metrox-eth/moss/README.md

# MOSS

Cleaner streets, one maker at a time.

> **MOSS kits are coming soon on [TNKR](https://tnkr.ai/).**
> Skip printing and sourcing the parts yourself. **[Join the waitlist →](https://ak4khuvxkya.typeform.com/to/qaKmXNME)** to be notified when kits are available.

**[Build guide](https://www.showrobotics.ai/moss/build/) · [Print parts](https://www.showrobotics.ai/moss/build/#print) · [Bill of materials](BOM.md) · [Download CAD, STL & 3MF](https://github.com/metrox-eth/moss/releases/download/v0.6-r92/MOSS_R92_Mechanical_20261109.zip) · [Software setup](Software.md)**

MOSS is a small litter-picking rover you print and build yourself: a tracked base, a bin on top, an arm derived from the SO-101 with a parallel gripper. It is built in public, with hardware files available for noncommercial builds and improvements.

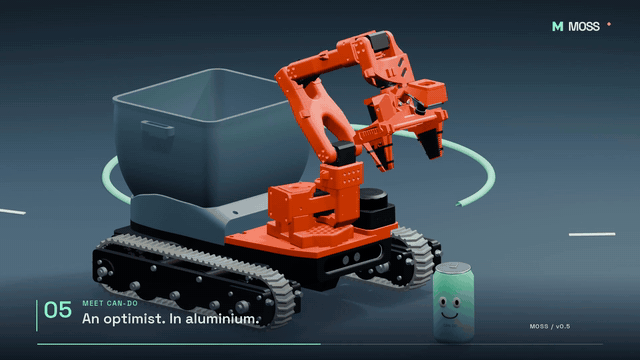
[picture p1: media/images/moss_v05_pickup.gif]
MOSS picking up a can: approach, grasp, lift, drop in the bin


**Where it stands.** The physical rover drives and demonstrates pick-and-drop motions. Autonomous litter picking and the full field test are not yet demonstrated. The V0.6 / R92 CAD, STL files, BOM and assembly guide are now available.

## Build options

**Base assembly: about $460 in parts.** Includes the chassis and tracks, arm and gripper, motors, servos, control electronics, power system, wrist camera, 2D lidar, wiring and filament. **Only the computer and navigation camera are additional.**

**Choose ONE of the three options below, depending on your budget.** They are alternative computer + navigation-camera configurations for the same rover base. You do not need to buy all three.

| Option | Computer + navigation camera | Additional cost (USD) | Estimated rover total, including the $460 base (USD) |
|---|---|---:|---:|
| **Option 1: higher budget** | Jetson Orin Nano Super + RealSense D455 | about $930 | **about $1,390** |
| **Option 2: mid-range budget** | Raspberry Pi 5 + Hailo AI HAT + Orbbec Gemini 2 | about $740 | **about $1,200** |
| **Option 3: lowest budget, experimental** | Orange Pi Zero 3W (6 GB, $60) + MightyCam ($80) | about $140 | **about $600** |

**Option 1 offers the most computing headroom for the autonomy software being developed.** It does not guarantee autonomous operation: autonomous litter collection has not yet been demonstrated on any of these configurations.

The goal is to bring as much of the stack as possible to smaller, lower-cost hardware. This work involves porting, optimizing and testing features progressively, and **it will take time**. Feature support will depend on what can be ported and validated on each hardware option.

**Option 3 is experimental for now.** Early Orange Pi + MightyCam bench tests are documented in the [experiment folder](experiments/orange-pi-mightycam/); the combination is not yet validated as a complete rover configuration. The [BOM](BOM.md) covers the established configurations.

## What it is made of

- Tracked base, two geared DC motors with encoders, printed TPU tracks, an ESP32-S3 driving the motors.
- A bin you empty by hand at the end of a run.
- An SO-101 arm (open source) with a NormaCore parallel-jaw gripper, widened to a 90 mm grip.
- Two cameras: a depth camera at the nose, a colour camera in the hand.
- A 2D lidar for navigation.
- Software: dimOS for teleop, recording, navigation and manipulation.

I pick up litter by hand on my walks. MOSS is the robot I want next to me doing the same. One less can on the ground.

## News

- 1 November 2026: **[MOSS CORE V0.7 updated](hardware/electronics/moss-core-v0.7/)** — black 82 × 79 mm board, vertical cable headers, larger underside connector labels, a 74 × 71 mm chassis mounting pattern and a new routing layout. Orange Pi assembly clearance and the matched KiCad/BOM/Gerber package are documented. The integrated power supply, current sensing and consolidated motor harness remain. First prototype, not built or tested yet.

- 30 October 2026: **[MOSS CORE V0.7 harness study](hardware/electronics/moss-core-v0.7/harness/)** — a short film, offline 3D viewer, cable routing and a hull prototype with integrated cable-tie mounts. An unbuilt packaging proposal, published for review.

- 28 October 2026: **[Build a custom 3S4P battery for MOSS](hardware/power/custom-3s4p-battery/)** — twelve EVE 21700 cells, illustrated assembly, wiring diagram and parts list. 20 Ah from the cell ratings, 910 g assembled; usable energy and collection runtime still to be measured.
- 27 October 2026: **[Orange Pi + MightyCam experiment](experiments/orange-pi-mightycam/)** — dimOS, YOLO on the NPU and a first memory/load test with simulated rover I/O. Code, cockpit image and the limits of this early bench demo.
- 27 October 2026: **[SO-101 dual-servo shoulder R2: complete upgrade guide](hardware/mechanical/dual-shoulder-r2/)** — editable CAD, two printable parts, screws, assembly, paired-servo setup and testing in one place.
- 24 October 2026: **BOM and print plates updated.** Hoco HB1 four-port hub, GameSir Nova 2 Lite controller, all 38 spacers on one plate, and one tensioner-slider reference (print four). [Updated package](https://github.com/metrox-eth/moss/releases/download/v0.6-r92/MOSS_R92_Mechanical_20261024.zip) · [Print plates](https://www.showrobotics.ai/moss/build/print-plates.html).
- 18 October 2026: **Ready-to-print plates are available.** [H2S: one-piece hull and cover](https://github.com/metrox-eth/moss/releases/download/v0.6-r92/MOSS_V06_R92_H2S_Print_Plates.3mf) or [P1 / P2: split hull and cover](https://github.com/metrox-eth/moss/releases/download/v0.6-r92/MOSS_V06_R92_256mm_Split_Print_Plates.3mf). The [updated package](https://github.com/metrox-eth/moss/releases/download/v0.6-r92/MOSS_R92_Mechanical_20261018.zip) includes both Jetson retaining tabs, grouped STLs with quantities, and both 3MF projects. [Choose your plates](https://www.showrobotics.ai/moss/build/print-plates.html).

- 16 October 2026: **V0.6 / R92 is available.** [Build guide](https://www.showrobotics.ai/moss/build/), [CAD & STL package](https://github.com/metrox-eth/moss/releases/tag/v0.6-r92) and [BOM](BOM.md). One-piece and two-piece hull/cover options, modular computer and camera carriers, and short assembly videos.

- 15 October 2026: [MOSS Core V1D routed PCB draft](hardware/electronics/moss-core-v1d/): integrated audio and switched motor/servo power, published for review. Untested and not approved for fabrication. [V1C critical erratum](hardware/electronics/moss-core-v1d/V1C_CRITICAL_ERRATA.txt): do not fabricate V1C.
- 14 October 2026: [CAD development with Codex](docs/cad-with-codex.md): more battery room, integrated audio, a slimmer hull, a P1S split-hull option and deeper track guides. Images and geometry checks; physical validation is next.
- 3 October 2026: V0.6 makes the hardware modular, Pi or Jetson, RealSense or Gemini. Waitlist open with Tnkr.
- 1 October 2026: V0.5, the release candidate for the open source CAD.
- 26 September 2026: arm and gripper mounted on the prototype.
- 22 September 2026: first drive.

## Friends

OpenAI (Codex Physical Builds), [PCBWay](https://www.pcbway.com/) (custom PCB prototyping), [Dimensional](https://x.com/dimensionalos) (dimOS), [NormaCore](https://x.com/norma_core_dev) (gripper), [Tnkr](https://x.com/tnkrdotai) (kits and guide), [Dirac Robotics](https://x.com/diracrobotics) (calibrated simulation), [microduck-lab](https://github.com/jonathanhawkins/microduck-lab) (reinforcement learning). We help each other.

## Supporters

People who put a spool of filament in the rover every month: [Richard Burton](https://github.com/ricburton). It goes into parts the same week. You can join them on [GitHub Sponsors](https://github.com/sponsors/metrox-eth).

## Simulation and autonomy, work in progress

The current **[MOSS V0.6 / R92 MuJoCo model](simulation/mujoco/)** lives in this repository, with its XML, meshes, viewer and tests. It includes the released assembly geometry, an articulated arm and coupled gripper, and an idealized base that can drive and turn. It runs locally without Jev or an API key. Start with the **[simulation guide](simulation/mujoco/README.md)** or **[model files](simulation/mujoco/model/)**.

This is a preliminary development model: traction, servo dynamics, camera geometry and sim-to-real accuracy remain uncalibrated. Dirac Robotics is helping build the calibrated simulation; Dimensional is working on a navigation arena, and microduck-lab is trying reinforcement learning. The earlier recorded Jev demonstration remains in [moss-jev](https://github.com/metrox-eth/moss-jev) as historical work.

## Come and build

Ask anything, tell us what we are doing wrong, it helps the next builder: [Discord](https://discord.com/invite/x2MeNmgveT). The build, as it happens: [@metrox_eth](https://x.com/metrox_eth). The story so far, in a few moments: [STORY.md](STORY.md). How data from many rovers gets pooled: [docs/data.md](docs/data.md).

## Safety

This is a prototype with a lithium battery and no certified protection. Put it on blocks for the first run. Build at your own risk.

## License

Code remains under Apache-2.0. From **1 November 2026**, the current distribution of MOSS-authored hardware designs is offered under **[CC BY-NC-SA 4.0](LICENSE-HARDWARE)**: attribution, noncommercial use and ShareAlike. Documentation and media remain under CC BY 4.0.

Earlier CERN-OHL-S-2.0 distributions retain the rights already granted with those copies. Third-party material keeps its own licence, including the KiCad library licence and exception. See [NOTICE](NOTICE) for scope and attribution.
