metrox-eth/moss/hardware/electronics/moss-core-v1c/README.md

# MOSS Core V1C

**DO NOT FABRICATE V1C.** U10/U11 have an incorrect SN74LVC2G08 second-gate physical-pin assignment. Earlier ERC/DRC passes did not detect it. Read the [critical erratum](../moss-core-v1d/V1C_CRITICAL_ERRATA.txt). The [V1D routed draft](../moss-core-v1d/) corrects this mapping but still requires design and hardware validation.

The files below are retained unchanged as a historical review snapshot, not an approved prototype candidate. Developed and reviewed with Codex; documentation is in English.

[Historical V1C archive — DO NOT FABRICATE](MOSS_Core_V1C_Audited_20261015.zip) · [SHA-256](MOSS_Core_V1C_Audited_20261015.zip.sha256) · [Schematic PDF](MOSS_Core_V1C_Schematic.pdf) · [Design audit](AUDIT_V1B_V1C.html)

MOSS Core V1C PCB

## One control board for MOSS

Core is designed to replace the QT Py, its BFF, the separate INA measurement board and the servo signal adapter. The ESP32-S3 module is soldered directly onto Core; no QT Py or BFF plugs into it.

The Cytron MDD10A, audio amplifier, computer power converter and high-current wiring remain external. Motor and servo power do not pass through this PCB.

Four copper layers, **60 × 65 × 1.6 mm**, four Ø2.7 mm corner holes for M2.5 screws, 52 × 57 mm mounting pitch.

## Inside the ZIP

- Editable KiCad 10.0.6 project, eight schematic sheets and routed PCB.
- Local symbol/footprint libraries and 3D models.
- Gerbers, PTH/NPTH drills, BOM and placement/assembly files.
- Connector pinout, STEP model, design audit and verification reports/scripts.
- Firmware pin contract and porting notes; these are **not executable firmware**.
- Proposed mounting interface; the included lower carrier is for bench use only.

Extract the full ZIP before opening the KiCad project. Its SHA256SUMS.txt covers the delivered files. No complete rover CAD is included.

## Verification and remaining work

Static checks: **0 ERC/DRC violations, 0 unconnected items, 0 schematic/PCB parity issues** under the recorded rules. The review compared 486 physical pin assignments and tested 16,384 stable-state logic combinations. These checks do not establish physical performance.

No board has been fabricated or tested. Manufacturer stackup/USB impedance review, firmware porting, host USB/audio integration, printed attachments and physical bring-up remain outstanding. The [historical fabrication notes](BEFORE_FABRICATION.txt) are superseded by the critical erratum; do not order this revision. Download the HTML audit to view its formatted pages.

This historical snapshot and its ZIP are unchanged and retain their original [CERN-OHL-S-2.0 hardware terms](https://github.com/metrox-eth/moss/blob/4c626e547e17265f93b0fac8ec0e2681b920758f/LICENSE-HARDWARE). The repository's later hardware licence change does not rewrite this archived delivery. Bundled KiCad library material retains its upstream license and exception, included in the ZIP. See the [historical NOTICE](https://github.com/metrox-eth/moss/blob/4c626e547e17265f93b0fac8ec0e2681b920758f/NOTICE) for code, documentation and media licensing.
