metrox-eth/moss/simulation/dual_shoulder/out/report.html

# Does the MOSS shoulder want a second servo?

MuJoCo studies on the MOSS V0.6 / R92 model for issue #2 (https://github.com/metrox-eth/moss/issues/2): holding load, the real pick-and-drop cycle, two STS3215 on one shaft, a spring instead, and tipping.

2026-10-26 · model simulation/mujoco/model/moss_robot.xml (R92, MuJoCo 3.3.7) · arm calibrated to the weighed 768 g · servo STS3215 / ST3215 12 V: stall 2.94 N·m (2.65 at the 3S pack's 10.8 V), continuous 0.98 N·m · code in simulation/dual_shoulder/

Short answer, for the litter MOSS is built for (its 20 g reference can): the shoulder is strong enough, and the cycle as written stays cool. Its one weak moment is holding the arm still at the pick, and that load is the arm's own weight, not the litter. The cheapest fix is where the arm picks. After that, a spring. A second servo helps only if the two share the load. Sent the same goal, as RoArm's firmware does it, they share if the servo holds its goal softly and fight if it holds it stiffly, and one reading on the arm tells which.

1. The litter barely counts. MOSS's own test object (scene.xml: 66 × 115 mm, 20 g) adds 0.04 N·m at the pick. Over a whole cycle the shoulder peaks at 50% of stall and averages 0.15× its continuous rating. The elbow stays under its rating the whole time.
2. The weak moment is waiting at the pick. MOSS picks every object at one pose (pick_low), where the shoulder holds 0.92 N·m, 0.89× its continuous rating, with the can or without it. Today the cycle stays above the rating there for about 3 s. A wrist-camera check before the grasp (not built yet, per docs/litter.md) or a re-grasp would add time there. Issue #2's test, a can held at full reach for a minute, is 2.1× the rating. It can pass without drift while the servo heats, so log the temperature.
3. The cheapest fix is where the arm picks. The arm sits on top of the rover behind its nose, so today's pick is a stretched reach 0.18 m past the tracks' front end. Picking 6 cm closer (x 0.29 m instead of 0.346 m) brings the shoulder from 0.89× to 0.46×. That is a change to the pick pose and MOSS_PICK_XY_M, not to the hardware. At a given point, the pose matters too: at x 0.31 m the reach table's poses run the shoulder anywhere from 0.46× to over 1.2×. Its tie-break picks the pose nearest pick_low, not the lightest.
4. Whether the same goal works depends on how stiffly the servo holds its goal. The model's servo (Menagerie's, full torque about 2 ticks off the goal) gives a poor split: behind a printed bracket the second servo takes only 14% of the load when perfectly calibrated, and at a 4-tick encoder offset the two push against each other, the hotter one at 2.9× its rating against 0.89× for one servo. The bench note in issue #2 says the real loop is much softer near its goal: under load, a goal a few ticks away does not move the arm. With a servo soft enough that one alone sags 0.5° at the pick, same goal with RoArm's zero at boot beats one servo at any offset up to ±4 ticks (hotter servo 0.74× at worst), and the softer the servo, the lower that worst case (0.53× at a 1.0° sag). One reading on today's arm decides it: one servo at pick_low, Present_Position minus the goal. About 6 ticks or more, and same goal will share; 1–2 ticks, and it fights.
5. If the loop is stiff, a follower shares evenly. Servo A holds position. Servo B runs open-loop PWM (STS mode 2) and copies A's Present_Load over the bus. That gives an even 50/50 split at any encoder offset, so at the pick each servo runs at 0.22×. B must follow slowly, with a time constant of about 0.1 s (at 50 Hz, 20–30% of the gap per update), or it rings against A's loop.
6. For a load that is all arm weight, a spring is the better fit. A gravity-balance spring of 0.66 N·m peak takes the pick pose to 0.08× (two servos sharing evenly: 0.22× each), with nothing to sync. Two servos only pull ahead with heavier litter. MOSS's detector also picks glass: with a 250 g bottle at the pick, one servo is at 2.0×, the spring 0.57×, and an even pair 0.50× each. Tipping is no risk at these weights; it takes 1.1 kg held stretched out to the side.

## 1 · Where the load is

Holding torque from the model at every pose MOSS uses: its cycle poses, its drive pose, all 645 floor picks of its reach table (gripper within 10° of vertical), and the worst stretched-out pose. Heat goes with torque squared, so heat / rating = (torque / 0.98 N·m)². Above 1, the servo heats past what it can shed and eventually trips its cut-out.

Shoulder heat at every floor pick MOSS can makeMedian over the 645 poses of MOSS's reach table, empty gripper, by distance of the pick from the arm's base. 1 = the servo's continuous rating.

One servo (today)Two servos, sharedOne servo + spring

pose | shoulder N·m | elbow N·m | max object at rating · one servo | · two shoulder servos
drive | 0.13 | 0.44 | 627 g · elbow | 627 g · elbow
travel | 0.26 | 0.58 | 215 g · elbow | 215 g · elbow
pick | 0.87 | 0.45 | 55 g · shoulder | 460 g · elbow
lift | 0.39 | 0.62 | 158 g · elbow | 158 g · elbow
clear | 0.24 | 0.24 | 443 g · wrist | 443 g · wrist
drop | 0.23 | 0.53 | 200 g · elbow | 200 g · elbow
pick_low | 0.88 | 0.39 | 48 g · shoulder | 541 g · shoulder
stretched (worst case) | 1.35 | 0.78 | 0 g · shoulder | 67 g · elbow

Read the last two columns as: the heaviest object that pose can hold forever, and the joint that limits it. With one servo the shoulder limits every floor pick. With two, the elbow takes over in 284 of the 645 floor picks, and in 40 of the 48 far ones. In the lift, travel and drop poses the elbow limits anyway.

Holding torque per servo at MOSS's pick posepick_low: the one pose MOSS picks every object at (the rover brings the object to it). Static, R92 model, arm weighed at 768 g. Stall: the 12 V figure at the 3S pack's 10.8 V.

Shoulder, one servoShoulder, two servos (each)Shoulder, one + springElbow (one servo)

At MOSS's pick pose, one shoulder servo passes its continuous rating at 50 g, two at 550 g, and one plus the spring at 370 g. The elbow passes its rating at 600 g. MOSS's can is 20 g. Picks farther out (the rest of the reach table) are where the arm would reach once it stops relying on the rover to bring the object to it.

## 2 · The cycle MOSS actually runs

The sequence from config/arm_drop_poses.json, played the way moss_dimos.arm.load_cycle plays it, under full dynamics with the servos' torque limit. The object is attached from the grip to the release. "Hover" adds 20 s at the pick with the object in hand. Mean heat is over one whole cycle (about 40 s); s over is the time above the continuous rating.

One pick-and-drop cycle as MOSS runs it: floor pick, its 20 g canMuJoCo, MOSS's own sequence and timing (quintic moves, 400 ticks/s ceiling). Torque per servo, absolute.

Shoulder, one servoShoulder, two servos (each)Elbow

pick | object | hover | servos | peak/stall | heat | s over | sag | elbow heat | elbow s over
pick_low | nothing | 0 s | one | 0.48 | 0.15 | 2.5 s | 0.1° | 0.26 | 0.0 s
pick_low | nothing | 0 s | two | 0.32 | 0.05 | 0.0 s | 0.1° | 0.26 | 0.0 s
pick_low | MOSS can 20 g | 0 s | one | 0.50 | 0.15 | 2.9 s | 0.1° | 0.27 | 0.0 s
pick_low | MOSS can 20 g | 0 s | two | 0.33 | 0.05 | 0.0 s | 0.1° | 0.27 | 0.0 s
pick_low | MOSS can 20 g | 20 s | one | 0.50 | 0.35 | 2.9 s | 0.1° | 0.25 | 0.0 s
pick_low | MOSS can 20 g | 20 s | two | 0.33 | 0.10 | 0.0 s | 0.1° | 0.25 | 0.0 s
pick_low | glass bottle 250 g | 0 s | one | 0.71 | 0.32 | 5.6 s | 0.1° | 0.53 | 9.1 s
pick_low | glass bottle 250 g | 0 s | two | 0.43 | 0.10 | 1.8 s | 0.1° | 0.53 | 9.0 s
pick_low | glass bottle 250 g | 20 s | one | 0.71 | 0.75 | 25.6 s | 0.1° | 0.50 | 9.1 s
pick_low | glass bottle 250 g | 20 s | two | 0.43 | 0.20 | 1.8 s | 0.1° | 0.50 | 9.0 s
pick_low | full can 350 g (stress) | 0 s | one | 0.80 | 0.43 | 6.0 s | 0.1° | 0.70 | 13.1 s
pick_low | full can 350 g (stress) | 0 s | two | 0.48 | 0.13 | 2.5 s | 0.1° | 0.70 | 13.1 s
pick_low | full PET 530 g (stress) | 0 s | one | 0.97 | 0.68 | 10.2 s | 0.2° | 1.09 | 16.3 s
pick_low | full PET 530 g (stress) | 0 s | two | 0.56 | 0.20 | 3.6 s | 0.1° | 1.09 | 16.3 s
pick_far | nothing | 0 s | one | 0.55 | 0.24 | 6.5 s | 0.1° | 0.28 | 0.0 s
pick_far | nothing | 0 s | two | 0.34 | 0.08 | 0.0 s | 0.1° | 0.28 | 0.0 s
pick_far | MOSS can 20 g | 0 s | one | 0.57 | 0.26 | 6.6 s | 0.1° | 0.30 | 0.0 s
pick_far | MOSS can 20 g | 0 s | two | 0.35 | 0.08 | 0.0 s | 0.1° | 0.30 | 0.0 s
pick_far | MOSS can 20 g | 20 s | one | 0.57 | 0.54 | 26.6 s | 0.1° | 0.31 | 0.0 s
pick_far | MOSS can 20 g | 20 s | two | 0.35 | 0.15 | 0.0 s | 0.1° | 0.31 | 0.0 s
pick_far | glass bottle 250 g | 0 s | one | 0.83 | 0.51 | 9.9 s | 0.1° | 0.57 | 9.6 s
pick_far | glass bottle 250 g | 0 s | two | 0.48 | 0.15 | 3.9 s | 0.1° | 0.57 | 9.6 s
pick_far | glass bottle 250 g | 20 s | one | 0.83 | 1.20 | 29.9 s | 0.1° | 0.64 | 9.6 s
pick_far | glass bottle 250 g | 20 s | two | 0.48 | 0.32 | 3.9 s | 0.1° | 0.64 | 9.6 s
pick_far | full can 350 g (stress) | 0 s | one | 0.94 | 0.68 | 10.3 s | 0.2° | 0.75 | 17.0 s
pick_far | full can 350 g (stress) | 0 s | two | 0.54 | 0.20 | 4.9 s | 0.1° | 0.75 | 17.0 s
pick_far | full PET 530 g (stress) | 0 s | one | 1.00 | 1.00 | 14.5 s | 21.6° | 1.12 | 19.5 s
pick_far | full PET 530 g (stress) | 0 s | two | 0.64 | 0.30 | 5.6 s | 0.1° | 1.17 | 19.6 s

Shoulder columns first (peak torque over stall, mean heat over the cycle, time over the rating, worst sag), then the elbow.

## 3 · The cheapest fix: where the arm picks

The mission drives the rover until the object sits at one pick point; the arm never reaches for it. That point decides how far out the arm stretches. Below: every floor pose of the reach table straight ahead, posed in the R92 model with the can.

Shoulder heat against where the arm picks, straight aheadEvery floor pose of MOSS's reach table within 5 cm of the pick line, posed in the R92 model with the 20 g can. x in the model frame: the tracks end at 0.17 m.

Shoulder, best pose at that pointShoulder, median poseElbow (best pose)

tool x, m | past the tracks, m | poses | shoulder, best pose | shoulder, median | elbow, best pose
0.23 | 0.06 | 17 | 0.23 | 0.23 | 0.02
0.29 | 0.12 | 8 | 0.46 | 0.46 | 0.12
0.31 | 0.14 | 48 | 0.46 | 1.19 | 0.12
0.33 | 0.16 | 32 | 0.62 | 0.75 | 0.11
0.35 | 0.18 | 32 | 0.89 | 0.99 | 0.16
0.39 | 0.22 | 8 | 1.28 | 1.28 | 0.32
0.41 | 0.24 | 8 | 1.38 | 1.38 | 0.33

What the model cannot say: whether the nose camera still sees the object that close, and whether the last, open-loop part of the approach lands it there. Both are checks on the robot.

## 4 · Two servos on one shaft: share or fight?

Servo B sits on the far side of the upper arm, mirrored, and reaches the joint through its horn and the printed bracket (a torsion spring, optionally with play). Each STS3215 closes its own position loop on its own output encoder. Gearbox backlash sits inside that loop and hardly matters. What matters is how far the two encoders disagree about the same shaft angle, plus the bracket's flex. Zeroing B against A at one angle (what RoArm-M2's and M3's firmware does at every boot) removes the disagreement at that angle only. How much a leftover offset matters depends on how stiffly each servo holds its goal, which the model takes from Menagerie and the last part of this section sweeps.

Two servos given the same goal: the hotter servo's heatArm at MOSS's pick pose holding its 20 g can. x = how far servo B's encoder disagrees with A's, in ticks (1 tick = 0.088°). The model's servo stiffness (998 N·m/rad, firmware P = 32).

Same goal, flexible bracket (50 N·m/rad)Same goal, printed bracket (200)Same goal, stiff, metal (1000)

strategy | offset, ticks | τ A, N·m | τ B, N·m | fight, N·m | hotter servo heat | copper loss, W
one servo (today) | | -0.92 | | | 0.89 | 3.19
same goal | -8 | 0.96 | -1.88 | 0.96 | 3.69 | 16.75
same goal | -4 | 0.08 | -1.01 | 0.08 | 1.06 | 3.83
same goal | -2 | -0.35 | -0.57 | 0.00 | 0.34 | 1.69
same goal | +0 | -0.79 | -0.13 | 0.00 | 0.65 | 2.41
same goal | +2 | -1.23 | 0.31 | 0.31 | 1.57 | 6.01
same goal | +4 | -1.67 | 0.74 | 0.74 | 2.89 | 12.48
same goal | +8 | -2.54 | 1.62 | 1.62 | 6.73 | 34.03
follower | any | -0.46 | -0.46 | 0.00 | 0.22 | 1.60

Printed bracket (200 N·m/rad), no play, the model's stiffness (P = 32), at MOSS's pick pose with its 20 g can. Negative τ holds the arm up. A fight is where the two push in opposite directions: both get hot and the arm gains nothing.

Across every same-goal variant tried at the model's stiffness (offset −8…+8 ticks, bracket 50 / 200 / 1000 N·m/rad, play 0 / 0.3°, firmware P 32 / 16):

case | one servo heat | same goal, median | same goal worse than one servo | follower, worst
pick_low + MOSS can | 0.89 | 1.04 | 47 of 84 | 0.22
far pick + glass bottle | 3.25 | 3.24 | 37 of 84 | 0.81
clear (light load) | 0.06 | 0.29 | 65 of 84 | 0.01

### How stiffly the servo holds its goal

The model's 998 N·m/rad is Menagerie's value, not a measurement. The bench note in issue #2 (under load, a goal a few ticks away does not move the arm) rules it out: at that stiffness a few ticks are worth more than the servo's full torque. So the same goal again, with servos that hold their goal less stiffly. The softer the servo, the more one alone sags under the arm, which is what makes it measurable.

Same goal again, with a softer servoPrinted bracket (200 N·m/rad), MOSS's pick pose and its 20 g can. Each line is a servo that holds its goal less stiffly than the model's 998 N·m/rad; the softer it is, the more one servo alone sags under the arm.

Kp 50 N·m/rad: one servo sags 1.05° at the pickKp 100 N·m/rad: one servo sags 0.53° at the pickKp 250 N·m/rad: one servo sags 0.21° at the pick

servo stiffness, N·m/rad | one servo sags at the pick | same goal, offset 0 | offset up to ±4 ticks | up to ±8 ticks
25 | 2.04° · 23.2 ticks | 0.30 | 0.37 | 0.45
50 | 1.05° · 11.9 ticks | 0.39 | 0.53 | 0.69
100 | 0.53° · 6.0 ticks | 0.50 | 0.74 | 1.18
250 | 0.21° · 2.4 ticks | 0.65 | 1.48 | 3.66
499 (model, P 16) | 0.11° · 1.2 ticks | 0.74 | 3.29 | 7.29
998 (model, P 32) | 0.05° · 0.6 ticks | 0.81 | 7.29 | 7.29

Heat of the hotter servo, worst over the three brackets (50 / 200 / 1000 N·m/rad), no play, MOSS's pick pose with its can. One servo: 0.89×. A soft loop forgives a stiff bracket; a stiff loop does not. The loop here is linear: a deadband or gear stiction, which the bench note may also point at, would make a small offset leave one servo idle rather than fight.

### The follower's one setting

B's PWM duty moves towards A's measured duty by a fraction α per bus update, one update late. Too eager and it rings against A's own loop:

bus rate | α | B's share | ripple, N·m
100 Hz | 0.1 | 0.50 | 0.000 | steady
100 Hz | 0.2 | 0.50 | 0.000 | steady
100 Hz | 0.3 | 0.50 | 1.805 | oscillates
100 Hz | 0.4 | 0.54 | 1.950 | oscillates
100 Hz | 0.5 | 0.59 | 2.144 | oscillates
100 Hz | 0.8 | 0.51 | 2.387 | oscillates
50 Hz | 0.1 | 0.50 | 0.000 | steady
50 Hz | 0.2 | 0.50 | 0.000 | steady
50 Hz | 0.3 | 0.50 | 0.000 | steady
50 Hz | 0.4 | 0.50 | 0.020 | steady
50 Hz | 0.5 | 0.62 | 1.942 | oscillates
50 Hz | 0.8 | 0.50 | 2.306 | oscillates
20 Hz | 0.1 | 0.50 | 0.002 | steady
20 Hz | 0.2 | 0.50 | 0.001 | steady
20 Hz | 0.3 | 0.50 | 0.001 | steady
20 Hz | 0.4 | 0.50 | 0.001 | steady
20 Hz | 0.5 | 0.50 | 0.001 | steady
20 Hz | 0.8 | 0.59 | 2.212 | oscillates

The lift itself (pick_low → lift with MOSS's can, 2.6 s):

strategy | offset | worst tracking error | end τ A | end τ B
one servo | | 0.23° | -0.44 | 0.00
same goal | 0 | 0.23° | -0.44 | 0.00
same goal | 4 | 0.25° | -0.88 | 0.44
follower | 0 | 0.20° | -0.22 | -0.22

## 5 · Weak spots

- The sync is the design. The same goal the way RoArm does it (zero at boot, P 16, mirrored goals in one packet with the same speed and acceleration, the same torque limit) shares if the loop is soft and fights if it is stiff. Before any payload test, run both servos at a rest pose with nothing in the gripper and read Present_Load on both. If the signs are opposite, they are fighting.
- Stiff loop + stiff bracket = heat. The fight grows with the stiffness of both the servo's loop and the bracket. With a stiff loop, a printed prototype that couples B rigidly will fight at some poses, and both servos' Present_Load will show it, with opposite signs.
- The elbow, with heavier litter. With MOSS's can the elbow never passes its rating. With a 250 g glass bottle it is over for 9 s of each cycle (mean 0.53×, so still sustainable). Only with full containers, which are beyond what MOSS is built to pick, does it reach 13–20 s per cycle. A stronger shoulder does nothing for it.
- The pack voltage. The servos run straight off the 3S pack: 12.6 V full, about 10.5 V under load at the end. Stall torque scales with voltage, so the 30 kg·cm figure is closer to 25 kg·cm in use and about 23 at a low pack. The continuous rating (heat) does not change.
- The follower's failure mode. In PWM mode, B keeps its last duty if the bus or the host stops. Cap B's torque limit (register 48), zero it when A's reading goes stale, and clamp it whenever A is at an end stop. Pinch force near the floor also doubles.
- Current. Two shoulder servos at stall draw about 5.4 A on top of the others: check the Bus Servo Adapter's rating and the 15 A fuse.
- Tipping is fine. On flat ground the least payload that tips the rover is 1.09 kg, held stretched out to the side (pan 80°). With a full 0.5 l bottle there, a side slope of 23° would tip it.
- A model note for the R92 sim: the shipped XML's shoulder range (±100°) stops short of MOSS's drive pose (−104.4°, ticks 860, the calibrated end stop). moss_dimos widens the ranges when it writes its own sim scene; the plain XML does not.

## 6 · What to measure on the bench

1. How stiffly one servo holds (2 min, today's arm, one servo): at pick_low, read the shoulder's Present_Position minus its goal, arriving from above as the cycle does; then step the goal by 2, 4 and 8 ticks and note when the arm moves. About 6 ticks of sag or more: same goal will share. 1–2 ticks: expect a fight, and use the follower.
2. Encoder offset across the travel (5 min, no power to the motors): couple both servos to the joint, torque off on both, swing the arm by hand end to end, and log both servos' Present_Position. Offset = A − mirror(B). With a soft loop a few ticks are harmless; with a stiff one this number decides how hard same goal fights.
3. Idle fight: torque on, the arm resting in the drive pose. Log Present_Load and Present_Current on both for 30 s.
4. Issue #2's own test with MOSS's can, held for 60 s at the pick pose (pick_low) as well as at full reach. Log Present_Temperature and load on both servos, and compare one servo, two with the same goal, two with the follower, and one with a spring. Report the temperature rise per minute, not just "it held".
5. The pick point: move MOSS_PICK_XY_M and the pick pose a few cm closer, then check that the nose camera still sees the object and the approach lands it there. Log the shoulder's Present_Load at both points.
6. Payload lift last. It only measures stall, which this arm never comes near with litter.

## Assumptions and limits

- Arm masses: MuJoCo Menagerie SO101 plus the R92 gripper, scaled to the weighed 768 g (15 g added at the hand). Rover body 4.0 kg (the model's estimate).
- Litter: MOSS's own can from scene.xml (20 g), an empty 0.33 l glass bottle (250 g, the detector's "glass" class), and full containers marked "stress", which MOSS isn't designed to pick. The object sits at the model's tcp. MOSS holds a standing can a few cm farther along the gripper. At the pick the gripper points down, so this barely moves the lever arm: for 20 g it is under 0.01 N·m at any pose.
- Servo: Feetech figures (stall 30 kg·cm, continuous 10 kg·cm, 2.7 A stall at 12 V); position stiffness 998 N·m/rad from the model (firmware P = 32), 499 for P = 16, and a sweep from 25 to 998 because the real loop is softer near its goal (issue #2). The loop is linear, with no deadband or stiction. The holding torques and heat do not depend on it; only the split between two servos does. The thermal threshold is the continuous rating, not a measured temperature curve. No thermal time constant is claimed.
- Two servos: B's path to the joint is a torsion spring of 50–1000 N·m/rad with 0–0.3° play. Real brackets need measuring. Encoder errors that vary with angle enter as the offset sweep. The follower is modelled with PWM duty proportional to torque at low speed, one bus sample of delay, and no read noise.
- Contacts are off in the dynamic studies: they measure what the servos must give, not grasp success. The base is pinned; tipping is static.
- Spring: an ideal zero-free-length balancer (torque A·sin(θ − φ)), fitted for the lowest worst-case shoulder load over MOSS's poses. A real spring and its cable or linkage would get somewhat less.
