metrox-eth/moss/hardware/electronics/moss-core-v0.7/evidence/baseline_integrated_power/README.md

# Historical integrated-power baseline

These reports describe the 31 October integrated-converter design before the 1 November outline, routing and vertical-header refresh. They preserve the earlier converter and DFM rationale; they are not the current board acceptance reports. Use the hash-bound reports one level above for the current native design.
