metrox-eth/moss/hardware/electronics/moss-core-v0.7/harness/ATTRIBUTION.md

# Attribution

From **1 November 2026**, the current distribution of MOSS-authored hardware additions, including hull and harness designs, is offered under **CC BY-NC-SA 4.0**. MOSS source code remains under Apache-2.0; documentation and project media remain under CC BY 4.0. Refer to the [Core license/provenance section](../README.md#license-and-provenance) and [hardware licence](../LICENSE-HARDWARE).

Earlier copies and releases supplied under CERN-OHL-S-2.0 retain the rights already granted with those distributions. This change is prospective. Third-party material and the notices below retain their own licences.

- KiCad-sourced models retain the [KiCad library license and exception](../KiCad_Libraries_LICENSE.md). The motor header uses the installed KiCad `JST_XH_S6B-XH-A_1x06_P2.50mm_Horizontal.step` reference.
- Three.js is MIT licensed. Its notice is included in `viewer/THREE_LICENSE.txt` and in the offline viewer ZIP.
- Space Grotesk is distributed under the SIL Open Font License. See `assets/branding/OFL.txt`.
- HOCO, JST, Molex, AMASS, PCBWay and partner marks remain the property of their owners. This is a MOSS design study, not manufacturer endorsement or manufacturer mating CAD.
- The HB1 geometry is reconstructed from public dimensions/photographs, linked in [MODEL_PROVENANCE.md](MODEL_PROVENANCE.md). The photos and gated supplier CAD files are not redistributed here.
- The film reuses the existing MOSS soundtrack. Its separate source recording is not bundled or relicensed as code.

- Micro-Fit cable housings are MOSS dimensional reconstructions based on [Molex430250000-SD](https://www.molex.com/content/dam/molex/molex-dot-com/products/automated/en-us/salesdrawingpdf/430/43025/430251600_sd.pdf). Exact manufacturer cable-housing STEP was not obtained; cavity/key/latch visuals are not certified mating CAD. Current fixed Core headers remain native KiCad models.
