metrox-eth/moss/hardware/electronics/moss-core-v0.7/review/DRILL_REPORT.txt

Drill report for MOSS_Core_V07_DRAFT.kicad_pcb
Created on 2026-10-30T18:17:41

Copper Layer Stackup:
    =============================================================
    L1 :  F.Cu                      front
    L2 :  In1.Cu                    in1
    L3 :  In2.Cu                    in2
    L4 :  B.Cu                      back

Drill file 'MOSS_Core_V07_DRAFT-PTH.drl' contains
    plated through holes:
    =============================================================
    T1  0.200mm  0.0079"  (18 holes))
    T2  0.300mm  0.0118"  (465 holes))
    T3  0.400mm  0.0157"  (32 holes))
    T4  0.450mm  0.0177"  (4 holes))
    T5  0.600mm  0.0236"  (8 holes)  (with 8 slots)
    T6  0.750mm  0.0295"  (2 holes))
    T7  0.850mm  0.0335"  (3 holes))
    T8  1.000mm  0.0394"  (6 holes))
    T9  1.300mm  0.0512"  (6 holes))
    T10  1.900mm  0.0748"  (2 holes))

    Total plated holes count 546

Drill file 'MOSS_Core_V07_DRAFT-NPTH.drl' contains
    unplated through holes:
    =============================================================
    T1  0.650mm  0.0256"  (4 holes))
    T2  2.700mm  0.1063"  (8 holes))

    Total unplated holes count 12
