metrox-eth/moss/hardware/electronics/moss-core-v0.7/evidence/silkscreen_review/FINAL_REVIEW.md

# Independent final silkscreen review

**PASS, with one explicitly documented unprinted component reference: U15.**

Frozen PCB: `4f456f0563e9dc5a3b7cbab98eaa8d9f24485d14dc79a7656af5ab04b983b6b1`.
Baseline PCB: `456219f7eb97119b7e4328ed76f150012619131788f42d3a9d21fc4e40859cdb`.

## Protected design

The canonical native comparison passes: all 230 footprint identities, references, values, component/pad/model poses, copper, vias, nets, saved zone fills and board outline are unchanged. No component was renumbered. Every pre-existing non-text graphic is unchanged. The only drawing exceptions are the eight exact new Silk segments in the four declared callouts, each matched by UUID, face, endpoints and 0.15 mm stroke.

Of 134 source/library/model and assembly files checked, 133 remain byte-identical. The only exception is the declared top-level notes change in `BOM_PCBWAY_ASSEMBLY.json`; every non-notes datum, MPN, designator group, quantity and count is exact. The supplier BOM CSV, placement CSV, schematics, circuit contract and project rules remain byte-identical.

## Ink and legibility

The native printed-reference fields all use 0.8 mm height and 0.15 mm strokes. A separate geometry check converted the actual native text strokes and mask openings to polygons, including common mask openings and non-tented vias. It checked 228 native reference fields, four adjusted captions and eight new leader segments. The minimum observed clearance was **0.154578 mm**, at R49, above PCBWay's 0.15 mm threshold even without using the reported numerical tolerance. No new violation was found.

Front and back final previews were inspected. J3/J4 are visible on the left strip, R180 is clear of the connector/shunt body, and U4/L1 are separated. The compact C45/C43/C44 row remains readable. No additional obvious obstruction or incorrect label association was found. The supplied Micro-Fit STEP reservation reports zero intersection and 0.20 mm minimum clearance for J3/J4; no new STEP solver was run in this independent review.

Coverage is **214 newly printed assembled-component references plus the existing J1 rear legend: 215 of 216 assembled parts**. The only missing printed assembled-component reference is **U15, SN74LVC1G126DCKR, the SOT-353/SC-70-5 servo RX buffer**. There was no readable exposed slot at the required size while preserving body/mask spacing. Its reference remains in the unchanged native/Fab, BOM and placement data, and `preview/U15_LOCATOR.svg` provides the assembly locator. This must not be described as 216 newly printed references.

## Evidence and limits

`SILK_ONLY_EQUIVALENCE.json` records the protected sections, exact source comparisons, permitted BOM notes and eight whitelisted new segments. `INK_OPENING_CLEARANCE.json` records the stroke/opening measurements and coverage. `FINAL_REVIEW.json` binds these files, author reports, scripts, previews and the baseline evidence hashes.

The final layout manifest also contains the subsequently added U15 locator metadata. `LEADER_MANIFEST_REBIND.json` explicitly revalidates every field consumed by the comparator—both PCB hashes and each leader's UUID/reference/face/stroke/endpoints—against the original measured native objects. The unchanged PCB and all eight leaders pass. The original comparator result is retained as `SILK_ONLY_EQUIVALENCE_ORIGINAL.json`; no full comparison, clearance calculation or simulation was repeated merely for that external metadata update. The current comparator and clearance reports both bind layout manifest `89468bce…`.

The frozen native DRC has zero errors, zero missing connections and zero schematic-parity issues. Its two warnings are the same inherited free copper tip and tiny C21 ink clip. This review did not run a router, electrical simulation, firmware build, mechanical solver, flash operation or physical-board test. Previous power/ground, logic, firmware and mechanical evidence applies through the explicitly proven unchanged protected design; its original input hashes should remain visible. Final exported-ink/CAM equivalence is a separate package check recorded in `../FABRICATION_INK_ONLY.json`.

References: [PCBWay text dimensions](https://www.pcbway.com/helpcenter/design_instruction/How_to_make_my_silkscreen_clear_and_beautiful_on_PCB__.html), [PCBWay opening clearance](https://www.pcbway.com/helpcenter/Engineering_Questions/Spacing_between_silkscreen_and_openings.html).
