metrox-eth/moss/hardware/electronics/moss-core-v0.7/harness/rfq/SOURCES.md

# Manufacturer and supplier sources

- [S1: Molex 43025-0600, six-way cable housing](https://www.molex.com/en-us/products/part-detail/430250600)
- [S2: Molex 43025-1000, ten-way cable housing](https://www.molex.com/en-us/products/part-detail/430251000)
- [S3: Molex 43030-0038, 18 AWG female contact](https://www.molex.com/en-us/products/part-detail/430300038)
- [S4: Molex 43030-0001, 20-24 AWG female contact, reel](https://www.molex.com/en-us/products/part-detail/430300001)
- [S5: Molex 43030-0007, loose-piece packaging alternative](https://www.molex.com/en-us/products/part-detail/430300007)
- [S6: Molex 63828-0200 hand-tool scope and crimp data](https://www.molex.com/content/dam/molex/molex-dot-com/products/automated/en-us/applicationtoolingspecificationpdf/638/63828/ATS-638280200-001.pdf)
- [S7: Molex 63819-0000 hand-tool scope and crimp data](https://www.molex.com/content/dam/molex/molex-dot-com/products/automated/en-us/applicationtoolingspecificationpdf/638/63819/ATS-638190000-001.pdf)
- [S8: Molex pre-crimped leads overview](https://www.molex.com/content/dam/molex/molex-dot-com/en_us/pdf/datasheets/987651-2631.pdf)
- [S9: Arduitronics RU00129 motor kit and supplied cable](https://www.arduitronics.com/product/6047/)
- [S10: Cytron MDD10A official product/manual](https://www.cytron.io/p-10amp-5v-30v-dc-motor-driver-2-channels)
- [S11: Yijia LA16 catalogue: two independent changeover contacts](https://yijiabutton.com/wp-content/uploads/2023/10/28.-YJ-LA16-Specification.pdf)
- [S12: Molex PicoBlade 51047/51021 mating drawing](https://www.molex.com/content/dam/molex/molex-dot-com/products/automated/en-us/salesdrawingpdf/510/51047/510470400_sd.pdf)
- [S13: JST SH, six-position STOP housing/contact](https://www.jst-mfg.com/product/pdf/eng/eSH.pdf)
- [S14: JST PH, speaker housing/contact](https://www.jst-mfg.com/product/pdf/eng/ePH.pdf)
- [S15: JST XH, fan housings/contacts](https://www.jst-mfg.com/product/pdf/eng/eXH.pdf)
- [S16: Molex 5264 arm housing drawing](https://www.molex.com/content/dam/molex/molex-dot-com/products/automated/en-us/salesdrawingpdf/526/5264/050375023_sd.pdf)
- [S17: Molex 5263 arm contact drawing](https://www.molex.com/content/dam/molex/molex-dot-com/products/automated/en-us/salesdrawingpdf/526/5263/008701039_sd.pdf)
- [S18: Hoco HB1: four USB-A sockets and 80 cm captive lead](https://hocotech.com/product/mobile-accessories/cables/hubs-organizers/usb-hub-hb1-four-ports-usb-2-0-charging-and-data-sync/)
- [S19: Molex Micro-Fit current derating, populated circuits](https://www.molex.com/content/dam/molex/molex-dot-com/products/automated/en-us/productspecificationpdf/430/43045/PS-43045-001.pdf)
- [S20: Phoenix 1715721 supply terminal block](https://www.phoenixcontact.com/en-pc/products/pcb-terminal-block-mkds-15-2-508-1715721)
- [S21: AMASS XT30U cable connectors](https://www.china-amass.com/biao/649.html)
