metrox-eth/moss/hardware/electronics/moss-core-v0.7/harness/source/viewer_shell.html

MOSS V0.7 · Assembly review

# MOSS / Harness study

Routing prototypeRoutes ↗

Installed assembly/Preparing model

Preparing the assemblyLoading the embedded 3D model

The 3D model could not be displayed.

Installed Harness only Open lid Top

Drag to orbit · Scroll to zoom · Right-drag to pan

WORLD FRAME mm

×

01 / INSPECT

## A clearer path through the assembly.

STOP → J8 · Battery → XT30 J10.
USB links the Orange Pi, hub and Core J1.
Core J20 supplies the Pi POWER port.

### Visible layers

DISPLAY

Sleeves Cable ties

The five tie mounts are part of the hull.

ARoute labels

### Routes

—

Select a route to trace its path.

Routes will appear with the model.

i

Lengths follow the modeled centreline.
They are not wire cut lengths.
