metrox-eth/moss/hardware/power/custom-3s4p-battery/images/02-bms-board.jpg

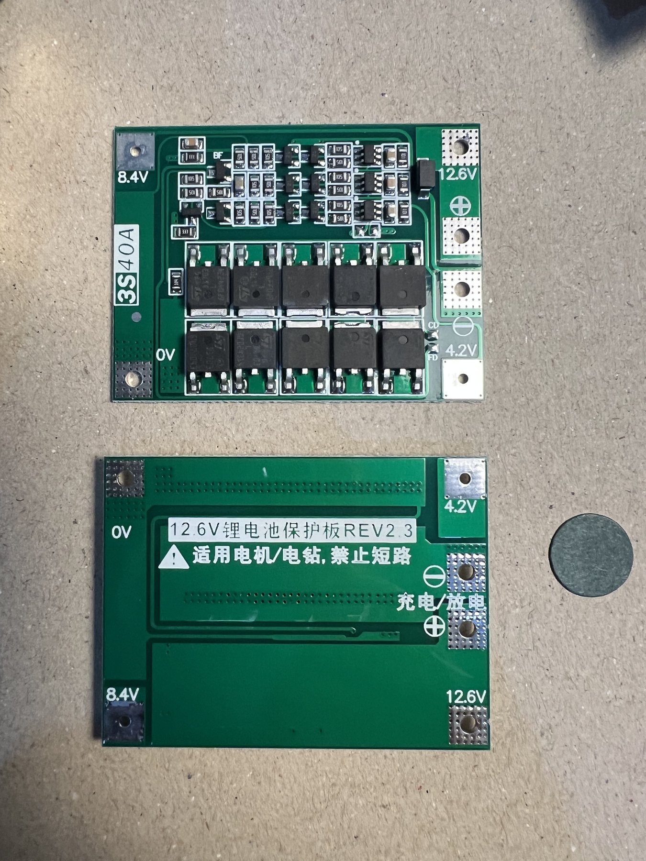
hardware/power/custom-3s4p-battery/images/02-bms-board.jpg
