metrox-eth/moss/hardware/power/custom-3s4p-battery/images/06-pack-end.jpg

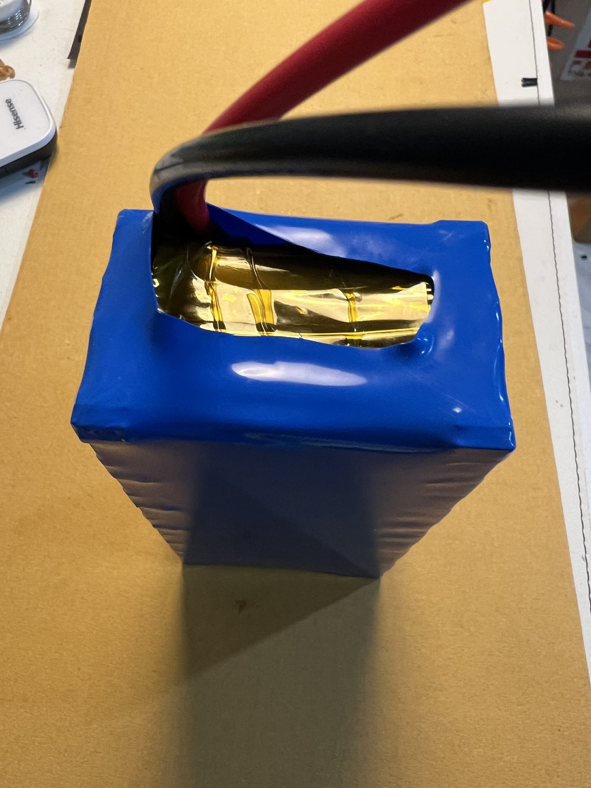
hardware/power/custom-3s4p-battery/images/06-pack-end.jpg
