metrox-eth/moss/media/images/cad_track_drivetrain_20260922.png

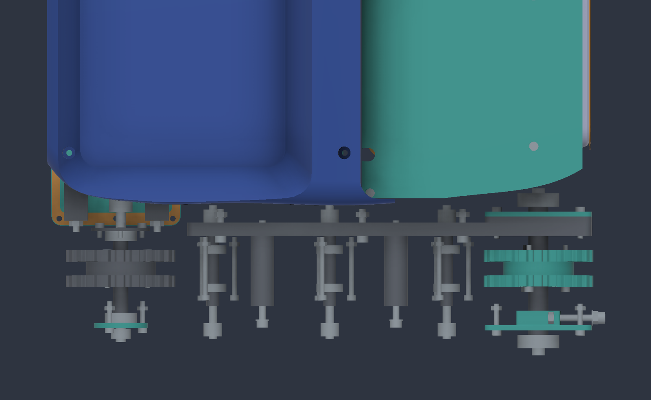
media/images/cad_track_drivetrain_20260922.png
