metrox-eth/moss/media/images/concept_01_concept_v2_3_1.jpg

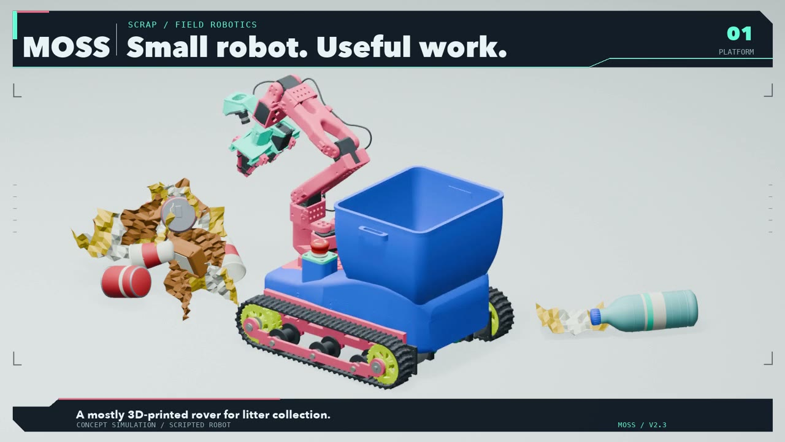
media/images/concept_01_concept_v2_3_1.jpg
