metrox-eth/moss/media/images/concept_02_pickup_v2_3_1.jpg

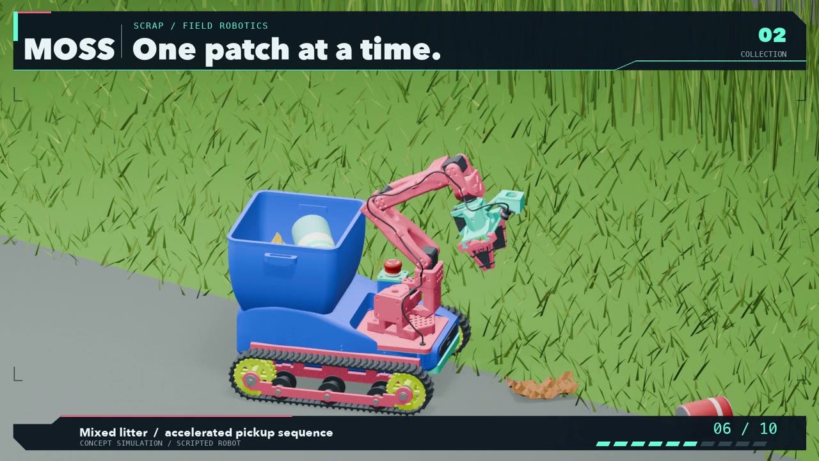
media/images/concept_02_pickup_v2_3_1.jpg
