metrox-eth/moss/media/images/concept_03_target_v2_3_1.jpg

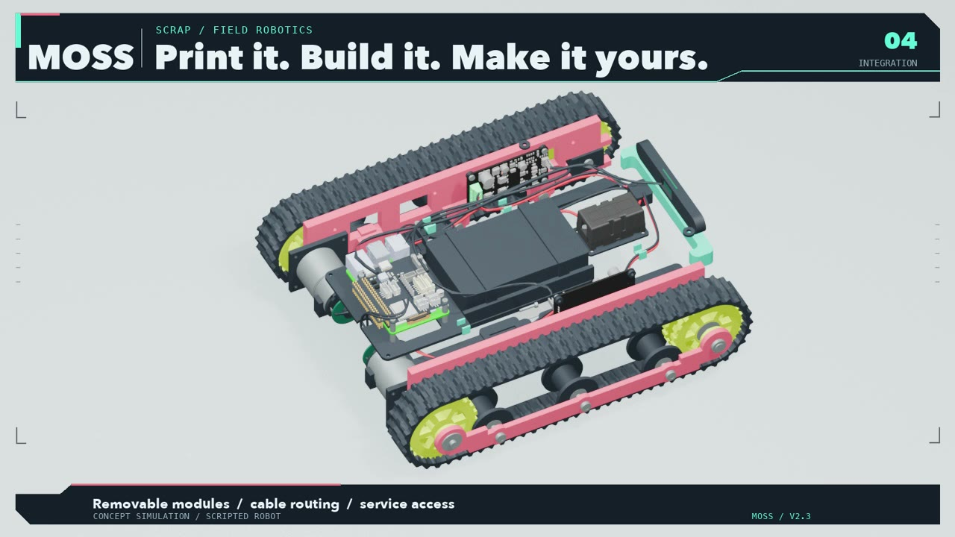
media/images/concept_03_target_v2_3_1.jpg
