metrox-eth/moss/media/images/moss_jev_demo_20260920.jpg

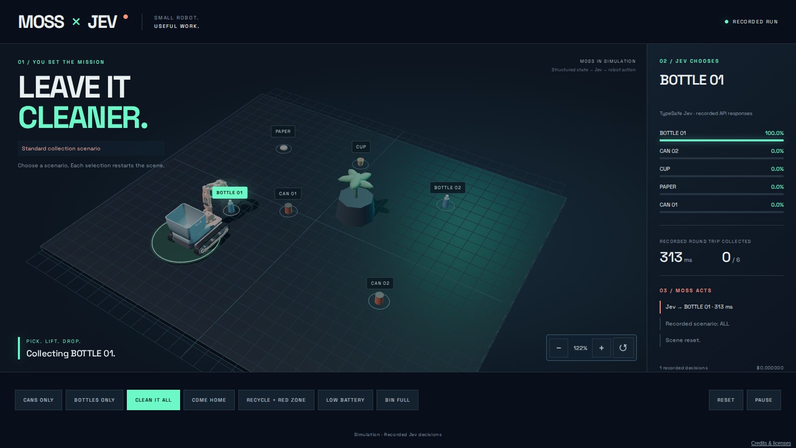
media/images/moss_jev_demo_20260920.jpg
