metrox-eth/moss/media/images/MOSS_V04_Inside_20260924.jpg

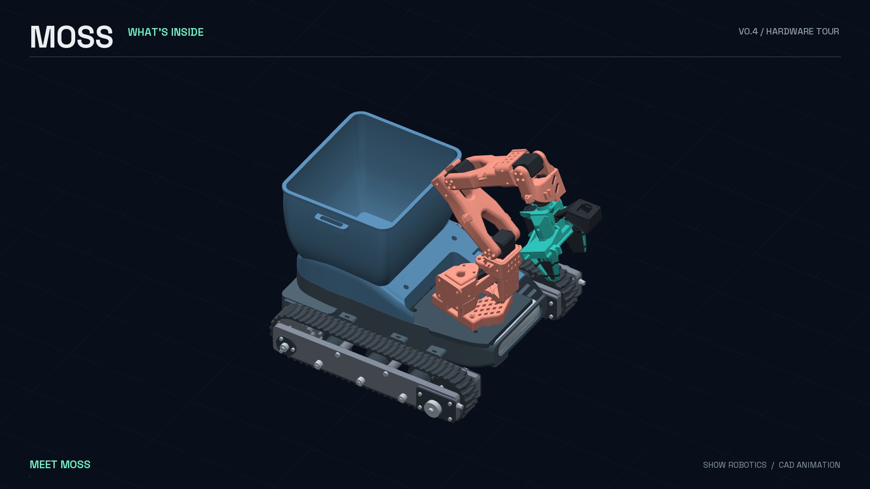
media/images/MOSS_V04_Inside_20260924.jpg
