metrox-eth/moss/media/images/moss_v05_all_the_pieces.jpg

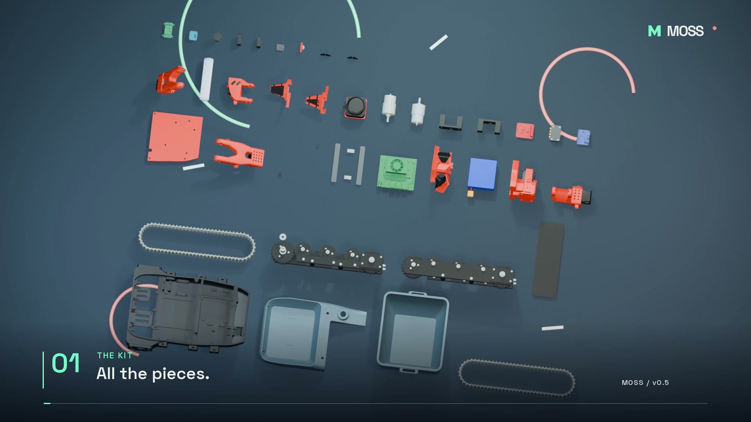
media/images/moss_v05_all_the_pieces.jpg
