metrox-eth/moss/media/images/moss_v06_modular.jpg

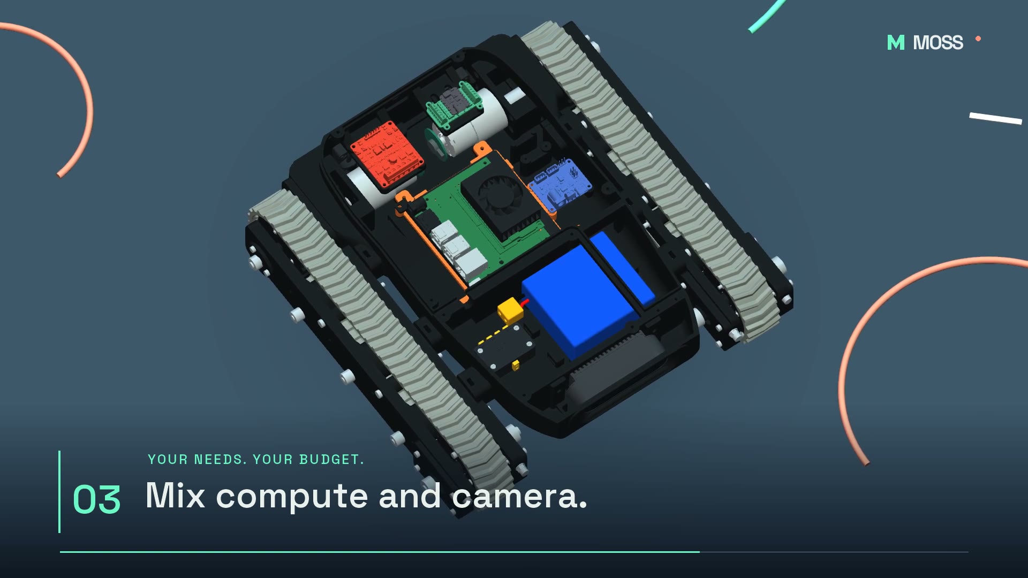
media/images/moss_v06_modular.jpg
