metrox-eth/moss/docs/build/printed_parts.csv

part_id | display_name | quantity | material | scope | file | revision | orientation | infill_percent | infill_pattern | profile | sha256 | legacy_part_ids
Hull_R92 | One-piece hull | 1 | PETG | HULL_ONE_PIECE | STL/Common/Hull_R92.stl | R92 | Flat exterior base down | 15 | gyroid | standard/default | 9b45996a2ef317cacde8c553b5b4efb98faa4f89487d55cc93c1eef5adaba554 | Hull_R92
Hull_R92_Split_Rear_Motor_Computer | Rear hull — motors and computer | 1 | PETG | HULL_SPLIT | STL/Options/Hull_R92_Split_Rear_Motor_Computer.stl | R92 split | Flat exterior base down | 15 | gyroid | standard/default | 381b85aa28536c89a068d1a93880d061eab6f2925ded41f76f850b3faaa19b3c | Hull_R92_Split_Rear_Motor_Computer
Hull_R92_Split_Front_Battery_Camera | Front hull — battery and camera | 1 | PETG | HULL_SPLIT | STL/Options/Hull_R92_Split_Front_Battery_Camera.stl | R92 split | Flat exterior base down | 15 | gyroid | standard/default | 250b07b65e5e2249517430d8257d333d09b212d25b9a6852622d6433c16a2164 | Hull_R92_Split_Front_Battery_Camera
Left_Outer_Track_Frame_R32 | Left Outer Track Frame R32 | 1 | PETG | COMMON | STL/Common/Left_Outer_Track_Frame_R32.stl | R32 | Flat, 45 degrees: front-right to rear-left diagonal; centre on the plate. Supplied STL is already rotated. Print each outer frame separately. | 15 | gyroid | standard/default | ffd50dc1ac47ea15197934334c73fbf68cbf1d92c60fd80ece3b50206c860809 | Left_Outer_Track_Frame_R32
Right_Outer_Track_Frame_R32 | Right Outer Track Frame R32 | 1 | PETG | COMMON | STL/Common/Right_Outer_Track_Frame_R32.stl | R32 | Flat, 45 degrees: front-right to rear-left diagonal; centre on the plate. Supplied STL is already rotated. Print each outer frame separately. | 15 | gyroid | standard/default | 0e6fe61167affa11301db8e77cf85b52a4668c521559f72761f5ee365adcfece | Right_Outer_Track_Frame_R32
Left_inner_tensioner_cover_R12_C2 | Left inner tensioner cover R12 C2 | 1 | PETG | COMMON | STL/Common/Left_inner_tensioner_cover_R12_C2.stl | R12-C2 | Existing print contact face retained | 15 | gyroid | standard/default | a952c3ad0663b9c3c29b5aec4b6322c34917dfa3835eb8485884bc34a7fd6769 | Left_inner_tensioner_cover_R12_C2
Right_inner_tensioner_cover_R12_C2 | Right inner tensioner cover R12 C2 | 1 | PETG | COMMON | STL/Common/Right_inner_tensioner_cover_R12_C2.stl | R12-C2 | Existing print contact face retained | 15 | gyroid | standard/default | d7413f0c1ccd1538aa9915b3fb4f87e10ba00368a04b0eb47e7779ff392595d2 | Right_inner_tensioner_cover_R12_C2
Left_inner_track_frame_R12_C2 | Left inner track frame R12 C2 | 1 | PETG | COMMON | STL/Common/Left_inner_track_frame_R12_C2.stl | R12-C2 | Existing print contact face retained | 15 | gyroid | standard/default | d78dfdd09c3dba1cb235a39028a1b3fa8a21275268d271384e5b88d341ffdeb0 | Left_inner_track_frame_R12_C2
Right_inner_track_frame_R12_C2 | Right inner track frame R12 C2 | 1 | PETG | COMMON | STL/Common/Right_inner_track_frame_R12_C2.stl | R12-C2 | Existing print contact face retained | 15 | gyroid | standard/default | 237aceddfc73351ad26fb6031196a8fa4afda64c631ae95b37c4f62336232d2c | Right_inner_track_frame_R12_C2
SP12_Frame_Cross_Member_Spacer | SP12 · Track frame cross-member spacer | 4 | PETG | COMMON | STL/Common/SP12_Frame_Cross_Member_Spacer.stl | R12 | Existing print contact face retained | 15 | gyroid | standard/default | db2a0fc7aebdfeec667c06aa9db338e11944392b0bb9312551a3d45597bb227a | Left_Spacer_cross_member_-40;Left_Spacer_cross_member_40;Right_Spacer_cross_member_-40;Right_Spacer_cross_member_40
SP01_Road_Wheel_Inner_Spacer | SP01 · Road wheel inner spacer | 6 | PETG | COMMON | STL/Common/SP01_Road_Wheel_Inner_Spacer.stl | R24 | Existing print contact face retained | 15 | gyroid | standard/default | 6524a07fd66cedb81cf84308b0f46450325c479c0272bc87a90087f9ddc2b17e | Left_Spacer_road_wheel_-70_inner_ID01_R24;Left_Spacer_road_wheel_0_inner_ID01_R24;Left_Spacer_road_wheel_70_inner_ID01_R24;Right_Spacer_road_wheel_-70_inner_ID01_R24;Right_Spacer_road_wheel_0_inner_ID01_R24;Right_Spacer_road_wheel_70_inner_ID01_R24
SP05_Idler_Inner_Spacer | SP05 · Idler inner spacer | 2 | PETG | COMMON | STL/Common/SP05_Idler_Inner_Spacer.stl | R24 | Existing print contact face retained | 15 | gyroid | standard/default | 1e966c06eb246e34d791411ec8ee111685d45df8c7c9554736f4bb0891309bd2 | Left_Spacer_tensioner_inner_ID05_R24;Right_Spacer_tensioner_inner_ID05_R24
SP03_Drive_Inner_Spacer | SP03 · Drive motor side spacer | 2 | PETG | COMMON | STL/Common/SP03_Drive_Inner_Spacer.stl | R24 | Existing print contact face retained | 15 | gyroid | standard/default | d80d8e7bd2ca3ac8e30ace2e8a3d5e320d52f6f77801e507bb830ea8da1c40d7 | Left_Spacer_drive_inner_ID03_R24;Right_Spacer_drive_inner_ID03_R24
02_Motor_access_hatch_10_screws | 02 Motor access hatch 10 screws | 1 | PETG | COMMON | STL/Common/02_Motor_access_hatch_10_screws.stl | Retained geometry | Existing print contact face retained | 15 | gyroid | standard/default | 0ff371e953ece886833933eb11cfbb20c85fa29b277a6b483e8b59f4824cdd71 | 02_Motor_access_hatch_10_screws
Motor_Mount_Left_R90 | Motor Mount Left R90 | 1 | PETG | COMMON | STL/Common/Motor_Mount_Left_R90.stl | R90 | Broad motor-facing flat face down | 15 | gyroid | standard/default | f570d1c1405bcb94ed911f226da8689d9e83fe02e97146cd5450150a0781a5f6 | Motor_Mount_Left_R90
Motor_Mount_Right_R90 | Motor Mount Right R90 | 1 | PETG | COMMON | STL/Common/Motor_Mount_Right_R90.stl | R90 | Broad motor-facing flat face down | 15 | gyroid | standard/default | 14966ecb934967dde73011f3d70092fb5f84ca31a4049be04df2a969c7704c30 | Motor_Mount_Right_R90
Motor_Bearing_Inner_Retainer | Motor bearing inner retainer | 2 | PETG | COMMON | STL/Common/Motor_Bearing_Inner_Retainer.stl | Retained geometry | Existing print contact face retained | 15 | gyroid | standard/default | 03bfdb4cbc0deb83c3a42974dd037ed9d5c79e66cb981570f51c1acb8696151f | 05_Left_bearing_retainer;06_Right_bearing_retainer
Lidar_Base_R84 | Lidar Base R84 | 1 | PETG | COMMON | STL/Common/Lidar_Base_R84.stl | R84 | Flat base down | 15 | gyroid | standard/default | cee5b2b9fda12df0160d8286a14e3c537af34daf2a312c69061bfbe1e417d89f | Lidar_Base_R84
Lidar_dovetail_carriage_R21 | Lidar dovetail carriage R21 | 1 | PETG | COMMON | STL/Common/Lidar_dovetail_carriage_R21.stl | R21 | Existing print contact face retained | 15 | gyroid | standard/default | 60c0045671823ab37e25e0e24d1d42149bb8dcefc07faf975a0ade4533dc31fb | Lidar_dovetail_carriage_R21
SP02_Road_Wheel_Outer_Spacer | SP02 · Road wheel outer spacer | 6 | PETG | COMMON | STL/Common/SP02_Road_Wheel_Outer_Spacer.stl | R24 | Existing print contact face retained | 15 | gyroid | standard/default | c5c7fcd0d8116541a818eeb6e55941981b87d2a916a44f9b976cf8330c3cf227 | Left_Spacer_road_wheel_-70_outer_ID02_R24;Left_Spacer_road_wheel_0_outer_ID02_R24;Left_Spacer_road_wheel_70_outer_ID02_R24;Right_Spacer_road_wheel_-70_outer_ID02_R24;Right_Spacer_road_wheel_0_outer_ID02_R24;Right_Spacer_road_wheel_70_outer_ID02_R24
SP06_Idler_Outer_Spacer | SP06 · Idler outer spacer | 2 | PETG | COMMON | STL/Common/SP06_Idler_Outer_Spacer.stl | R24 | Existing print contact face retained | 15 | gyroid | standard/default | c6f2a4077331e347d821f42ba7f2c5671a3a2dafe4289384dd8c79746481eab1 | Left_Spacer_tensioner_outer_ID06_R24;Right_Spacer_tensioner_outer_ID06_R24
SP04_Drive_Outer_Spacer | SP04 · Drive outer spacer | 2 | PETG | COMMON | STL/Common/SP04_Drive_Outer_Spacer.stl | R24 | Existing print contact face retained | 15 | gyroid | standard/default | 15ae1e23103e2bde4b66ffe85066e6843a4f419b9c7c72b7e0d15eee565bf21e | Left_Spacer_drive_outer_HEX12_L12.6_ID04_R24;Right_Spacer_drive_outer_HEX12_L12.6_ID04_R24
Left_Cover_tensioner_outer | Left Cover tensioner outer | 1 | PETG | COMMON | STL/Common/Left_Cover_tensioner_outer.stl | Retained geometry | Existing print contact face retained | 15 | gyroid | standard/default | d6d175df3d2e84d014bd88c859e31b46d66192fe9c9406fbaa0fce40c91cc43c | Left_Cover_tensioner_outer
Right_Cover_tensioner_outer | Right Cover tensioner outer | 1 | PETG | COMMON | STL/Common/Right_Cover_tensioner_outer.stl | Retained geometry | Existing print contact face retained | 15 | gyroid | standard/default | 5e5b1b47f668f7b8e378c3f30870bb8dedbd67da9b5d38dc929fabcc2aa3352b | Right_Cover_tensioner_outer
Left_22T_idler_wheel_inner_half_R13 | Left 22T idler wheel inner half R13 | 1 | PETG | COMMON | STL/Common/Left_22T_idler_wheel_inner_half_R13.stl | R13 | Existing print contact face retained | 15 | gyroid | standard/default | 77b2859474ff1eb24162dbe9291a52d312956f78bfe3a573cfbd1106573ea07c | Left_22T_idler_wheel_inner_half_R13
Left_22T_idler_wheel_outer_half_R13 | Left 22T idler wheel outer half R13 | 1 | PETG | COMMON | STL/Common/Left_22T_idler_wheel_outer_half_R13.stl | R13 | Existing print contact face retained | 15 | gyroid | standard/default | 48c6ae723a10b85903ec759c0ad38158bf2e82bcd3cbcaf6f9d82a8c79da4ae9 | Left_22T_idler_wheel_outer_half_R13
Right_22T_idler_wheel_inner_half_R13 | Right 22T idler wheel inner half R13 | 1 | PETG | COMMON | STL/Common/Right_22T_idler_wheel_inner_half_R13.stl | R13 | Existing print contact face retained | 15 | gyroid | standard/default | e51beb8d4e27e6137f442ba4e177e749425769155171733927698e93d0a88866 | Right_22T_idler_wheel_inner_half_R13
Right_22T_idler_wheel_outer_half_R13 | Right 22T idler wheel outer half R13 | 1 | PETG | COMMON | STL/Common/Right_22T_idler_wheel_outer_half_R13.stl | R13 | Existing print contact face retained | 15 | gyroid | standard/default | df4c4ca86480ca706b1b7ffc537102efae8bb24975c3af9fcb9249ad706befa5 | Right_22T_idler_wheel_outer_half_R13
Left_HEX12_drive_wheel_inner_half_R13 | Left HEX12 drive wheel inner half R13 | 1 | PETG | COMMON | STL/Common/Left_HEX12_drive_wheel_inner_half_R13.stl | R13 | Existing print contact face retained | 15 | gyroid | standard/default | 175fb4bb2be6d53f577b9ea9e66632386c060aa5ab73350b09abdb1e34e96aaf | Left_HEX12_drive_wheel_inner_half_R13
Left_HEX12_drive_wheel_outer_half_R13 | Left HEX12 drive wheel outer half R13 | 1 | PETG | COMMON | STL/Common/Left_HEX12_drive_wheel_outer_half_R13.stl | R13 | Existing print contact face retained | 15 | gyroid | standard/default | df54e36a434622e619b4a387bd571cca4d4e17812ecb3cace085e111443ee7b0 | Left_HEX12_drive_wheel_outer_half_R13
Right_HEX12_drive_wheel_inner_half_R13 | Right HEX12 drive wheel inner half R13 | 1 | PETG | COMMON | STL/Common/Right_HEX12_drive_wheel_inner_half_R13.stl | R13 | Existing print contact face retained | 15 | gyroid | standard/default | 9f1f62430da95d606acaabb43d780efebe6c83d32e0e0fcaa393666af18a766b | Right_HEX12_drive_wheel_inner_half_R13
Right_HEX12_drive_wheel_outer_half_R13 | Right HEX12 drive wheel outer half R13 | 1 | PETG | COMMON | STL/Common/Right_HEX12_drive_wheel_outer_half_R13.stl | R13 | Existing print contact face retained | 15 | gyroid | standard/default | e31109e78f8e906836b356bfc43dc7cc667bc2282af2c3c6d79dcbfc584de1ef | Right_HEX12_drive_wheel_outer_half_R13
Road_Wheel_Inner_Half_R13 | Road wheel inner half | 6 | PETG | COMMON | STL/Common/Road_Wheel_Inner_Half_R13.stl | R13 | Existing print contact face retained | 15 | gyroid | standard/default | 2853ae9909ac647cbec61492814757dd80377637ab360da3164338cd4b3359c1 | Left_625_road_wheel_-70_inner_half_R13;Left_625_road_wheel_70_inner_half_R13;Left_625_road_wheel_0_inner_half_R13;Right_625_road_wheel_-70_inner_half_R13;Right_625_road_wheel_70_inner_half_R13;Right_625_road_wheel_0_inner_half_R13
Road_Wheel_Outer_Half_R13 | Road wheel outer half | 6 | PETG | COMMON | STL/Common/Road_Wheel_Outer_Half_R13.stl | R13 | Existing print contact face retained | 15 | gyroid | standard/default | cb161b90f7f84718b3c3c9c5f4418a6551f66d3770d51ca3b6dd1451d59a45e2 | Left_625_road_wheel_-70_outer_half_R13;Left_625_road_wheel_70_outer_half_R13;Left_625_road_wheel_0_outer_half_R13;Right_625_road_wheel_-70_outer_half_R13;Right_625_road_wheel_70_outer_half_R13;Right_625_road_wheel_0_outer_half_R13
XT30_distribution_base | XT30 distribution base | 1 | PETG | COMMON | STL/Common/XT30_distribution_base.stl | Retained geometry | Existing print contact face retained | 15 | gyroid | standard/default | 44993df950cc8bdfa87787a864453a295e5501f1aea82fb51551e71cafb05b27 | XT30_distribution_base
XT30_distribution_lid | XT30 distribution lid | 1 | PETG | COMMON | STL/Common/XT30_distribution_lid.stl | Retained geometry | Existing print contact face retained | 15 | gyroid | standard/default | 24f5e38779d4209306a1c65a5d62301984f695cba3ea27f7d915bc22ed1dfd6a | XT30_distribution_lid
XT30_insulating_separator | XT30 insulating separator | 1 | PETG | COMMON | STL/Common/XT30_insulating_separator.stl | Retained geometry | Existing print contact face retained | 15 | gyroid | standard/default | 135d6e6560ba2c33acd932894edf3bbe658ac52ed1e9c61e0f78152a010f0bc9 | XT30_insulating_separator
Tensioner_Slider | Tensioner slider | 4 | PETG | COMMON | STL/Common/Tensioner_Slider.stl | Retained geometry | Print on the supplied contact face. Rotate the same part to suit the inner or outer tensioner during assembly. | 15 | gyroid | standard/default | 6813f1fd774ecaac418b789a7b44a54baa0b683bc97ee36af9a8b0670919c862 | Tensioner_Slider_A;Tensioner_Slider_B;Left_Slider_outer;Right_inner_tensioner_slider;Right_Slider_outer;Left_inner_tensioner_slider
Motor_Bearing_Outer_Cover | Motor bearing outer cover | 2 | PETG | COMMON | STL/Common/Motor_Bearing_Outer_Cover.stl | Retained geometry | Existing print contact face retained | 15 | gyroid | standard/default | b1b206c886d907bf3e5598bb0f3b9c6e655c2fc5b957fe26b2f74eea1fbe3e6a | Left_Cover_motor_bearing;Right_Cover_motor_bearing
SP07_Idler_Inner_Retainer_Spacer | SP07 · Idler inner retainer spacer | 2 | PETG | COMMON | STL/Common/SP07_Idler_Inner_Retainer_Spacer.stl | R24 | Existing print contact face retained | 15 | gyroid | standard/default | 048d7d84043dc8c3c189128ee35d349206895bdea5d749190fd0547b22020d99 | Left_Spacer_tensioner_retainer_inner_ID07_R24;Right_Spacer_tensioner_retainer_inner_ID07_R24
SP08_Idler_Outer_Retainer_Spacer | SP08 · Idler outer retainer spacer | 2 | PETG | COMMON | STL/Common/SP08_Idler_Outer_Retainer_Spacer.stl | R24 | Existing print contact face retained | 15 | gyroid | standard/default | 529c3c55098e1e9501e05599cc5184b6308c112224f177e3dc83fa4265eb6495 | Left_Spacer_tensioner_retainer_outer_ID08_R24;Right_Spacer_tensioner_retainer_outer_ID08_R24
SP10_Idler_Centre_Spacer | SP10 · Idler centre spacer | 2 | PETG | COMMON | STL/Common/SP10_Idler_Centre_Spacer.stl | Retained geometry | Existing print contact face retained | 15 | gyroid | standard/default | c55f0f38adcd86ab697447cb757609ebf0fce6fb706d9dee1679f07b50570287 | Left_Spacer_tensioner_center;Right_Spacer_tensioner_center
SP09_Road_Wheel_Centre_Spacer | SP09 · Road wheel centre spacer | 6 | PETG | COMMON | STL/Common/SP09_Road_Wheel_Centre_Spacer.stl | Retained geometry | Existing print contact face retained | 15 | gyroid | standard/default | 99bc1d990afdb67c553560384303e923ed13e0f98cc9f6a945827b9877e9913d | Left_Spacer_road_wheel_-70_center;Left_Spacer_road_wheel_0_center;Left_Spacer_road_wheel_70_center;Right_Spacer_road_wheel_-70_center;Right_Spacer_road_wheel_0_center;Right_Spacer_road_wheel_70_center
SP11_Drive_Bearing_To_Collar_Spacer | SP11 · Drive bearing to collar spacer | 2 | PETG | COMMON | STL/Common/SP11_Drive_Bearing_To_Collar_Spacer.stl | R12-C1 | Existing print contact face retained | 15 | gyroid | standard/default | 48c99c9a472259abe14130a36cb309b5c4a5f7c7a1ad47759d74cb03f825490d | Left_Drive_bearing_to_collar_spacer_R12_C1;Right_Drive_bearing_to_collar_spacer_R12_C1
Upper_cover_R9 | One-piece upper cover | 1 | PLA | COVER_ONE_PIECE | STL/Common/Upper_cover_R9.stl | R9 | Rear edge down | 15 | gyroid | standard/default | cefcab0e8833cb79a537ca144d8cee725a2cd4e4a88fdc5d969d840c5405442e | Upper_cover_R9
Upper_Cover_R10_Rear | Split cover · rear section | 1 | PLA | COVER_SPLIT | STL/Options/Upper_Cover_R10_Rear.stl | R10 | Rear edge down; supplied STL orientation | 15 | gyroid | standard/default | 1397c30e03f5b9cebcde141ea1eb1c1ed7712977ea8b8afcbda51ae7bf816b56 | Upper_Cover_R10_Rear
Upper_Cover_R10_Lidar_Extension | Split cover · LiDAR extension | 1 | PLA | COVER_SPLIT | STL/Options/Upper_Cover_R10_Lidar_Extension.stl | R10 | Front edge down; supplied STL orientation | 15 | gyroid | standard/default | 7cf31ce9157252369f62117a5b107858dae5541747ab0301747a6b8bb0a673ef | Upper_Cover_R10_Lidar_Extension
14_Bin_20x10x2_magnet_pockets | 14 Bin 20x10x2 magnet pockets | 1 | PLA | COMMON | STL/Common/14_Bin_20x10x2_magnet_pockets.stl | Retained geometry | Existing print contact face retained | 15 | gyroid | standard/default | cc3a8925a56fba498727c7d3481013b0bd35c07c6c666ee1057ae276bfb3184c | 14_Bin_20x10x2_magnet_pockets
Arm_Mounting_Platform_R22 | Arm Mounting Platform R22 | 1 | PLA | COMMON | STL/Common/Arm_Mounting_Platform_R22.stl | R22 | Flat underside down | 15 | gyroid | standard/default | 4ceb00daa4abb8b30f56125d519a97a1d1b2b259f165d47348ecb8335a413fe9 | Arm_Mounting_Platform_R22
SO101_Base | SO101 Base | 1 | PLA | COMMON | STL/Common/SO101_Base.stl | Retained geometry | Existing print contact face retained | 15 | gyroid | standard/default | bb139655c24730bb3d0e1c5ee6c801cfae97c5d1c2ddeef3684801a22551128e | SO101_Base
SO101_Shoulder_rotation | SO101 Shoulder rotation | 1 | PLA | COMMON | STL/Common/SO101_Shoulder_rotation.stl | Retained geometry | Existing print contact face retained | 15 | gyroid | standard/default | 0dbb9c84750ac6fd8e7b4529d407a1f4ef6e05f035d88d5d977d95d7d8e5bcf6 | SO101_Shoulder_rotation
SO101_Base_motor_holder | SO101 Base motor holder | 1 | PLA | COMMON | STL/Common/SO101_Base_motor_holder.stl | Retained geometry | Existing print contact face retained | 15 | gyroid | standard/default | 517d5c0426b77fb9c77c1ee725efd16b50375557315db100d658cb3961d69768 | SO101_Base_motor_holder
SO101_Shoulder_bracket_cable_clip | SO101 Shoulder bracket cable clip | 1 | PLA | COMMON | STL/Common/SO101_Shoulder_bracket_cable_clip.stl | Retained geometry | Existing print contact face retained | 15 | gyroid | standard/default | 4441127a3a7260ffd03205706cf8de75efdad202701f7e9e4c1f17138f162a9c | SO101_Shoulder_bracket_cable_clip
SO101_Upper_arm_cable_clip | SO101 Upper arm cable clip | 1 | PLA | COMMON | STL/Common/SO101_Upper_arm_cable_clip.stl | Retained geometry | Existing print contact face retained | 15 | gyroid | standard/default | 6f5bc515e84edf766f3836c878e7f905c05800e05bfef4e1c855eea87dcedd07 | SO101_Upper_arm_cable_clip
SO101_Forearm_cable_clip | SO101 Forearm cable clip | 1 | PLA | COMMON | STL/Common/SO101_Forearm_cable_clip.stl | Retained geometry | Existing print contact face retained | 15 | gyroid | standard/default | 46189448174ccb6c09b7f1c4e503e24b2fe513f4015345737cda6a4a9742b8dc | SO101_Forearm_cable_clip
SO101_Wrist_cable_clip | SO101 Wrist cable clip | 1 | PLA | COMMON | STL/Common/SO101_Wrist_cable_clip.stl | Retained geometry | Existing print contact face retained | 15 | gyroid | standard/default | cca0d36fd3f7792bffb75729ff278dcf0cd55573963f909a8492e712b31d8b3a | SO101_Wrist_cable_clip
SO101_Wrist_bracket | SO101 Wrist bracket | 1 | PLA | COMMON | STL/Common/SO101_Wrist_bracket.stl | Retained geometry | Existing print contact face retained | 15 | gyroid | standard/default | 2ed54e713657f810193759ee3b8436768801a27b30adb987d1c0af47870414aa | SO101_Wrist_bracket
NC90_Right_side_shield | NC90 Right side shield | 1 | PLA | COMMON | STL/Common/NC90_Right_side_shield.stl | Retained geometry | Existing print contact face retained | 15 | gyroid | standard/default | 446839e28af02c98fb8308961377aaa9c020ea65854f7aeafff0f136b3a5b788 | NC90_Right_side_shield
NC90_Pinion | NC90 Pinion | 1 | PLA | COMMON | STL/Common/NC90_Pinion.stl | Retained geometry | Existing print contact face retained | 15 | gyroid | standard/default | 1b2745cd7558260526bf6b5384a845e550140289ceb2e5f03d2946562fe4c47b | NC90_Pinion
NC90_Cable_guide | NC90 Cable guide | 1 | PLA | COMMON | STL/Common/NC90_Cable_guide.stl | Retained geometry | Existing print contact face retained | 15 | gyroid | standard/default | 6e3cb92d5a9faee41409a960b28ff721dafd5ba9ff42fb5a8f73ce9767225d91 | NC90_Cable_guide
NC90_Right_jaw_extended_rack | NC90 Right jaw extended rack | 1 | PLA | COMMON | STL/Common/NC90_Right_jaw_extended_rack.stl | Retained geometry | Existing print contact face retained | 15 | gyroid | standard/default | e9be4ff4921b503968d1bebd5dcedda75220b9726f89fc03b202620eb229d0a1 | NC90_Right_jaw_extended_rack
Gripper_Camera_Mount_R30 | Gripper Camera Mount R30 | 1 | PLA | COMMON | STL/Common/Gripper_Camera_Mount_R30.stl | R30 | Supplied print orientation for current IMX335 B mount | 15 | gyroid | standard/default | 93c1facf058472add5ea0a1e82e36b504f826fe2b126dd8ffaaf23beb24d4dd6 | Gripper_Camera_Mount_R30
NC90_Left_side_shield | NC90 Left side shield | 1 | PLA | COMMON | STL/Common/NC90_Left_side_shield.stl | Retained geometry | Existing print contact face retained | 15 | gyroid | standard/default | 65f6c80d3932bb9b12cc5dd9ff0c3951be56ebf5e3bd1abbb30c25a22bc9c3a8 | NC90_Left_side_shield
NC90_Base_extended_rails | NC90 Base extended rails | 1 | PLA | COMMON | STL/Common/NC90_Base_extended_rails.stl | Retained geometry | Existing print contact face retained | 15 | gyroid | standard/default | 36b703cc677bb4940c0293e5f0d077895432f28c34b46e404cb8a28ba686dfef | NC90_Base_extended_rails
NC90_Left_jaw_extended_rack | NC90 Left jaw extended rack | 1 | PLA | COMMON | STL/Common/NC90_Left_jaw_extended_rack.stl | Retained geometry | Existing print contact face retained | 15 | gyroid | standard/default | ce6cb5e53bf08f7d09371769ce6ae494def14caf3c044b87c84e2d06fd848da9 | NC90_Left_jaw_extended_rack
Track_R78_70_Teeth | Track · 70 teeth | 2 | TPU | COMMON | STL/Common/Track_R78_70_Teeth.stl | R78 | Flat side down; 70 teeth, 6.8 mm central guides | 15 | gyroid | standard/default | d092d2bf59d6c6a89a8a82b96383cf3bd632fb41a7db1df81de91426a6ae5c4c | Left_Track_R78_70_Teeth;Right_Track_R78_70_Teeth
Jetson_Adapter_R87 | Jetson Adapter R87 | 1 | PETG | COMPUTE_JETSON | STL/Options/Jetson_Adapter_R87.stl | R87 | Flat underside down | 15 | gyroid | standard/default | 3c8724a29c7588218bcfcc9821e5bb9c0a56695a9844ef8e6f8f425f984a4434 | Jetson_Adapter_R87
Jetson_Retaining_Tab_1_R92 | JT01 · Jetson retaining tab 1 | 1 | PETG | COMPUTE_JETSON | STL/Options/Jetson_Retaining_Tab_1_R92.stl | R92 | Flat underside down | 15 | gyroid | standard/default | e36a330e6820215b9374ea752bd35d50f87f58c429b1b4c0ffa8f139b930051f
Jetson_Retaining_Tab_2_R92 | JT02 · Jetson retaining tab 2 | 1 | PETG | COMPUTE_JETSON | STL/Options/Jetson_Retaining_Tab_2_R92.stl | R92 | Flat underside down | 15 | gyroid | standard/default | bbfb80654acb04eb1c8531a5f5bb95e0de4939ac47fdcb70a088ef5ee05566ef
Pi_Adapter_R87 | Pi Adapter R87 | 1 | PETG | COMPUTE_PI | STL/Options/Pi_Adapter_R87.stl | R87 | Flat underside down | 15 | gyroid | standard/default | d72e3c82705c3bc7b07b8fcf8b1320de7568322e36710dc834c5e7280dc6e33f | Pi_Adapter_R87
Gemini_Window_Adapter_R89 | Gemini Window Adapter R89 | 1 | PETG | CAMERA_GEMINI | STL/Options/Gemini_Window_Adapter_R89.stl | R89 | Flat front frame down; curved ends retained | 15 | gyroid | standard/default | 35f3b273a4333afe83a155f0c3c107fb17c259550fb4febd2438d7b7edb20a3e | Gemini_Window_Adapter_R89
Gemini_Flush_Insert_R72 | Gemini Flush Insert R72 | 1 | PETG | CAMERA_GEMINI | STL/Options/Gemini_Flush_Insert_R72.stl | R72 | Rear flat face down; plain top-entry key | 15 | gyroid | standard/default | fa70f045cbbcb3c0370f37ef9d027e5fde1cd465bf8b7efecf117df9c69978c6 | Gemini_Flush_Insert_R72
RealSense_Insert_R72 | RealSense Insert R72 | 1 | PETG | CAMERA_REALSENSE | STL/Options/RealSense_Insert_R72.stl | R72 | Rear flat face down; top-entry screw-support key | 15 | gyroid | standard/default | 2691a9936c8ffa76ae540b0a0e7b1522b1ec034c4c85ca18b2c02ef1ca79179d | RealSense_Insert_R72
