metrox-eth/moss/media/images/build_02_first_parts_20260917.jpg

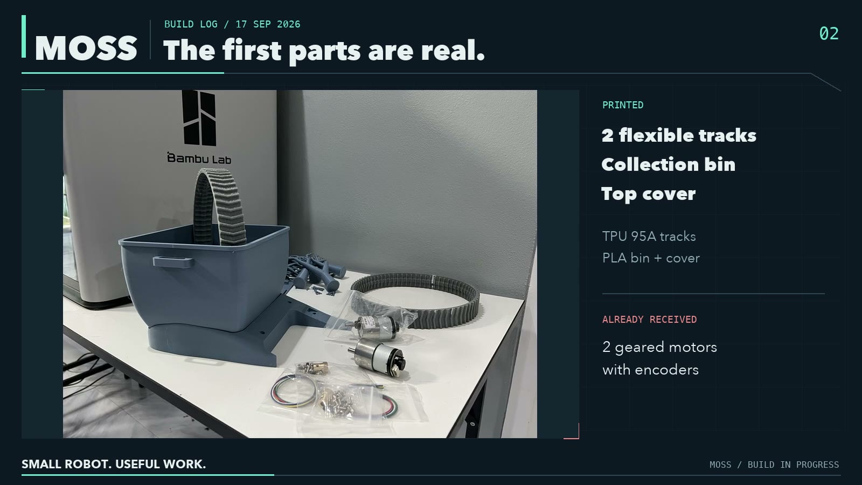
media/images/build_02_first_parts_20260917.jpg
