metrox-eth/moss/media/images/build_03_first_fit_parts_20260918.jpg

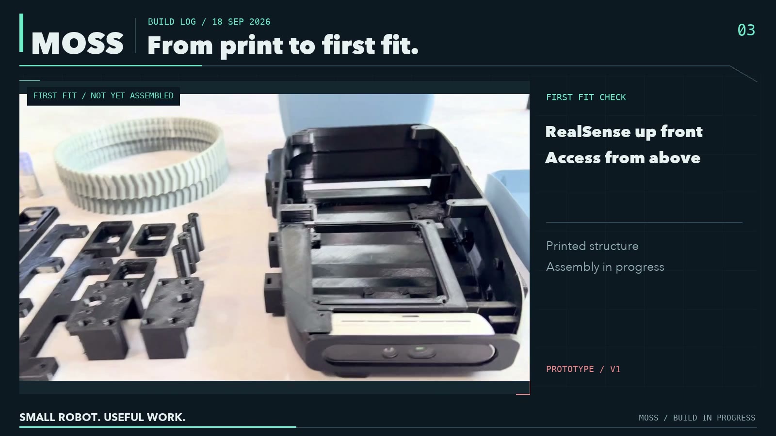
media/images/build_03_first_fit_parts_20260918.jpg
