metrox-eth/moss/media/images/MOSS_cost_comparison_20260921.jpg

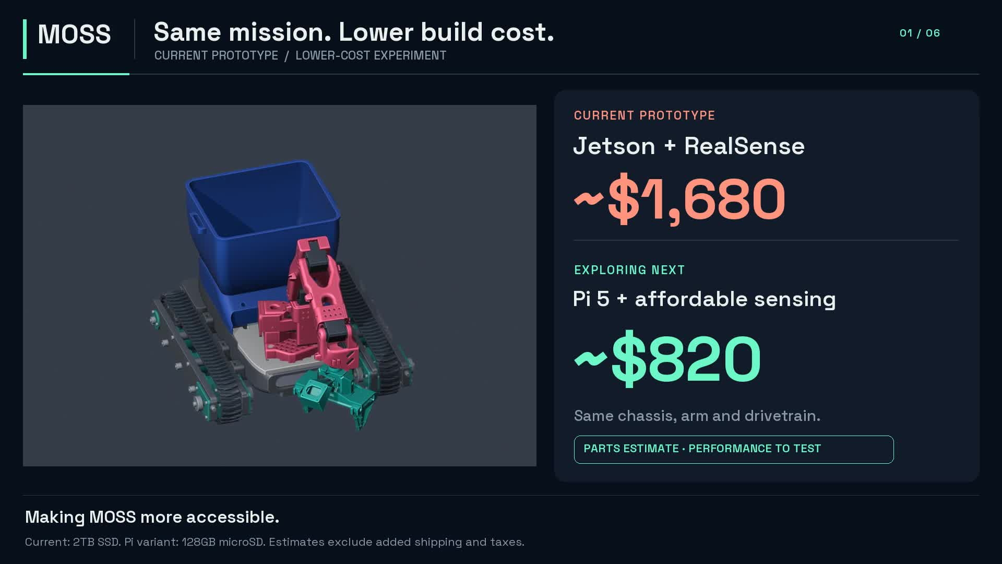
media/images/MOSS_cost_comparison_20260921.jpg
