metrox-eth/moss/hardware/mechanical/dual-shoulder-r2/CAD/02_Upper_Arm_Dual_R2.step

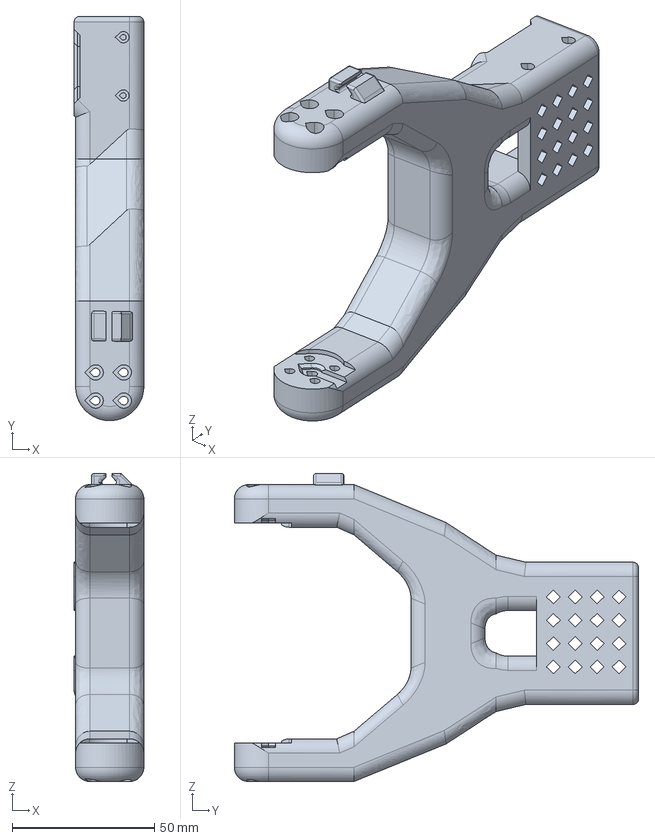
[picture p28: CAD file, 2026-10-27]
hardware/mechanical/dual-shoulder-r2/CAD/02_Upper_Arm_Dual_R2.step
24.5 x 142.2 x 108.3 mm
