metrox-eth/moss/hardware/mechanical/dual-shoulder-r2/STL/01_Shoulder_Monobloc_R2.stl

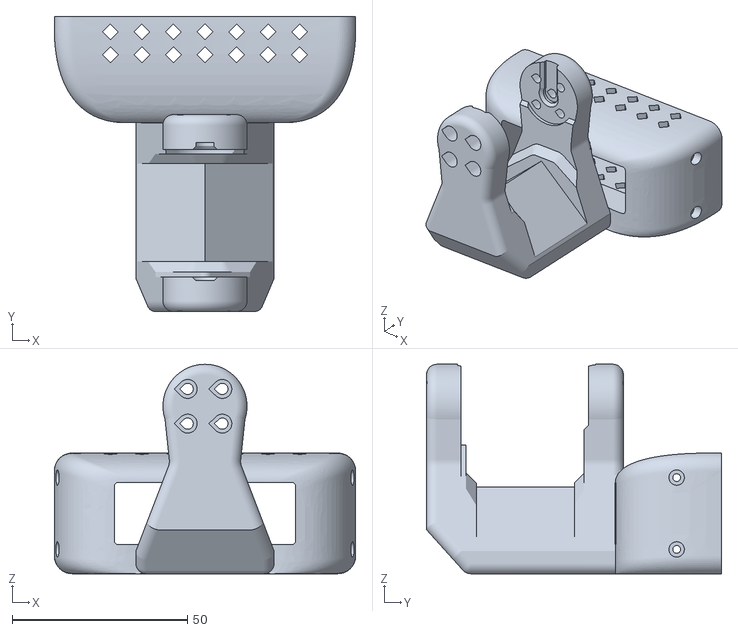
[picture p29: CAD file, 2026-10-27]
hardware/mechanical/dual-shoulder-r2/STL/01_Shoulder_Monobloc_R2.stl
86.0 x 84.2 x 59.8
