metrox-eth/moss/hardware/mechanical/moss-v0.7-hull/cad/tie_anchors_overlay.step

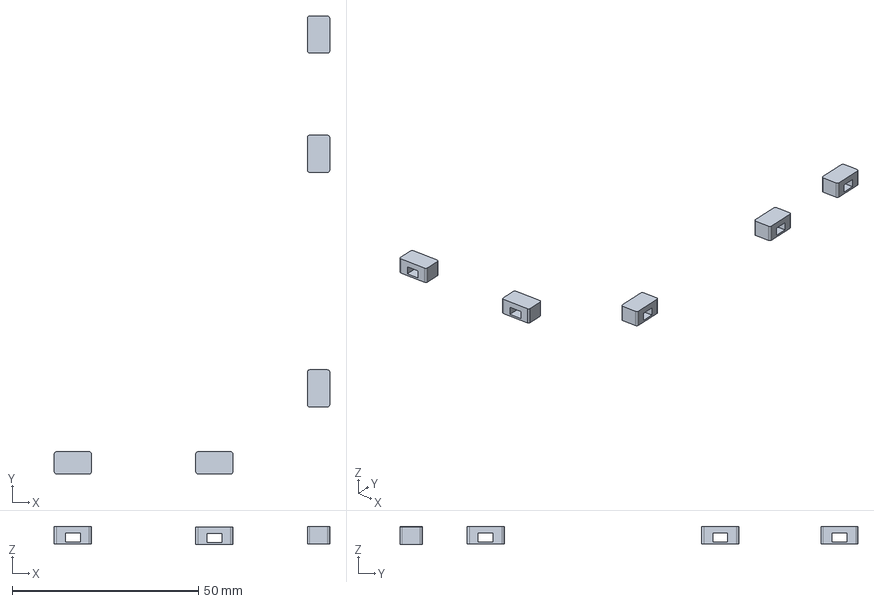
[picture p30: CAD file, 2026-11-09]
hardware/mechanical/moss-v0.7-hull/cad/tie_anchors_overlay.step
74.0 x 123.0 x 4.94 mm
