metrox-eth/moss/hardware/mechanical/moss-v0.7-hull/reference/Hull_R92_Repaired.step

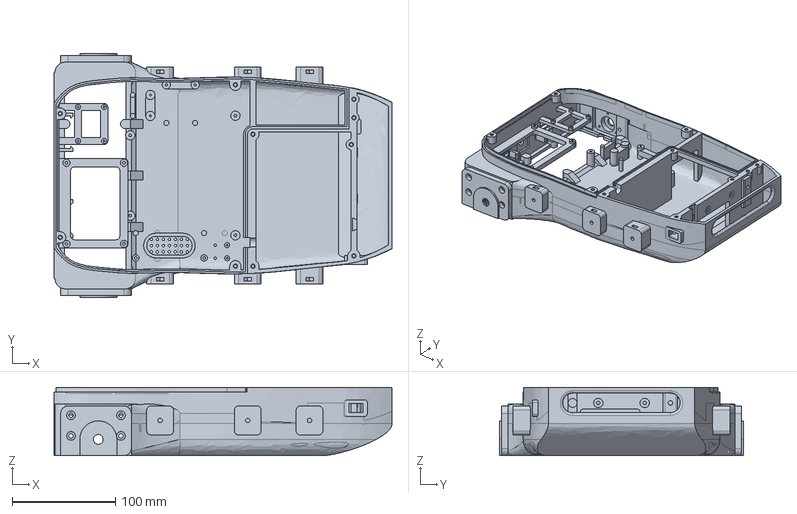
[picture p31: CAD file, 2026-11-01]
hardware/mechanical/moss-v0.7-hull/reference/Hull_R92_Repaired.step
328.0 x 237.0 x 66.0 mm
