metrox-eth/moss/hardware/mechanical/moss-v0.7-hull/stl/Hull_MOSS_V07_Print.stl

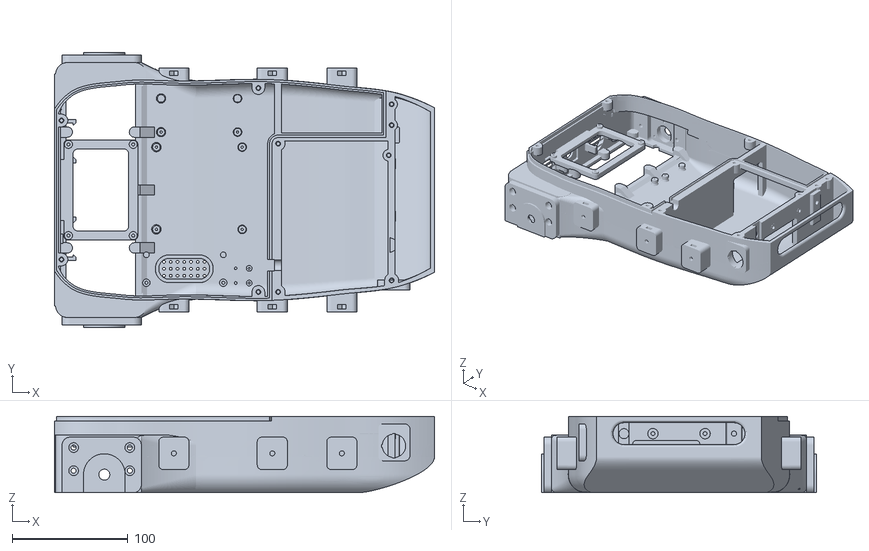
[picture p32: CAD file, 2026-11-09]
hardware/mechanical/moss-v0.7-hull/stl/Hull_MOSS_V07_Print.stl
328.0 x 237.0 x 66.0
