metrox-eth/moss/simulation/mujoco/model/meshes/collision/part_0290_056.stl

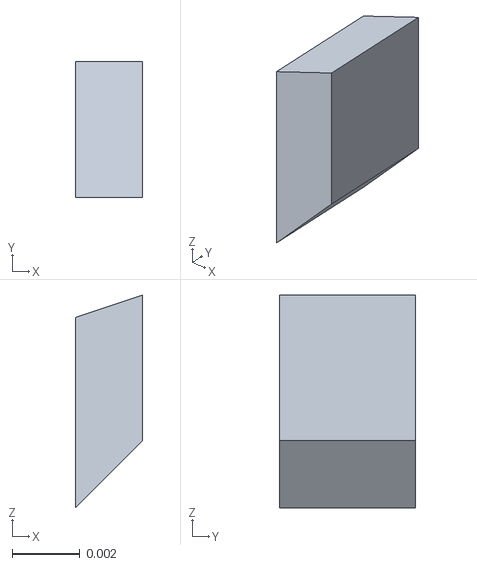
[picture p33: CAD file, 2026-10-26]
simulation/mujoco/model/meshes/collision/part_0290_056.stl
0.00199 x 0.00402 x 0.00629
