metrox-eth/moss/simulation/mujoco/model/meshes/SO101_Upper_arm_cable_clip.stl

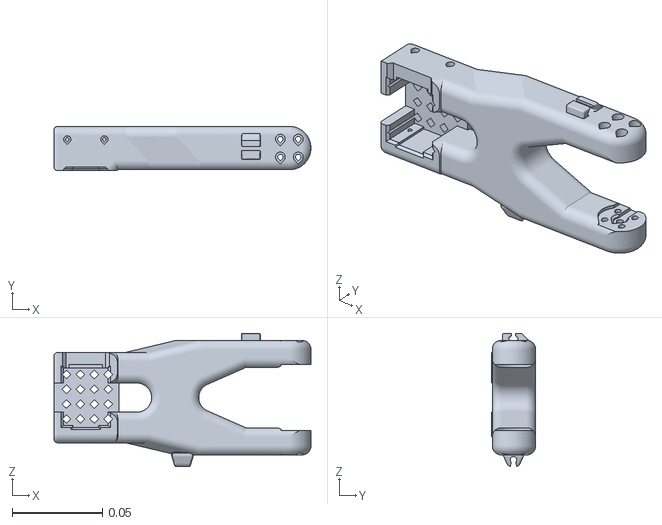
[picture p34: CAD file, 2026-10-26]
simulation/mujoco/model/meshes/SO101_Upper_arm_cable_clip.stl
0.142 x 0.0245 x 0.0738
