metrox-eth/moss/simulation/mujoco/model/meshes/collision/part_0290_030.stl

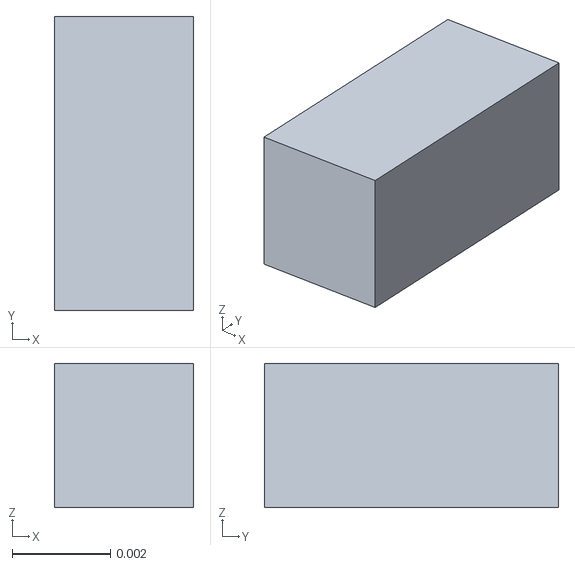
[picture p35: CAD file, 2026-10-26]
simulation/mujoco/model/meshes/collision/part_0290_030.stl
0.00282 x 0.00597 x 0.00293
