metrox-eth/moss/simulation/mujoco/model/meshes/Right_22T_idler_wheel_outer_half_R13.stl

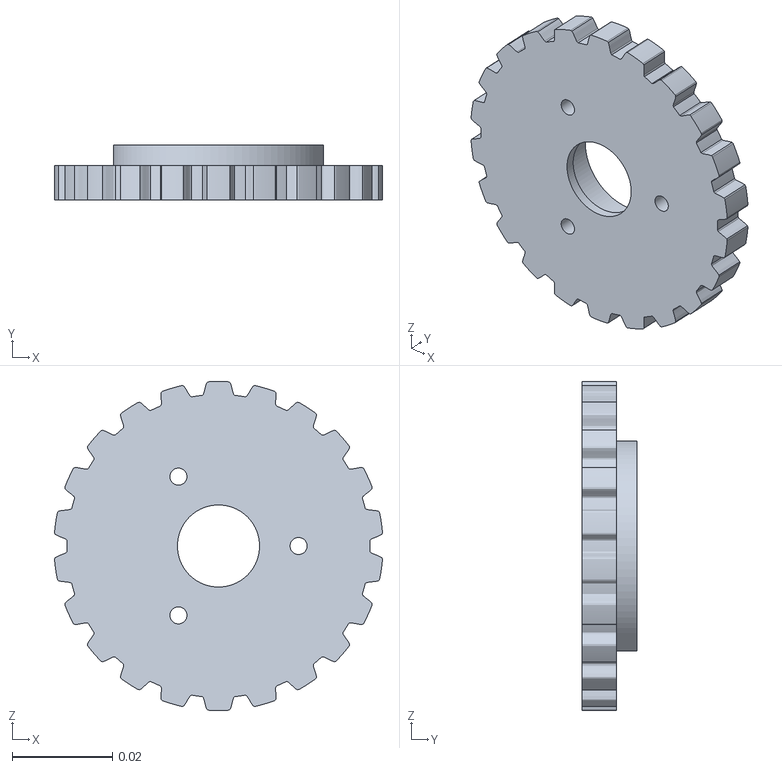
[picture p36: CAD file, 2026-10-26]
simulation/mujoco/model/meshes/Right_22T_idler_wheel_outer_half_R13.stl
0.0655 x 0.0109 x 0.0657
