metrox-eth/moss/simulation/mujoco/model/meshes/collision/part_0291_056.stl

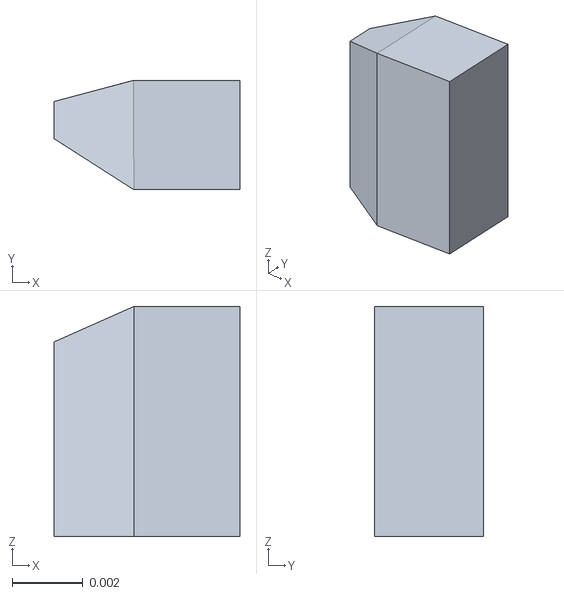
[picture p37: CAD file, 2026-10-26]
simulation/mujoco/model/meshes/collision/part_0291_056.stl
0.00525 x 0.00309 x 0.00649
