metrox-eth/moss/simulation/mujoco/model/meshes/Right_Spacer_tensioner_center.stl

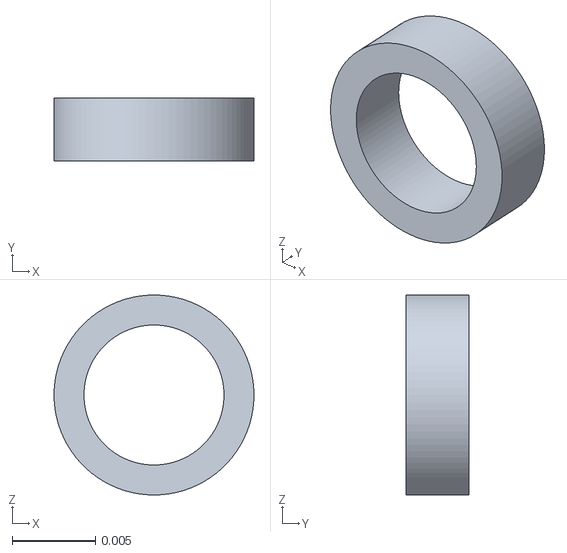
[picture p38: CAD file, 2026-10-26]
simulation/mujoco/model/meshes/Right_Spacer_tensioner_center.stl
0.012 x 0.0038 x 0.012
