metrox-eth/moss/simulation/mujoco/model/meshes/collision/part_0320_044.stl

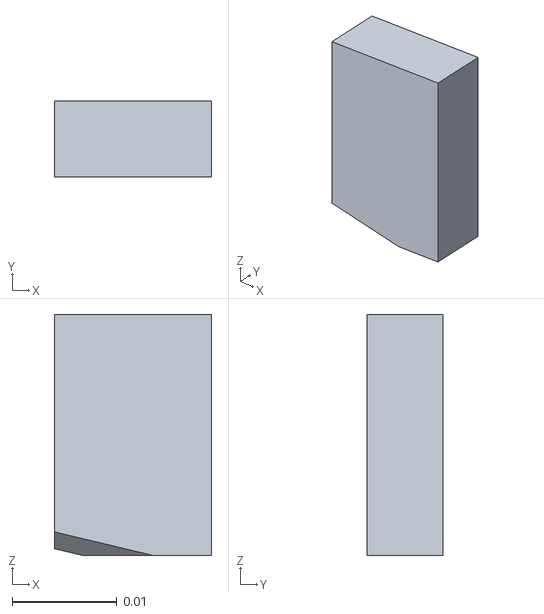
[picture p39: CAD file, 2026-10-26]
simulation/mujoco/model/meshes/collision/part_0320_044.stl
0.015 x 0.00727 x 0.0231
