metrox-eth/moss/simulation/mujoco/model/meshes/14_Bin_20x10x2_magnet_pockets.stl

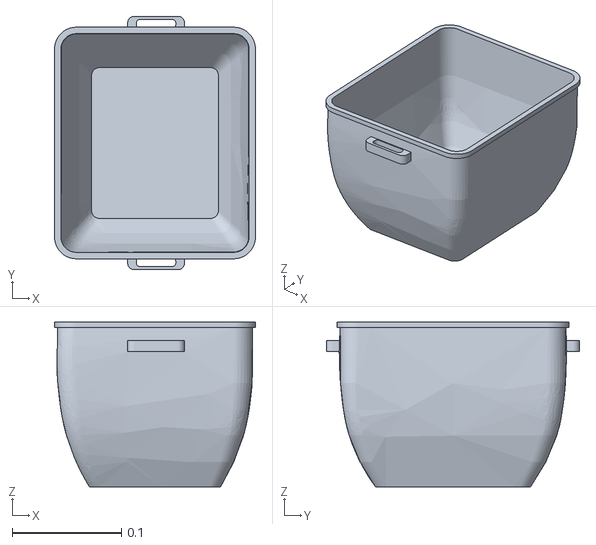
[picture p40: CAD file, 2026-10-26]
simulation/mujoco/model/meshes/14_Bin_20x10x2_magnet_pockets.stl
0.184 x 0.232 x 0.151
