metrox-eth/moss/simulation/mujoco/model/meshes/collision/part_0318_061.stl

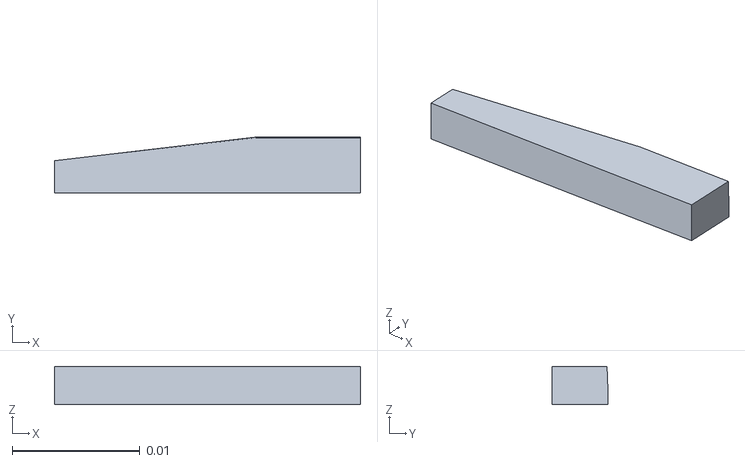
[picture p41: CAD file, 2026-10-26]
simulation/mujoco/model/meshes/collision/part_0318_061.stl
0.024 x 0.0044 x 0.00302
