metrox-eth/moss/simulation/mujoco/model/meshes/collision/part_0284_040.stl

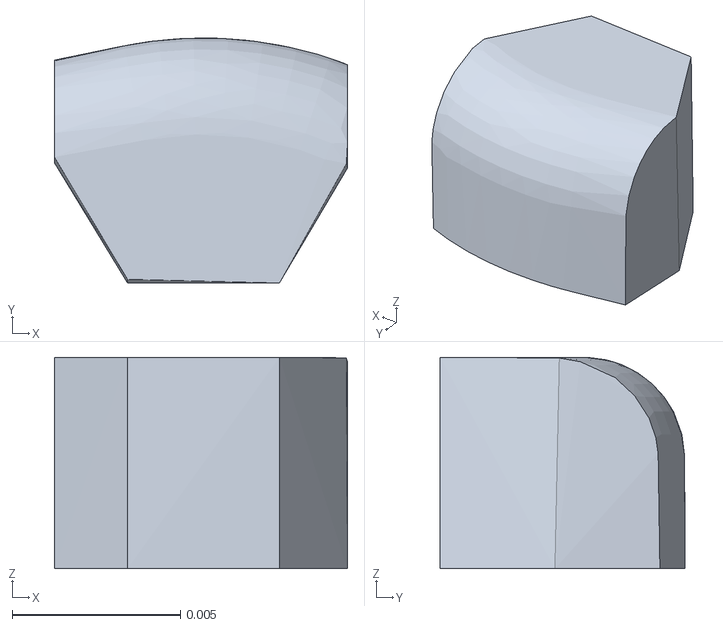
[picture p42: CAD file, 2026-10-26]
simulation/mujoco/model/meshes/collision/part_0284_040.stl
0.00871 x 0.00728 x 0.00629
