metrox-eth/moss/simulation/mujoco/model/meshes/Right_inner_tensioner_cover_R12_C2.stl

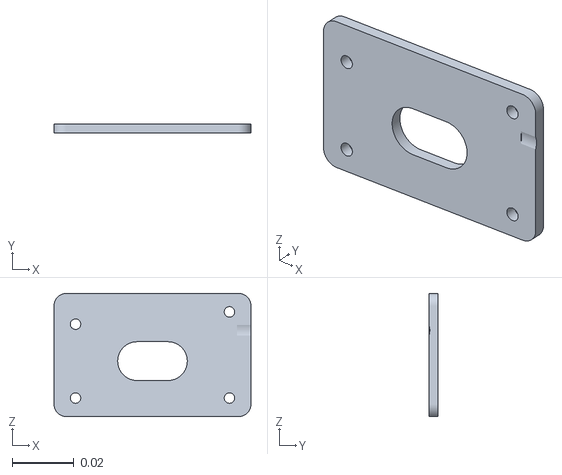
[picture p43: CAD file, 2026-10-26]
simulation/mujoco/model/meshes/Right_inner_tensioner_cover_R12_C2.stl
0.064 x 0.003 x 0.04
