metrox-eth/moss/simulation/mujoco/model/meshes/06_Right_bearing_retainer.stl

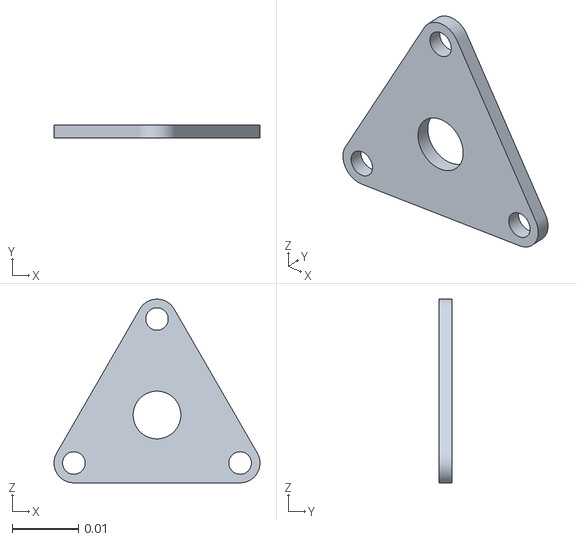
[picture p44: CAD file, 2026-10-26]
simulation/mujoco/model/meshes/06_Right_bearing_retainer.stl
0.0311 x 0.002 x 0.0278
