metrox-eth/moss/simulation/mujoco/model/meshes/collision/part_0291_032.stl

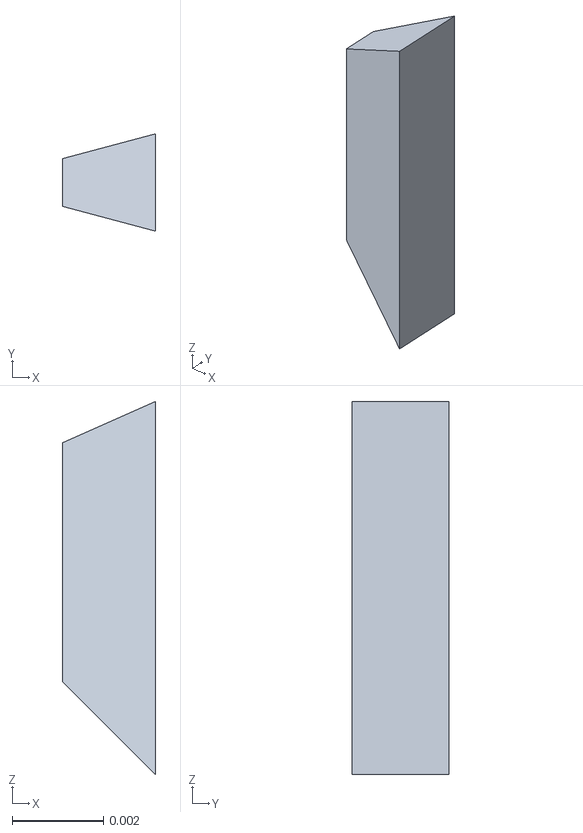
[picture p45: CAD file, 2026-10-26]
simulation/mujoco/model/meshes/collision/part_0291_032.stl
0.00204 x 0.00214 x 0.00819
