metrox-eth/moss/simulation/mujoco/model/meshes/collision/part_1005_038.stl

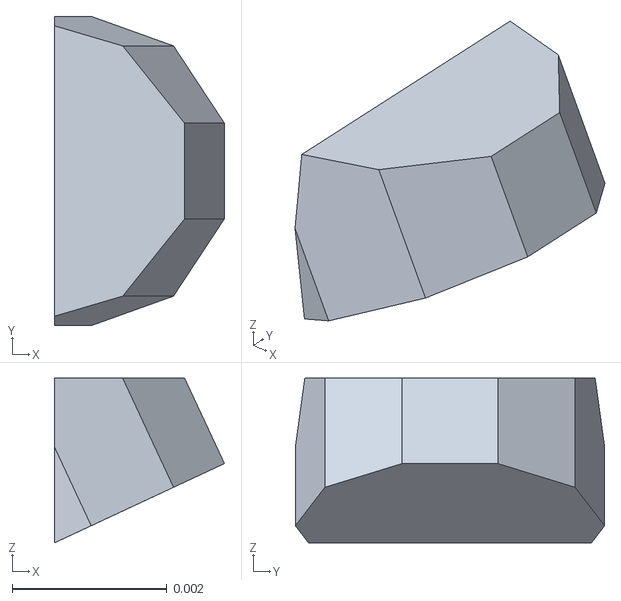
[picture p46: CAD file, 2026-10-26]
simulation/mujoco/model/meshes/collision/part_1005_038.stl
0.0022 x 0.004 x 0.00213
