metrox-eth/moss/simulation/mujoco/model/meshes/Right_Spacer_tensioner_inner_ID05_R24.stl

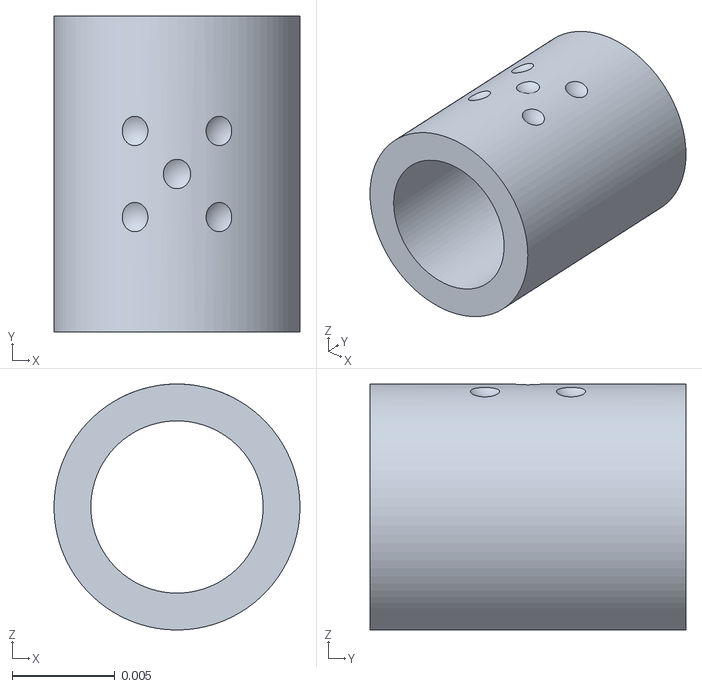
[picture p47: CAD file, 2026-10-26]
simulation/mujoco/model/meshes/Right_Spacer_tensioner_inner_ID05_R24.stl
0.012 x 0.0154 x 0.012
