metrox-eth/moss/simulation/mujoco/model/meshes/collision/bin_026.stl

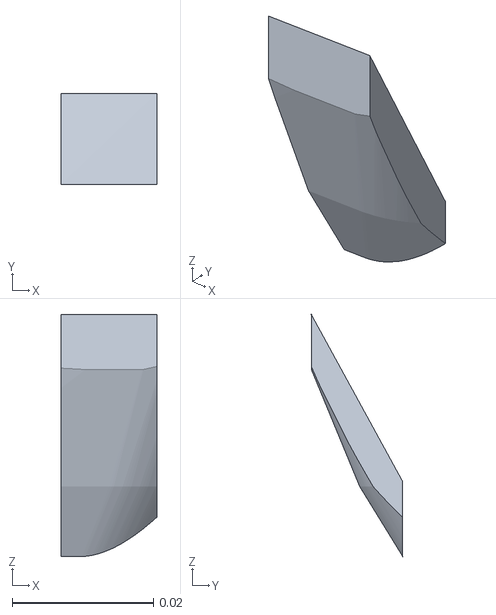
[picture p48: CAD file, 2026-10-26]
simulation/mujoco/model/meshes/collision/bin_026.stl
0.0135 x 0.0129 x 0.0343
