metrox-eth/moss/simulation/mujoco/model/meshes/SO101_Base.stl

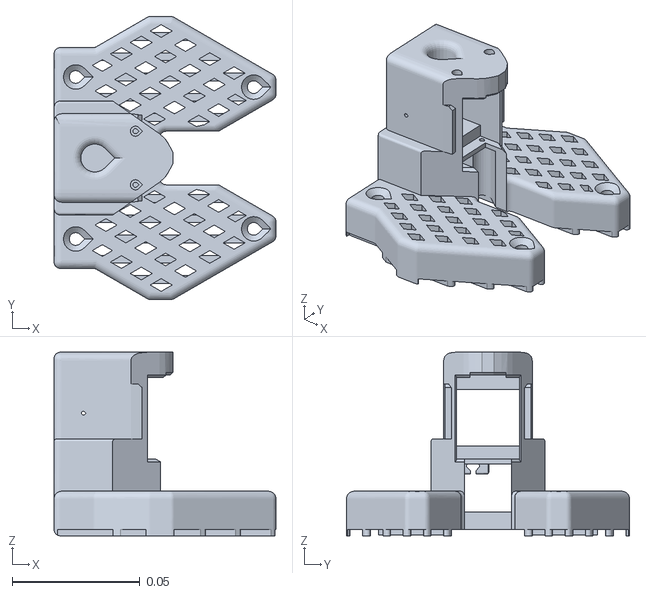
[picture p49: CAD file, 2026-10-26]
simulation/mujoco/model/meshes/SO101_Base.stl
0.087 x 0.111 x 0.072
