metrox-eth/moss/simulation/mujoco/model/meshes/collision/part_0291_062.stl

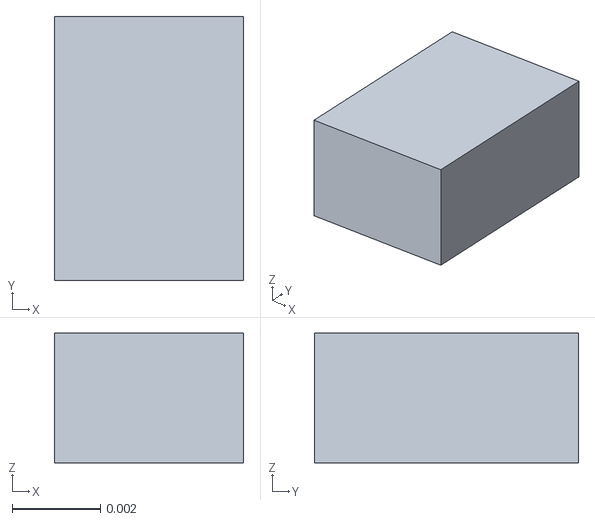
[picture p50: CAD file, 2026-10-26]
simulation/mujoco/model/meshes/collision/part_0291_062.stl
0.00428 x 0.00598 x 0.00294
