metrox-eth/moss/simulation/mujoco/model/meshes/collision/part_0319_002.stl

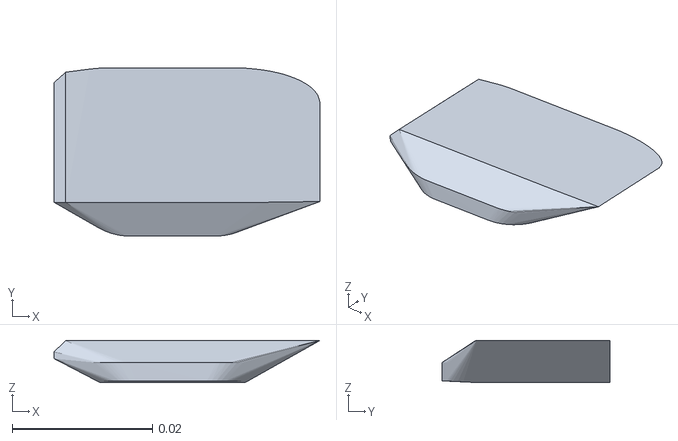
[picture p51: CAD file, 2026-10-26]
simulation/mujoco/model/meshes/collision/part_0319_002.stl
0.038 x 0.024 x 0.006
