metrox-eth/moss/simulation/mujoco/model/meshes/NC90_Left_side_shield.stl

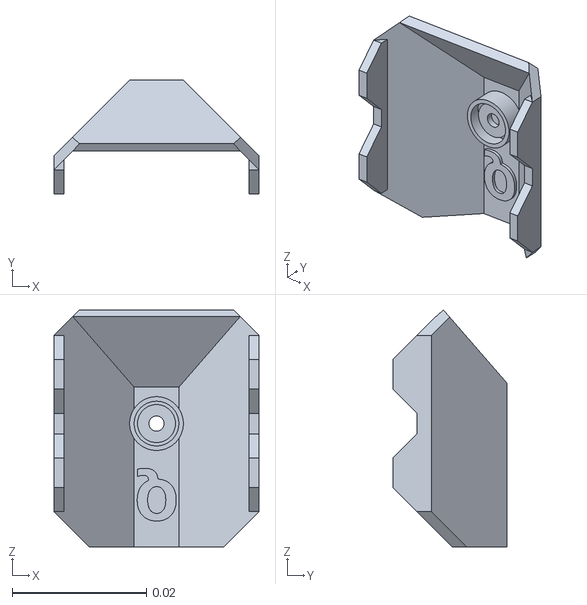
[picture p52: CAD file, 2026-10-26]
simulation/mujoco/model/meshes/NC90_Left_side_shield.stl
0.0305 x 0.017 x 0.0353
