metrox-eth/moss/simulation/mujoco/model/meshes/collision/part_1005_012.stl

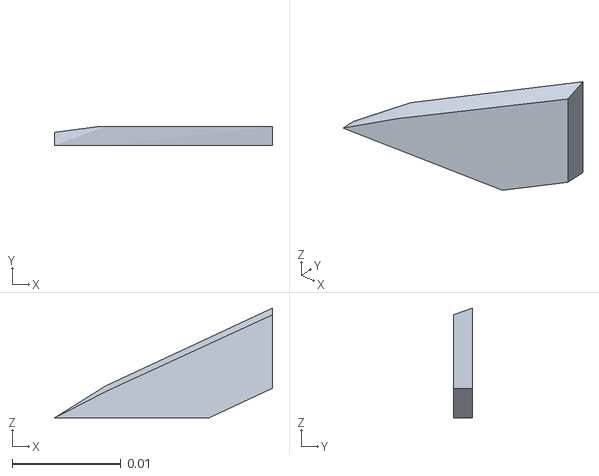
[picture p53: CAD file, 2026-10-26]
simulation/mujoco/model/meshes/collision/part_1005_012.stl
0.02 x 0.00173 x 0.0101
