metrox-eth/moss/simulation/mujoco/model/meshes/NC90_Cable_guide.stl

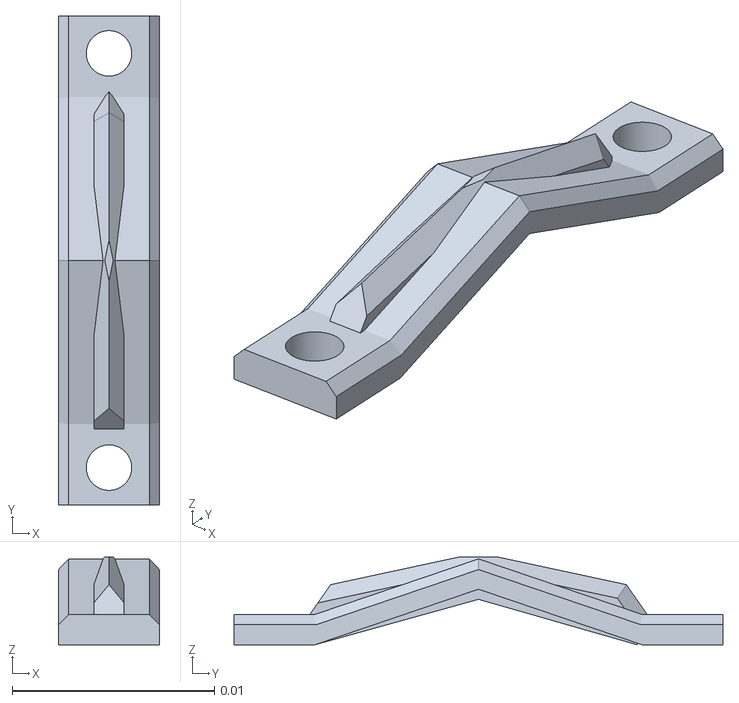
[picture p54: CAD file, 2026-10-26]
simulation/mujoco/model/meshes/NC90_Cable_guide.stl
0.005 x 0.0242 x 0.00433
