metrox-eth/moss/simulation/mujoco/model/meshes/collision/part_0291_029.stl

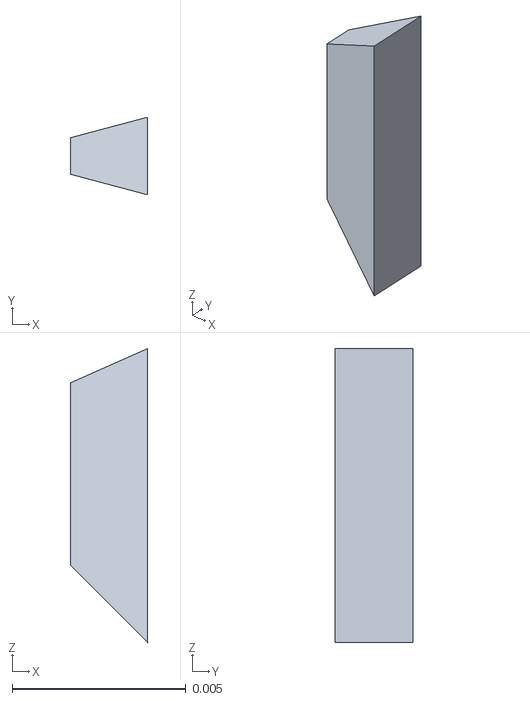
[picture p55: CAD file, 2026-10-26]
simulation/mujoco/model/meshes/collision/part_0291_029.stl
0.00223 x 0.00224 x 0.00847
