metrox-eth/moss/simulation/mujoco/model/meshes/NC90_Right_jaw_extended_rack.stl

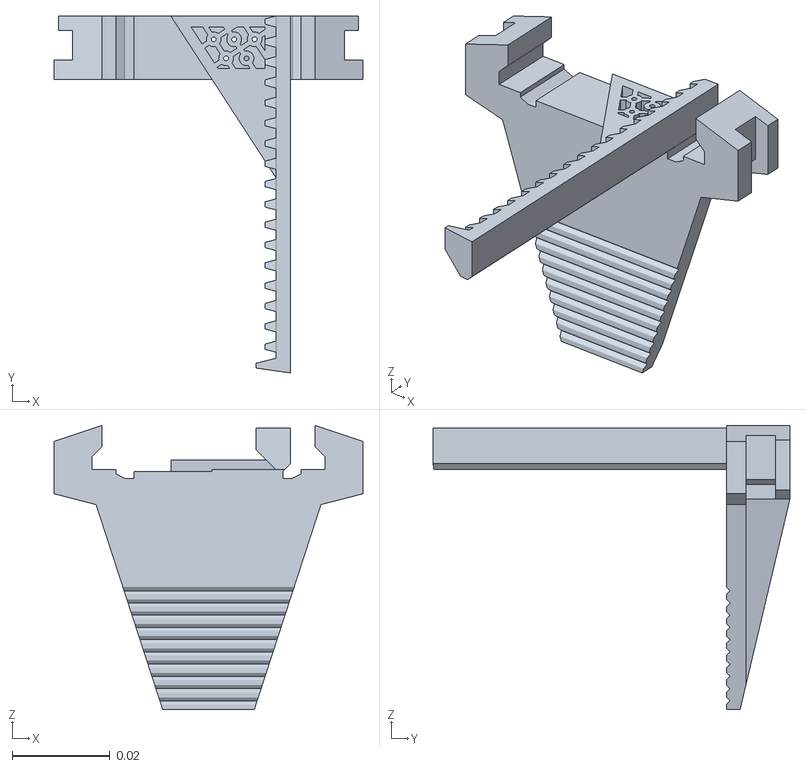
[picture p56: CAD file, 2026-10-26]
simulation/mujoco/model/meshes/NC90_Right_jaw_extended_rack.stl
0.0631 x 0.0729 x 0.058
