metrox-eth/moss/simulation/mujoco/model/meshes/collision/part_0286_014.stl

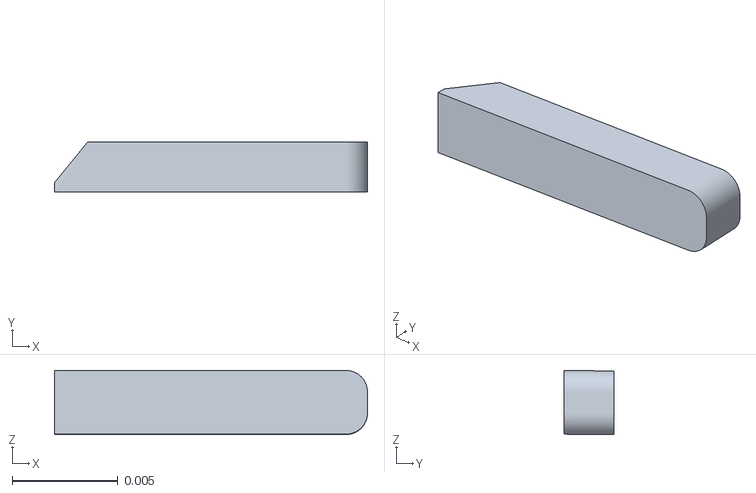
[picture p57: CAD file, 2026-10-26]
simulation/mujoco/model/meshes/collision/part_0286_014.stl
0.0148 x 0.00236 x 0.00302
