metrox-eth/moss/simulation/mujoco/model/meshes/Left_inner_tensioner_slider.stl

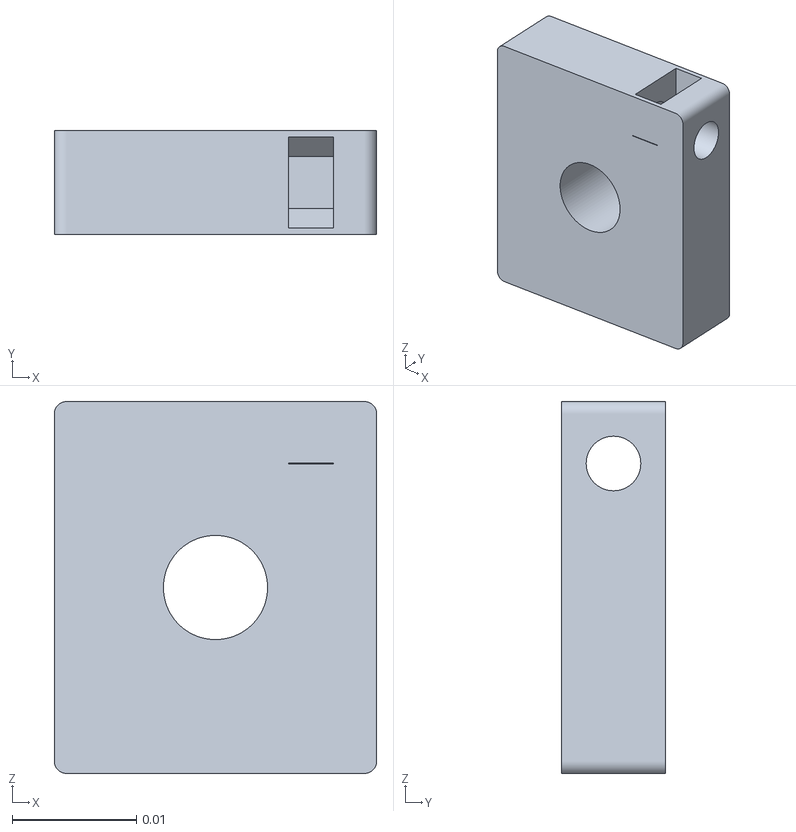
[picture p58: CAD file, 2026-10-26]
simulation/mujoco/model/meshes/Left_inner_tensioner_slider.stl
0.026 x 0.0084 x 0.03
