metrox-eth/moss/simulation/mujoco/model/meshes/collision/part_1005_034.stl

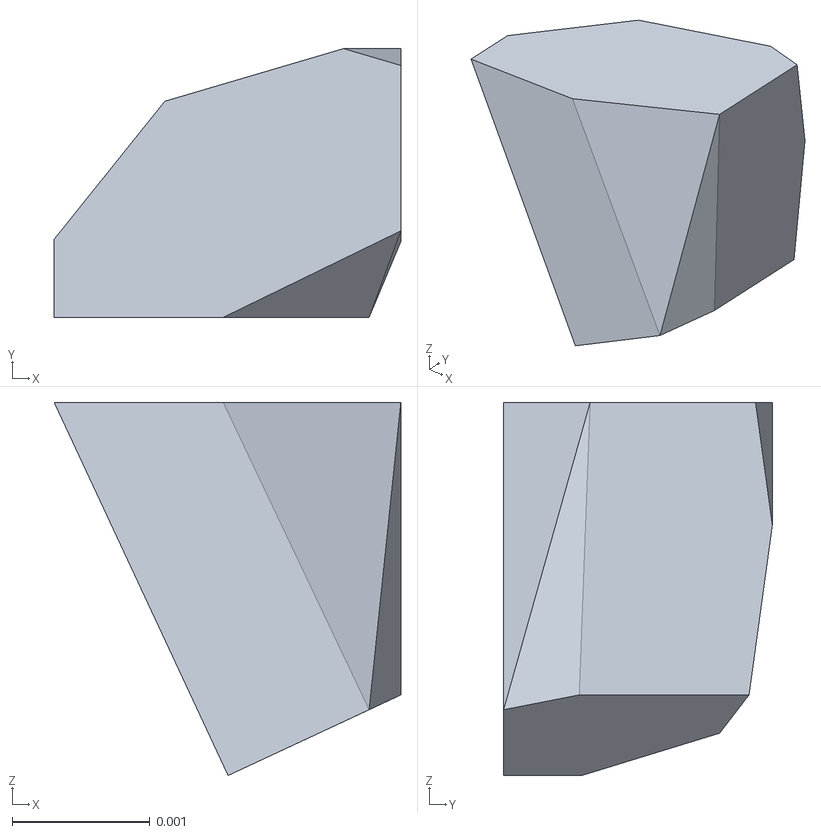
[picture p59: CAD file, 2026-10-26]
simulation/mujoco/model/meshes/collision/part_1005_034.stl
0.00251 x 0.00195 x 0.0027
