metrox-eth/moss/simulation/mujoco/model/meshes/Left_Cover_motor_bearing.stl

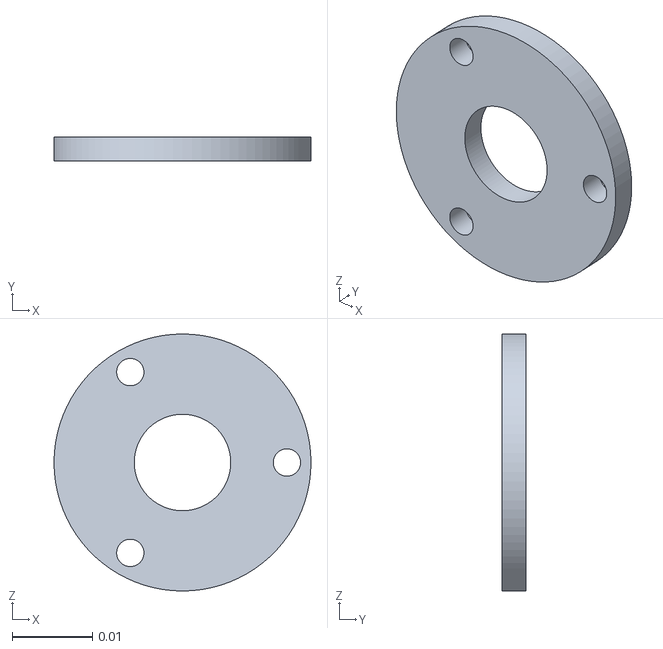
[picture p60: CAD file, 2026-10-26]
simulation/mujoco/model/meshes/Left_Cover_motor_bearing.stl
0.032 x 0.003 x 0.032
