metrox-eth/moss/simulation/mujoco/model/meshes/collision/part_0290_024.stl

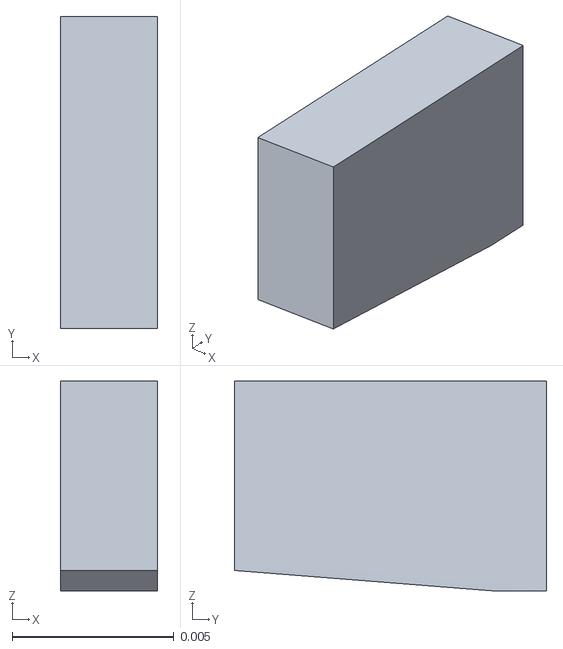
[picture p61: CAD file, 2026-10-26]
simulation/mujoco/model/meshes/collision/part_0290_024.stl
0.00301 x 0.00966 x 0.00649
