metrox-eth/moss/simulation/mujoco/model/meshes/Left_Spacer_drive_inner_ID03_R24.stl

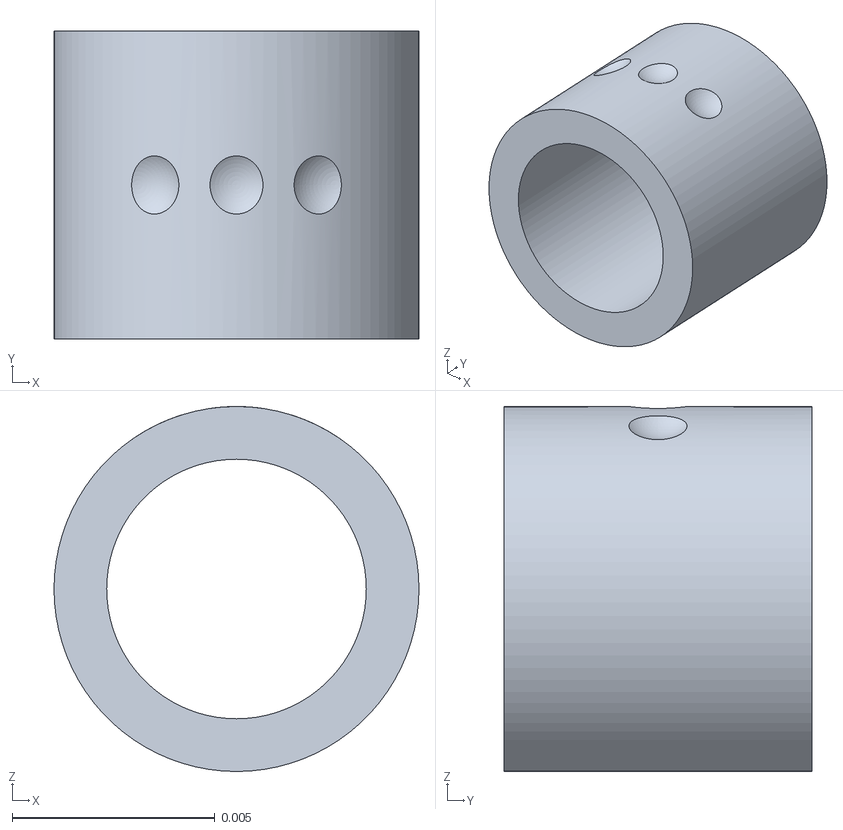
[picture p62: CAD file, 2026-10-26]
simulation/mujoco/model/meshes/Left_Spacer_drive_inner_ID03_R24.stl
0.009 x 0.0076 x 0.009
