metrox-eth/moss/simulation/mujoco/model/meshes/collision/part_0290_002.stl

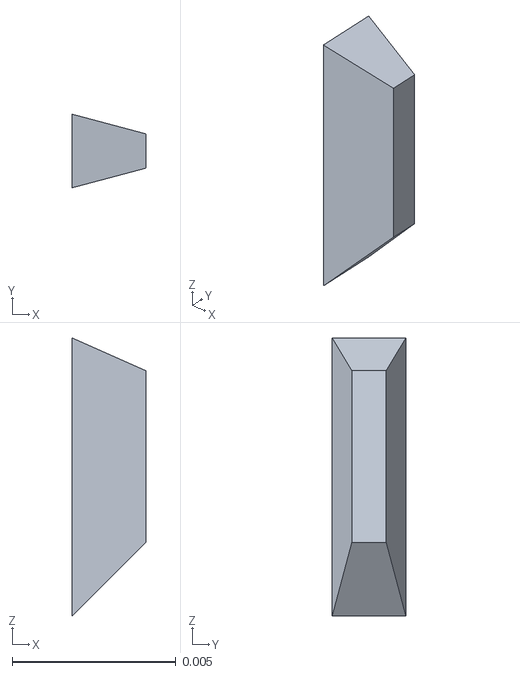
[picture p63: CAD file, 2026-10-26]
simulation/mujoco/model/meshes/collision/part_0290_002.stl
0.00225 x 0.00225 x 0.0085
