metrox-eth/moss/simulation/mujoco/model/meshes/Upper_cover_R9.stl

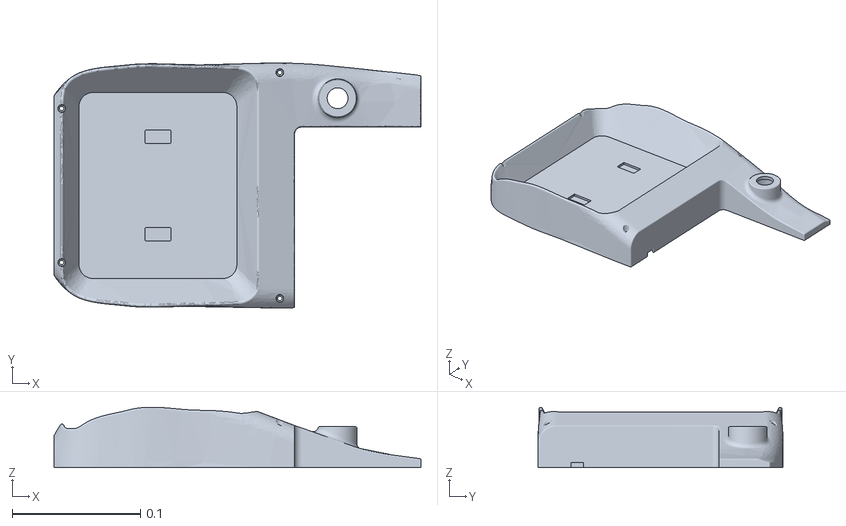
[picture p64: CAD file, 2026-10-26]
simulation/mujoco/model/meshes/Upper_cover_R9.stl
0.286 x 0.191 x 0.0471
