metrox-eth/moss/simulation/mujoco/model/meshes/collision/part_0290_006.stl

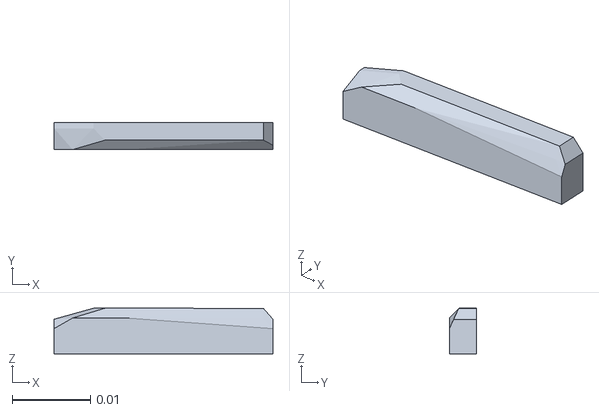
[picture p65: CAD file, 2026-10-26]
simulation/mujoco/model/meshes/collision/part_0290_006.stl
0.0279 x 0.00347 x 0.00581
