metrox-eth/moss/simulation/mujoco/model/meshes/Left_22T_idler_wheel_inner_half_R13.stl

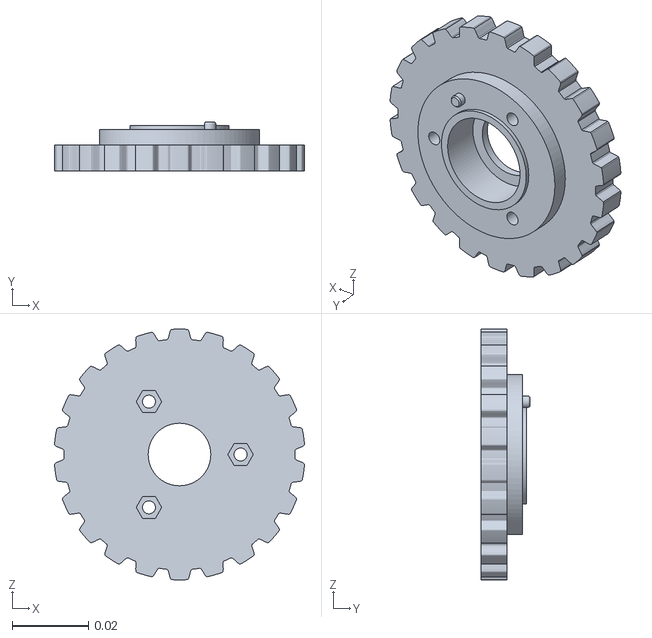
[picture p66: CAD file, 2026-10-26]
simulation/mujoco/model/meshes/Left_22T_idler_wheel_inner_half_R13.stl
0.0655 x 0.0129 x 0.0657
