metrox-eth/moss/simulation/mujoco/model/meshes/Arm_Mounting_Platform_R22.stl

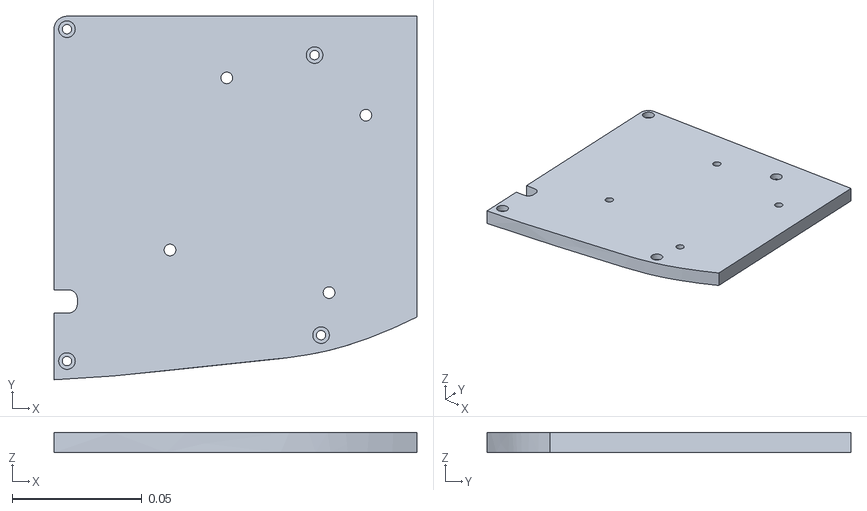
[picture p67: CAD file, 2026-10-26]
simulation/mujoco/model/meshes/Arm_Mounting_Platform_R22.stl
0.14 x 0.14 x 0.0078
