metrox-eth/moss/simulation/mujoco/model/meshes/collision/part_0318_024.stl

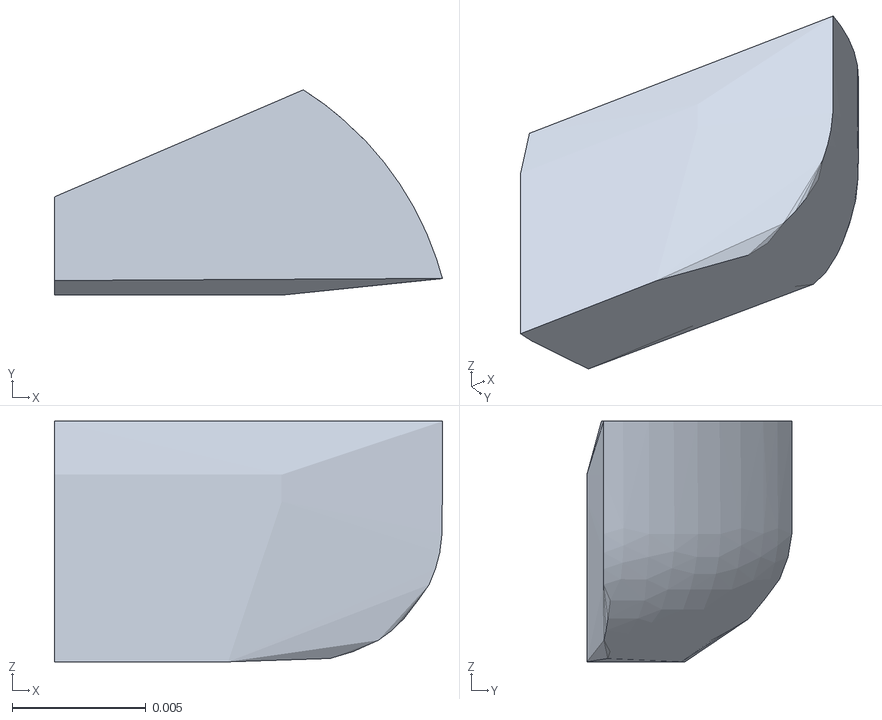
[picture p68: CAD file, 2026-10-26]
simulation/mujoco/model/meshes/collision/part_0318_024.stl
0.0145 x 0.00768 x 0.009
