metrox-eth/moss/simulation/mujoco/model/meshes/collision/part_0291_023.stl

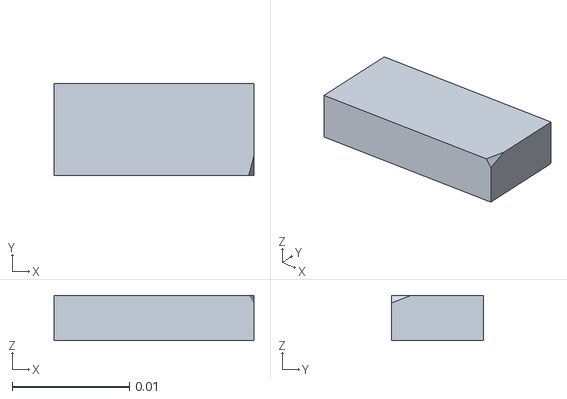
[picture p69: CAD file, 2026-10-26]
simulation/mujoco/model/meshes/collision/part_0291_023.stl
0.017 x 0.00787 x 0.00386
