metrox-eth/moss/simulation/mujoco/model/meshes/collision/part_0290_019.stl

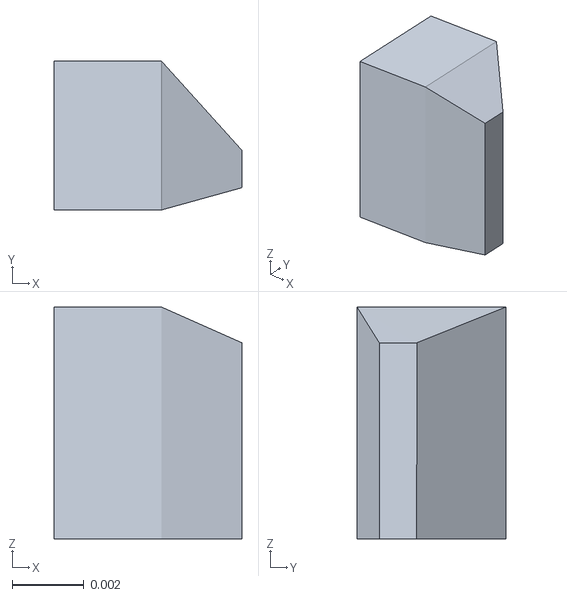
[picture p70: CAD file, 2026-10-26]
simulation/mujoco/model/meshes/collision/part_0290_019.stl
0.00525 x 0.00417 x 0.00649
