metrox-eth/moss/simulation/mujoco/model/meshes/Left_625_road_wheel_-70_outer_half_R13.stl

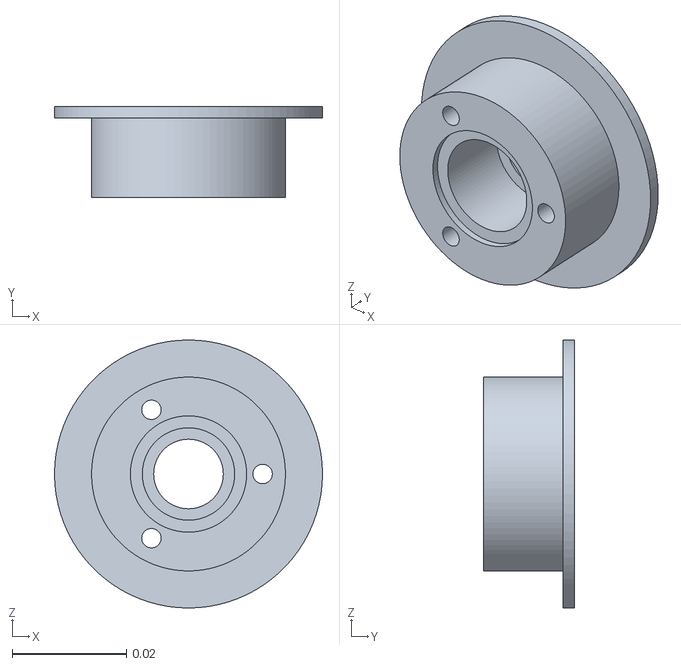
[picture p71: CAD file, 2026-10-26]
simulation/mujoco/model/meshes/Left_625_road_wheel_-70_outer_half_R13.stl
0.047 x 0.016 x 0.047
