metrox-eth/moss/simulation/mujoco/model/meshes/collision/part_0321_054.stl

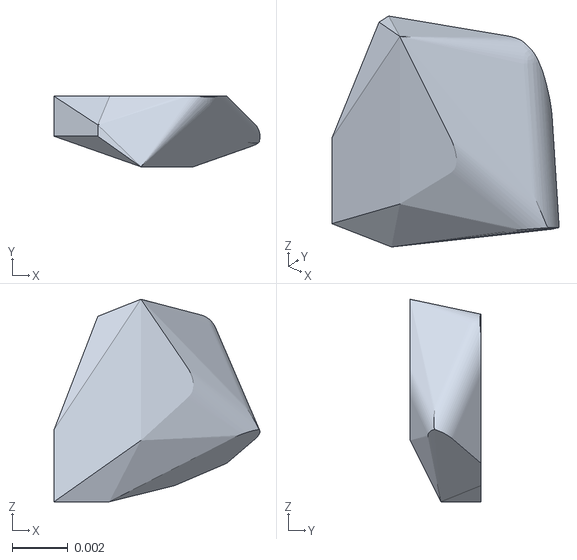
[picture p72: CAD file, 2026-10-26]
simulation/mujoco/model/meshes/collision/part_0321_054.stl
0.00738 x 0.00253 x 0.00726
