metrox-eth/moss/simulation/mujoco/model/meshes/Lidar_dovetail_carriage_R21.stl

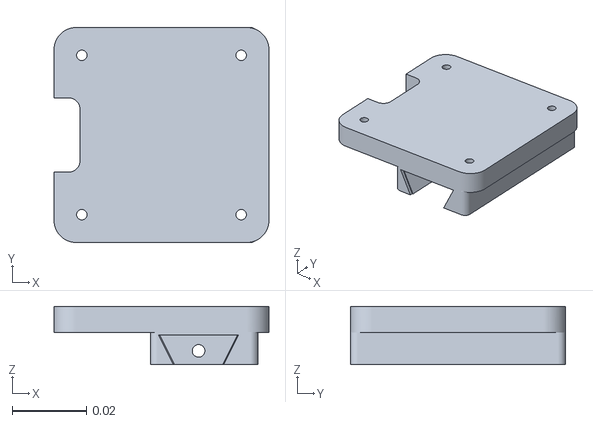
[picture p73: CAD file, 2026-10-26]
simulation/mujoco/model/meshes/Lidar_dovetail_carriage_R21.stl
0.058 x 0.058 x 0.0157
