metrox-eth/moss/simulation/mujoco/model/meshes/collision/part_0279.stl

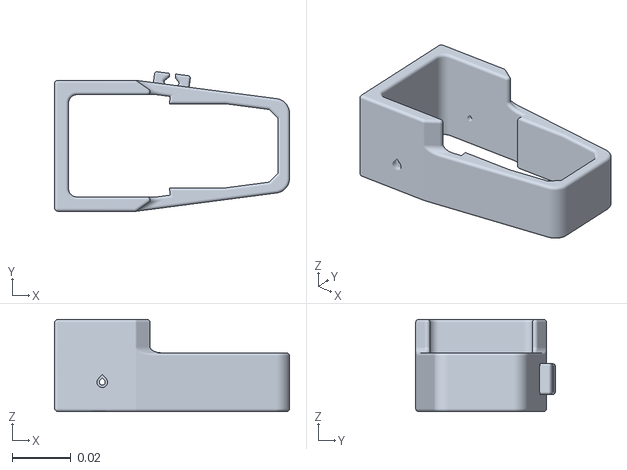
[picture p74: CAD file, 2026-10-26]
simulation/mujoco/model/meshes/collision/part_0279.stl
0.0802 x 0.0476 x 0.0314
