metrox-eth/moss/simulation/mujoco/model/meshes/Left_Spacer_drive_outer_HEX12_L12.6_ID04_R24.stl

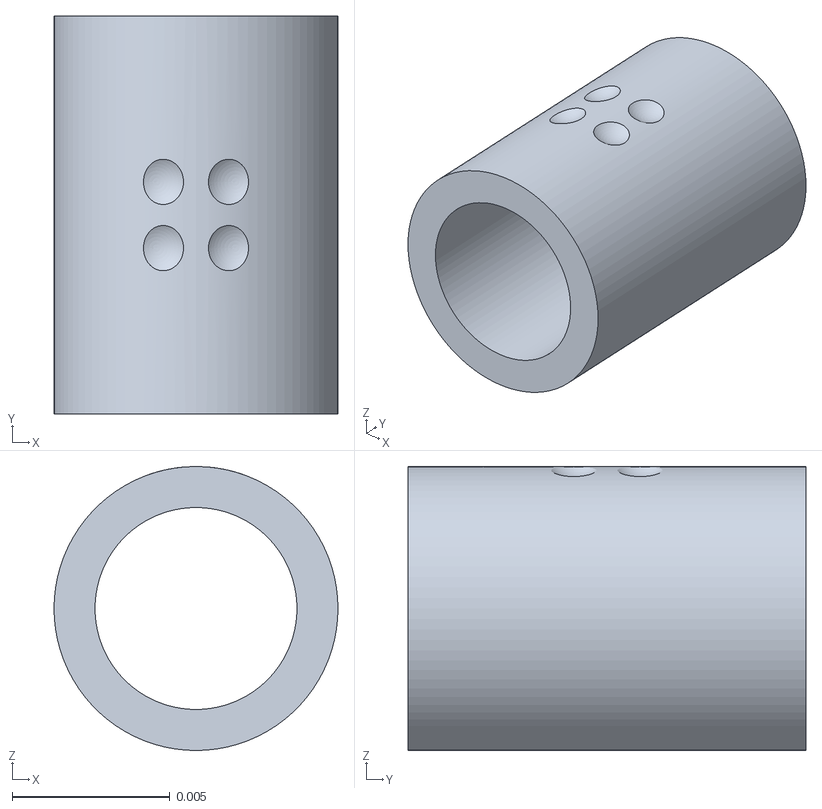
[picture p75: CAD file, 2026-10-26]
simulation/mujoco/model/meshes/Left_Spacer_drive_outer_HEX12_L12.6_ID04_R24.stl
0.009 x 0.0126 x 0.009
