metrox-eth/moss/simulation/mujoco/model/meshes/collision/part_0318_044.stl

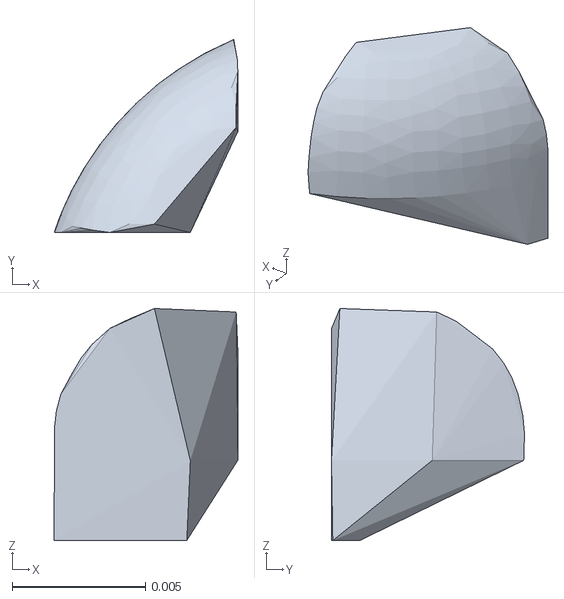
[picture p76: CAD file, 2026-10-26]
simulation/mujoco/model/meshes/collision/part_0318_044.stl
0.0069 x 0.00725 x 0.00871
