metrox-eth/moss/simulation/mujoco/model/meshes/collision/part_0286_038.stl

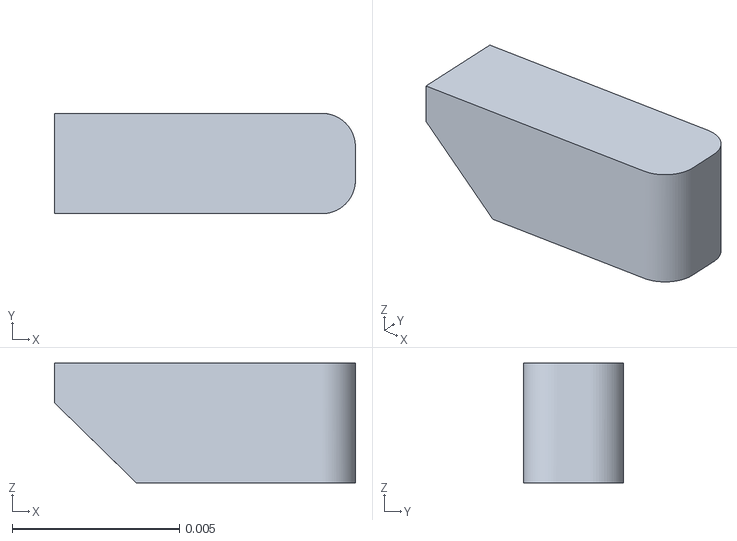
[picture p77: CAD file, 2026-10-26]
simulation/mujoco/model/meshes/collision/part_0286_038.stl
0.00899 x 0.003 x 0.00358
