metrox-eth/moss/simulation/mujoco/model/meshes/Servo_housing_part_0287.stl

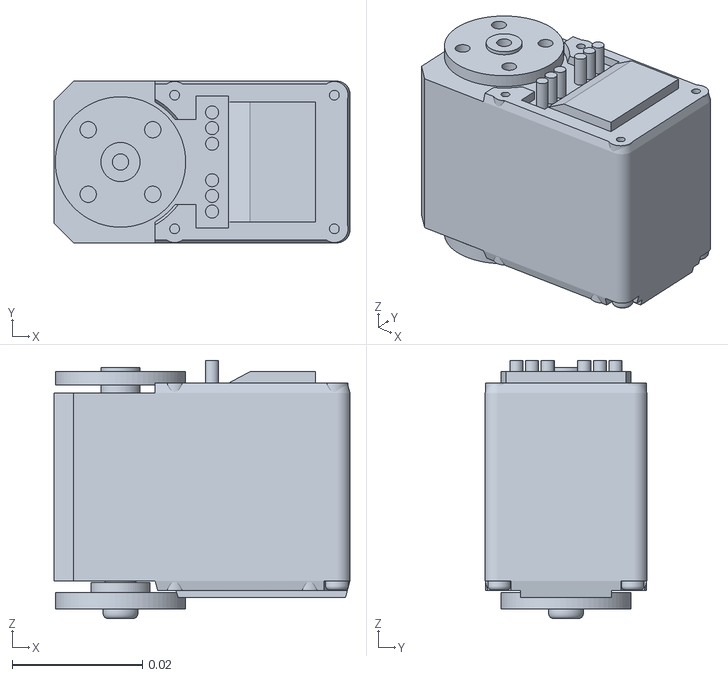
[picture p78: CAD file, 2026-10-26]
simulation/mujoco/model/meshes/Servo_housing_part_0287.stl
0.0454 x 0.0248 x 0.0396
