metrox-eth/moss/simulation/mujoco/model/meshes/collision/part_1005_029.stl

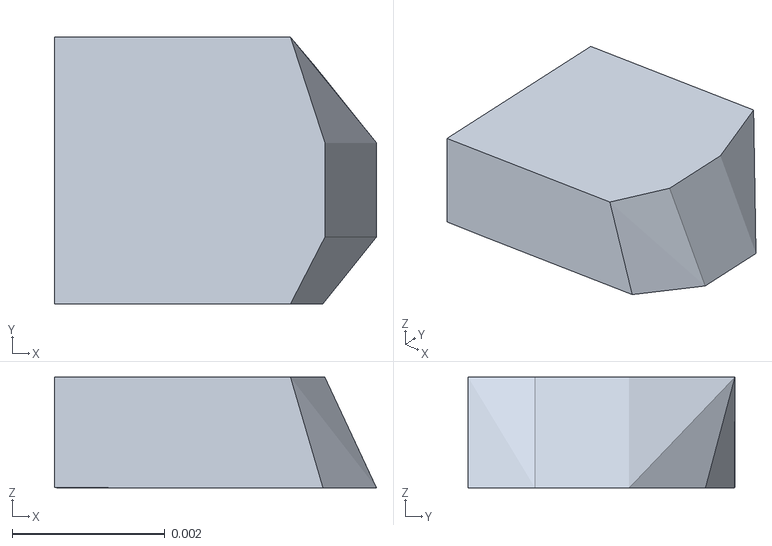
[picture p79: CAD file, 2026-10-26]
simulation/mujoco/model/meshes/collision/part_1005_029.stl
0.00422 x 0.0035 x 0.00145
