metrox-eth/moss/simulation/mujoco/model/meshes/Motor_Mount_Right_R90.stl

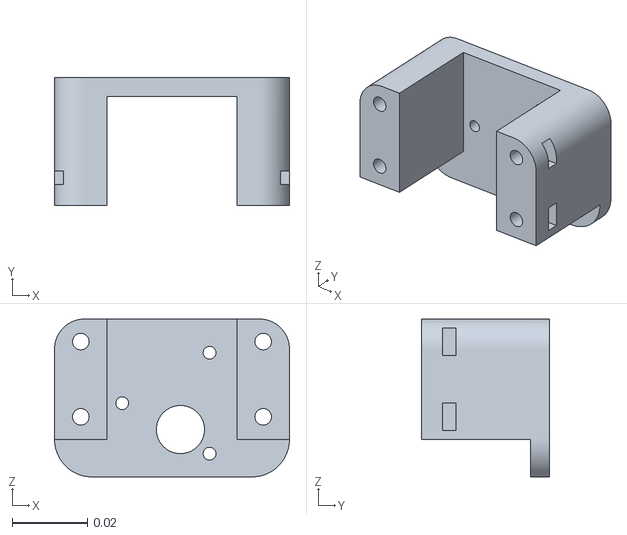
[picture p80: CAD file, 2026-10-26]
simulation/mujoco/model/meshes/Motor_Mount_Right_R90.stl
0.0625 x 0.034 x 0.042
