metrox-eth/moss/simulation/mujoco/model/meshes/collision/part_0321_047.stl

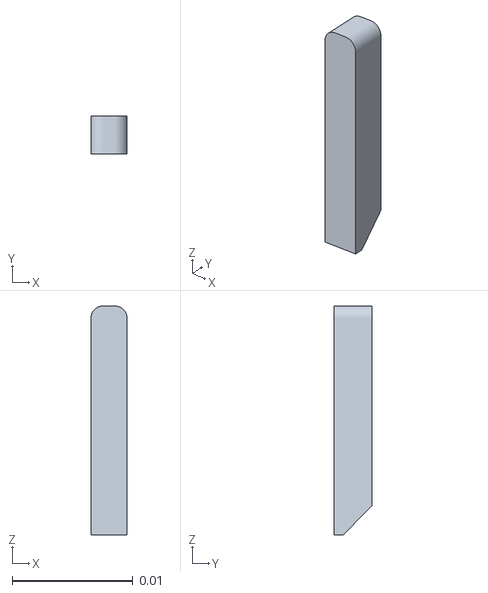
[picture p81: CAD file, 2026-10-26]
simulation/mujoco/model/meshes/collision/part_0321_047.stl
0.003 x 0.00318 x 0.019
