metrox-eth/moss/simulation/mujoco/model/meshes/Left_Drive_bearing_to_collar_spacer_R12_C1.stl

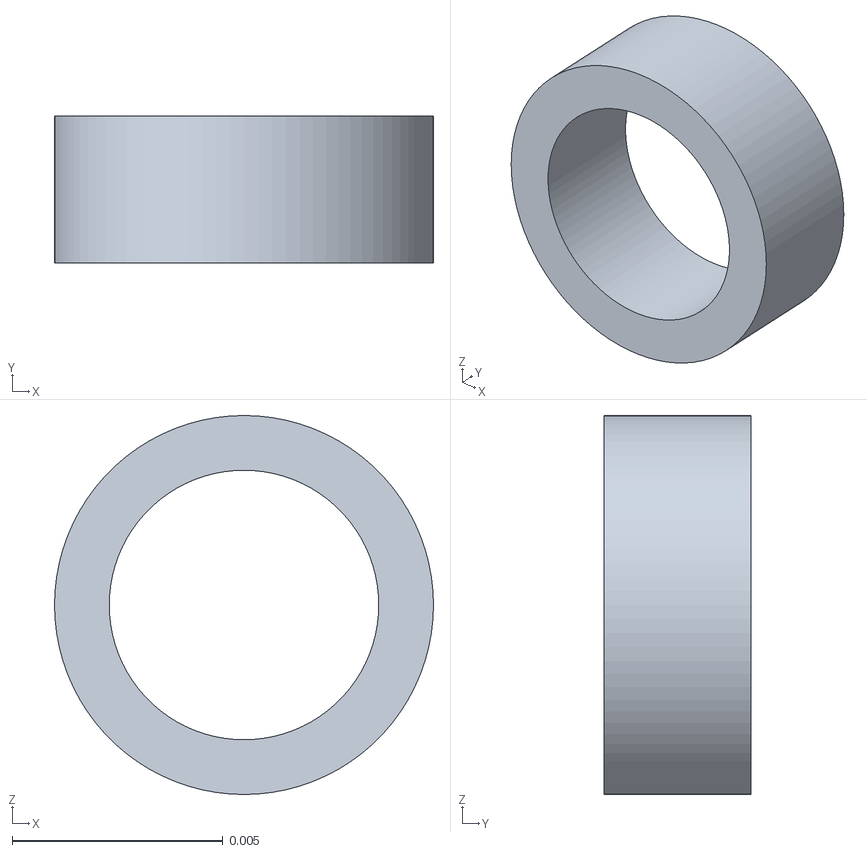
[picture p82: CAD file, 2026-10-26]
simulation/mujoco/model/meshes/Left_Drive_bearing_to_collar_spacer_R12_C1.stl
0.009 x 0.0035 x 0.009
