metrox-eth/moss/simulation/mujoco/model/meshes/collision/part_0318_058.stl

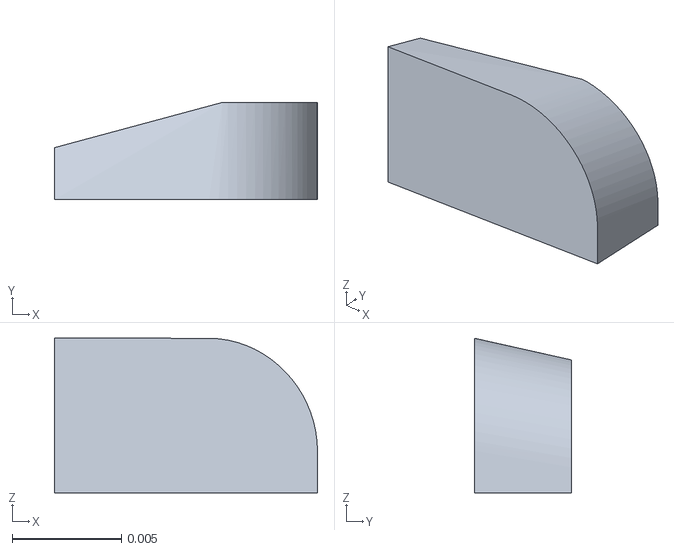
[picture p83: CAD file, 2026-10-26]
simulation/mujoco/model/meshes/collision/part_0318_058.stl
0.012 x 0.00445 x 0.00708
