metrox-eth/moss/simulation/mujoco/model/meshes/collision/part_1005_048.stl

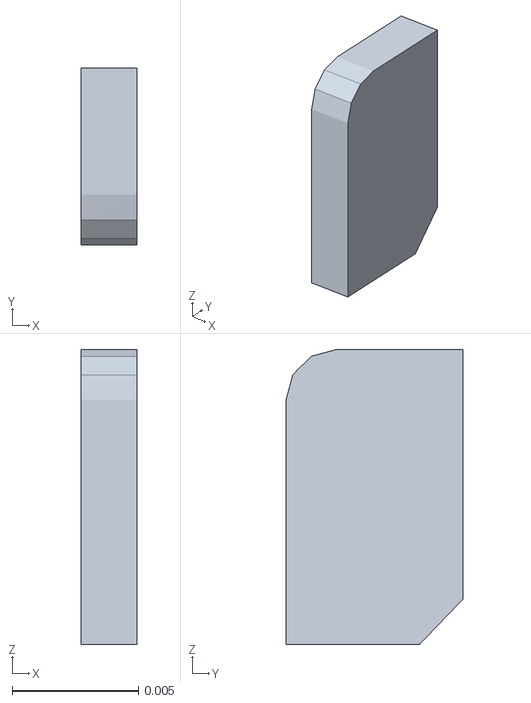
[picture p84: CAD file, 2026-10-26]
simulation/mujoco/model/meshes/collision/part_1005_048.stl
0.00222 x 0.00701 x 0.0117
