metrox-eth/moss/simulation/mujoco/model/meshes/Left_Spacer_road_wheel_0_inner_ID01_R24.stl

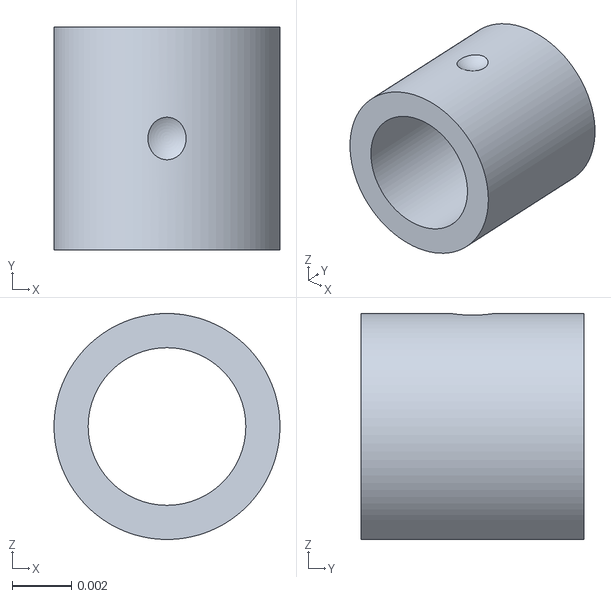
[picture p85: CAD file, 2026-10-26]
simulation/mujoco/model/meshes/Left_Spacer_road_wheel_0_inner_ID01_R24.stl
0.0076 x 0.0075 x 0.0076
