metrox-eth/moss/simulation/mujoco/model/meshes/collision/part_0320_052.stl

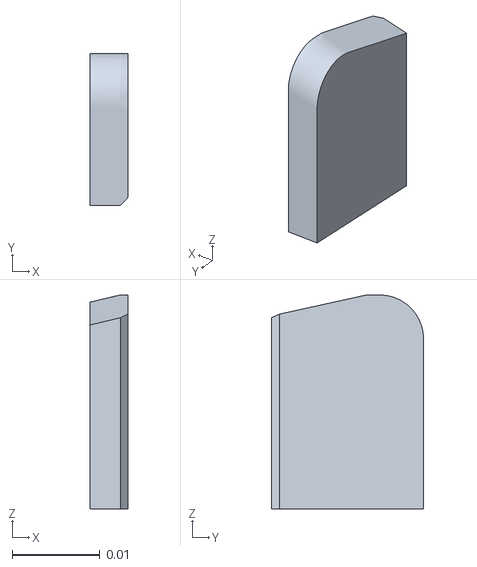
[picture p86: CAD file, 2026-10-26]
simulation/mujoco/model/meshes/collision/part_0320_052.stl
0.00435 x 0.0173 x 0.0244
