metrox-eth/moss/simulation/mujoco/model/meshes/collision/part_0286_009.stl

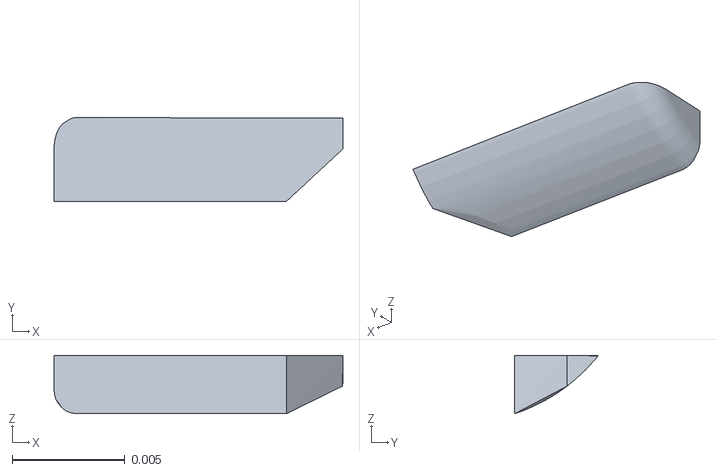
[picture p87: CAD file, 2026-10-26]
simulation/mujoco/model/meshes/collision/part_0286_009.stl
0.0128 x 0.00371 x 0.00259
