metrox-eth/moss/simulation/mujoco/model/meshes/Servo_housing_part_0288.stl

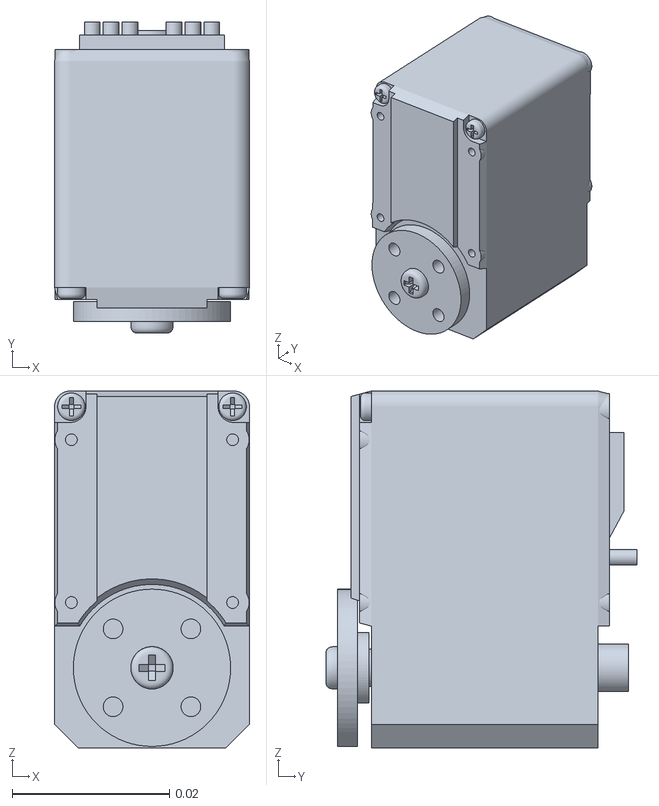
[picture p88: CAD file, 2026-10-26]
simulation/mujoco/model/meshes/Servo_housing_part_0288.stl
0.0248 x 0.0396 x 0.0454
