metrox-eth/moss/simulation/mujoco/model/meshes/collision/part_0284_030.stl

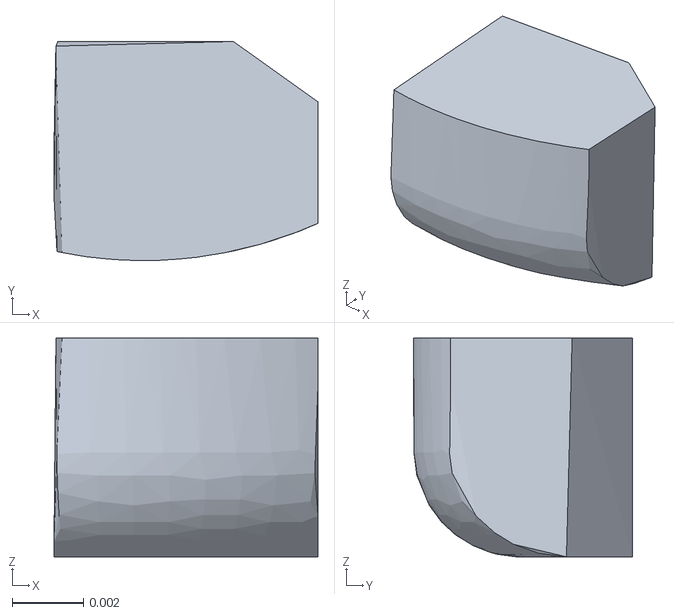
[picture p89: CAD file, 2026-10-26]
simulation/mujoco/model/meshes/collision/part_0284_030.stl
0.0074 x 0.00614 x 0.00614
