metrox-eth/moss/simulation/mujoco/model/meshes/collision/part_0286_044.stl

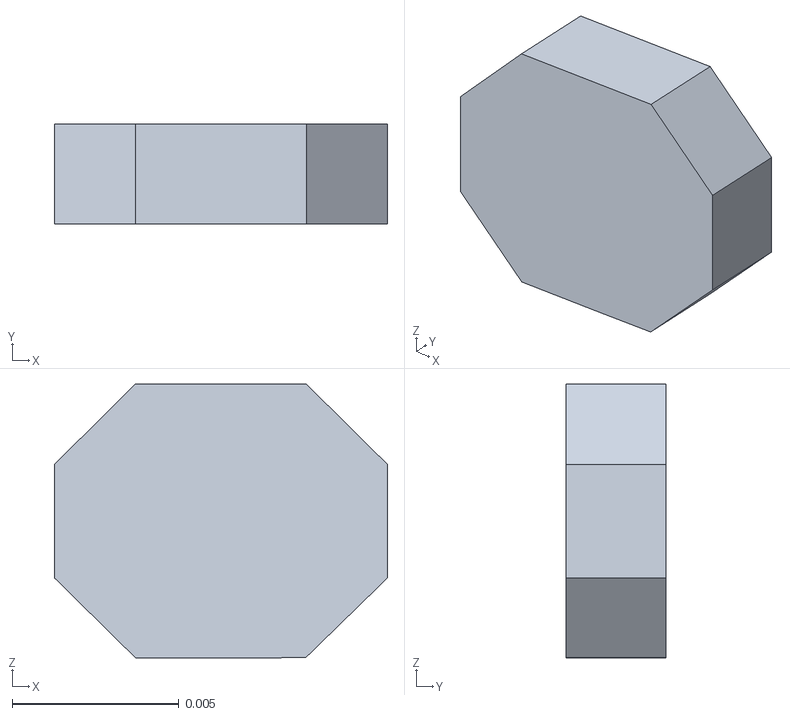
[picture p90: CAD file, 2026-10-26]
simulation/mujoco/model/meshes/collision/part_0286_044.stl
0.01 x 0.003 x 0.00823
