metrox-eth/moss/simulation/mujoco/model/meshes/SO101_Shoulder_bracket_cable_clip.stl

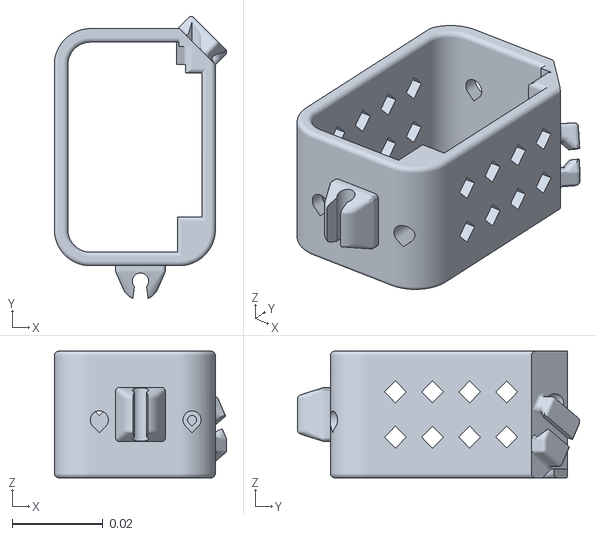
[picture p91: CAD file, 2026-10-26]
simulation/mujoco/model/meshes/SO101_Shoulder_bracket_cable_clip.stl
0.0381 x 0.0623 x 0.028
