metrox-eth/moss/simulation/mujoco/model/meshes/collision/part_0318_048.stl

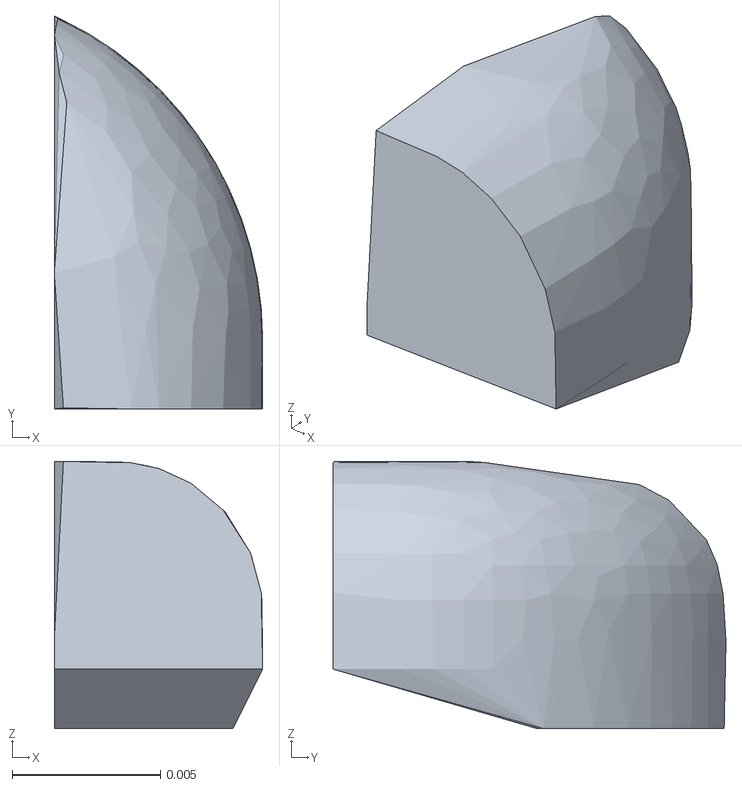
[picture p92: CAD file, 2026-10-26]
simulation/mujoco/model/meshes/collision/part_0318_048.stl
0.00702 x 0.0132 x 0.009
