metrox-eth/moss/simulation/mujoco/model/meshes/Left_Spacer_road_wheel_-70_outer_ID02_R24.stl

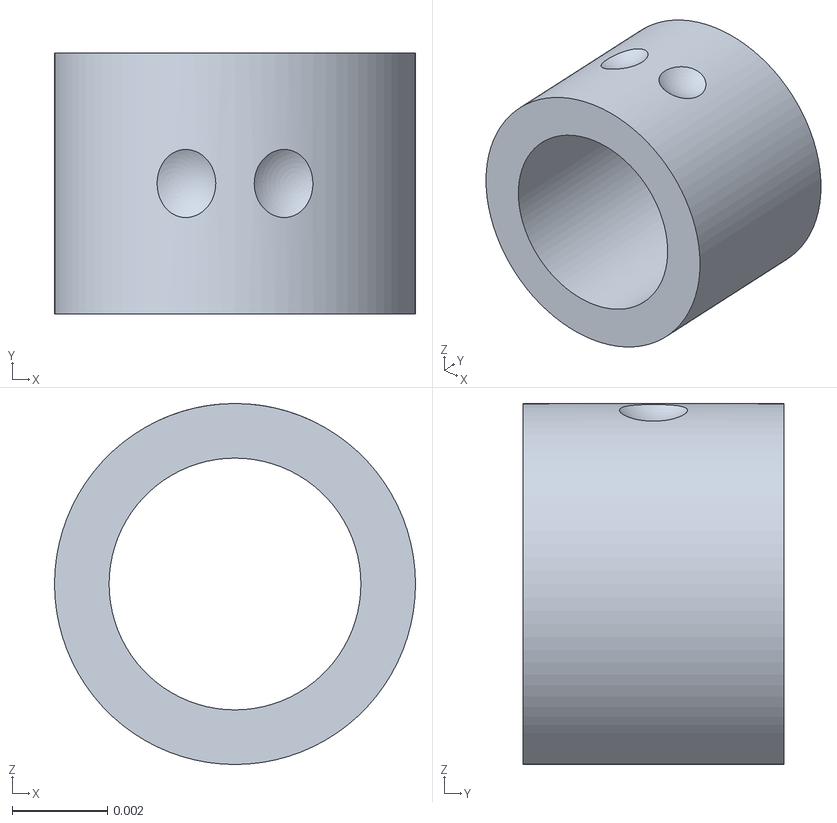
[picture p93: CAD file, 2026-10-26]
simulation/mujoco/model/meshes/Left_Spacer_road_wheel_-70_outer_ID02_R24.stl
0.0076 x 0.0055 x 0.0076
