metrox-eth/moss/simulation/mujoco/model/meshes/collision/part_0284_049.stl

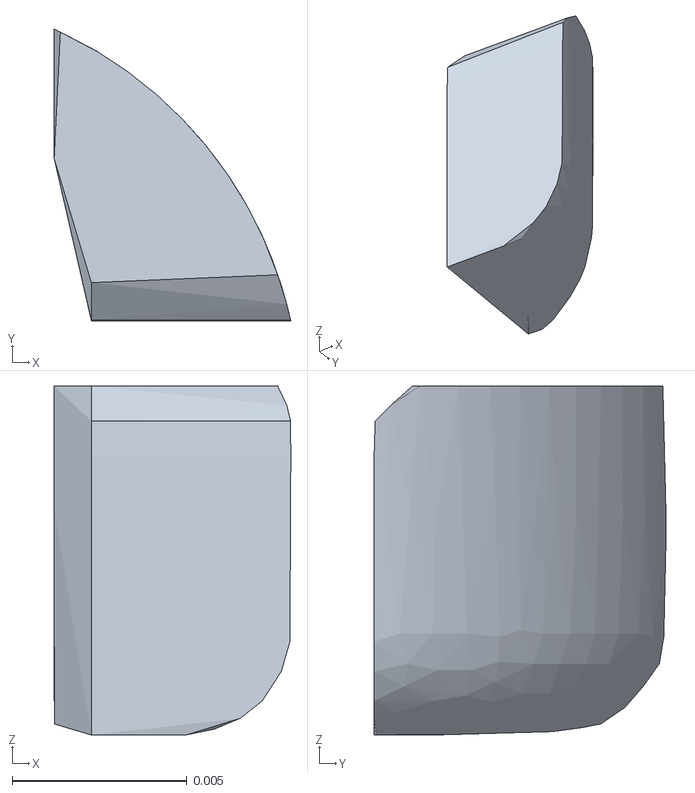
[picture p94: CAD file, 2026-10-26]
simulation/mujoco/model/meshes/collision/part_0284_049.stl
0.00678 x 0.00836 x 0.01
