metrox-eth/moss/simulation/mujoco/model/meshes/collision/part_0319_035.stl

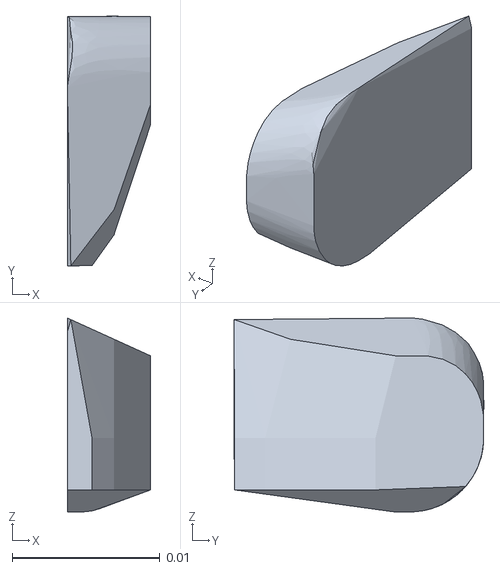
[picture p95: CAD file, 2026-10-26]
simulation/mujoco/model/meshes/collision/part_0319_035.stl
0.00564 x 0.0169 x 0.0131
