metrox-eth/moss/simulation/mujoco/model/meshes/collision/part_0319_019.stl

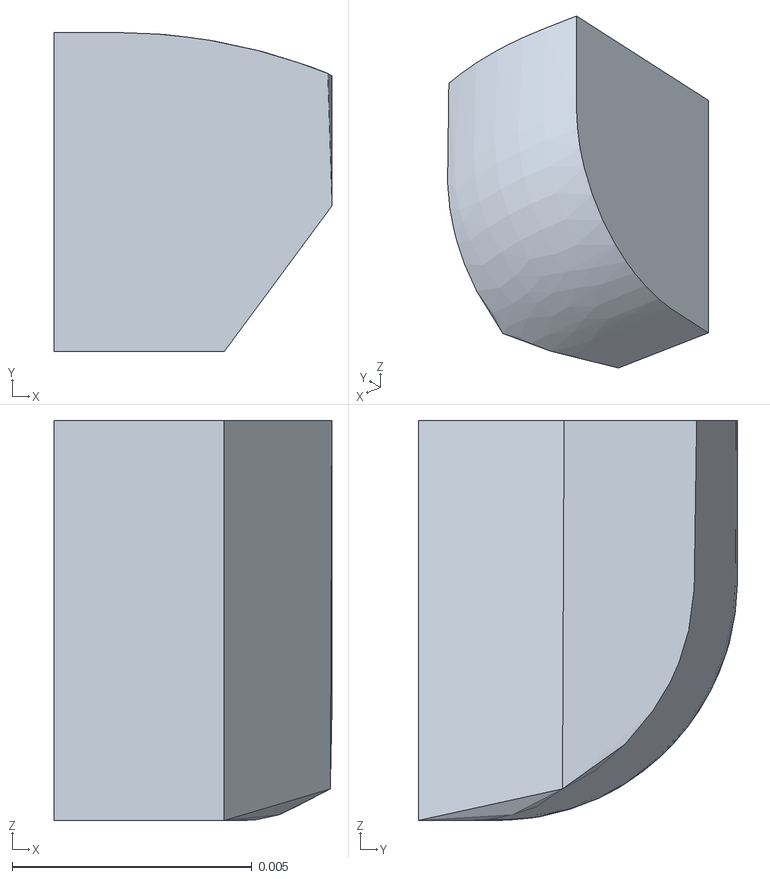
[picture p96: CAD file, 2026-10-26]
simulation/mujoco/model/meshes/collision/part_0319_019.stl
0.0058 x 0.00666 x 0.00835
