metrox-eth/moss/simulation/mujoco/model/meshes/collision/part_1005_052.stl

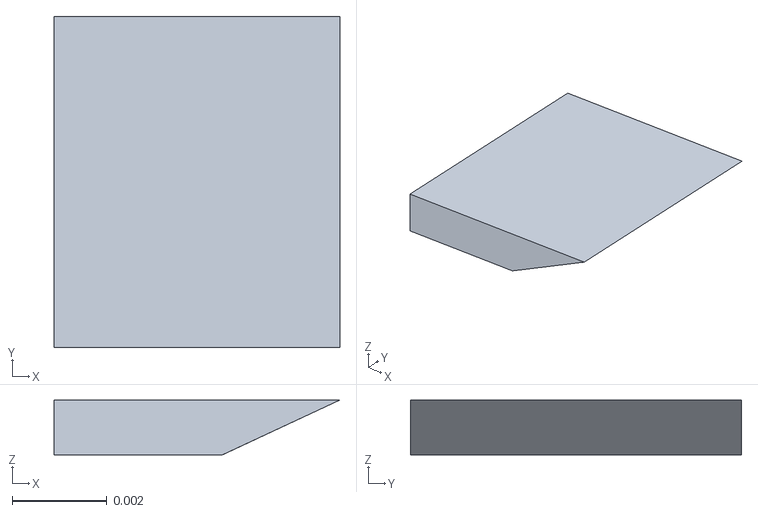
[picture p97: CAD file, 2026-10-26]
simulation/mujoco/model/meshes/collision/part_1005_052.stl
0.00604 x 0.00699 x 0.00116
