metrox-eth/moss/simulation/mujoco/model/meshes/Left_Spacer_road_wheel_0_center.stl

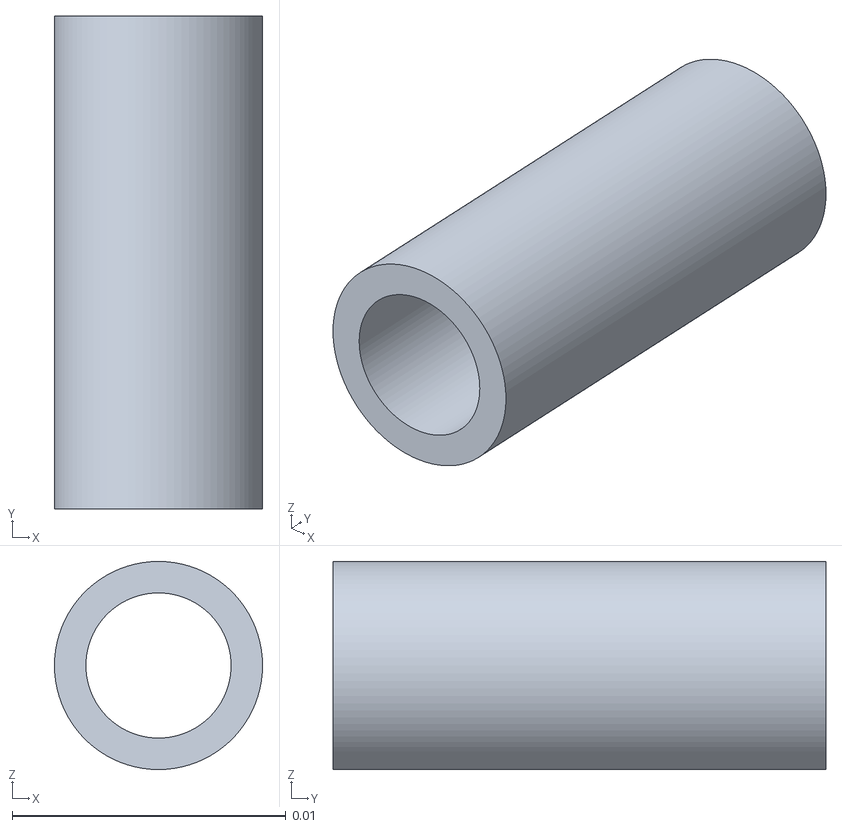
[picture p98: CAD file, 2026-10-26]
simulation/mujoco/model/meshes/Left_Spacer_road_wheel_0_center.stl
0.0076 x 0.018 x 0.0076
