metrox-eth/moss/simulation/mujoco/model/meshes/collision/part_0286_051.stl

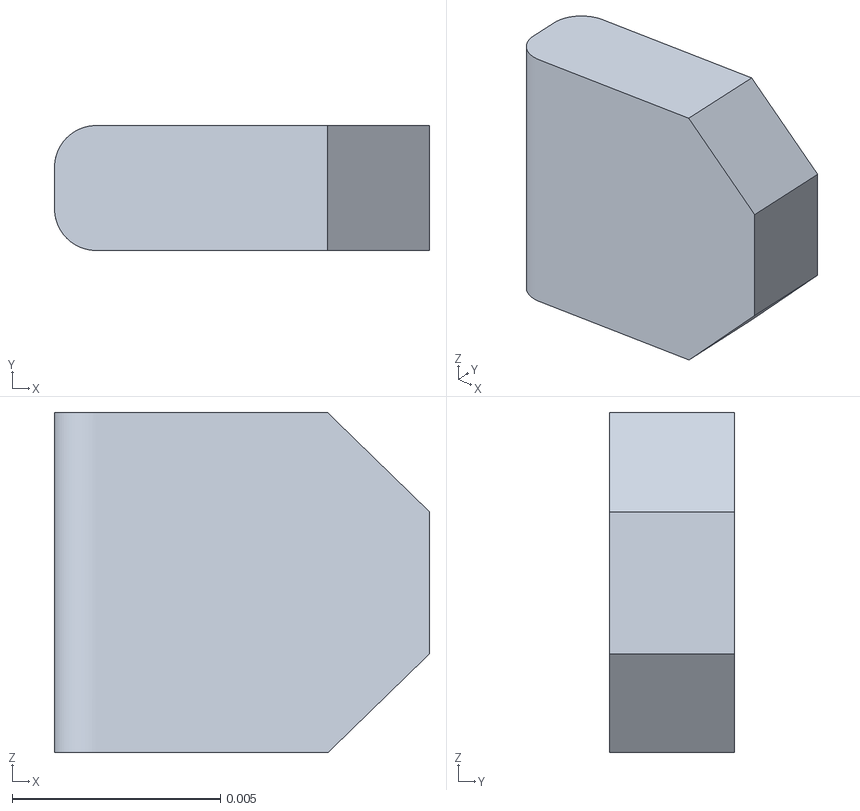
[picture p99: CAD file, 2026-10-26]
simulation/mujoco/model/meshes/collision/part_0286_051.stl
0.00901 x 0.003 x 0.00818
