metrox-eth/moss/simulation/mujoco/model/meshes/Hull_R92.stl

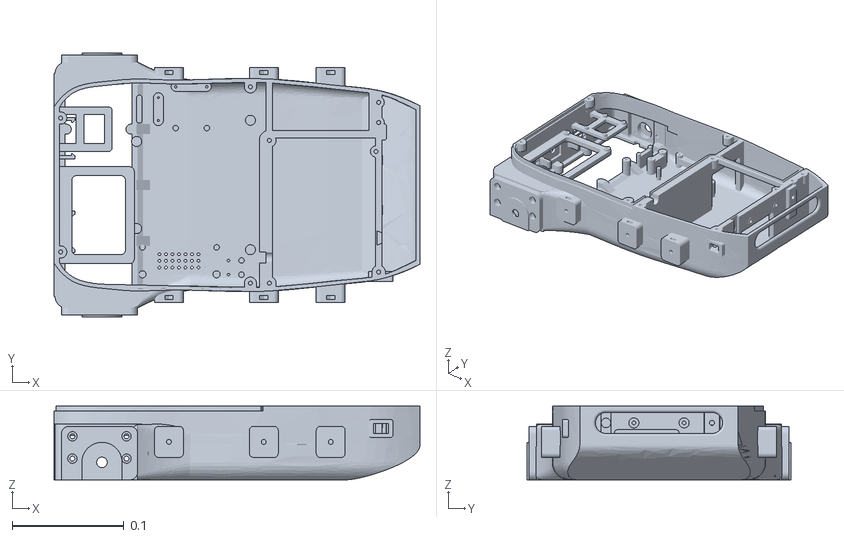
[picture p100: CAD file, 2026-10-26]
simulation/mujoco/model/meshes/Hull_R92.stl
0.328 x 0.237 x 0.066
