metrox-eth/moss/simulation/mujoco/model/meshes/collision/part_0319_032.stl

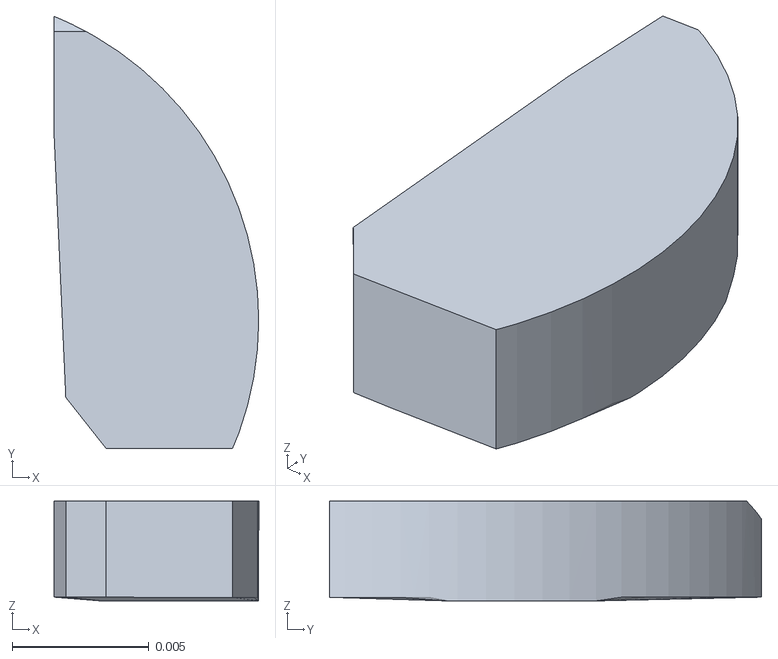
[picture p101: CAD file, 2026-10-26]
simulation/mujoco/model/meshes/collision/part_0319_032.stl
0.00747 x 0.0158 x 0.00365
