metrox-eth/moss/simulation/mujoco/model/meshes/NC90_Base_extended_rails.stl

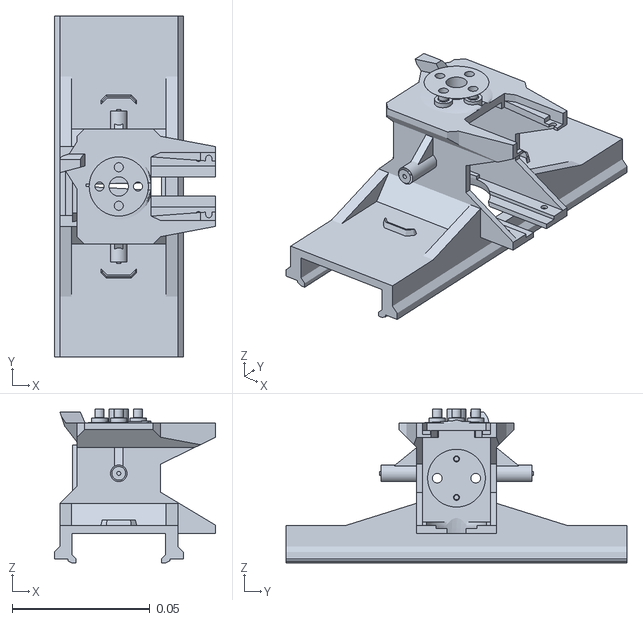
[picture p102: CAD file, 2026-10-26]
simulation/mujoco/model/meshes/NC90_Base_extended_rails.stl
0.0587 x 0.124 x 0.056
