metrox-eth/moss/simulation/mujoco/model/meshes/collision/part_0286_003.stl

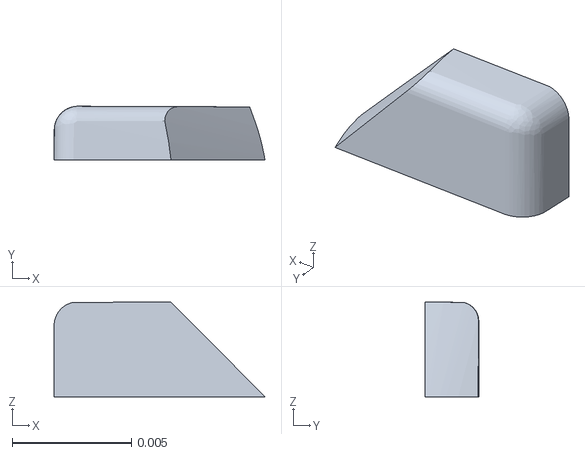
[picture p103: CAD file, 2026-10-26]
simulation/mujoco/model/meshes/collision/part_0286_003.stl
0.00886 x 0.00225 x 0.00398
