metrox-eth/moss/simulation/mujoco/model/meshes/Left_Spacer_tensioner_outer_ID06_R24.stl

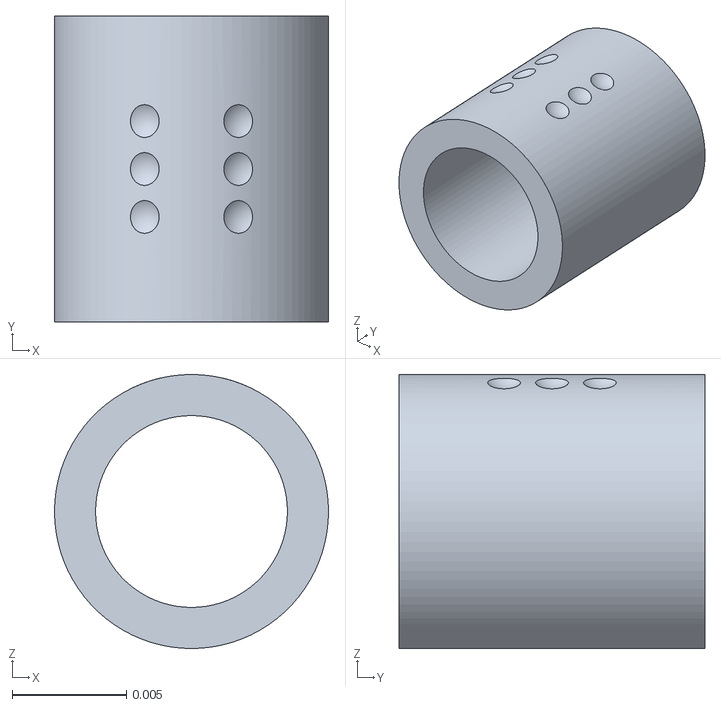
[picture p104: CAD file, 2026-10-26]
simulation/mujoco/model/meshes/Left_Spacer_tensioner_outer_ID06_R24.stl
0.012 x 0.0134 x 0.012
