metrox-eth/moss/simulation/mujoco/model/meshes/collision/part_1005_020.stl

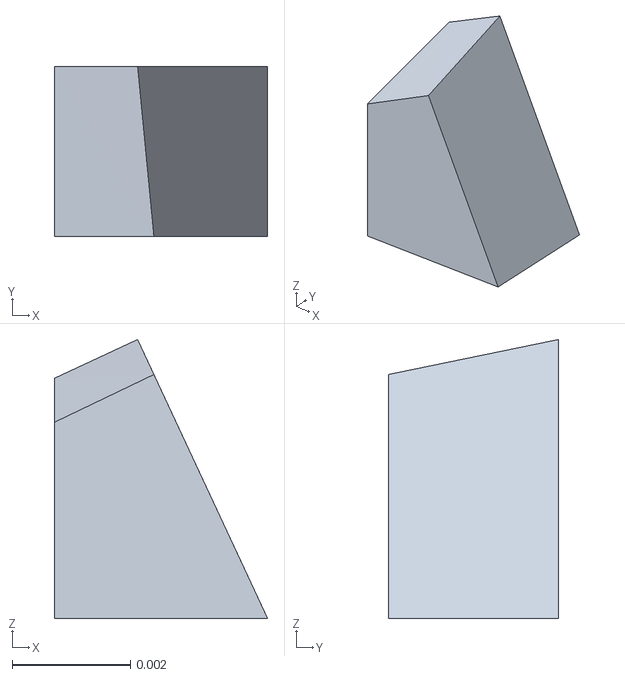
[picture p105: CAD file, 2026-10-26]
simulation/mujoco/model/meshes/collision/part_1005_020.stl
0.00361 x 0.00288 x 0.00473
