metrox-eth/moss/simulation/mujoco/model/meshes/Left_Outer_Track_Frame_R32.stl

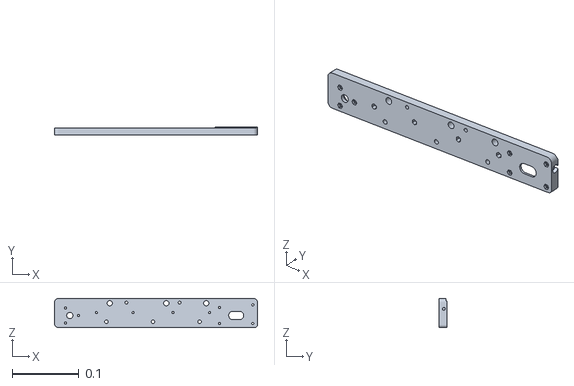
[picture p106: CAD file, 2026-10-26]
simulation/mujoco/model/meshes/Left_Outer_Track_Frame_R32.stl
0.305 x 0.0115 x 0.0437
