metrox-eth/moss/simulation/mujoco/model/meshes/collision/part_0291_061.stl

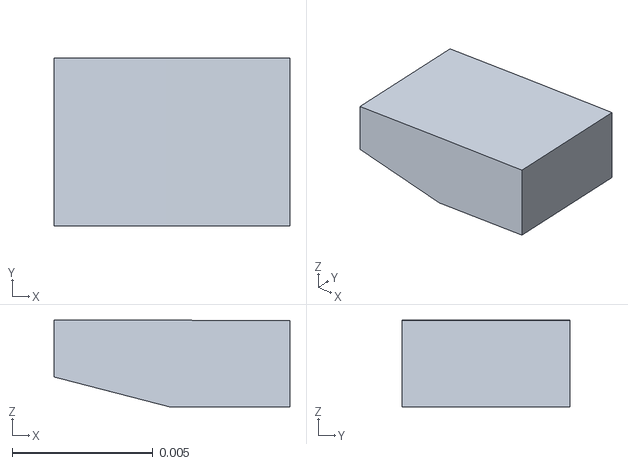
[picture p107: CAD file, 2026-10-26]
simulation/mujoco/model/meshes/collision/part_0291_061.stl
0.00839 x 0.00598 x 0.00309
