metrox-eth/moss/simulation/mujoco/model/meshes/SO101_Forearm_cable_clip.stl

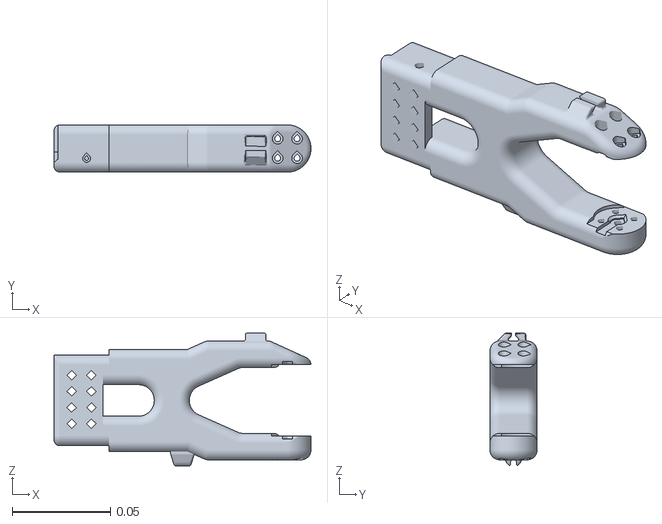
[picture p108: CAD file, 2026-10-26]
simulation/mujoco/model/meshes/SO101_Forearm_cable_clip.stl
0.131 x 0.024 x 0.0674
