metrox-eth/moss/simulation/mujoco/model/meshes/collision/part_0321_059.stl

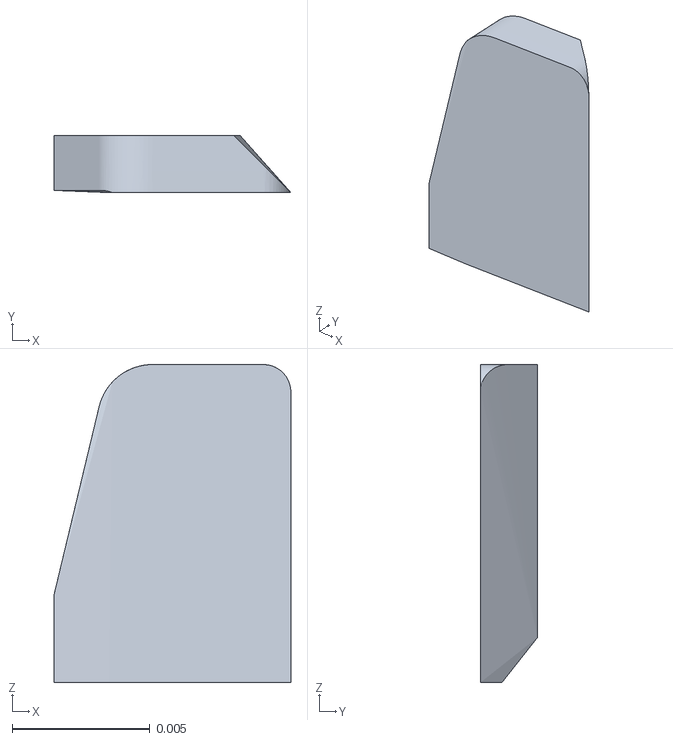
[picture p109: CAD file, 2026-10-26]
simulation/mujoco/model/meshes/collision/part_0321_059.stl
0.0086 x 0.00208 x 0.0115
