metrox-eth/moss/simulation/mujoco/model/meshes/collision/part_0284_060.stl

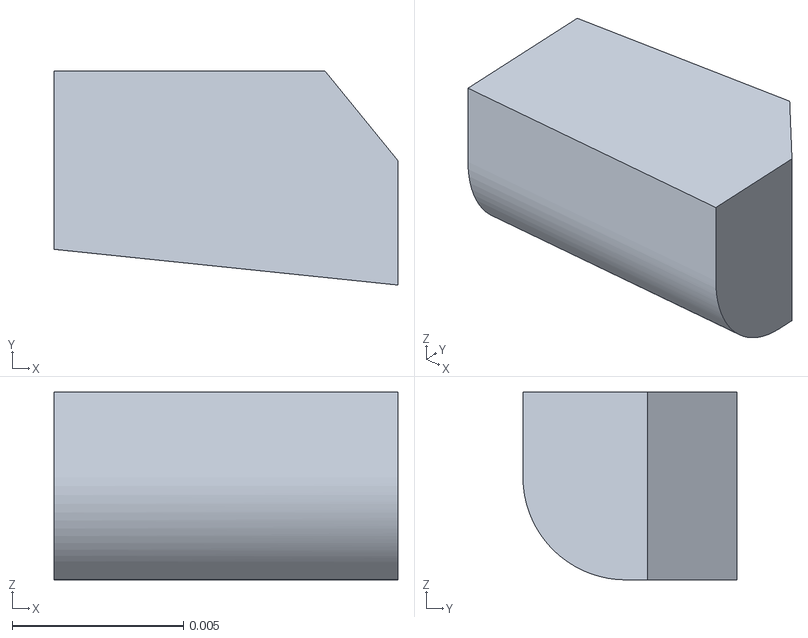
[picture p110: CAD file, 2026-10-26]
simulation/mujoco/model/meshes/collision/part_0284_060.stl
0.0101 x 0.00626 x 0.00549
