metrox-eth/moss/simulation/mujoco/model/meshes/SO101_Wrist_cable_clip.stl

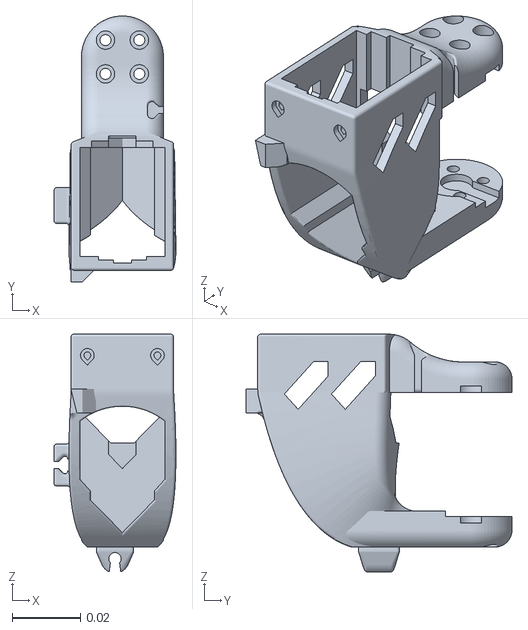
[picture p111: CAD file, 2026-10-26]
simulation/mujoco/model/meshes/SO101_Wrist_cable_clip.stl
0.0357 x 0.0778 x 0.0695
