metrox-eth/moss/simulation/mujoco/model/meshes/collision/part_0318_011.stl

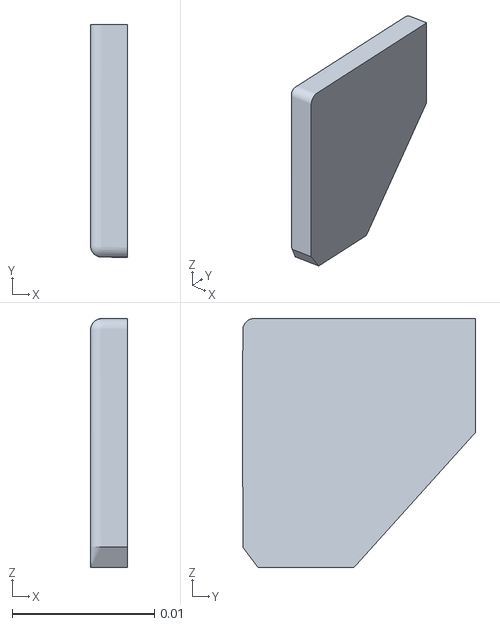
[picture p112: CAD file, 2026-10-26]
simulation/mujoco/model/meshes/collision/part_0318_011.stl
0.00261 x 0.0163 x 0.0175
