metrox-eth/moss/simulation/mujoco/model/meshes/Lidar_Base_R84.stl

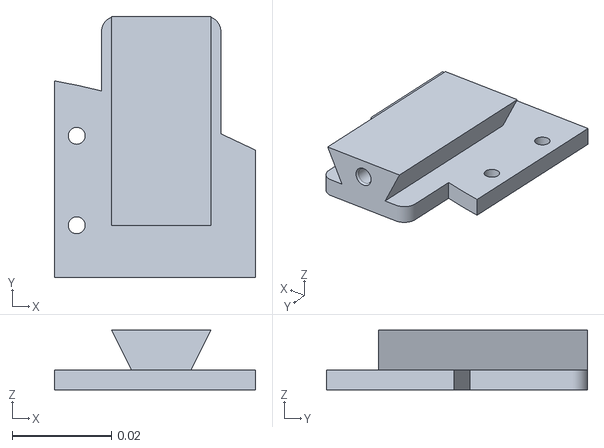
[picture p113: CAD file, 2026-10-26]
simulation/mujoco/model/meshes/Lidar_Base_R84.stl
0.0405 x 0.0525 x 0.012
