metrox-eth/moss/simulation/mujoco/model/meshes/collision/part_0321_004.stl

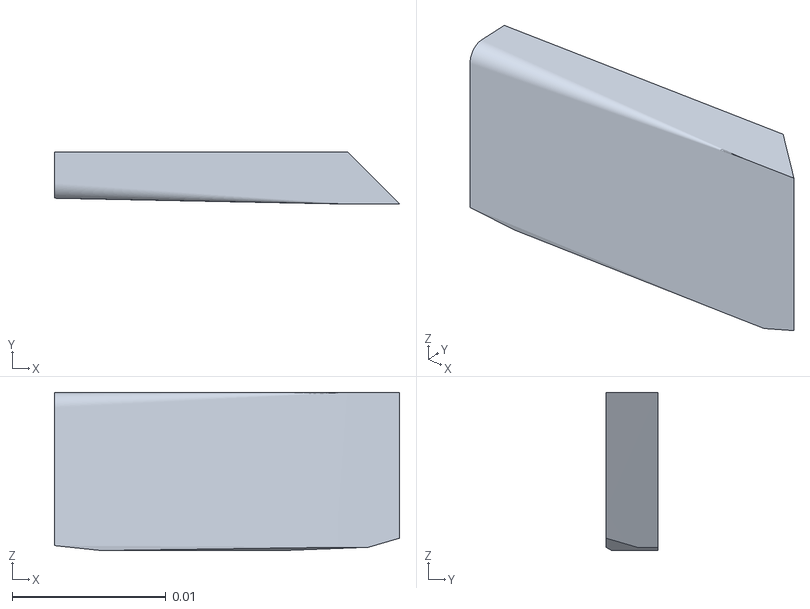
[picture p114: CAD file, 2026-10-26]
simulation/mujoco/model/meshes/collision/part_0321_004.stl
0.0224 x 0.00337 x 0.0103
