metrox-eth/moss/simulation/mujoco/model/meshes/XT30_insulating_separator.stl

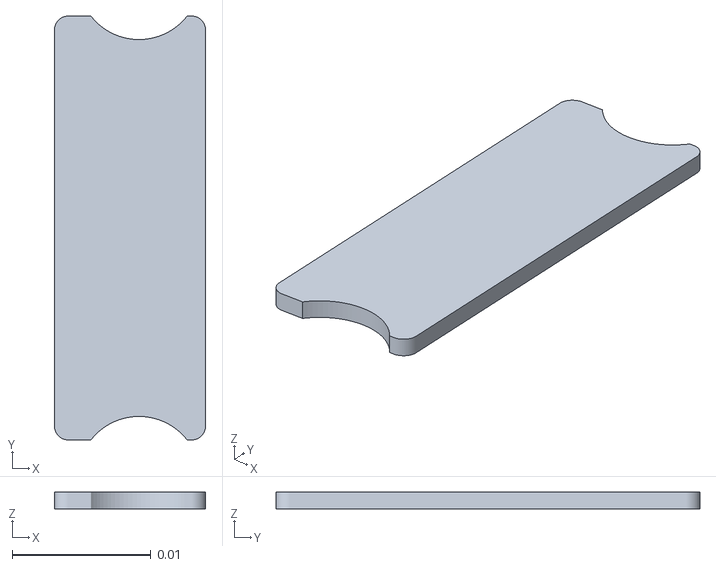
[picture p115: CAD file, 2026-10-26]
simulation/mujoco/model/meshes/XT30_insulating_separator.stl
0.0109 x 0.0306 x 0.0012
