metrox-eth/moss/simulation/mujoco/model/meshes/collision/part_0319_041.stl

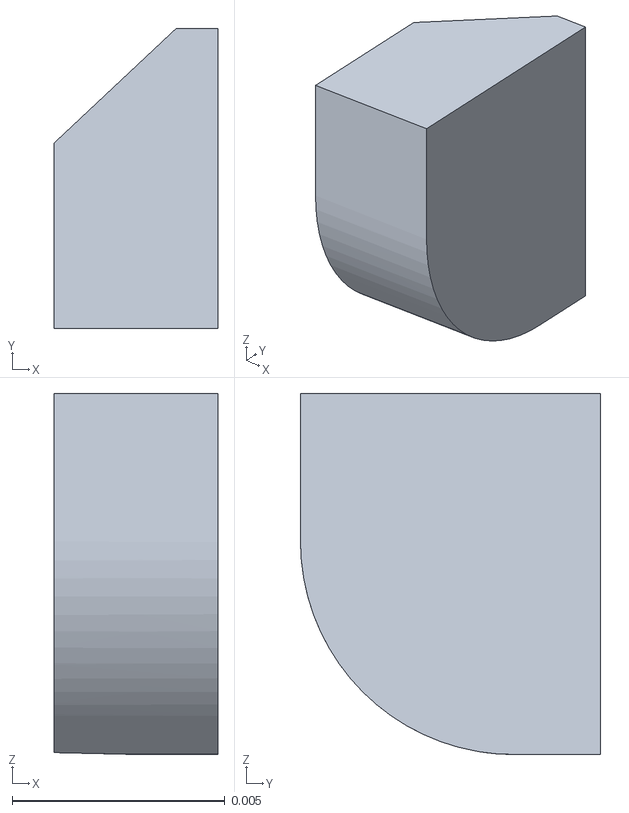
[picture p116: CAD file, 2026-10-26]
simulation/mujoco/model/meshes/collision/part_0319_041.stl
0.00385 x 0.00705 x 0.00847
