metrox-eth/moss/simulation/mujoco/model/meshes/Right_inner_track_frame_R12_C2.stl

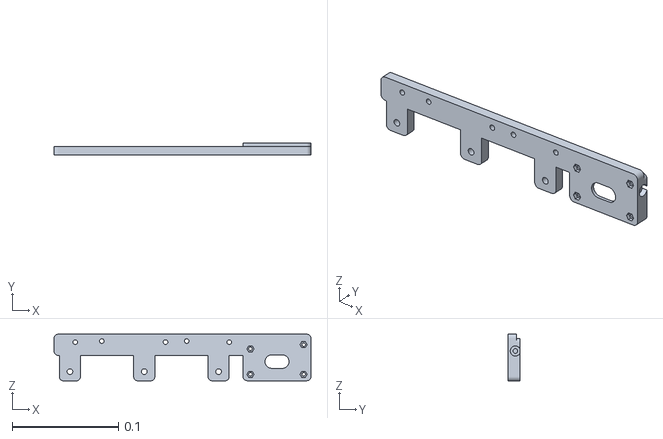
[picture p117: CAD file, 2026-10-26]
simulation/mujoco/model/meshes/Right_inner_track_frame_R12_C2.stl
0.242 x 0.0115 x 0.044
