metrox-eth/moss/simulation/mujoco/model/meshes/collision/part_0319_042.stl

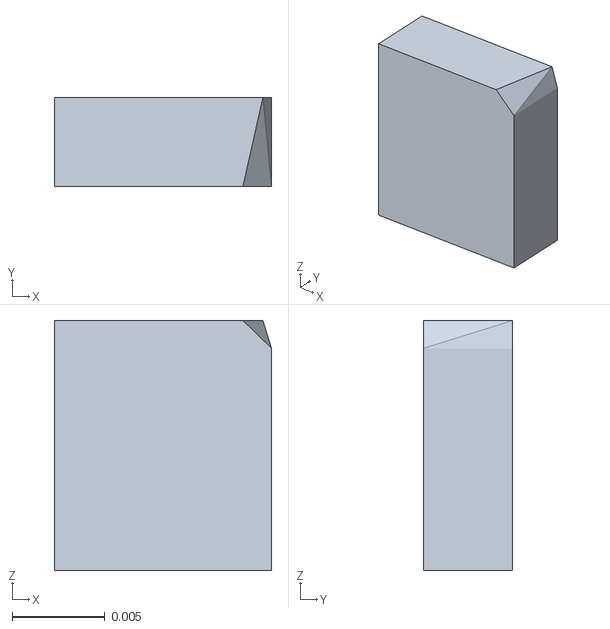
[picture p118: CAD file, 2026-10-26]
simulation/mujoco/model/meshes/collision/part_0319_042.stl
0.0117 x 0.00481 x 0.0135
