metrox-eth/moss/simulation/mujoco/model/meshes/collision/part_0319_001.stl

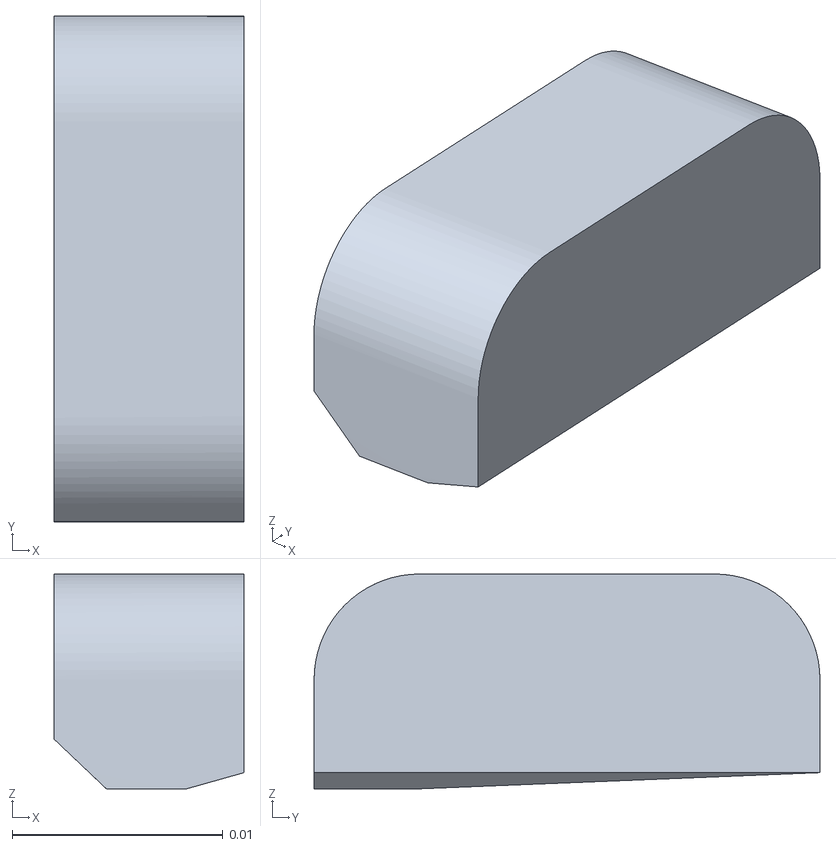
[picture p119: CAD file, 2026-10-26]
simulation/mujoco/model/meshes/collision/part_0319_001.stl
0.009 x 0.024 x 0.0102
