metrox-eth/moss/simulation/mujoco/model/meshes/collision/part_0319_049.stl

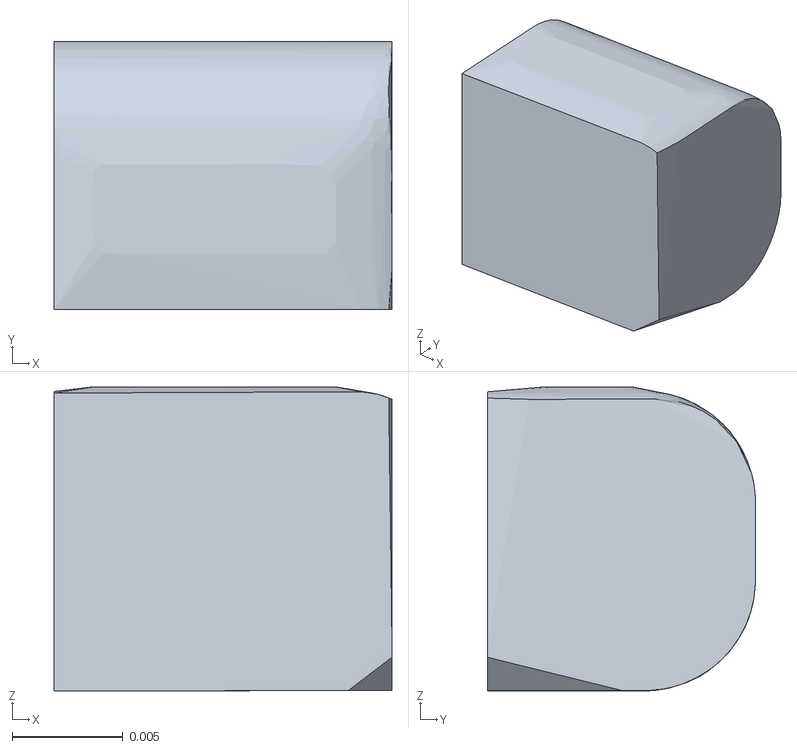
[picture p120: CAD file, 2026-10-26]
simulation/mujoco/model/meshes/collision/part_0319_049.stl
0.0152 x 0.0121 x 0.0137
