metrox-eth/moss/simulation/mujoco/model/meshes/Right_Spacer_tensioner_retainer_inner_ID07_R24.stl

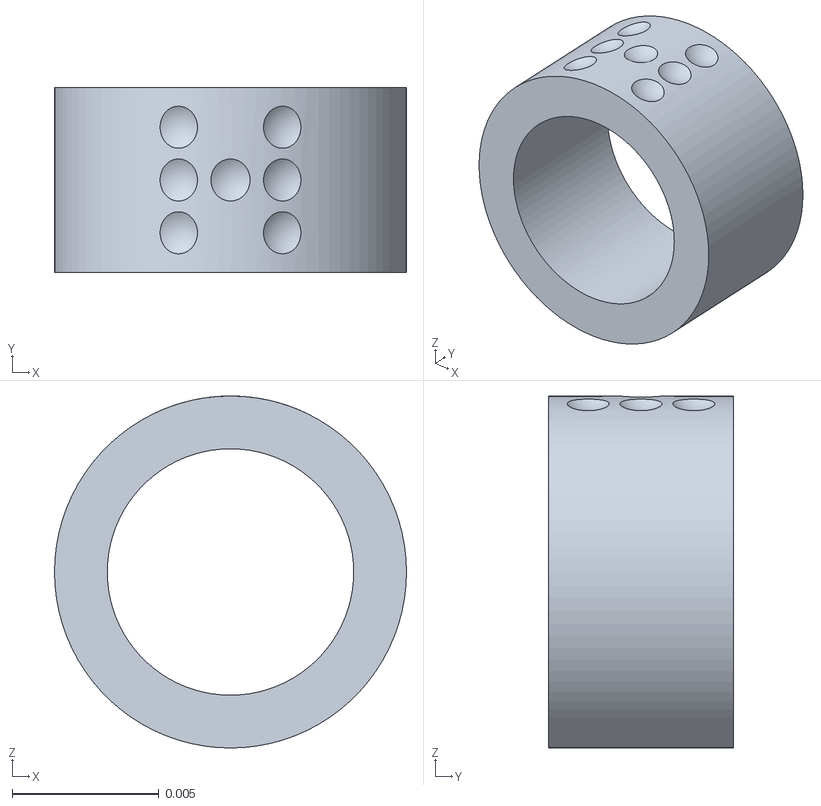
[picture p121: CAD file, 2026-10-26]
simulation/mujoco/model/meshes/Right_Spacer_tensioner_retainer_inner_ID07_R24.stl
0.012 x 0.0063 x 0.012
