metrox-eth/moss/simulation/mujoco/model/meshes/collision/part_0291_008.stl

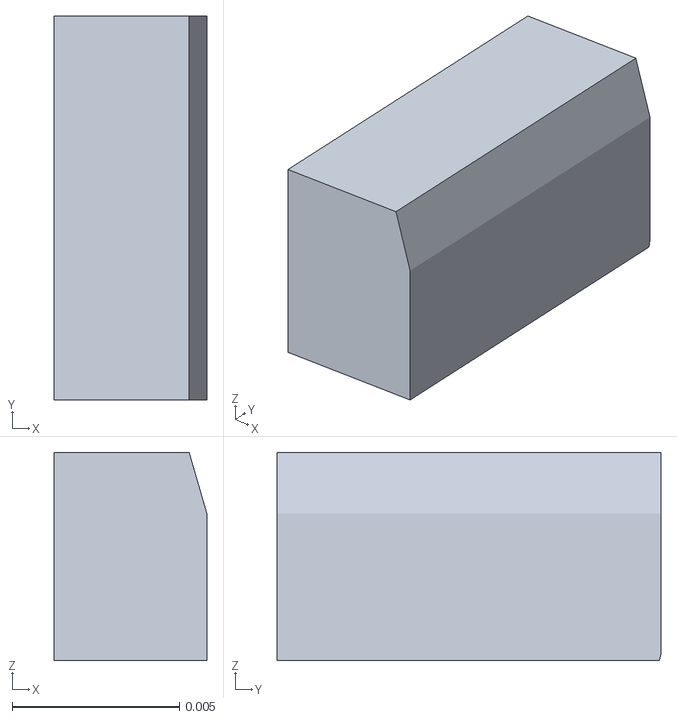
[picture p122: CAD file, 2026-10-26]
simulation/mujoco/model/meshes/collision/part_0291_008.stl
0.00457 x 0.0115 x 0.00622
