metrox-eth/moss/simulation/mujoco/model/meshes/collision/part_0320_062.stl

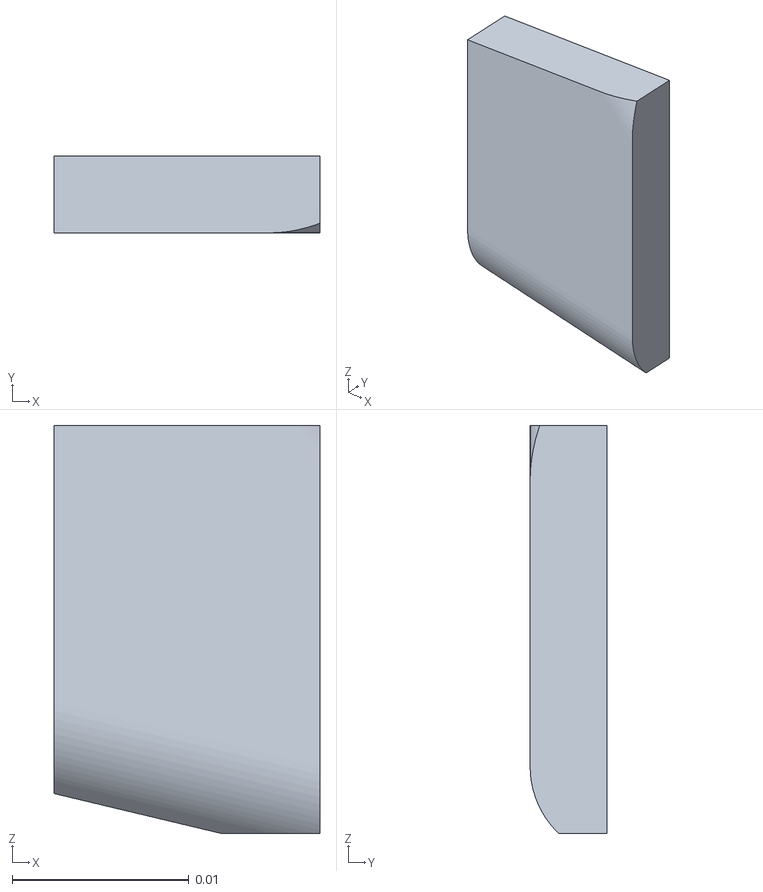
[picture p123: CAD file, 2026-10-26]
simulation/mujoco/model/meshes/collision/part_0320_062.stl
0.015 x 0.00434 x 0.0231
