metrox-eth/moss/simulation/mujoco/model/meshes/Track_Right.obj

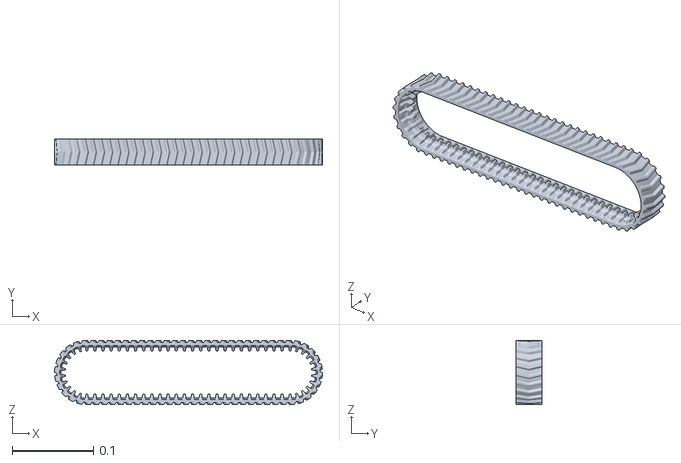
[picture p124: CAD file, 2026-10-26]
simulation/mujoco/model/meshes/Track_Right.obj
0.329 x 0.032 x 0.0792
