metrox-eth/moss/simulation/mujoco/model/meshes/collision/part_0319_044.stl

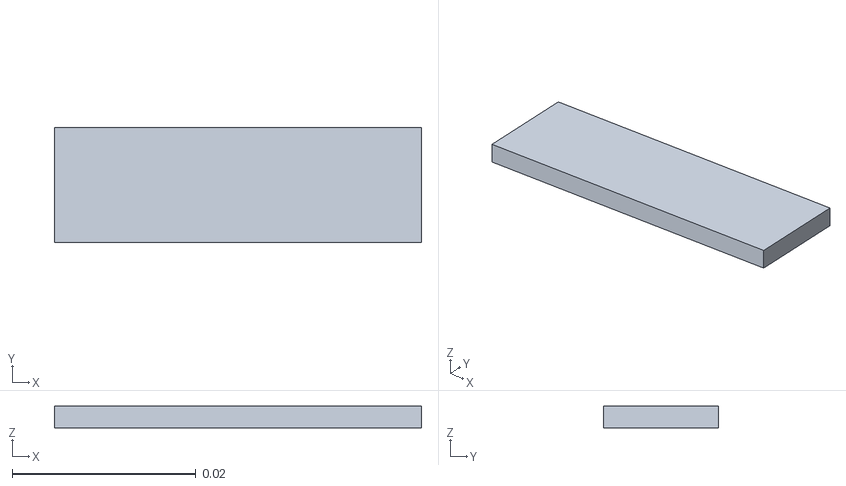
[picture p125: CAD file, 2026-10-26]
simulation/mujoco/model/meshes/collision/part_0319_044.stl
0.04 x 0.0125 x 0.00236
