metrox-eth/moss/simulation/mujoco/model/meshes/collision/part_0284_025.stl

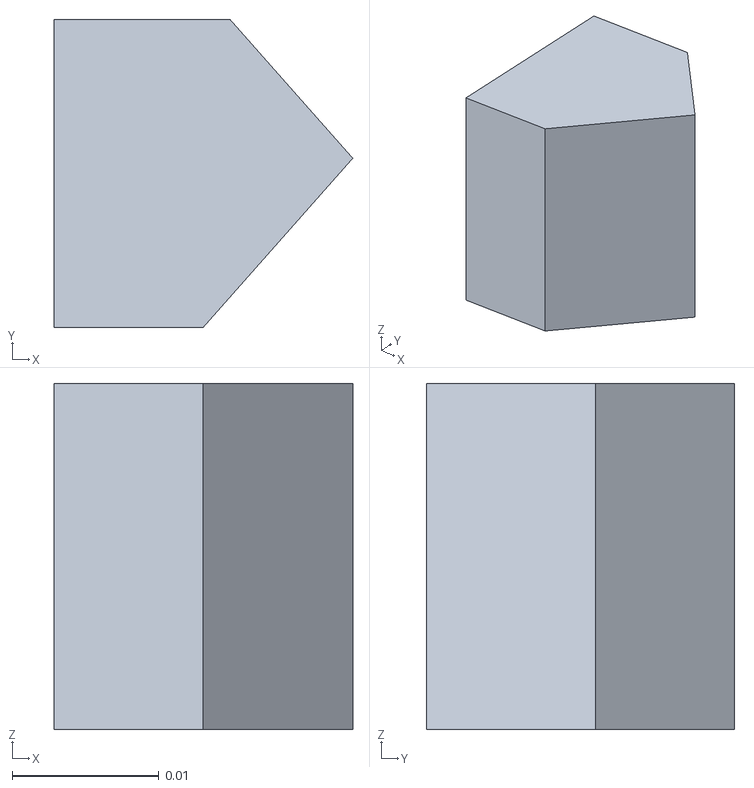
[picture p126: CAD file, 2026-10-26]
simulation/mujoco/model/meshes/collision/part_0284_025.stl
0.0203 x 0.021 x 0.0236
