metrox-eth/moss/simulation/mujoco/model/meshes/Left_Spacer_tensioner_retainer_outer_ID08_R24.stl

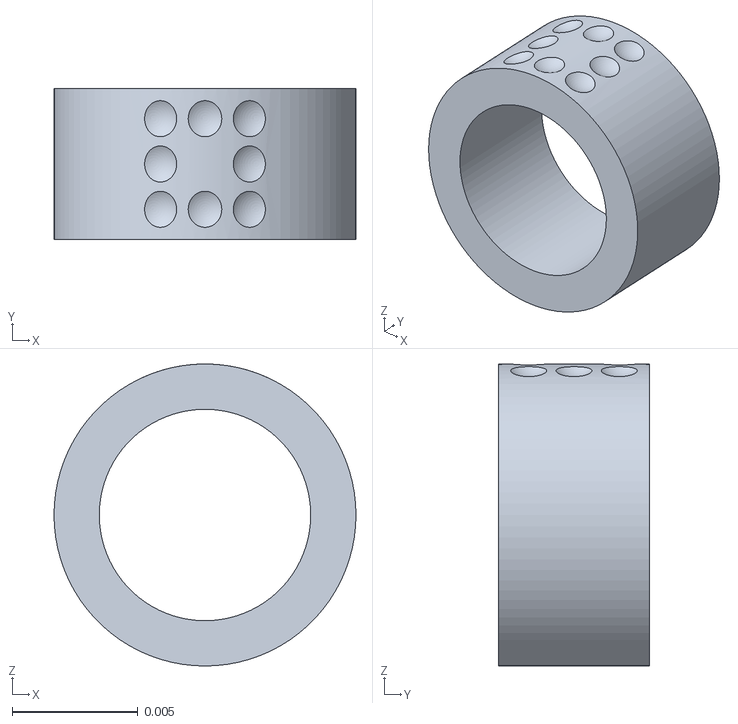
[picture p127: CAD file, 2026-10-26]
simulation/mujoco/model/meshes/Left_Spacer_tensioner_retainer_outer_ID08_R24.stl
0.012 x 0.006 x 0.012
