metrox-eth/moss/simulation/mujoco/model/meshes/collision/part_0319_025.stl

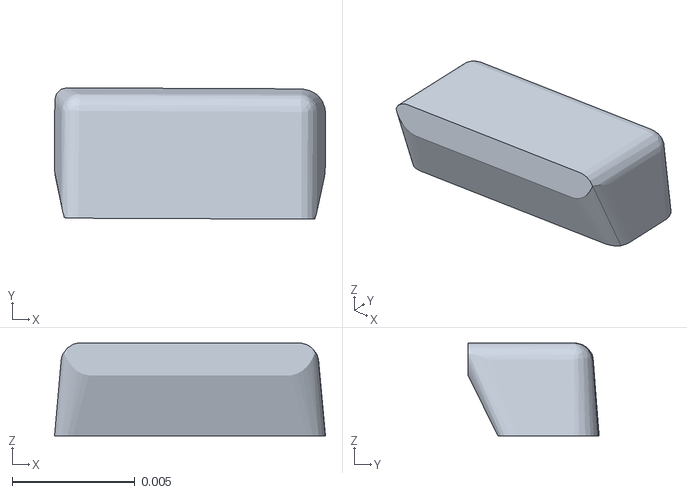
[picture p128: CAD file, 2026-10-26]
simulation/mujoco/model/meshes/collision/part_0319_025.stl
0.011 x 0.00535 x 0.00379
