metrox-eth/moss/simulation/mujoco/model/meshes/SO101_Wrist_bracket.stl

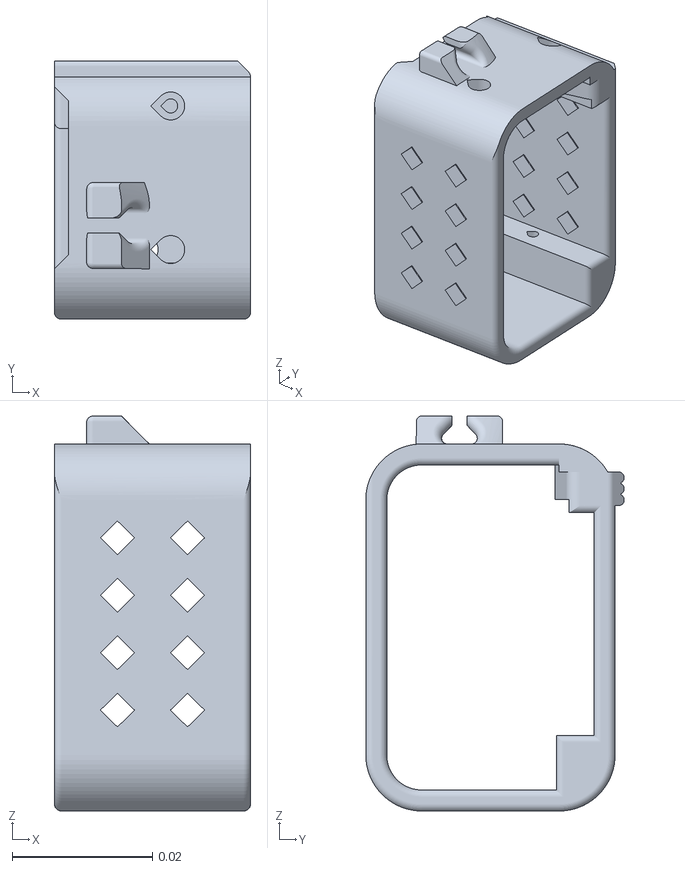
[picture p129: CAD file, 2026-10-26]
simulation/mujoco/model/meshes/SO101_Wrist_bracket.stl
0.028 x 0.0369 x 0.0564
