metrox-eth/moss/simulation/mujoco/model/meshes/collision/part_0290_054.stl

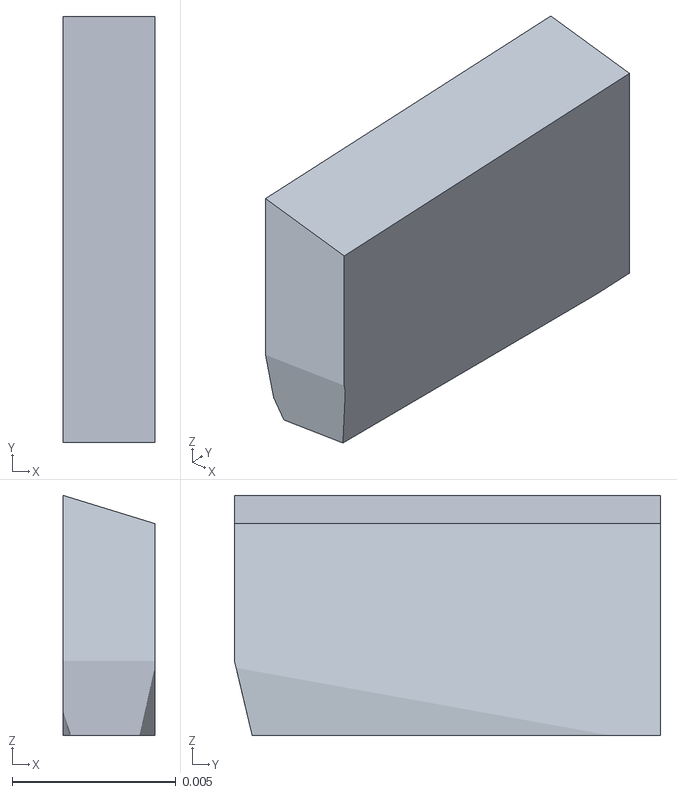
[picture p130: CAD file, 2026-10-26]
simulation/mujoco/model/meshes/collision/part_0290_054.stl
0.0028 x 0.013 x 0.00733
