metrox-eth/moss/simulation/mujoco/model/meshes/collision/part_0318_002.stl

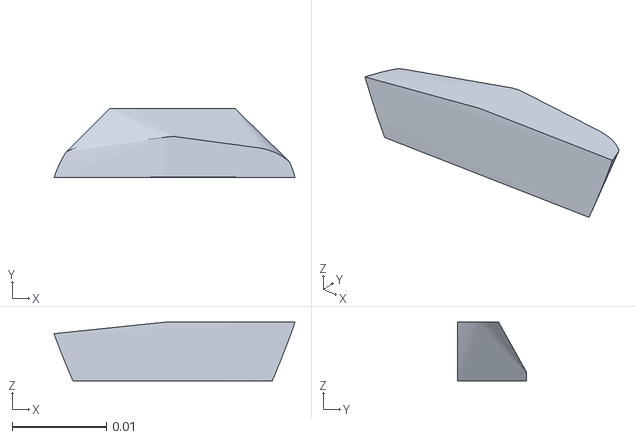
[picture p132: CAD file, 2026-10-26]
simulation/mujoco/model/meshes/collision/part_0318_002.stl
0.0256 x 0.00735 x 0.00624
