metrox-eth/moss/simulation/mujoco/model/meshes/collision/part_0286_049.stl

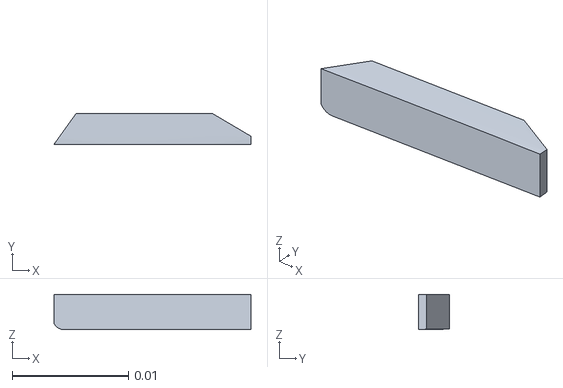
[picture p133: CAD file, 2026-10-26]
simulation/mujoco/model/meshes/collision/part_0286_049.stl
0.017 x 0.00263 x 0.00305
