metrox-eth/moss/simulation/mujoco/model/meshes/collision/part_0320_035.stl

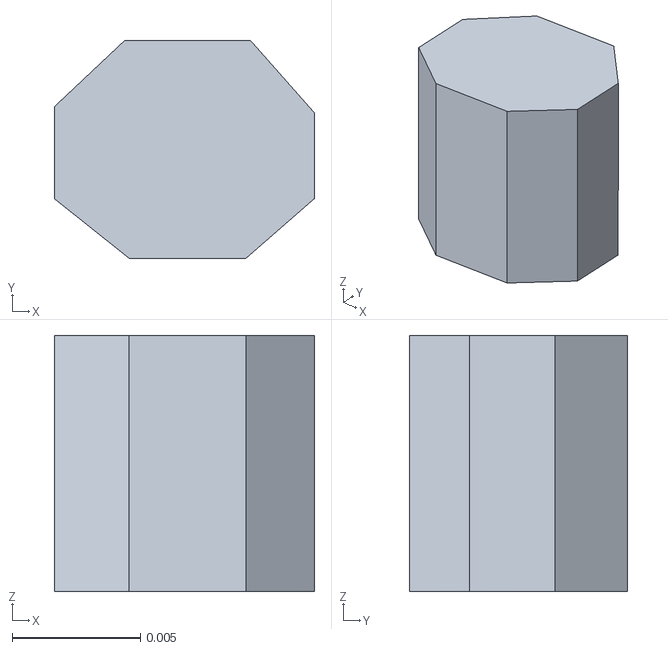
[picture p134: CAD file, 2026-10-26]
simulation/mujoco/model/meshes/collision/part_0320_035.stl
0.0101 x 0.00849 x 0.00999
