metrox-eth/moss/simulation/mujoco/model/meshes/collision/part_0318_006.stl

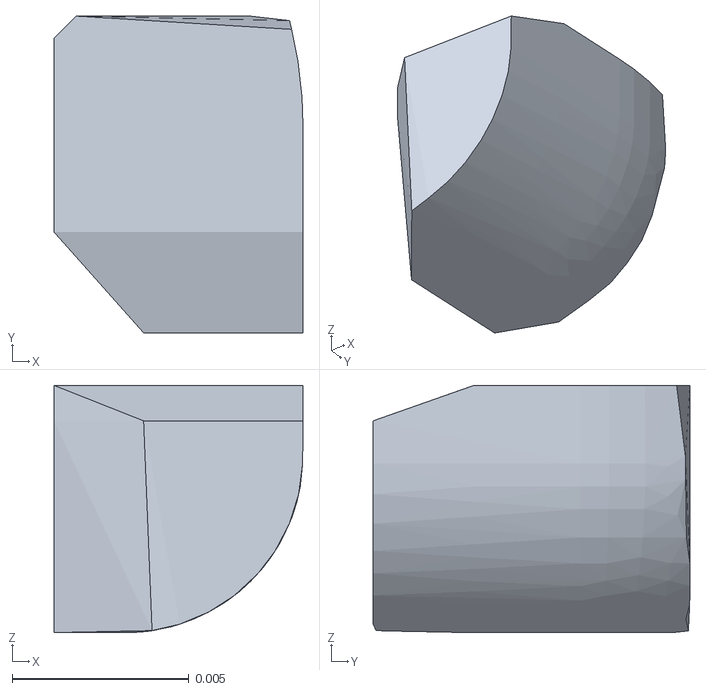
[picture p135: CAD file, 2026-10-26]
simulation/mujoco/model/meshes/collision/part_0318_006.stl
0.00705 x 0.00897 x 0.007
