metrox-eth/moss/simulation/mujoco/model/meshes/Gripper_Camera_Mount_R30.stl

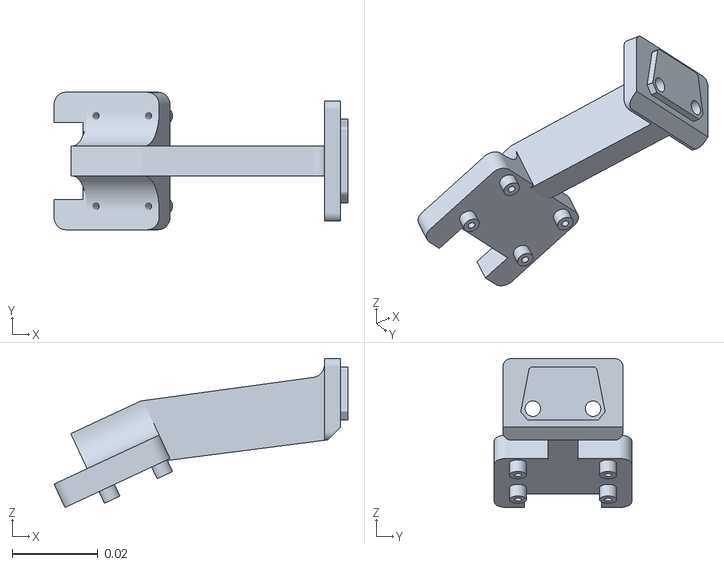
[picture p136: CAD file, 2026-10-26]
simulation/mujoco/model/meshes/Gripper_Camera_Mount_R30.stl
0.0684 x 0.032 x 0.0347
