metrox-eth/moss/simulation/mujoco/model/meshes/collision/part_0318_017.stl

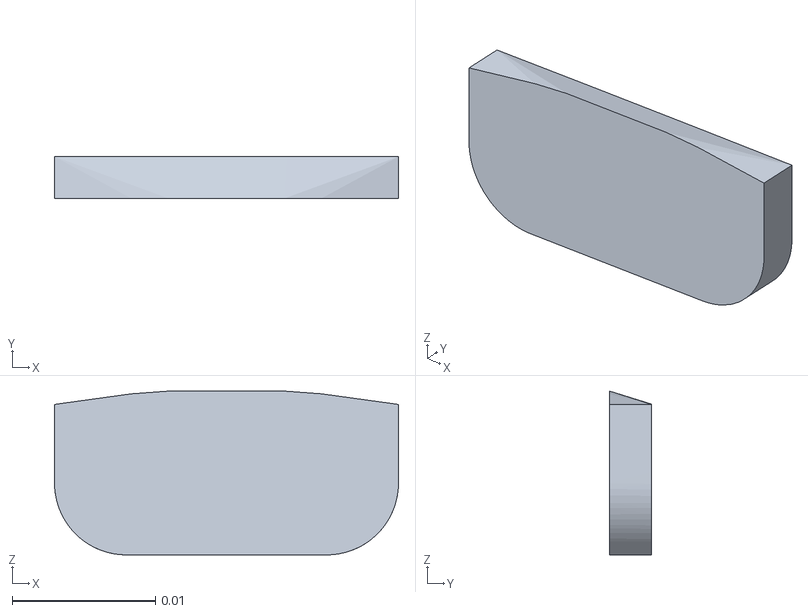
[picture p137: CAD file, 2026-10-26]
simulation/mujoco/model/meshes/collision/part_0318_017.stl
0.024 x 0.00291 x 0.0114
