metrox-eth/moss/simulation/mujoco/model/meshes/collision/part_0318_009.stl

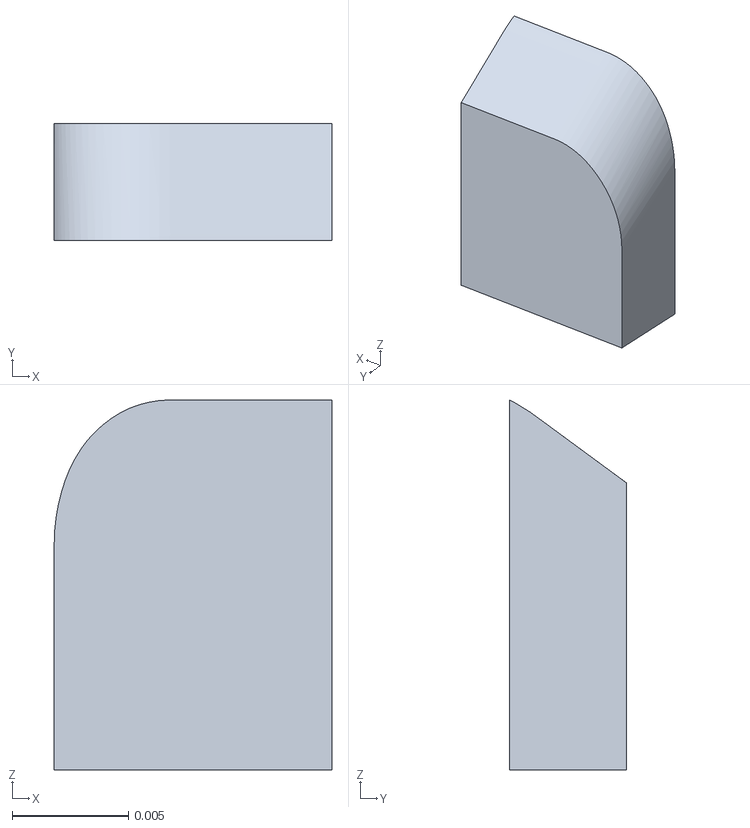
[picture p138: CAD file, 2026-10-26]
simulation/mujoco/model/meshes/collision/part_0318_009.stl
0.012 x 0.00504 x 0.0159
