metrox-eth/moss/simulation/mujoco/model/meshes/RealSense_Insert_R72.stl

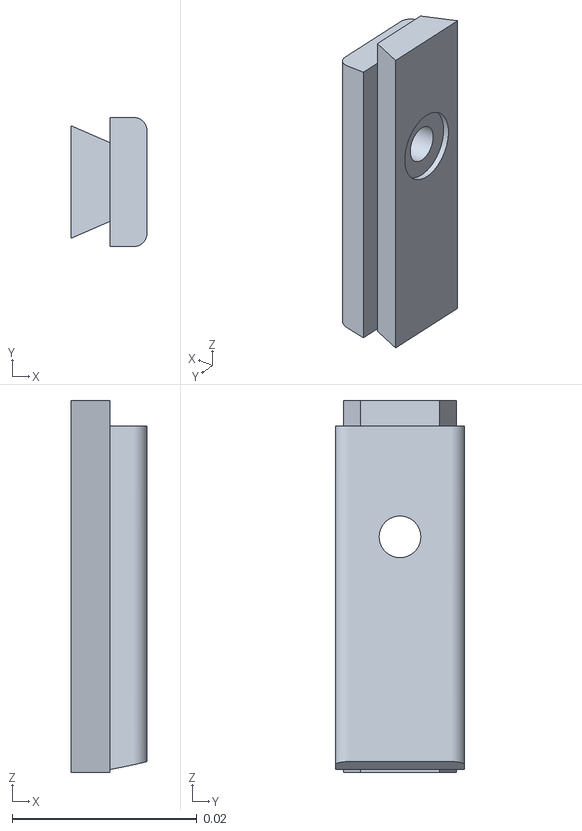
[picture p139: CAD file, 2026-10-26]
simulation/mujoco/model/meshes/RealSense_Insert_R72.stl
0.00825 x 0.014 x 0.0402
