metrox-eth/moss/simulation/mujoco/model/meshes/collision/part_0318_004.stl

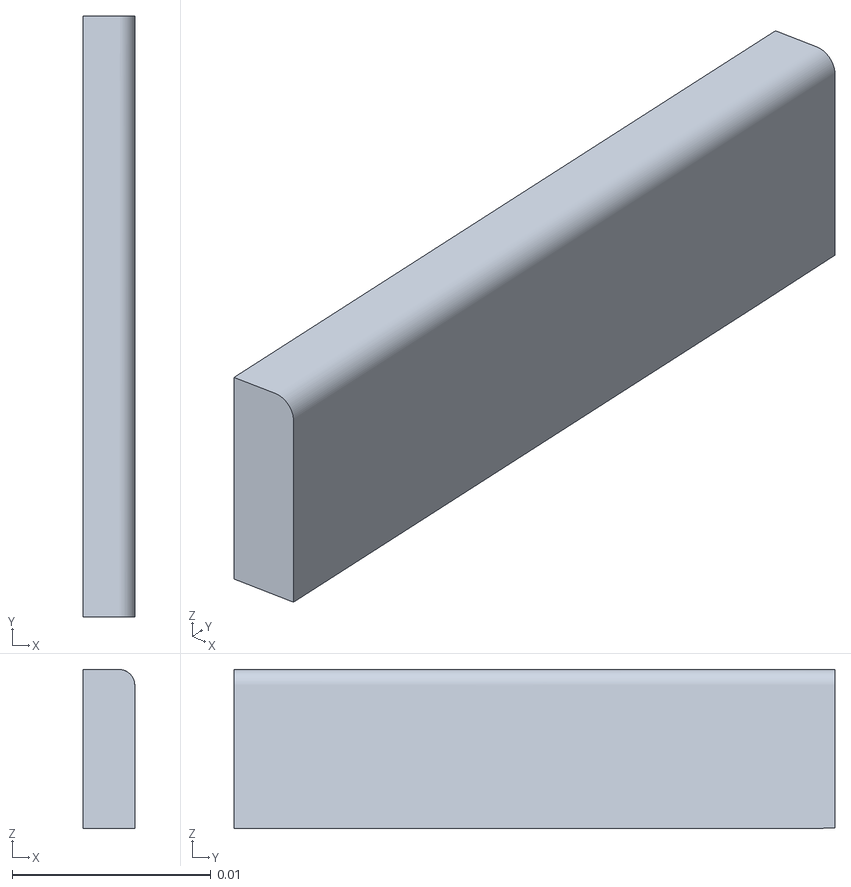
[picture p140: CAD file, 2026-10-26]
simulation/mujoco/model/meshes/collision/part_0318_004.stl
0.0026 x 0.0303 x 0.00802
