metrox-eth/moss/simulation/mujoco/model/meshes/collision/part_0286_027.stl

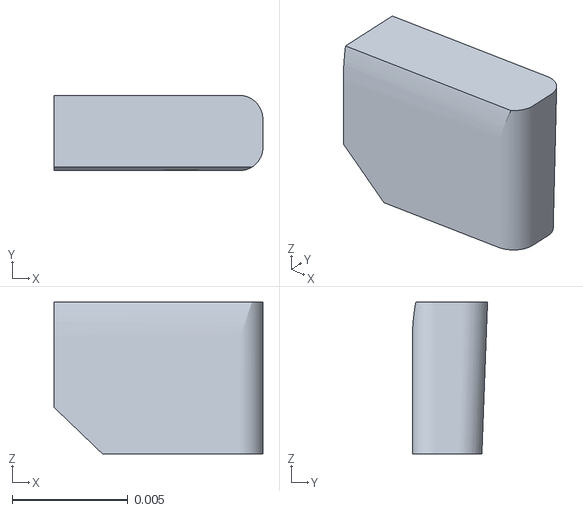
[picture p141: CAD file, 2026-10-26]
simulation/mujoco/model/meshes/collision/part_0286_027.stl
0.00902 x 0.00324 x 0.00656
