metrox-eth/moss/simulation/mujoco/model/meshes/collision/part_0286_017.stl

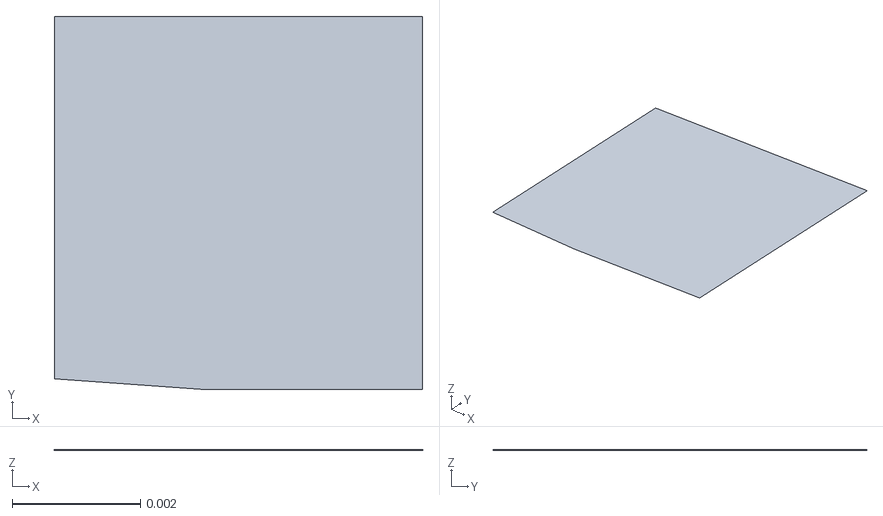
[picture p142: CAD file, 2026-10-26]
simulation/mujoco/model/meshes/collision/part_0286_017.stl
0.00573 x 0.00581 x 7.07e-06
