metrox-eth/moss/simulation/mujoco/model/meshes/XT30_distribution_lid.stl

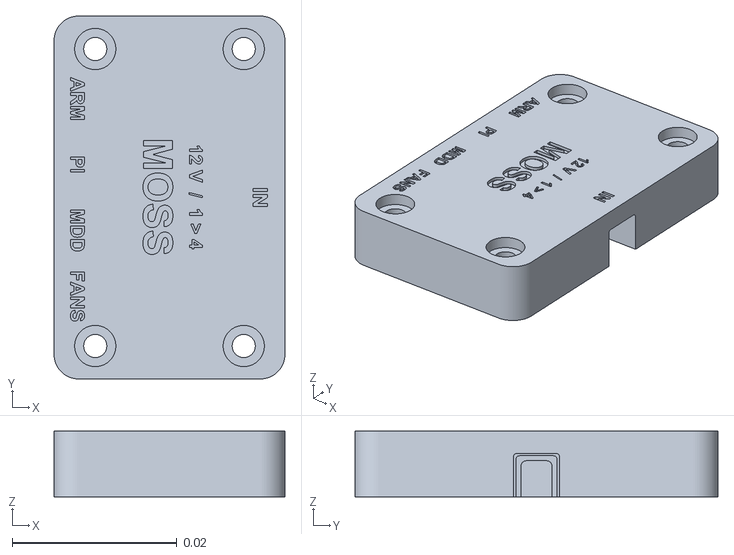
[picture p143: CAD file, 2026-10-26]
simulation/mujoco/model/meshes/XT30_distribution_lid.stl
0.028 x 0.044 x 0.008
