metrox-eth/moss/simulation/mujoco/model/meshes/collision/part_1005_043.stl

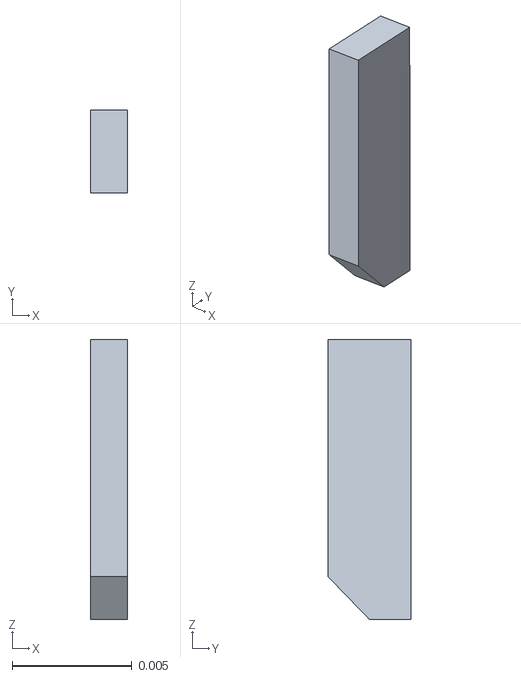
[picture p144: CAD file, 2026-10-26]
simulation/mujoco/model/meshes/collision/part_1005_043.stl
0.00154 x 0.00347 x 0.0117
