metrox-eth/moss/simulation/mujoco/model/meshes/Servo_housing_part_0282.stl

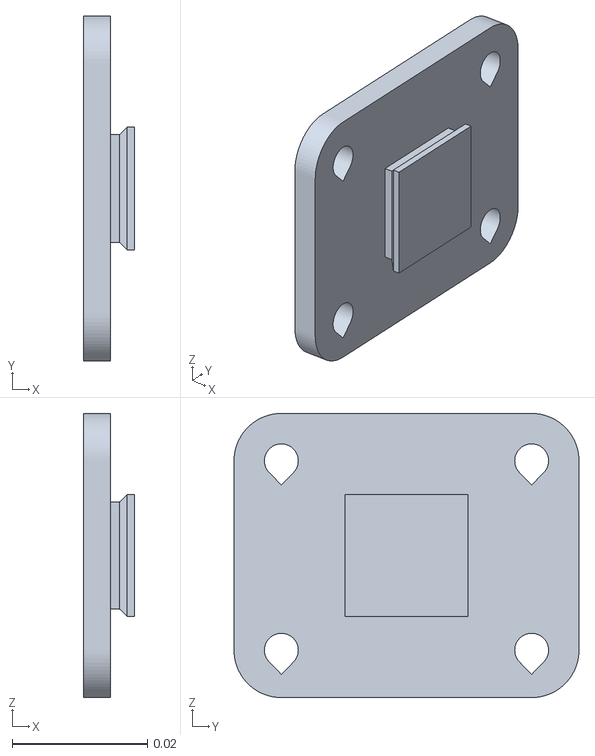
[picture p145: CAD file, 2026-10-26]
simulation/mujoco/model/meshes/Servo_housing_part_0282.stl
0.0076 x 0.051 x 0.042
