metrox-eth/moss/simulation/mujoco/model/meshes/collision/bin_016.stl

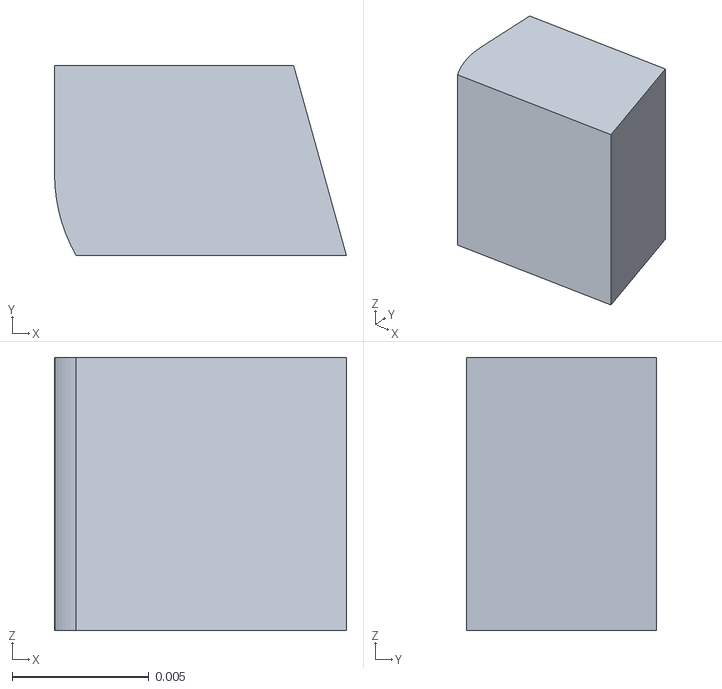
[picture p146: CAD file, 2026-10-26]
simulation/mujoco/model/meshes/collision/bin_016.stl
0.0107 x 0.00697 x 0.01
