metrox-eth/moss/(list of files, cad)

Other CAD files:
hardware/mechanical/moss-v0.7-hull/cad/Hull_MOSS_V07_Core_Stack.step
hardware/mechanical/moss-v0.7-hull/reference/Hull_Core_72x67.step
hardware/mechanical/moss-v0.7-hull/cad/Hull_MOSS_V07_Harness_Tie_Loops_PROTOTYPE.step
simulation/mujoco/model/meshes/Left_Spacer_tensioner_center.stl
simulation/mujoco/model/meshes/Right_22T_idler_wheel_inner_half_R13.stl
simulation/mujoco/model/meshes/NC90_Left_jaw_extended_rack.stl
simulation/mujoco/model/meshes/Servo_housing_part_0285.stl
simulation/mujoco/model/meshes/Left_Spacer_tensioner_inner_ID05_R24.stl
simulation/mujoco/model/meshes/05_Left_bearing_retainer.stl
simulation/mujoco/model/meshes/collision/part_0290_036.stl
simulation/mujoco/model/meshes/Servo_housing_part_0283.stl
simulation/mujoco/model/meshes/Left_Cover_tensioner_outer.stl
simulation/mujoco/model/meshes/Left_Spacer_road_wheel_-70_inner_ID01_R24.stl
simulation/mujoco/model/meshes/Right_Slider_outer.stl
simulation/mujoco/model/meshes/Right_Spacer_road_wheel_0_outer_ID02_R24.stl
simulation/mujoco/model/meshes/collision/part_0286_048.stl
simulation/mujoco/model/meshes/NC90_Right_side_shield.stl
simulation/mujoco/model/meshes/Right_625_road_wheel_-70_outer_half_R13.stl
simulation/mujoco/model/meshes/Motor_Mount_Left_R90.stl
simulation/mujoco/model/meshes/Right_Spacer_road_wheel_-70_outer_ID02_R24.stl
simulation/mujoco/model/meshes/Left_Spacer_road_wheel_-70_center.stl
simulation/mujoco/model/meshes/Right_625_road_wheel_0_inner_half_R13.stl
simulation/mujoco/model/meshes/Right_Spacer_drive_outer_HEX12_L12.6_ID04_R24.stl
simulation/mujoco/model/meshes/Left_22T_idler_wheel_outer_half_R13.stl
simulation/mujoco/model/meshes/Right_625_road_wheel_0_outer_half_R13.stl
simulation/mujoco/model/meshes/Left_Spacer_road_wheel_0_outer_ID02_R24.stl
simulation/mujoco/model/meshes/Right_Spacer_road_wheel_-70_inner_ID01_R24.stl
simulation/mujoco/model/meshes/Left_625_road_wheel_0_outer_half_R13.stl
simulation/mujoco/model/meshes/collision/part_0290_037.stl
simulation/mujoco/model/meshes/Left_Spacer_tensioner_retainer_inner_ID07_R24.stl
simulation/mujoco/model/meshes/collision/part_0321_062.stl
hardware/electronics/moss-core-v0.7/electrical/models/Connector_JST_JST_SH_BM06B-SRSS-TB_1x06-1MP_P1.00mm_Vertical.step
hardware/electronics/moss-core-v0.7/electrical/models/Connector_Molex_Molex_Micro-Fit_3.0_43045-0600_2x03_P3.00mm_Horizontal.step
hardware/electronics/moss-core-v0.7/electrical/models/Connector_Molex_Molex_Micro-Fit_3.0_43045-0612_2x03_P3.00mm_Vertical.step
hardware/electronics/moss-core-v0.7/electrical/models/Connector_Molex_Molex_Micro-Fit_3.0_43045-1000_2x05_P3.00mm_Horizontal.step
hardware/electronics/moss-core-v0.7/electrical/models/Connector_Molex_Molex_Micro-Fit_3.0_43045-1012_2x05_P3.00mm_Vertical.step
hardware/electronics/moss-core-v0.7/electrical/models/Inductor_SMD_L_Bourns_SRP6060FA.step
hardware/electronics/moss-core-v0.7/electrical/models/Littelfuse_0451001_MRL_VISUAL.step
hardware/electronics/moss-core-v0.7/electrical/models/Littelfuse_08853_15DR_VISUAL.step
hardware/electronics/moss-core-v0.7/electrical/models/Molex_22035035_VERTICAL_DIMENSIONED_REFERENCE.step
hardware/electronics/moss-core-v0.7/electrical/models/Package_SON_VSON-8-1EP_3x3mm_P0.65mm_EP1.65x2.4mm.step
hardware/electronics/moss-core-v0.7/electrical/models/RF_Module_ESP32-S3-WROOM-1U.step
hardware/electronics/moss-core-v0.7/electrical/models/XT30UPB-M_REFERENCE.step
hardware/electronics/moss-core-v0.7/harness/cad/HOCO_HB1_Visual_Reference.step
hardware/electronics/moss-core-v0.7/harness/cad/Hull_MOSS_V07_Harness_Tie_Loops_PROTOTYPE.step
hardware/electronics/moss-core-v0.7/harness/cad/Hull_MOSS_V07_Harness_Tie_Loops_PROTOTYPE.stl
hardware/electronics/moss-core-v0.7/harness/cad/MOSS_HARNESS_CENTRELINES.step
hardware/electronics/moss-core-v0.7/harness/cad/MOSS_HARNESS_ROUTING.step
hardware/electronics/moss-core-v0.7/harness/cad/Speaker_3W_4Ohm_R92_original.step
hardware/electronics/moss-core-v0.7/harness/cad/tie_anchor_fit_coupon.step
hardware/electronics/moss-core-v0.7/harness/cad/tie_anchor_fit_coupon.stl
hardware/electronics/moss-core-v0.7/kicad/models/AMASS_XT30PW_M_VISUAL.step
hardware/electronics/moss-core-v0.7/kicad/models/Bourns_CSS2H_2512K_2L00F_ENVELOPE.step
hardware/electronics/moss-core-v0.7/kicad/models/Diode_SMD_D_SOD-123.step
hardware/electronics/moss-core-v0.7/kicad/models/Diode_SMD_Nexperia_CFP3_SOD-123W.step
hardware/electronics/moss-core-v0.7/kicad/models/Inductor_SMD_L_Coilcraft_XAL4020-XXX.step
hardware/electronics/moss-core-v0.7/kicad/models/MAX98357A_TQFN16_BODY_ENVELOPE.step
hardware/electronics/moss-core-v0.7/kicad/models/Molex_22057035_VISUAL.step
hardware/electronics/moss-core-v0.7/kicad/models/Package_SO_MSOP-10_3x3mm_P0.5mm.step
hardware/electronics/moss-core-v0.7/kicad/models/Package_SO_TSSOP-8_4.4x3mm_P0.65mm.step
hardware/electronics/moss-core-v0.7/kicad/models/Package_SO_VSSOP-8_2.3x2mm_P0.5mm.step
hardware/electronics/moss-core-v0.7/kicad/models/Package_TO_SOT_SMD_SOT-323_SC-70.step
hardware/electronics/moss-core-v0.7/kicad/models/TerminalBlock_Phoenix_TerminalBlock_Phoenix_MKDS-1,5-2-5.08_1x02_P5.08mm_Horizontal.step
hardware/electronics/moss-core-v0.7/kicad/models/Vishay_SiRA99DP_PowerPAK_SO8_ENVELOPE.step
hardware/electronics/moss-core-v0.7/kicad/models/Waveshare_DC5_36_5V_PHOTO_BASED_VISUAL_a5a8c664b4a7.step
hardware/mechanical/dual-shoulder-r2/STL/02_Upper_Arm_Dual_R2.stl
hardware/mechanical/moss-v0.7-hull/cad/Hull_MOSS_V07_Core_74x71_EDITABLE.f3d
hardware/mechanical/moss-v0.7-hull/reference/Hull_Core_72x67.stl
hardware/mechanical/moss-v0.7-hull/stl/Hull_MOSS_V07_Harness_Tie_Loops_PROTOTYPE.stl
simulation/mujoco/model/meshes/02_Motor_access_hatch_10_screws.stl
simulation/mujoco/model/meshes/Jetson_Adapter_R87.stl
simulation/mujoco/model/meshes/Left_625_road_wheel_0_inner_half_R13.stl
simulation/mujoco/model/meshes/Left_625_road_wheel_70_inner_half_R13.stl
simulation/mujoco/model/meshes/Left_625_road_wheel_70_outer_half_R13.stl
simulation/mujoco/model/meshes/Left_HEX12_drive_wheel_inner_half_R13.stl
simulation/mujoco/model/meshes/Left_HEX12_drive_wheel_outer_half_R13.stl
simulation/mujoco/model/meshes/Left_Slider_outer.stl
simulation/mujoco/model/meshes/Left_Spacer_cross_member_-40.stl
simulation/mujoco/model/meshes/Left_Spacer_cross_member_40.stl
simulation/mujoco/model/meshes/Left_Spacer_road_wheel_70_center.stl
simulation/mujoco/model/meshes/Left_Spacer_road_wheel_70_inner_ID01_R24.stl
simulation/mujoco/model/meshes/Left_Spacer_road_wheel_70_outer_ID02_R24.stl
simulation/mujoco/model/meshes/Left_inner_tensioner_cover_R12_C2.stl
simulation/mujoco/model/meshes/Left_inner_track_frame_R12_C2.stl
simulation/mujoco/model/meshes/NC90_Pinion.stl
simulation/mujoco/model/meshes/Right_625_road_wheel_-70_inner_half_R13.stl
simulation/mujoco/model/meshes/Right_625_road_wheel_70_inner_half_R13.stl
simulation/mujoco/model/meshes/Right_625_road_wheel_70_outer_half_R13.stl
simulation/mujoco/model/meshes/Right_Cover_motor_bearing.stl
simulation/mujoco/model/meshes/Right_Cover_tensioner_outer.stl
simulation/mujoco/model/meshes/Right_Drive_bearing_to_collar_spacer_R12_C1.stl
simulation/mujoco/model/meshes/Right_HEX12_drive_wheel_inner_half_R13.stl
simulation/mujoco/model/meshes/Right_HEX12_drive_wheel_outer_half_R13.stl
simulation/mujoco/model/meshes/Right_Outer_Track_Frame_R32.stl
simulation/mujoco/model/meshes/Right_Spacer_cross_member_-40.stl
simulation/mujoco/model/meshes/Right_Spacer_cross_member_40.stl
simulation/mujoco/model/meshes/Right_Spacer_drive_inner_ID03_R24.stl
simulation/mujoco/model/meshes/Right_Spacer_road_wheel_-70_center.stl
simulation/mujoco/model/meshes/Right_Spacer_road_wheel_0_center.stl
simulation/mujoco/model/meshes/Right_Spacer_road_wheel_0_inner_ID01_R24.stl
simulation/mujoco/model/meshes/Right_Spacer_road_wheel_70_center.stl
simulation/mujoco/model/meshes/Right_Spacer_road_wheel_70_inner_ID01_R24.stl
simulation/mujoco/model/meshes/Right_Spacer_road_wheel_70_outer_ID02_R24.stl
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
