metrox-eth/moss/docs/build/README.md

# Build guide

[Open the MOSS build guide](https://www.showrobotics.ai/moss/build/) · [Written assembly cards](ASSEMBLY.md)

Each step lists the printed parts, components and fasteners to prepare. Seven short clips show part identification, exploded assemblies and road-wheel fastening.

[Grouped print list and quantities](printed_parts.csv) · [Original filename aliases](print_aliases.json). The current archive and both 3MF projects include the two Jetson retaining tabs.

[Ready-to-print 3MF projects](PRINT_PLATES.md) · [Complete package](https://github.com/metrox-eth/moss/releases/download/v0.6-r92/MOSS_R92_Mechanical_20261109.zip).

[Custom 3S4P battery tutorial](../../hardware/power/custom-3s4p-battery/) — optional twelve-cell EVE 21700 build, with parts, wiring and workshop photos. Read the disclaimer and check fit before building this larger pack.
