metrox-eth/moss/Assembly.md

# Assembly

Each step lists the printed parts, components and fasteners to prepare, followed by assembly instructions and the available clip. Quantities are for one rover unless stated otherwise.

[Visual guide](https://www.showrobotics.ai/moss/build/#assembly) · [Step-by-step instructions](docs/build/ASSEMBLY.md) · [Spacer and shaft-collar references](docs/build/PART_REFERENCES.md)

**Optional battery build:** [Custom 3S4P pack tutorial](hardware/power/custom-3s4p-battery/) — parts, photos, wiring, assembly and initial checks. Read its workshop disclaimer before starting; the larger pack's fit must be checked separately from the compact battery listed in the original BOM.

**Power wiring:** the complete rear charging connection must carry **5 A continuous**. The main switch carries the rover load (**15 A design requirement**), not just the charger current. See the [charging path and switch requirements](hardware/power/custom-3s4p-battery/#rear-charging-port-and-cable).
