metrox-eth/moss/docs/build/index.html

BUILD GUIDE

# Prepare. Watch. Assemble.

Print the parts you need and order the components. When you’re ready to build, take it one step at a time and follow the instructions.

Print catalogueComponents & BOMAssembly guideCAD & STL files

## MOSS kits are coming soon on TNKR (https://tnkr.ai/).

Skip printing and sourcing the parts yourself.

Join the waitlist → (https://ak4khuvxkya.typeform.com/to/qaKmXNME)

Version V0.6 - R92

106–111Catalogue pieces, by options

## Assembly steps

20 assembly cards. Quantities are for one rover unless a step explicitly says “per wheel”. Computer and camera options are alternatives.

ShowWritten guide

Identify every spacer and lock ring

SP01–SP12 and LK05/LK06/LK08: dimensions and matching STLs · Reference sheet · Spacer locations

01Choose the hull and fit the inserts

Current R92 split hull, motor/computer half and battery/camera half

Prepare | Qty
One-piece hull (https://github.com/metrox-eth/moss/releases/download/v0.6-r92/Hull_R92.stl) · PETG | 1
Lidar Base R84 (https://github.com/metrox-eth/moss/releases/download/v0.6-r92/Lidar_Base_R84.stl) · PETG | 1
Rear hull — motors and computer (https://github.com/metrox-eth/moss/releases/download/v0.6-r92/Hull_R92_Split_Rear_Motor_Computer.stl) · PETG | 1
Front hull — battery and camera (https://github.com/metrox-eth/moss/releases/download/v0.6-r92/Hull_R92_Split_Front_Battery_Camera.stl) · PETG | 1
Epoxy from the two-part kit, for the hull joint | As needed
M3 heat-set insert, OD4 mm, length 6 mm | 11
Split hull only: M4 × 15 socket-head screw | 6
Split hull only: M4 hex nut, 7 mm across flats | 6
Split hull only: M4 washer, Ø9 × 0.8 mm | 6

1. Choose the one-piece hull or both split halves. For the split hull, dry-fit both halves first, then apply a thin layer of two-part epoxy to the mating faces. Engage the locating pins, seat six nuts from the battery side, and fit six M4 × 15 screws with washers from the motor/computer side. Tighten progressively and let the epoxy cure before installing electronics or the battery.
2. Use a soldering iron to fit the inserts: place each insert over its hole, heat it with the iron tip, then gently press it straight into the plastic. Fit four inserts for the cover, four for the arm plate and two for the LiDAR base in the hull.
3. Use the same soldering-iron method to fit the remaining insert in the LiDAR base for the carriage lock. Keep the threads clear and let all inserts cool before fitting screws.

02Build the six road wheels

Fastening

Prepare | Qty
Road wheel inner half (https://github.com/metrox-eth/moss/releases/download/v0.6-r92/Road_Wheel_Inner_Half_R13.stl) · PETG | 6
Road wheel outer half (https://github.com/metrox-eth/moss/releases/download/v0.6-r92/Road_Wheel_Outer_Half_R13.stl) · PETG | 6
SP09 · Road wheel centre spacer (https://github.com/metrox-eth/moss/releases/download/v0.6-r92/SP09_Road_Wheel_Centre_Spacer.stl) · PETG | 6
625 bearing | 12
M3 × 35 socket-head screw | 18
M3 hex nut | 18

1. For each wheel, prepare two printed halves, one SP09 centre spacer, two 625 bearings, three M3 × 35 screws and three M3 nuts.
2. Insert each bearing through the open mating face of its wheel half. Do not push it through the smaller outside opening.
3. Seat the three nuts in the inner half, position SP09 between the bearings, close the wheel halves, then insert the three screws from the outer face. Repeat six times.

03Build the two drive wheels

Prepare | Qty
Left HEX12 drive wheel inner half R13 (https://github.com/metrox-eth/moss/releases/download/v0.6-r92/Left_HEX12_drive_wheel_inner_half_R13.stl) · PETG | 1
Left HEX12 drive wheel outer half R13 (https://github.com/metrox-eth/moss/releases/download/v0.6-r92/Left_HEX12_drive_wheel_outer_half_R13.stl) · PETG | 1
Right HEX12 drive wheel inner half R13 (https://github.com/metrox-eth/moss/releases/download/v0.6-r92/Right_HEX12_drive_wheel_inner_half_R13.stl) · PETG | 1
Right HEX12 drive wheel outer half R13 (https://github.com/metrox-eth/moss/releases/download/v0.6-r92/Right_HEX12_drive_wheel_outer_half_R13.stl) · PETG | 1
HEX12 metal hub, 6 mm bore, 18 mm length | 2
M3 × 20 socket-head screw | 6
M3 hex nut | 6

1. Match the locating feature on each pair of halves.
2. Close each wheel with three M3 × 20 screws and three M3 nuts. Keep the HEX12 seat clear.

04Build the two idler wheels

Prepare | Qty
Left 22T idler wheel inner half R13 (https://github.com/metrox-eth/moss/releases/download/v0.6-r92/Left_22T_idler_wheel_inner_half_R13.stl) · PETG | 1
Left 22T idler wheel outer half R13 (https://github.com/metrox-eth/moss/releases/download/v0.6-r92/Left_22T_idler_wheel_outer_half_R13.stl) · PETG | 1
Right 22T idler wheel inner half R13 (https://github.com/metrox-eth/moss/releases/download/v0.6-r92/Right_22T_idler_wheel_inner_half_R13.stl) · PETG | 1
Right 22T idler wheel outer half R13 (https://github.com/metrox-eth/moss/releases/download/v0.6-r92/Right_22T_idler_wheel_outer_half_R13.stl) · PETG | 1
SP10 · Idler centre spacer (https://github.com/metrox-eth/moss/releases/download/v0.6-r92/SP10_Idler_Centre_Spacer.stl) · PETG | 2
608 bearing | 4
M3 × 25 socket-head screw | 6
M3 hex nut | 6

1. For each idler, seat two 608 bearings with SP10 (centre spacer) between them.
2. Close the two halves with three M3 × 25 screws and three M3 nuts. Repeat for the other side.

05Fit the motors and inner bearing retainers

Choose the correct motor version. JGB37-520 is a motor family, not a complete specification. This build uses the 12 V, 110 rpm output, 90:1 version with a Hall encoder and a 6 mm D-shaft. Check the voltage and output speed on the supplier listing and motor label; the gearbox ratio alone does not identify the version. Do not connect a 6 V motor to the rover battery following this guide.

Prepare | Qty
Motor Mount Left R90 (https://github.com/metrox-eth/moss/releases/download/v0.6-r92/Motor_Mount_Left_R90.stl) · PETG | 1
Motor Mount Right R90 (https://github.com/metrox-eth/moss/releases/download/v0.6-r92/Motor_Mount_Right_R90.stl) · PETG | 1
Motor bearing inner retainer (https://github.com/metrox-eth/moss/releases/download/v0.6-r92/Motor_Bearing_Inner_Retainer.stl) · PETG | 2
JGB37-520 motor, 12 V, 90:1, 110 rpm, Hall encoder | 2
626 bearing, inner | 2
Rigid coupling, 6 mm to6 mm | 2
M4 × 20 socket-head screw | 8
M4 hex nut | 8
M3 × 8 socket-head screw | 12

1. Use three M3 × 8 screws per motor, without washers. The other six M3 × 8 screws secure the two bearing retainers.
2. Put four M4 nuts into each motor-support nut pocket and secure each support to the hull with four M4 × 20 screws.
3. Fit the inner bearing retainers with three M3 × 8 screws per side.

06Fit the inner track frames

Prepare | Qty
Left inner track frame R12 C2 (https://github.com/metrox-eth/moss/releases/download/v0.6-r92/Left_inner_track_frame_R12_C2.stl) · PETG | 1
Right inner track frame R12 C2 (https://github.com/metrox-eth/moss/releases/download/v0.6-r92/Right_inner_track_frame_R12_C2.stl) · PETG | 1
M4 × 15 socket-head screw | 6
M4 hex nut | 6

1. Fit each inner frame directly against the hull.
2. Use three M4 × 15 screws and three M4 nuts per side.

07Fit road-wheel axles and spacer pairs

Exploded assembly

Prepare | Qty
SP01 · Road wheel inner spacer (https://github.com/metrox-eth/moss/releases/download/v0.6-r92/SP01_Road_Wheel_Inner_Spacer.stl) · PETG | 6
SP02 · Road wheel outer spacer (https://github.com/metrox-eth/moss/releases/download/v0.6-r92/SP02_Road_Wheel_Outer_Spacer.stl) · PETG | 6
Smooth steel axle, 5 x70 mm finished length | 6
LK05 — shaft collar: 5 mm bore, 10 mm outside diameter, 5 mm long | 12

1. Use SP01 (1 dot, 7.5 mm) on the inside and SP02 (2 dots, 5.5 mm) on the outside of every road wheel. SP09 (18 mm, no dots) sits between its bearings.
2. Retain each axle with two LK05 collars (5 mm bore). Repeat for all six wheels and check free rotation.

08Fit the drive axles and outer bearing covers

Exploded assembly

Prepare | Qty
SP03 · Drive motor side spacer (https://github.com/metrox-eth/moss/releases/download/v0.6-r92/SP03_Drive_Inner_Spacer.stl) · PETG | 2
SP04 · Drive outer spacer (https://github.com/metrox-eth/moss/releases/download/v0.6-r92/SP04_Drive_Outer_Spacer.stl) · PETG | 2
Motor bearing outer cover (https://github.com/metrox-eth/moss/releases/download/v0.6-r92/Motor_Bearing_Outer_Cover.stl) · PETG | 2
SP11 · Drive bearing to collar spacer (https://github.com/metrox-eth/moss/releases/download/v0.6-r92/SP11_Drive_Bearing_To_Collar_Spacer.stl) · PETG | 2
Smooth steel axle, 6 x77 mm finished length | 2
626 bearing, outer | 2
LK06 — shaft collar: 6 mm bore, 11 mm outside diameter, 5 mm long | 2
M3 × 15 socket-head screw | 6
M3 hex nut | 6

1. Use SP03 (3 dots, 7.6 mm) on the motor side and SP04 (4 dots, 12.6 mm) on the outer side of the drive wheel.
2. Put SP11 (3.5 mm, no dots) between the outer 626 bearing and LK06 (6 mm bore). Secure each bearing cover with three M3 × 15 screws and nuts.

09Fit the idler slides and tensioners

Exploded assembly

Prepare | Qty
Left inner tensioner cover R12 C2 (https://github.com/metrox-eth/moss/releases/download/v0.6-r92/Left_inner_tensioner_cover_R12_C2.stl) · PETG | 1
Right inner tensioner cover R12 C2 (https://github.com/metrox-eth/moss/releases/download/v0.6-r92/Right_inner_tensioner_cover_R12_C2.stl) · PETG | 1
SP05 · Idler inner spacer (https://github.com/metrox-eth/moss/releases/download/v0.6-r92/SP05_Idler_Inner_Spacer.stl) · PETG | 2
SP06 · Idler outer spacer (https://github.com/metrox-eth/moss/releases/download/v0.6-r92/SP06_Idler_Outer_Spacer.stl) · PETG | 2
Left Cover tensioner outer (https://github.com/metrox-eth/moss/releases/download/v0.6-r92/Left_Cover_tensioner_outer.stl) · PETG | 1
Right Cover tensioner outer (https://github.com/metrox-eth/moss/releases/download/v0.6-r92/Right_Cover_tensioner_outer.stl) · PETG | 1
Tensioner slider (https://github.com/metrox-eth/moss/releases/download/v0.6-r92/Tensioner_Slider.stl) · PETG | 4
SP07 · Idler inner retainer spacer (https://github.com/metrox-eth/moss/releases/download/v0.6-r92/SP07_Idler_Inner_Retainer_Spacer.stl) · PETG | 2
SP08 · Idler outer retainer spacer (https://github.com/metrox-eth/moss/releases/download/v0.6-r92/SP08_Idler_Outer_Retainer_Spacer.stl) · PETG | 2
Smooth steel axle, 8 x87 mm finished length | 2
LK08 — shaft collar: 8 mm bore, 16 mm outside diameter, 8 mm long | 4
M3 × 15 socket-head screw | 16
M3 hex nut | 16
M4 × 35 socket-head screw | 4
M4 hex nut | 8
M4 washer | 4

1. Inside to outside: LK08, SP07, inner slider, SP05, idler wheel with SP10 between its bearings, SP06, outer slider, SP08, LK08. Use two LK08 collars (8 mm bore) per axle.
2. Fit each tensioner cover with four M3 × 15 screws and nuts. Use an M4 × 35 adjuster with its washer and two nuts at each of the four tensioners.
3. All four tensioner sliders are the same printed part. Rotate each to match its inner or outer assembly position.

10Close the track frames

Exploded assembly

Prepare | Qty
Left Outer Track Frame R32 (https://github.com/metrox-eth/moss/releases/download/v0.6-r92/Left_Outer_Track_Frame_R32.stl) · PETG | 1
Right Outer Track Frame R32 (https://github.com/metrox-eth/moss/releases/download/v0.6-r92/Right_Outer_Track_Frame_R32.stl) · PETG | 1
SP12 · Track frame cross-member spacer (https://github.com/metrox-eth/moss/releases/download/v0.6-r92/SP12_Frame_Cross_Member_Spacer.stl) · PETG | 4
M4 × 60 socket-head screw | 4
M4 hex nut | 4
M4 washer | 4

1. Put the two SP12 cross-member spacers (41 mm, no dots) in each side assembly.
2. Fit the outer frame using two M4 × 60 screws, washers and nuts per side.

11Fit the tracks

Prepare | Qty
Track · 70 teeth (https://github.com/metrox-eth/moss/releases/download/v0.6-r92/Track_R78_70_Teeth.stl) · TPU | 2

1. Use the 70-tooth track print masters supplied in this package.
2. Seat the central guides in the wheel grooves. Adjust both ends evenly and turn each track by hand.

12Fit the driver and controller

Prepare | Qty
Cytron MDD10A Rev2 dual motor driver | 1
Adafruit QT Py ESP32-S3, 5426 | 1
Adafruit Terminal Block BFF, 6495 | 1
Adafruit INA219 STEMMA QT, 904 | 1
M3 × 6 socket-head screw | 4
M2 × 6 screw, non-countersunk | 6
M2 washer, 0.3 mm thick | 6

1. Secure the MDD10A with four M3 × 6 screws.
2. Use four M2 × 6 screws and 0.3 mm washers for the BFF, and two of each for the INA219.

13Fit the speaker and amplifier

Prepare | Qty
Speaker, 3 W, 4 ohm, 2-pin connector with 2 mm pitch | 1
MAX98357A amplifier module | 1
Splash-resistant acoustic membrane, fitted to the inner grille lip | 1
M3 × 6 socket-head screw | 2
M2 × 6 screw, non-countersunk | 2
M2 washer, 0.5 mm thick | 2

1. Fix the speaker with two M3 × 6 screws above its grille.
2. Seat the amplifier on its two mounting posts and two support pillars. Use two M2 × 6 screws with 0.5 mm washers.

14Fit the computer carrier and servo adapter

Prepare | Qty
Pi Adapter R87 (https://github.com/metrox-eth/moss/releases/download/v0.6-r92/Pi_Adapter_R87.stl) · PETG | 1
Jetson Adapter R87 (https://github.com/metrox-eth/moss/releases/download/v0.6-r92/Jetson_Adapter_R87.stl) · PETG | 1
JT01 · Jetson retaining tab 1 (https://github.com/metrox-eth/moss/releases/download/v0.6-r92/Jetson_Retaining_Tab_1_R92.stl) · PETG | 1
JT02 · Jetson retaining tab 2 (https://github.com/metrox-eth/moss/releases/download/v0.6-r92/Jetson_Retaining_Tab_2_R92.stl) · PETG | 1
Waveshare Bus Servo Adapter A | 1
Pi only: HAT mounting screws and spacers, supplied with the HAT | 1 kit
M3 × 6 socket-head screw | 2
M3 × 8 socket-head screw | 2
M3 washer, 0.5 mm thick | 4
M2.5 × 8 screw, non-countersunk | 4
M2.5 washer, 0.5 mm thick | 4
Jetson only: M3 × 8 socket-head screw, no washer | 2

1. Choose one carrier: Jetson or Pi.
2. Use the two M3 × 6 screws at the front and the two M3 × 8 screws at the rear, with one 0.5 mm washer each.
3. For Jetson, secure the two retaining tabs with two M3 × 8 screws, without washers.
4. For Pi/HAT, use the screws and spacers supplied with the HAT; prepare this assembly before fitting the carrier in the hull.

15Fit the camera option

Prepare | Qty
Gemini Window Adapter R89 (https://github.com/metrox-eth/moss/releases/download/v0.6-r92/Gemini_Window_Adapter_R89.stl) · PETG | 1
RealSense Insert R72 (https://github.com/metrox-eth/moss/releases/download/v0.6-r92/RealSense_Insert_R72.stl) · PETG | 1
Gemini Flush Insert R72 (https://github.com/metrox-eth/moss/releases/download/v0.6-r92/Gemini_Flush_Insert_R72.stl) · PETG | 1
RealSense D455 OR Orbbec Gemini 2 | 1
RealSense only: M4 × 10 socket-head screw | 2
Gemini only: M3 × 8 socket-head screw | 2

1. For RealSense, slide the support insert down from the top, then use its two M4 × 10 screws.
2. For Gemini, use the flush insert and the window bezel instead. Secure the camera with two M3 × 8 screws; keep the USB opening clear.

16Fit the LiDAR carriage

Prepare | Qty
Lidar dovetail carriage R21 (https://github.com/metrox-eth/moss/releases/download/v0.6-r92/Lidar_dovetail_carriage_R21.stl) · PETG | 1
SLAMTEC RPLIDAR C1 | 1
M3 × 10 socket-head screw | 2
M2.5 × 6 socket-head screw | 4
M3 × 20 socket-head screw | 1

1. With the carriage removed, secure the LiDAR base to the hull with two M3 × 10 screws.
2. Secure the C1 to the carriage with four M2.5 × 6 screws, slide it onto the base and lock it with the M3 × 20 screw, without a washer, into the M3 insert.

17Fit power distribution and cooling

Exploded assembly

Prepare | Qty
XT30 distribution base (https://github.com/metrox-eth/moss/releases/download/v0.6-r92/XT30_distribution_base.stl) · PETG | 1
XT30 distribution lid (https://github.com/metrox-eth/moss/releases/download/v0.6-r92/XT30_distribution_lid.stl) · PETG | 1
XT30 insulating separator (https://github.com/metrox-eth/moss/releases/download/v0.6-r92/XT30_insulating_separator.stl) · PETG | 1
3010 fan, 12 V | 2
12-cell battery pack, 3S4P, with BMS, 110 × 67 × 35 mm | 1
Power harness wire, fuse, switches and USB cables | 1
DC male barrel plug, 5.5 × 2.5 mm, 9.5 mm barrel, centre positive — Jetson power | 1
DC male barrel plug matching the input of the Pi 5 V power supply | 1
DC male barrel plug, 5.5 × 2.1 mm — Waveshare Bus Servo Adapter A power | 1
Internal charging lead, 5.5 × 2.1 mm male, 18 AWG | 1
DC099 rear charging socket, 5.5 × 2.1 mm, 11 mm mounting hole | 1
Battery female charging lead, 5.5 × 2.1 mm, 18 AWG | 1
XT30 enclosure connectors: 1 input + 4 outputs, from the BOM connector pairs | 5
M2.5 × 10 low-head screw, head diameter 5 mm maximum | 4

1. Clip the two fans into their mounts.
2. Assemble the XT30 base, insulating separator and lid with four low-head M2.5 × 10 screws.
3. Use a DC099 5.5 × 2.1 mm rear charging socket (11 mm mounting hole), an 18 AWG internal male lead and an 18 AWG female lead on the battery. The complete connection, including both pairs of contacts, must support the 5 A charger. Keep the rover power connection on XT30.
4. Fit the round KCD1-5-101EN main switch in the 20 mm opening. This replaces the small KCD11. The selected supplier lists 20 A at 12 V DC. Use the optional splash cap if available. Keep the existing 15 A pack fuse and main power wiring.

Rear charging path, parts and wiring (https://github.com/metrox-eth/moss/tree/main/hardware/power/custom-3s4p-battery)

18Fit the arm plate and build the arm

Prepare | Qty
Arm Mounting Platform R22 (https://github.com/metrox-eth/moss/releases/download/v0.6-r92/Arm_Mounting_Platform_R22.stl) · PLA | 1
SO101 Base (https://github.com/metrox-eth/moss/releases/download/v0.6-r92/SO101_Base.stl) · PLA | 1
SO101 Shoulder rotation (https://github.com/metrox-eth/moss/releases/download/v0.6-r92/SO101_Shoulder_rotation.stl) · PLA | 1
SO101 Base motor holder (https://github.com/metrox-eth/moss/releases/download/v0.6-r92/SO101_Base_motor_holder.stl) · PLA | 1
SO101 Shoulder bracket cable clip (https://github.com/metrox-eth/moss/releases/download/v0.6-r92/SO101_Shoulder_bracket_cable_clip.stl) · PLA | 1
SO101 Upper arm cable clip (https://github.com/metrox-eth/moss/releases/download/v0.6-r92/SO101_Upper_arm_cable_clip.stl) · PLA | 1
SO101 Forearm cable clip (https://github.com/metrox-eth/moss/releases/download/v0.6-r92/SO101_Forearm_cable_clip.stl) · PLA | 1
SO101 Wrist cable clip (https://github.com/metrox-eth/moss/releases/download/v0.6-r92/SO101_Wrist_cable_clip.stl) · PLA | 1
SO101 Wrist bracket (https://github.com/metrox-eth/moss/releases/download/v0.6-r92/SO101_Wrist_bracket.stl) · PLA | 1
ST3215 12 V serial bus servo | 5
M3 × 10 socket-head screw | 4
M4 × 25 countersunk 90-degree screw | 4
M4 hex nut | 4
Kit screw: M2 × 6, original servo head | 20
Kit screw: M3 × 6, original servo head | 37

1. Fit the arm plate with four M3 × 10 socket-head screws. Do not add washers in the counterbores.
2. Use the original servo screw packs for the SO101 joints. Keep the camera and servo cables in the printed guides.
3. For the wrist-camera cable, heat the printed clips to 70 °C, then close them around the cable.

19Build the gripper and wrist camera

Prepare | Qty
NC90 Right side shield (https://github.com/metrox-eth/moss/releases/download/v0.6-r92/NC90_Right_side_shield.stl) · PLA | 1
NC90 Pinion (https://github.com/metrox-eth/moss/releases/download/v0.6-r92/NC90_Pinion.stl) · PLA | 1
NC90 Cable guide (https://github.com/metrox-eth/moss/releases/download/v0.6-r92/NC90_Cable_guide.stl) · PLA | 1
NC90 Right jaw extended rack (https://github.com/metrox-eth/moss/releases/download/v0.6-r92/NC90_Right_jaw_extended_rack.stl) · PLA | 1
Gripper Camera Mount R30 (https://github.com/metrox-eth/moss/releases/download/v0.6-r92/Gripper_Camera_Mount_R30.stl) · PLA | 1
NC90 Left side shield (https://github.com/metrox-eth/moss/releases/download/v0.6-r92/NC90_Left_side_shield.stl) · PLA | 1
NC90 Base extended rails (https://github.com/metrox-eth/moss/releases/download/v0.6-r92/NC90_Base_extended_rails.stl) · PLA | 1
NC90 Left jaw extended rack (https://github.com/metrox-eth/moss/releases/download/v0.6-r92/NC90_Left_jaw_extended_rack.stl) · PLA | 1
CF35-12 gripper servo | 1
Wrist USB camera for the R30 mount, 21 × 13.5 mm PCB hole pattern | 1
Kit screw: M3 × 6 cross-head ISO7045 | 11
Kit screw: #1-42 x3/16 inch typeAB | 6
M2 × 6 screw, non-countersunk, for wrist camera PCB | 4
M3 × 10 socket-head screw, for wrist camera bracket | 2
M3 hex nut, for wrist camera bracket | 2

1. Use the widened NC90 jaws and rails, keeping the two racks in phase.
2. Fit the current camera mount. Retain the original gripper screw types.
3. Fix the R30 camera bracket to the gripper with two M3 × 10 screws and two M3 nuts, without washers. Fix the matching camera PCB with four M2 × 6 screws.

20Close the hull and fit the bin

Two-piece upper cover: lower the LiDAR extension into the two dovetail sockets from above

Prepare | Qty
02 Motor access hatch 10 screws (https://github.com/metrox-eth/moss/releases/download/v0.6-r92/02_Motor_access_hatch_10_screws.stl) · PETG | 1
One-piece upper cover (https://github.com/metrox-eth/moss/releases/download/v0.6-r92/Upper_cover_R9.stl) · PLA | 1
14 Bin 20x10x2 magnet pockets (https://github.com/metrox-eth/moss/releases/download/v0.6-r92/14_Bin_20x10x2_magnet_pockets.stl) · PLA | 1
Split cover · rear section (https://github.com/metrox-eth/moss/releases/download/v0.6-r92/Upper_Cover_R10_Rear.stl) · PLA | 1
Split cover · LiDAR extension (https://github.com/metrox-eth/moss/releases/download/v0.6-r92/Upper_Cover_R10_Lidar_Extension.stl) · PLA | 1
Magnet, 20 x10 x2 mm | 4
Small two-part epoxy adhesive kit, two tubes (resin + hardener), for the magnets and split cover | 1 kit
M3 × 10 countersunk 90-degree screw, head diameter 6.4 mm maximum | 10
M3 × 10 countersunk 90-degree screw, head diameter 5.6 mm maximum | 4

1. For the split cover: test-fit the two pieces off the rover. Lower the LiDAR extension from above into both dovetail sockets. Apply a thin layer of two-part epoxy on the mating faces, seat the joint, align the outer surfaces and hold until cured. The glued cover then mounts with the same four screws as the one-piece cover.
2. Close the motor hatch with ten M3 × 10 countersunk screws.
3. Fit the upper cover with four M3 × 10 countersunk screws.
4. Check the polarity of all four magnets, then glue them into their pockets with epoxy. Let the epoxy cure before fitting the bin.

## Your print set

### H2S · One-piece hull and cover

21 plates · Print 1–17, then choose 18 Jetson or 19 Pi, and 20 Gemini or 21 RealSense.

Download H2S 3MF (https://github.com/metrox-eth/moss/releases/download/v0.6-r92/MOSS_V06_R92_H2S_Print_Plates.3mf)

### P1 / P2 · Split hull and cover

24 plates · Print 1–20, then choose 21 Jetson or 22 Pi, and 23 Gemini or 24 RealSense.

Download P1 / P2 3MF (https://github.com/metrox-eth/moss/releases/download/v0.6-r92/MOSS_V06_R92_256mm_Split_Print_Plates.3mf)

P1S · P1P · P2S

Open one project in Bambu Studio. All copies are already placed; choose your computer and camera plates. Both projects include the Jetson tabs.

View every plate and its contents → · Plate selection guide

One card per shared part: download the STL once and print the quantity shown. Left/right-specific parts remain separate. The current archive includes both Jetson retaining tabs, JT01 and JT02.

Standard 0.20 mm settings with automatic tree supports. 15% gyroid infill; including the TPU tracks.

HullCoverComputerDepth cameraFind a part106 piecesGroup overview image

Each preview uses the supplied STL orientation. Choose a hull, cover, camera and computer option. Material is shown on every part. Two-piece hull · Two-piece cover · Outer-frame diagonal placement.

### Hull options

One-piece hull in its print orientation

### One-piece hull

PETG · Print 1

Download STL (https://github.com/metrox-eth/moss/releases/download/v0.6-r92/Hull_R92.stl)

Orientation

Flat exterior base down

Rear hull — motors and computer in its print orientation

### Rear hull — motors and computer

PETG · Print 1

Download STL (https://github.com/metrox-eth/moss/releases/download/v0.6-r92/Hull_R92_Split_Rear_Motor_Computer.stl)

Orientation

Flat exterior base down

Front hull — battery and camera in its print orientation

### Front hull — battery and camera

PETG · Print 1

Download STL (https://github.com/metrox-eth/moss/releases/download/v0.6-r92/Hull_R92_Split_Front_Battery_Camera.stl)

Orientation

Flat exterior base down

### Outer track frames

Print the outer frames separately on the front-right to rear-left diagonal. The STLs are already rotated. Placement guide.

Outer frames placed front-right to rear-left, clear of the front-left excluded zone

Left Outer Track Frame R32 in its print orientation

### Left Outer Track Frame R32

PETG · Print 1

Download STL (https://github.com/metrox-eth/moss/releases/download/v0.6-r92/Left_Outer_Track_Frame_R32.stl)

Orientation

Flat, 45 degrees: front-right to rear-left diagonal; centre on the plate. Supplied STL is already rotated. Print each outer frame separately.

Right Outer Track Frame R32 in its print orientation

### Right Outer Track Frame R32

PETG · Print 1

Download STL (https://github.com/metrox-eth/moss/releases/download/v0.6-r92/Right_Outer_Track_Frame_R32.stl)

Orientation

Flat, 45 degrees: front-right to rear-left diagonal; centre on the plate. Supplied STL is already rotated. Print each outer frame separately.

Left inner tensioner cover R12 C2 in its print orientation

### Left inner tensioner cover R12 C2

PETG · Print 1

Download STL (https://github.com/metrox-eth/moss/releases/download/v0.6-r92/Left_inner_tensioner_cover_R12_C2.stl)

Orientation

Existing print contact face retained

Right inner tensioner cover R12 C2 in its print orientation

### Right inner tensioner cover R12 C2

PETG · Print 1

Download STL (https://github.com/metrox-eth/moss/releases/download/v0.6-r92/Right_inner_tensioner_cover_R12_C2.stl)

Orientation

Existing print contact face retained

### Inner track frames

Left inner track frame R12 C2 in its print orientation

### Left inner track frame R12 C2

PETG · Print 1

Download STL (https://github.com/metrox-eth/moss/releases/download/v0.6-r92/Left_inner_track_frame_R12_C2.stl)

Orientation

Existing print contact face retained

Right inner track frame R12 C2 in its print orientation

### Right inner track frame R12 C2

PETG · Print 1

Download STL (https://github.com/metrox-eth/moss/releases/download/v0.6-r92/Right_inner_track_frame_R12_C2.stl)

Orientation

Existing print contact face retained

### Motor bay & LiDAR mounts

02 Motor access hatch 10 screws in its print orientation

### 02 Motor access hatch 10 screws

PETG · Print 1

Download STL (https://github.com/metrox-eth/moss/releases/download/v0.6-r92/02_Motor_access_hatch_10_screws.stl)

Orientation

Existing print contact face retained

Motor Mount Left R90 in its print orientation

### Motor Mount Left R90

PETG · Print 1

Download STL (https://github.com/metrox-eth/moss/releases/download/v0.6-r92/Motor_Mount_Left_R90.stl)

Orientation

Broad motor-facing flat face down

Motor Mount Right R90 in its print orientation

### Motor Mount Right R90

PETG · Print 1

Download STL (https://github.com/metrox-eth/moss/releases/download/v0.6-r92/Motor_Mount_Right_R90.stl)

Orientation

Broad motor-facing flat face down

Motor bearing inner retainer in its print orientation

### Motor bearing inner retainer

PETG · Print 2

Download STL (https://github.com/metrox-eth/moss/releases/download/v0.6-r92/Motor_Bearing_Inner_Retainer.stl)

Orientation

Existing print contact face retained

Lidar Base R84 in its print orientation

### Lidar Base R84

PETG · Print 1

Download STL (https://github.com/metrox-eth/moss/releases/download/v0.6-r92/Lidar_Base_R84.stl)

Orientation

Flat base down

Lidar dovetail carriage R21 in its print orientation

### Lidar dovetail carriage R21

PETG · Print 1

Download STL (https://github.com/metrox-eth/moss/releases/download/v0.6-r92/Lidar_dovetail_carriage_R21.stl)

Orientation

Existing print contact face retained

### All 38 spacers

SP12 · Track frame cross-member spacer in its print orientation

### SP12 · Track frame cross-member spacer

PETG · Print 4

Download STL (https://github.com/metrox-eth/moss/releases/download/v0.6-r92/SP12_Frame_Cross_Member_Spacer.stl)

Orientation

Existing print contact face retained

SP01 · Road wheel inner spacer in its print orientation

### SP01 · Road wheel inner spacer

PETG · Print 6

Download STL (https://github.com/metrox-eth/moss/releases/download/v0.6-r92/SP01_Road_Wheel_Inner_Spacer.stl)

Orientation

Existing print contact face retained

SP05 · Idler inner spacer in its print orientation

### SP05 · Idler inner spacer

PETG · Print 2

Download STL (https://github.com/metrox-eth/moss/releases/download/v0.6-r92/SP05_Idler_Inner_Spacer.stl)

Orientation

Existing print contact face retained

SP03 · Drive motor side spacer in its print orientation

### SP03 · Drive motor side spacer

PETG · Print 2

Download STL (https://github.com/metrox-eth/moss/releases/download/v0.6-r92/SP03_Drive_Inner_Spacer.stl)

Orientation

Existing print contact face retained

SP02 · Road wheel outer spacer in its print orientation

### SP02 · Road wheel outer spacer

PETG · Print 6

Download STL (https://github.com/metrox-eth/moss/releases/download/v0.6-r92/SP02_Road_Wheel_Outer_Spacer.stl)

Orientation

Existing print contact face retained

SP06 · Idler outer spacer in its print orientation

### SP06 · Idler outer spacer

PETG · Print 2

Download STL (https://github.com/metrox-eth/moss/releases/download/v0.6-r92/SP06_Idler_Outer_Spacer.stl)

Orientation

Existing print contact face retained

SP04 · Drive outer spacer in its print orientation

### SP04 · Drive outer spacer

PETG · Print 2

Download STL (https://github.com/metrox-eth/moss/releases/download/v0.6-r92/SP04_Drive_Outer_Spacer.stl)

Orientation

Existing print contact face retained

SP07 · Idler inner retainer spacer in its print orientation

### SP07 · Idler inner retainer spacer

PETG · Print 2

Download STL (https://github.com/metrox-eth/moss/releases/download/v0.6-r92/SP07_Idler_Inner_Retainer_Spacer.stl)

Orientation

Existing print contact face retained

SP08 · Idler outer retainer spacer in its print orientation

### SP08 · Idler outer retainer spacer

PETG · Print 2

Download STL (https://github.com/metrox-eth/moss/releases/download/v0.6-r92/SP08_Idler_Outer_Retainer_Spacer.stl)

Orientation

Existing print contact face retained

SP10 · Idler centre spacer in its print orientation

### SP10 · Idler centre spacer

PETG · Print 2

Download STL (https://github.com/metrox-eth/moss/releases/download/v0.6-r92/SP10_Idler_Centre_Spacer.stl)

Orientation

Existing print contact face retained

SP09 · Road wheel centre spacer in its print orientation

### SP09 · Road wheel centre spacer

PETG · Print 6

Download STL (https://github.com/metrox-eth/moss/releases/download/v0.6-r92/SP09_Road_Wheel_Centre_Spacer.stl)

Orientation

Existing print contact face retained

SP11 · Drive bearing to collar spacer in its print orientation

### SP11 · Drive bearing to collar spacer

PETG · Print 2

Download STL (https://github.com/metrox-eth/moss/releases/download/v0.6-r92/SP11_Drive_Bearing_To_Collar_Spacer.stl)

Orientation

Existing print contact face retained

### Drive & idler wheels

Left 22T idler wheel inner half R13 in its print orientation

### Left 22T idler wheel inner half R13

PETG · Print 1

Download STL (https://github.com/metrox-eth/moss/releases/download/v0.6-r92/Left_22T_idler_wheel_inner_half_R13.stl)

Orientation

Existing print contact face retained

Left 22T idler wheel outer half R13 in its print orientation

### Left 22T idler wheel outer half R13

PETG · Print 1

Download STL (https://github.com/metrox-eth/moss/releases/download/v0.6-r92/Left_22T_idler_wheel_outer_half_R13.stl)

Orientation

Existing print contact face retained

Right 22T idler wheel inner half R13 in its print orientation

### Right 22T idler wheel inner half R13

PETG · Print 1

Download STL (https://github.com/metrox-eth/moss/releases/download/v0.6-r92/Right_22T_idler_wheel_inner_half_R13.stl)

Orientation

Existing print contact face retained

Right 22T idler wheel outer half R13 in its print orientation

### Right 22T idler wheel outer half R13

PETG · Print 1

Download STL (https://github.com/metrox-eth/moss/releases/download/v0.6-r92/Right_22T_idler_wheel_outer_half_R13.stl)

Orientation

Existing print contact face retained

Left HEX12 drive wheel inner half R13 in its print orientation

### Left HEX12 drive wheel inner half R13

PETG · Print 1

Download STL (https://github.com/metrox-eth/moss/releases/download/v0.6-r92/Left_HEX12_drive_wheel_inner_half_R13.stl)

Orientation

Existing print contact face retained

Left HEX12 drive wheel outer half R13 in its print orientation

### Left HEX12 drive wheel outer half R13

PETG · Print 1

Download STL (https://github.com/metrox-eth/moss/releases/download/v0.6-r92/Left_HEX12_drive_wheel_outer_half_R13.stl)

Orientation

Existing print contact face retained

Right HEX12 drive wheel inner half R13 in its print orientation

### Right HEX12 drive wheel inner half R13

PETG · Print 1

Download STL (https://github.com/metrox-eth/moss/releases/download/v0.6-r92/Right_HEX12_drive_wheel_inner_half_R13.stl)

Orientation

Existing print contact face retained

Right HEX12 drive wheel outer half R13 in its print orientation

### Right HEX12 drive wheel outer half R13

PETG · Print 1

Download STL (https://github.com/metrox-eth/moss/releases/download/v0.6-r92/Right_HEX12_drive_wheel_outer_half_R13.stl)

Orientation

Existing print contact face retained

### Road wheels

Road wheel inner half in its print orientation

### Road wheel inner half

PETG · Print 6

Download STL (https://github.com/metrox-eth/moss/releases/download/v0.6-r92/Road_Wheel_Inner_Half_R13.stl)

Orientation

Existing print contact face retained

Road wheel outer half in its print orientation

### Road wheel outer half

PETG · Print 6

Download STL (https://github.com/metrox-eth/moss/releases/download/v0.6-r92/Road_Wheel_Outer_Half_R13.stl)

Orientation

Existing print contact face retained

### Power distribution housing

XT30 distribution base in its print orientation

### XT30 distribution base

PETG · Print 1

Download STL (https://github.com/metrox-eth/moss/releases/download/v0.6-r92/XT30_distribution_base.stl)

Orientation

Existing print contact face retained

XT30 distribution lid in its print orientation

### XT30 distribution lid

PETG · Print 1

Download STL (https://github.com/metrox-eth/moss/releases/download/v0.6-r92/XT30_distribution_lid.stl)

Orientation

Existing print contact face retained

XT30 insulating separator in its print orientation

### XT30 insulating separator

PETG · Print 1

Download STL (https://github.com/metrox-eth/moss/releases/download/v0.6-r92/XT30_insulating_separator.stl)

Orientation

Existing print contact face retained

### Tensioners and bearing covers

Tensioner slider in its print orientation

### Tensioner slider

PETG · Print 4

Download STL (https://github.com/metrox-eth/moss/releases/download/v0.6-r92/Tensioner_Slider.stl)

Orientation

Existing print contact face retained

Motor bearing outer cover in its print orientation

### Motor bearing outer cover

PETG · Print 2

Download STL (https://github.com/metrox-eth/moss/releases/download/v0.6-r92/Motor_Bearing_Outer_Cover.stl)

Orientation

Existing print contact face retained

Left Cover tensioner outer in its print orientation

### Left Cover tensioner outer

PETG · Print 1

Download STL (https://github.com/metrox-eth/moss/releases/download/v0.6-r92/Left_Cover_tensioner_outer.stl)

Orientation

Existing print contact face retained

Right Cover tensioner outer in its print orientation

### Right Cover tensioner outer

PETG · Print 1

Download STL (https://github.com/metrox-eth/moss/releases/download/v0.6-r92/Right_Cover_tensioner_outer.stl)

Orientation

Existing print contact face retained

### Upper cover

One-piece upper cover in its print orientation

### One-piece upper cover

PLA · Print 1

Download STL (https://github.com/metrox-eth/moss/releases/download/v0.6-r92/Upper_cover_R9.stl)

Orientation

Rear edge down

Split cover · rear section in its print orientation

### Split cover · rear section

PLA · Print 1

Download STL (https://github.com/metrox-eth/moss/releases/download/v0.6-r92/Upper_Cover_R10_Rear.stl)

Orientation

Rear edge down; supplied STL orientation

Split cover · LiDAR extension in its print orientation

### Split cover · LiDAR extension

PLA · Print 1

Download STL (https://github.com/metrox-eth/moss/releases/download/v0.6-r92/Upper_Cover_R10_Lidar_Extension.stl)

Orientation

Front edge down; supplied STL orientation

### Bin

14 Bin 20x10x2 magnet pockets in its print orientation

### 14 Bin 20x10x2 magnet pockets

PLA · Print 1

Download STL (https://github.com/metrox-eth/moss/releases/download/v0.6-r92/14_Bin_20x10x2_magnet_pockets.stl)

Orientation

Existing print contact face retained

### Arm plate

Arm Mounting Platform R22 in its print orientation

### Arm Mounting Platform R22

PLA · Print 1

Download STL (https://github.com/metrox-eth/moss/releases/download/v0.6-r92/Arm_Mounting_Platform_R22.stl)

Orientation

Flat underside down

### Arm base & shoulder

SO101 Base in its print orientation

### SO101 Base

PLA · Print 1

Download STL (https://github.com/metrox-eth/moss/releases/download/v0.6-r92/SO101_Base.stl)

Orientation

Existing print contact face retained

SO101 Shoulder rotation in its print orientation

### SO101 Shoulder rotation

PLA · Print 1

Download STL (https://github.com/metrox-eth/moss/releases/download/v0.6-r92/SO101_Shoulder_rotation.stl)

Orientation

Existing print contact face retained

SO101 Base motor holder in its print orientation

### SO101 Base motor holder

PLA · Print 1

Download STL (https://github.com/metrox-eth/moss/releases/download/v0.6-r92/SO101_Base_motor_holder.stl)

Orientation

Existing print contact face retained

SO101 Shoulder bracket cable clip in its print orientation

### SO101 Shoulder bracket cable clip

PLA · Print 1

Download STL (https://github.com/metrox-eth/moss/releases/download/v0.6-r92/SO101_Shoulder_bracket_cable_clip.stl)

Orientation

Existing print contact face retained

### Arm links

SO101 Upper arm cable clip in its print orientation

### SO101 Upper arm cable clip

PLA · Print 1

Download STL (https://github.com/metrox-eth/moss/releases/download/v0.6-r92/SO101_Upper_arm_cable_clip.stl)

Orientation

Existing print contact face retained

SO101 Forearm cable clip in its print orientation

### SO101 Forearm cable clip

PLA · Print 1

Download STL (https://github.com/metrox-eth/moss/releases/download/v0.6-r92/SO101_Forearm_cable_clip.stl)

Orientation

Existing print contact face retained

SO101 Wrist cable clip in its print orientation

### SO101 Wrist cable clip

PLA · Print 1

Download STL (https://github.com/metrox-eth/moss/releases/download/v0.6-r92/SO101_Wrist_cable_clip.stl)

Orientation

Existing print contact face retained

SO101 Wrist bracket in its print orientation

### SO101 Wrist bracket

PLA · Print 1

Download STL (https://github.com/metrox-eth/moss/releases/download/v0.6-r92/SO101_Wrist_bracket.stl)

Orientation

Existing print contact face retained

### Gripper & wrist camera

NC90 Right side shield in its print orientation

### NC90 Right side shield

PLA · Print 1

Download STL (https://github.com/metrox-eth/moss/releases/download/v0.6-r92/NC90_Right_side_shield.stl)

Orientation

Existing print contact face retained

NC90 Pinion in its print orientation

### NC90 Pinion

PLA · Print 1

Download STL (https://github.com/metrox-eth/moss/releases/download/v0.6-r92/NC90_Pinion.stl)

Orientation

Existing print contact face retained

NC90 Cable guide in its print orientation

### NC90 Cable guide

PLA · Print 1

Download STL (https://github.com/metrox-eth/moss/releases/download/v0.6-r92/NC90_Cable_guide.stl)

Orientation

Existing print contact face retained

NC90 Right jaw extended rack in its print orientation

### NC90 Right jaw extended rack

PLA · Print 1

Download STL (https://github.com/metrox-eth/moss/releases/download/v0.6-r92/NC90_Right_jaw_extended_rack.stl)

Orientation

Existing print contact face retained

Gripper Camera Mount R30 in its print orientation

### Gripper Camera Mount R30

PLA · Print 1

Download STL (https://github.com/metrox-eth/moss/releases/download/v0.6-r92/Gripper_Camera_Mount_R30.stl)

Orientation

Supplied print orientation for current IMX335 B mount

NC90 Left side shield in its print orientation

### NC90 Left side shield

PLA · Print 1

Download STL (https://github.com/metrox-eth/moss/releases/download/v0.6-r92/NC90_Left_side_shield.stl)

Orientation

Existing print contact face retained

NC90 Base extended rails in its print orientation

### NC90 Base extended rails

PLA · Print 1

Download STL (https://github.com/metrox-eth/moss/releases/download/v0.6-r92/NC90_Base_extended_rails.stl)

Orientation

Existing print contact face retained

NC90 Left jaw extended rack in its print orientation

### NC90 Left jaw extended rack

PLA · Print 1

Download STL (https://github.com/metrox-eth/moss/releases/download/v0.6-r92/NC90_Left_jaw_extended_rack.stl)

Orientation

Existing print contact face retained

### Tracks

Track · 70 teeth in its print orientation

### Track · 70 teeth

TPU · Print 2

Download STL (https://github.com/metrox-eth/moss/releases/download/v0.6-r92/Track_R78_70_Teeth.stl)

Orientation

Flat side down; 70 teeth, 6.8 mm central guides

### Jetson carrier

Jetson Adapter R87 in its print orientation

### Jetson Adapter R87

PETG · Print 1

Download STL (https://github.com/metrox-eth/moss/releases/download/v0.6-r92/Jetson_Adapter_R87.stl)

Orientation

Flat underside down

JT01 · Jetson retaining tab 1 in its print orientation

### JT01 · Jetson retaining tab 1

PETG · Print 1

Download STL (https://github.com/metrox-eth/moss/releases/download/v0.6-r92/Jetson_Retaining_Tab_1_R92.stl)

Orientation

Flat underside down

JT02 · Jetson retaining tab 2 in its print orientation

### JT02 · Jetson retaining tab 2

PETG · Print 1

Download STL (https://github.com/metrox-eth/moss/releases/download/v0.6-r92/Jetson_Retaining_Tab_2_R92.stl)

Orientation

Flat underside down

### Pi carrier

Pi Adapter R87 in its print orientation

### Pi Adapter R87

PETG · Print 1

Download STL (https://github.com/metrox-eth/moss/releases/download/v0.6-r92/Pi_Adapter_R87.stl)

Orientation

Flat underside down

### Gemini inserts

Gemini Window Adapter R89 in its print orientation

### Gemini Window Adapter R89

PETG · Print 1

Download STL (https://github.com/metrox-eth/moss/releases/download/v0.6-r92/Gemini_Window_Adapter_R89.stl)

Orientation

Flat front frame down; curved ends retained

Gemini Flush Insert R72 in its print orientation

### Gemini Flush Insert R72

PETG · Print 1

Download STL (https://github.com/metrox-eth/moss/releases/download/v0.6-r92/Gemini_Flush_Insert_R72.stl)

Orientation

Rear flat face down; plain top-entry key

### RealSense insert

RealSense Insert R72 in its print orientation

### RealSense Insert R72

PETG · Print 1

Download STL (https://github.com/metrox-eth/moss/releases/download/v0.6-r92/RealSense_Insert_R72.stl)

Orientation

Rear flat face down; top-entry screw-support key

## What to buy

Parts and hardware for one rover using separate modules. Choose one computer and one camera option.

Open the bill of materials

One rover, using separate off-the-shelf modules. Choose one computer and one depth camera.

## Control and audio

Item | Quantity | Note
Adafruit QT Py ESP32-S3, 8 MB flash, no PSRAM, ref.5426 | 1
Adafruit Terminal Block BFF, ref.6495 | 1
Adafruit INA219 STEMMA QT, ref.904 | 1
STEMMA QT cable, 300 mm, ref.5384 | 1
Cytron MDD10A Rev2 dual motor driver | 1
Waveshare Bus Servo Adapter A | 1
MAX98357A amplifier module | 1
Speaker, 3 W, 4 ohm | 1
Acoustic splash membrane and compatible adhesive | 1 | EPTFE or non woven fabric membrane.

## Drive

Item | Quantity | Note
JGB37-520, 12 V, 90:1, 110 rpm, Hall encoder, 6 mm D-shaft | 2
625 bearing | 12
608 bearing | 4
626 bearing | 4
LK05 — shaft collar, 5 mm bore, Ø10 × 5 mm | 12
LK06 — shaft collar, 6 mm bore, Ø11 × 5 mm | 2
LK08 — shaft collar, 8 mm bore, Ø16 × 8 mm | 4
Smooth steel axle, 5 ×70 mm finished length | 6 | Check the physical stack before cutting stock.
Smooth steel axle, 6 ×77 mm finished length | 2
Smooth steel axle, 8 ×87 mm finished length | 2
Rigid motor-to-shaft coupling, 6 mm bores | 2
HEX12 metal wheel hub, 6 mm bore, 18 mm length | 2

LK05/LK06/LK08 are guide identifiers for purchased shaft collars, also called lock rings. All spacer and collar references.

## Arm, gripper and body

Item | Quantity | Note
ST3215 12 V serial bus servo | 5 | Keep the original servo screw packs.
CF35-12 constant-force gripper servo | 1
3010 fan, 12 V | 2
Magnet, 20 ×10 ×2 mm | 4 | Glue into the pockets with epoxy; check polarity before gluing.
Small two-part epoxy adhesive kit, two tubes (resin + hardener) | 1 kit | For gluing the four bin magnets and joining the two-piece hull and cover when printing on a smaller printer.
M3 brass heat-set insert, OD4 mm, length 6 mm | 11 | 10 in the hull and 1 in the LiDAR base.

## Power and wiring — module-based rover

Item | Quantity | Note
12-cell battery pack, 3S4P, with BMS | 1 | 110 × 67 × 35 mm.
12.6 V CC/CV charger for the selected 3S pack | 1
Emergency stop LA16-11ZS/A, 16 mm | 1
KCD1-5-101EN round rocker switch, 12 V LED, 20 mm mounting hole | 1 | PADPAD (https://www.lazada.co.th/products/led-dc12v-20a-20-kcd1-5-101en-onoff-round-rocker-toggle-switch-push-button-switch-20mm-i2389441284-s11758134838.html), listed 20 A / 12 V DC. Select สวิตช์1ตัว+ยางกันน้ำ for the switch with splash cap.
Inline blade-fuse holder, 14 AWG | 1
ATC blade fuse, 15 A | 1
Amass XT30 male/female connector pair | 6
DC099 rear charging socket, 5.5 × 2.1 mm, 11 mm mounting hole | 1 | DIYsound (https://www.lazada.co.th/products/diysound-dc099-11mm-female-size-55-21mm-dc-099-jack-socket-55x21-mm-metal-dc-socket-power-socket-gold-female-dc-jack-dc099-i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), DC099 เงิน #061-2, listed 5 A / 30 V.
Battery female charging lead, 5.5 × 2.1 mm, 18 AWG | 1 | MookMig (https://www.lazada.co.th/products/jack-dc-male-18awg-pvc-5521-powerbox-i2148060041-s7690922637.html), ตัวเมีย 0.3M 18AWG. Stock length 300 mm.
DC male barrel plug — computer power branch | 1 | Jetson: 5.5 × 2.5 mm, 9.5 mm barrel, centre positive (NVIDIA specification (https://developer.nvidia.com/downloads/assets/embedded/secure/jetson/orin_nano/docs/jetson_orin_nano_devkit_carrier_board_specification_sp.pdf)). Pi option: choose the plug that matches the input of the selected 5 V power supply. These are alternatives.
DC male barrel plug, 5.5 × 2.1 mm — servo power branch | 1 | For the Waveshare Bus Servo Adapter A (Waveshare specification (https://docs.waveshare.com/Bus_Servo_Adapter_A)).
Internal male charging lead, 5.5 × 2.1 mm, 18 AWG | 1 | MookMig (https://www.lazada.co.th/products/jack-dc-male-18awg-pvc-5521-powerbox-i2148060041-s7690922633.html), ตัวผู้ 0.3M 18AWG. Stock length 300 mm; trim to the fitted route. The complete mating connection must carry 5 A.
Wire, ferrules and heat-shrink | 1 lot
Hoco HB1 four-port USB 2.0 hub | 1
GameSir Nova 2 Lite gamepad with wireless USB receiver | 1 | For manual driving; include the wireless USB receiver. Used successfully on MOSS.
USB-C to USB-A cable, 30 cm | 3
RealSense camera cable | 1 | Lazada product link (https://www.lazada.co.th/products/i16248699269-s127506585857.html) · RealSense option only.

## Choose one computer

Item | Quantity | Note
NVIDIA Jetson Orin Nano Super Developer Kit | 1 | Use the Jetson carrier.
OR Raspberry Pi5 with its cooler, storage and appropriate 5 V supply | 1 | Use the Pi carrier and the mounting screws and spacers supplied with the HAT.

## Sensors

Item | Quantity | Note
Intel RealSense D455 OR Orbbec Gemini 2 | 1 | Use the matching printed insert(s); these are alternatives.
SLAMTEC RPLIDAR C1 | 1
Wrist USB camera for the R30 mount | 1 | PCB mounting-hole pattern: 21 × 13.5 mm.

## Fasteners by assembly

Quantities are for one rover. Use the assembly step to locate each fastener.

Assembly | Fasteners for one rover
Choose the hull and fit the inserts | 11 × M3 heat-set insert, OD4 mm, length 6 mm; 6 × Split hull only: M4 × 15 socket-head screw; 6 × Split hull only: M4 hex nut, 7 mm across flats; 6 × Split hull only: M4 washer, Ø9 × 0.8 mm
Build the six road wheels | 18 × M3 × 35 socket-head screw; 18 × M3 hex nut
Build the two drive wheels | 6 × M3 × 20 socket-head screw; 6 × M3 hex nut
Build the two idler wheels | 6 × M3 × 25 socket-head screw; 6 × M3 hex nut
Fit the motors and inner bearing retainers | 8 × M4 × 20 socket-head screw; 8 × M4 hex nut; 12 × M3 × 8 socket-head screw
Fit the inner track frames | 6 × M4 × 15 socket-head screw; 6 × M4 hex nut
Fit the drive axles and outer bearing covers | 6 × M3 × 15 socket-head screw; 6 × M3 hex nut
Fit the idler slides and tensioners | 16 × M3 × 15 socket-head screw; 16 × M3 hex nut; 4 × M4 × 35 socket-head screw; 8 × M4 hex nut; 4 × M4 washer
Close the track frames | 4 × M4 × 60 socket-head screw; 4 × M4 hex nut; 4 × M4 washer
Fit the driver and controller | 4 × M3 × 6 socket-head screw; 6 × M2 × 6 screw, non-countersunk; 6 × M2 washer, 0.3 mm thick
Fit the speaker and amplifier | 2 × M3 × 6 socket-head screw; 2 × M2 × 6 screw, non-countersunk; 2 × M2 washer, 0.5 mm thick
Fit the computer carrier and servo adapter | 2 × M3 × 6 socket-head screw; 2 × M3 × 8 socket-head screw; 4 × M3 washer, 0.5 mm thick; 4 × M2.5 × 8 screw, non-countersunk; 4 × M2.5 washer, 0.5 mm thick; 2 × Jetson only: M3 × 8 socket-head screw, no washer
Fit the camera option | 2 × RealSense only: M4 × 10 socket-head screw; 2 × Gemini only: M3 × 8 socket-head screw
Fit the LiDAR carriage | 2 × M3 × 10 socket-head screw; 4 × M2.5 × 6 socket-head screw; 1 × M3 × 20 socket-head screw
Fit power distribution and cooling | 4 × M2.5 × 10 low-head screw, head diameter 5 mm maximum
Fit the arm plate and build the arm | 4 × M3 × 10 socket-head screw; 4 × M4 × 25 countersunk 90-degree screw; 4 × M4 hex nut; 20 × Kit screw: M2 × 6, original servo head; 37 × Kit screw: M3 × 6, original servo head
Build the gripper and wrist camera | 11 × Kit screw: M3 × 6 cross-head ISO7045; 6 × Kit screw: #1-42 x3/16 inch typeAB; 4 × M2 × 6 screw, non-countersunk, for wrist camera PCB; 2 × M3 × 10 socket-head screw, for wrist camera bracket; 2 × M3 hex nut, for wrist camera bracket
Close the hull and fit the bin | 10 × M3 × 10 countersunk 90-degree screw, head diameter 6.4 mm maximum; 4 × M3 × 10 countersunk 90-degree screw, head diameter 5.6 mm maximum

Screw lengths are measured under the head, except countersunk screws, which use their full length. Retain the original heads supplied with the servo and gripper kits. Camera screw sets are alternatives.

Measured fastener lengths. Pi/HAT mounting hardware is supplied with the HAT; no separate screw purchase is added.

The supplied computer carriers are for the NVIDIA Jetson Orin Nano and Raspberry Pi 5. Choose one carrier and one camera option.

See the assembly cards.

## Adhesive for the split hull and cover

Use the same two-part epoxy kit listed above. Retain the six M4 hull fixings and the four cover mounting screws.

Download BOM

## Current files

The main Fusion and STEP files cover the one-piece set. The two-piece hull and upper cover have their own native Fusion assemblies. Arm meshes and track masters are also supplied as STL.

Download complete CAD, STL & 3MF package (https://github.com/metrox-eth/moss/releases/download/v0.6-r92/MOSS_R92_Mechanical_20261109.zip)Two-piece cover: Fusion source (https://github.com/metrox-eth/moss/releases/download/v0.6-r92/MOSS_Upper_Cover_R10_Split_Assembly.f3d)Two-piece hull: Fusion source (https://github.com/metrox-eth/moss/releases/download/v0.6-r92/MOSS_Hull_R92_Split_Assembly.f3d)One-piece set: Fusion source (https://github.com/metrox-eth/moss/releases/download/v0.6-r92/MOSS_Printable_Source_R92.f3d)STEP solids (https://github.com/metrox-eth/moss/releases/download/v0.6-r92/MOSS_Printable_BRep_Parts_R92.step)Parts CSVJetson retaining tab 1 · STL (https://github.com/metrox-eth/moss/releases/download/v0.6-r92/Jetson_Retaining_Tab_1_R92.stl)Jetson retaining tab 2 · STL (https://github.com/metrox-eth/moss/releases/download/v0.6-r92/Jetson_Retaining_Tab_2_R92.stl)

The complete package includes 73 distinct part STLs, two optional fit coupons, both Jetson tabs, and the H2S and P1 / P2 3MF projects. Shared parts have one file and a total print quantity.

MOSS / R92 · Assembly guide
