metrox-eth/moss/hardware/electronics/moss-core-v0.7/delivery/assembly/ASSEMBLY_NOTES.txt

MOSS CORE V0.7 / PROTOTYPE / 2026-11-02 / SILKSCREEN REFERENCE UPDATE
216 components per assembled board; 99 grouped purchase articles. Two assembled boards requested. Use the matched BOM, positions, Gerbers and drills.
Updated 2 November 2026: component reference legends added. Existing numbering, all parts, placements, copper, solder mask, paste and drill data are unchanged from the power/rearm design. Use this matched set of design and assembly files.

RESOLUTIONS OF PCBWAY COMMENTS RECEIVED ON 2026-10-31
D20-D22: Keep exact TI TPD1E10B06DYAR. TI catalog SOT-5X3 / DYA and drawing DYA0002A SOT (SOD-523) refer to the same two-pin package. The copper footprint remains D_SOD-523.
J7: Use vertical JST B2B-PH-K-S(LF)(SN), not the previous horizontal S2B variant. Manual through-hole insertion/soldering with a suitable fixture and PCB support is accepted. Fully seat it without bending the PCB or damaging the housing; inspect seating and solder joints.
J8: Keep JST BM06B-SRSS-TB(LF)(SN). Manual placement is accepted for the two prototypes because this code has no suction cap. Use a suitable soldering/inspection process. Do not omit the connector. Pins 3/4 have no harness wires or crimp contacts.
MOD1: Removed from design/BOM. Do not buy Waveshare 29035. U60/L3/passives implement the converter directly on the PCB.
Q50: SIRA99DP-T1-GE3 is accepted; capitalization of SiRA99DP-T1-GE3 is the only difference. Keep the exact Vishay device/package.
U2: Replaced by TI TPD2E2U06QDCKRQ1, DCK / SC-70-3. Pins 1 IO1, 2 IO2, 3 GND. Manufacturer package drawing DCK0003A and land-pattern drawing match the previous DCK part. This Q1 code is MSL2: observe dry-pack and floor-life requirements. Procurement lead: DigiKey 296-44302-1-ND, product URL below. Stock is not reserved; confirm procurement in the quotation. No DBZ/DRL package substitution.
https://www.digikey.com/en/products/detail/texas-instruments/TPD2E2U06QDCKRQ1/6026260

OTHER ASSEMBLY DETAILS
U51: TI SN74LVC1G74DCUR, exact DCU/VSSOP8 pin assignment. U52: TI SN74HCS11PWR, Schmitt-input TSSOP14. Do not substitute generic HC/LVC gate variants. Confirm component sourcing before production. C170: 6.8pF C0G feedforward capacitor across R70, fitted in this prototype.
J10: AMASS XT30UPB-M.G.Y, vertical PCB header, 5.00 mm pitch, two 1.80 mm holes. Do not substitute the previous horizontal XT30PW-M or add locator holes.
J5: Molex 22-03-5035 / 5267-03A vertical SPOX, 2.50 mm pitch. Pin 1 DATA, pin 2 actuator supply, pin 3 GND. Retains the mating 5264-family cable housing. Confirm numbered pins, not apparent left/right order.
J2: Molex 43045-1012, vertical 10-way Micro-Fit 3.0. J3/J4: Molex 43045-0612, vertical 6-way Micro-Fit 3.0. Fully seat the locating pegs before soldering. The continuous left edge supports their peg holes; the board has no protruding ears. J12/J13 have been removed. J11 remains Phoenix 1715721; do not substitute a second XT30. Mating harness housings/contacts are not PCBA items. See MOTOR_WIRING.md for pin assignments.
U60: Exact MP9447GL-Z, 25-land MPS QFN 3 x 4 mm with FIVE DISTINCT exposed IN/SW lands. Not a generic QFN20 single thermal pad. Review paste/stencil and inspection for this footprint.
L3: SRP6060FA-100M, same procurement article as L2. No unreviewed inductor/capacitor/ripple-network substitutions.
H1: Grounding board feature, excluded from assembly BOM. Plated 2.7 mm mounting hole, 5.4 mm exposed copper ring on both faces, eight 0.5 mm plated stitch holes, no paste. Lug, screw and grounding strap are not PCBA items.
F1: 08853.15DR soldered SMD, no fuse holder. F2/F3: 0451001.MRL 1 A.
J14/J15: B2B-XH-A(LF)(SN), pin 1 fused 3S positive, pin 2 GND.
U14/U17/U43/U51 and the J1/J20 USB rows have common soldermask openings for the affected fine-pitch pin rows. Copper and paste apertures are unchanged. Confirm stencil/process for these rows and U60 during review.
This submission requests quotation/engineering review, not payment or production authorization.
