metrox-eth/moss/hardware/electronics/moss-core-v0.7/delivery/fabrication/FABRICATION_NOTES.txt

MOSS CORE V0.7 / PROTOTYPE / 2026-11-01 / POWER AND REARM UPDATE
4 copper layers, 82 x 79 mm overall, 1.6 mm board. BLACK solder mask both sides, WHITE silkscreen, ENIG finish. Rounded rectangular outline, no protruding ears. Core mounting centres are now 4 mm from each outer edge: 74 x 71 mm pitch. Orange Pi H5-H8 positions are unchanged. Layer order F.Cu / In1.Cu / In2.Cu / B.Cu. Request 1 oz copper on ALL FOUR copper layers, including the internal motor-current paths; confirm the final stackup in the quotation.
Minimum plated hole 0.20 mm. Use the complete matched Gerber and separate PTH/NPTH files, including slots.
PCBWAY SOLDER MASK COMMENT RESOLVED IN FILES: Common mask openings are provided locally over both pin rows of U14, U17, U43 and U51, removing the 0.15 mm bridges that PCBWay cannot manufacture. No pad narrowing, copper rerouting or drill change is made by this DFM correction. For BLACK mask, J1/J20 also have local common row openings over their 0.20 mm pad gaps. Copper and all paste apertures remain unchanged. Do not apply an additional global mask expansion. Please review CAM/stencil before production.
H1 at (2,0) mm is now PTH, finished diameter 2.7 mm for M2.5: 5.4 mm exposed copper ring both faces, eight 0.5 mm stitch PTH to GND, no paste. Use the NEW drill files; do not reuse the previous NPTH file. The other seven mounting holes remain NPTH.
The converter is now integrated: no Waveshare module footprint or separate module procurement.
Please confirm final stackup, copper build and DFM in the quotation.
Quotation/review only; no payment or production authorization in this submission.
