metrox-eth/moss/docs/build/images/plates/compact-01.png

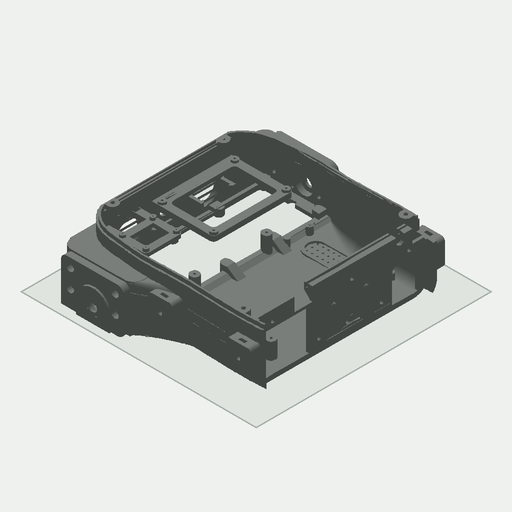
docs/build/images/plates/compact-01.png
