metrox-eth/moss/docs/build/images/plates/compact-02.png

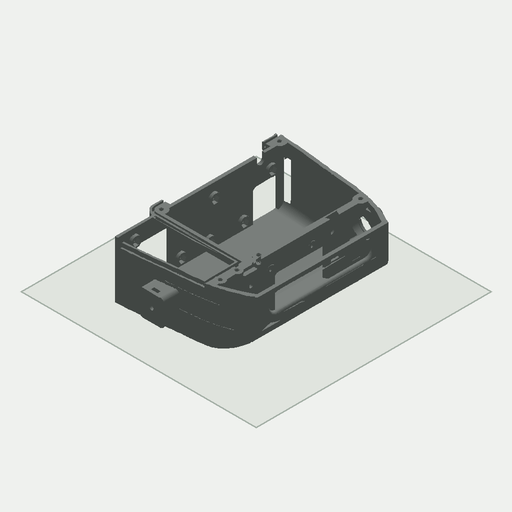
docs/build/images/plates/compact-02.png
