metrox-eth/moss/docs/build/images/plates/h2s-01.png

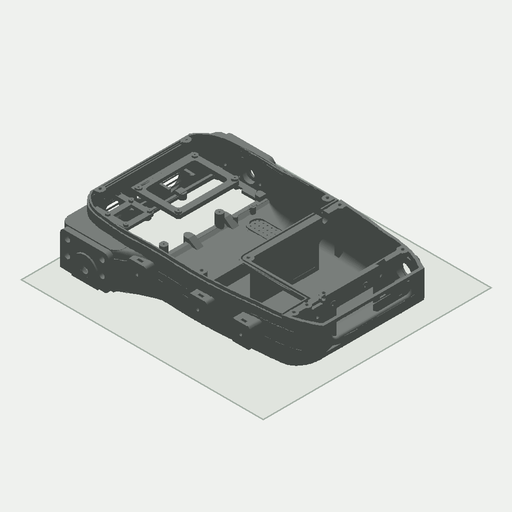
docs/build/images/plates/h2s-01.png
