metrox-eth/moss/hardware/power/custom-3s4p-battery/images/03-bms-wiring.jpg

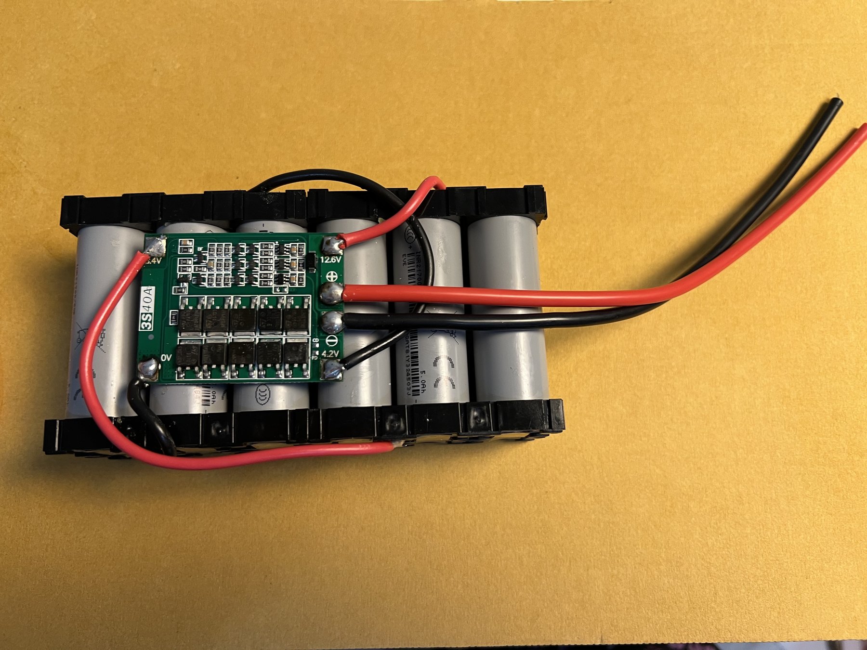
hardware/power/custom-3s4p-battery/images/03-bms-wiring.jpg
