metrox-eth/moss/hardware/power/custom-3s4p-battery/images/wiring-3s4p.jpg

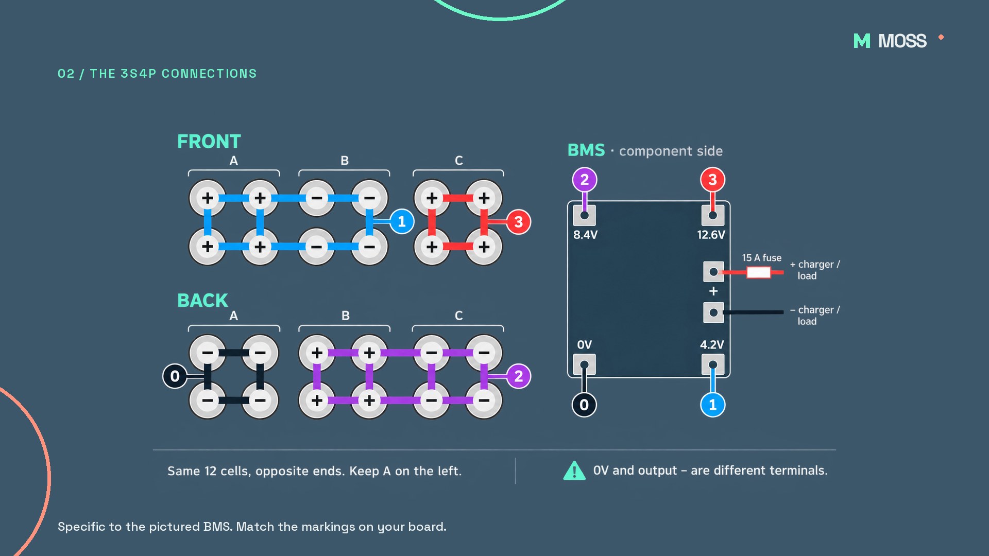
hardware/power/custom-3s4p-battery/images/wiring-3s4p.jpg
