metrox-eth/moss/media/images/build_02_chassis_real_20260918.jpg

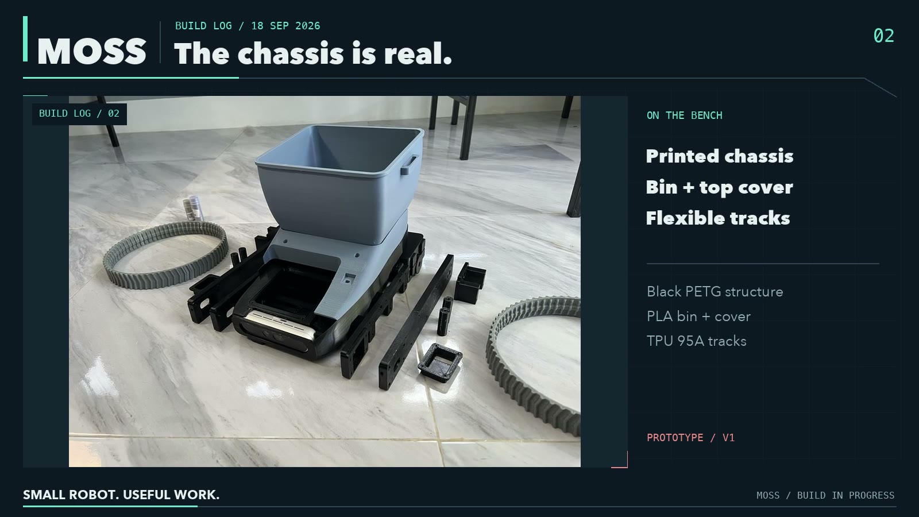
media/images/build_02_chassis_real_20260918.jpg
