metrox-eth/moss/media/images/build_03_electronics_20260917.jpg

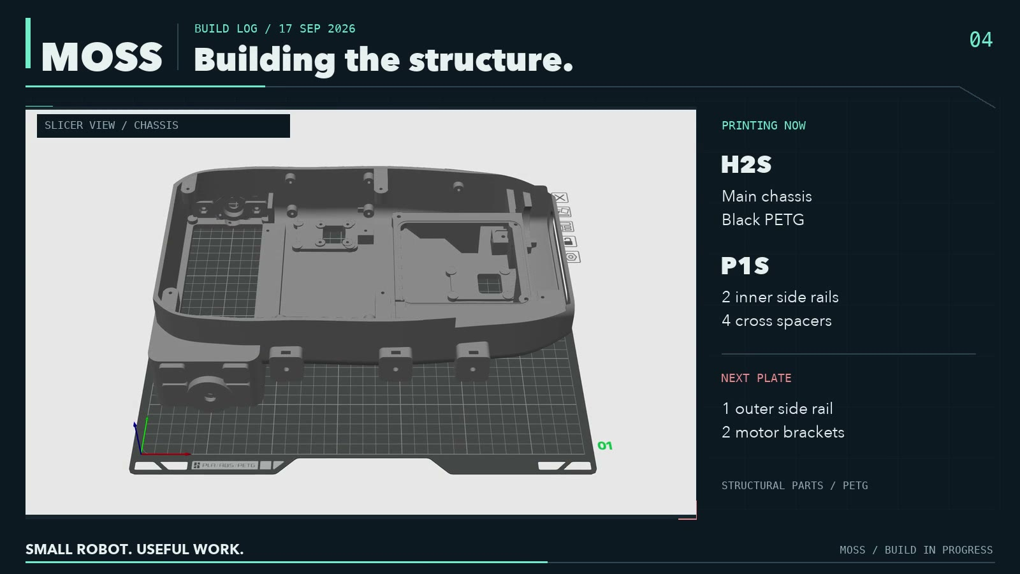
media/images/build_03_electronics_20260917.jpg
