metrox-eth/moss/media/images/build_04_structure_20260917.jpg

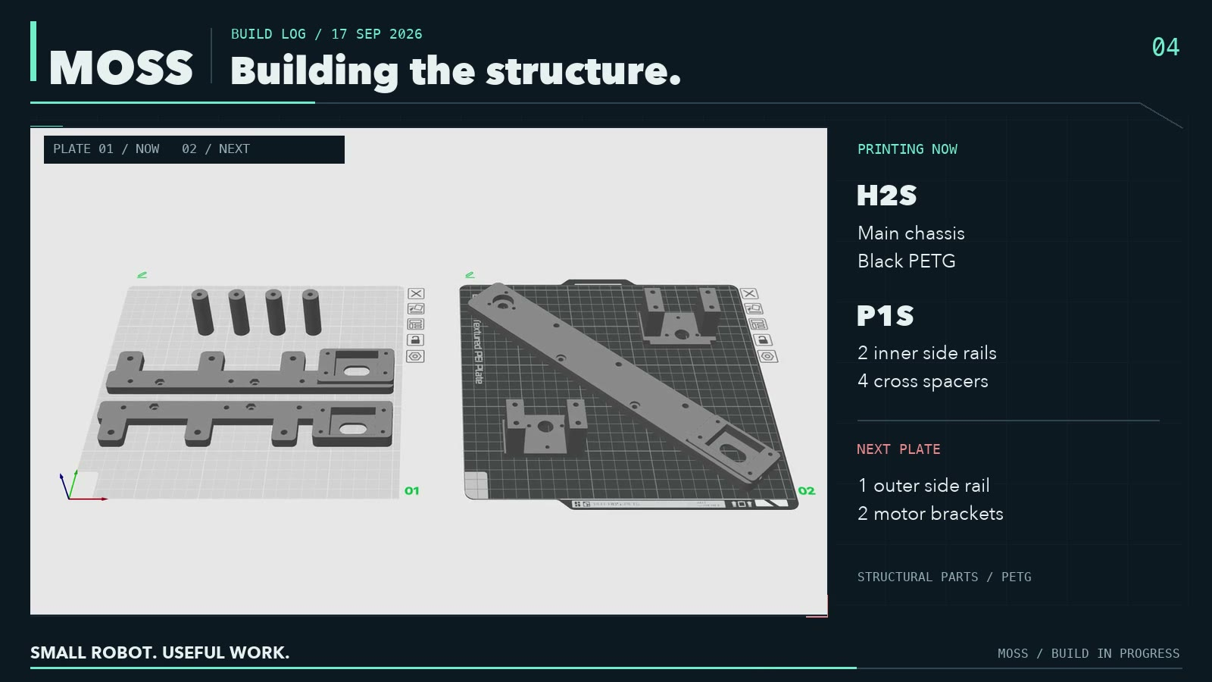
media/images/build_04_structure_20260917.jpg
