metrox-eth/moss/media/images/build_05_drivetrain_plate_20260918.jpg

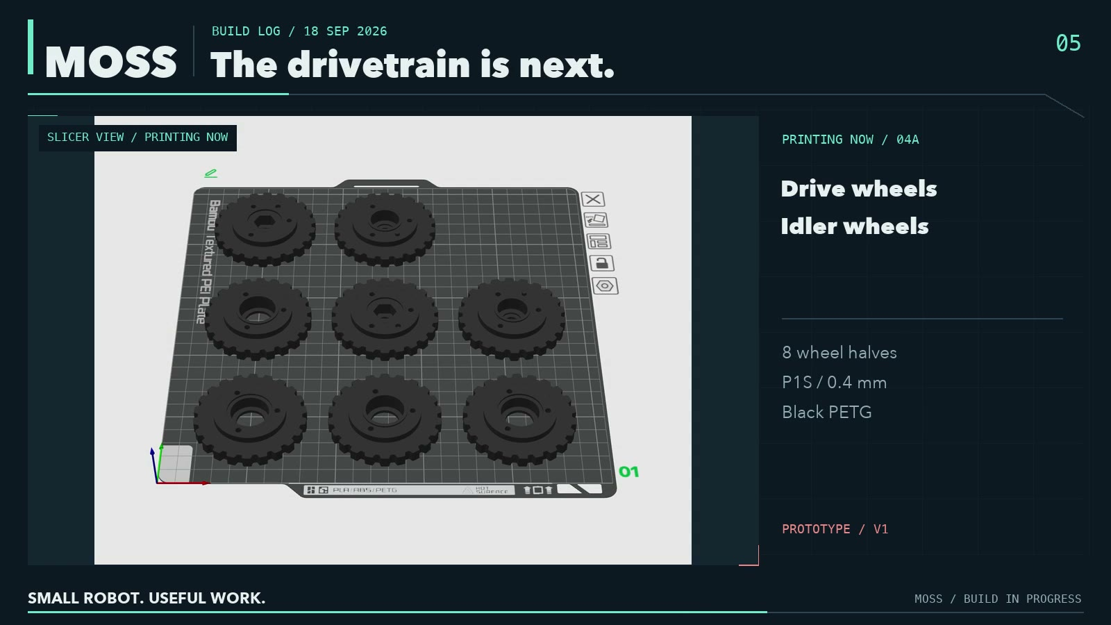
media/images/build_05_drivetrain_plate_20260918.jpg
