metrox-eth/moss/media/images/build_05_hardware_ordered_20260917.jpg

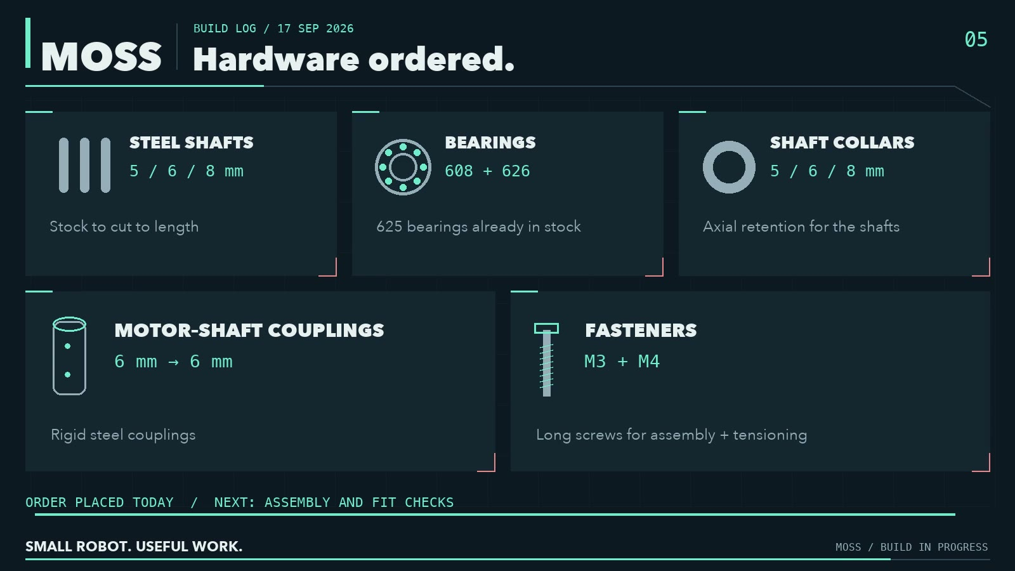
media/images/build_05_hardware_ordered_20260917.jpg
