metrox-eth/moss/media/images/build_06_tensioners_plate_20260918.jpg

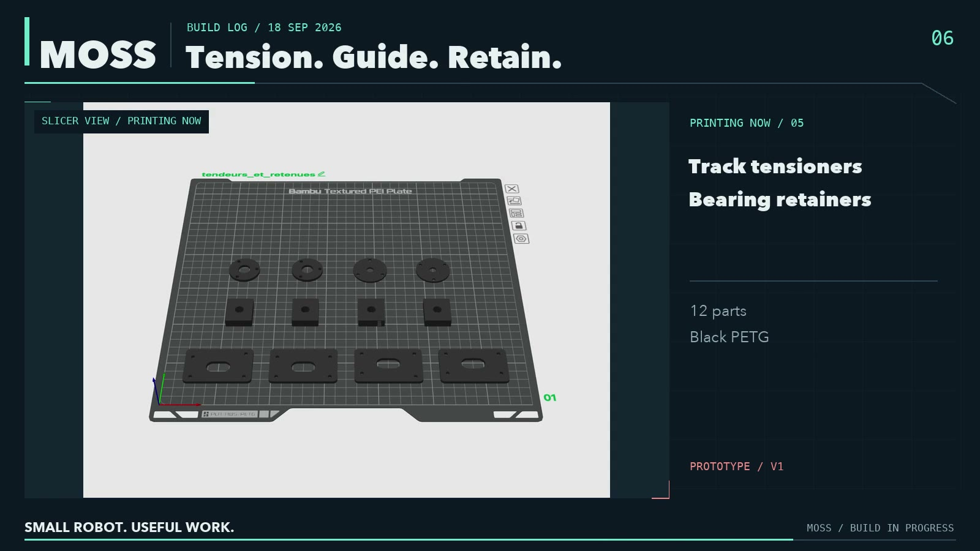
media/images/build_06_tensioners_plate_20260918.jpg
