metrox-eth/moss/media/images/build_07_arm_gripper_folded_20260926.jpg

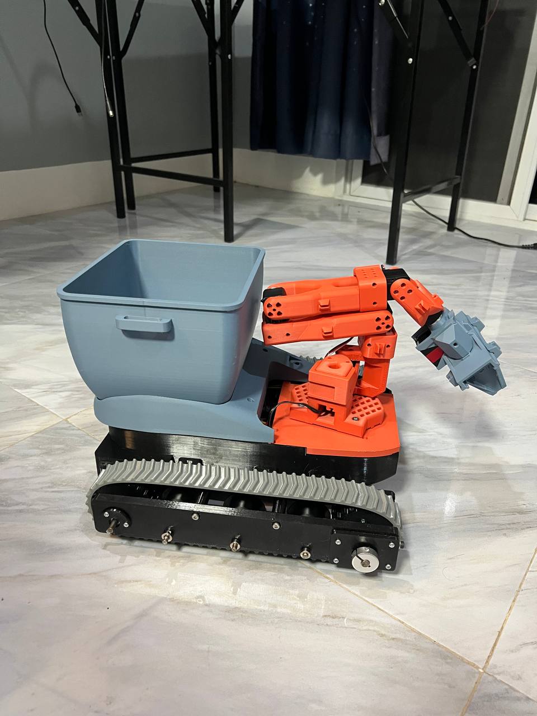
media/images/build_07_arm_gripper_folded_20260926.jpg
