metrox-eth/moss/media/images/build_08_arm_gripper_reach_20260926.jpg

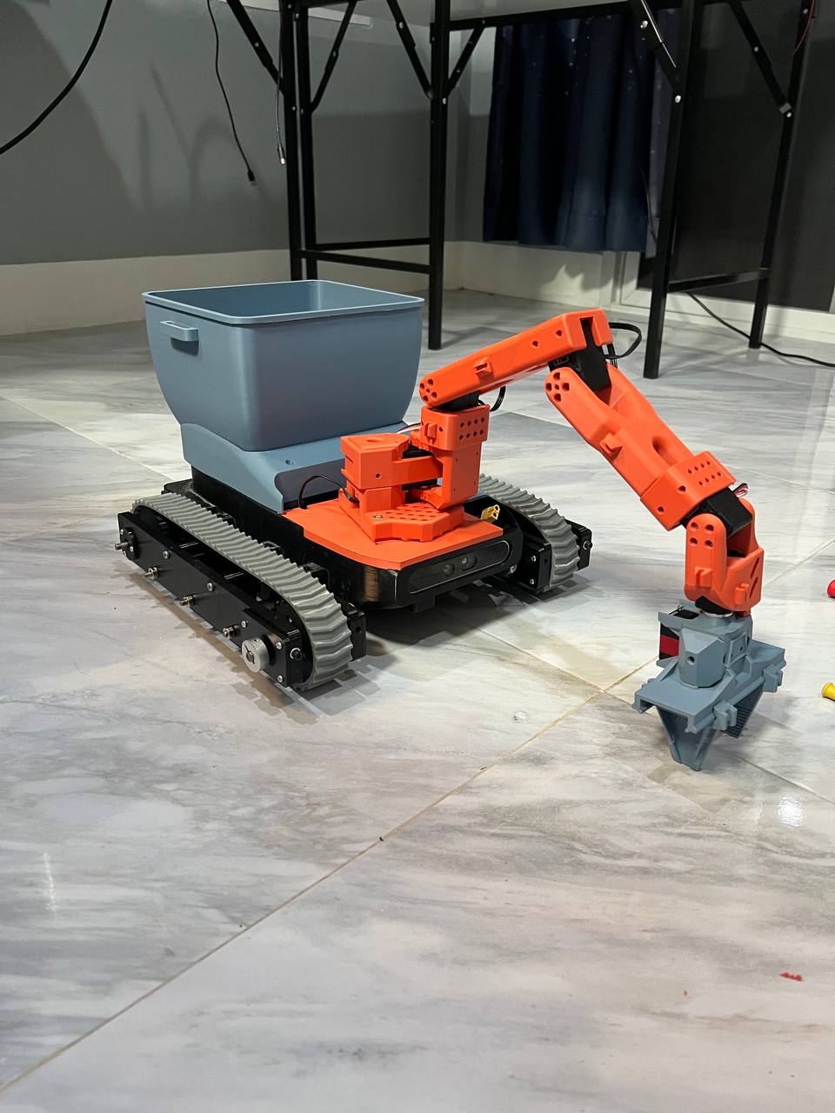
media/images/build_08_arm_gripper_reach_20260926.jpg
