metrox-eth/moss/media/images/build_bin_on_20260922.jpg

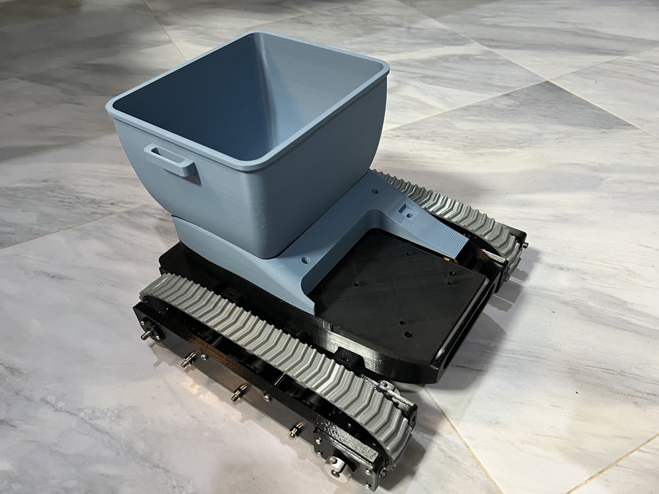
media/images/build_bin_on_20260922.jpg
