metrox-eth/moss/media/images/build_electronics_bench_20260919.jpg

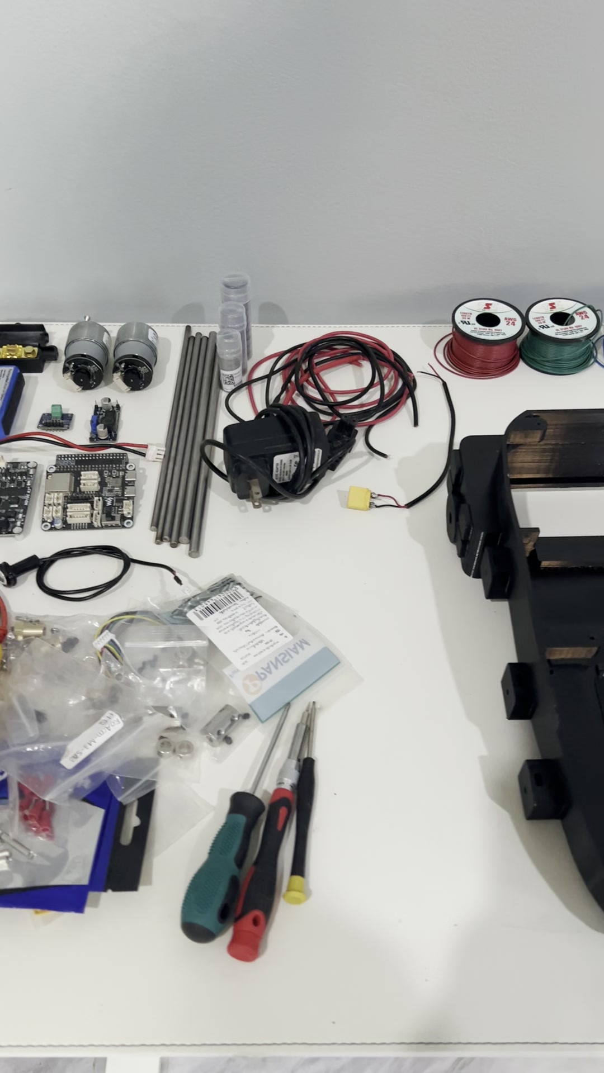
media/images/build_electronics_bench_20260919.jpg
