metrox-eth/moss/media/images/build_first_assembly_20260920.jpg

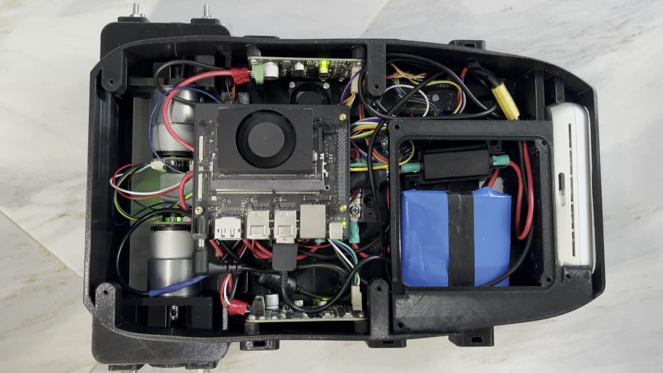
media/images/build_first_assembly_20260920.jpg
