metrox-eth/moss/media/images/build_first_drive_20260922.jpg

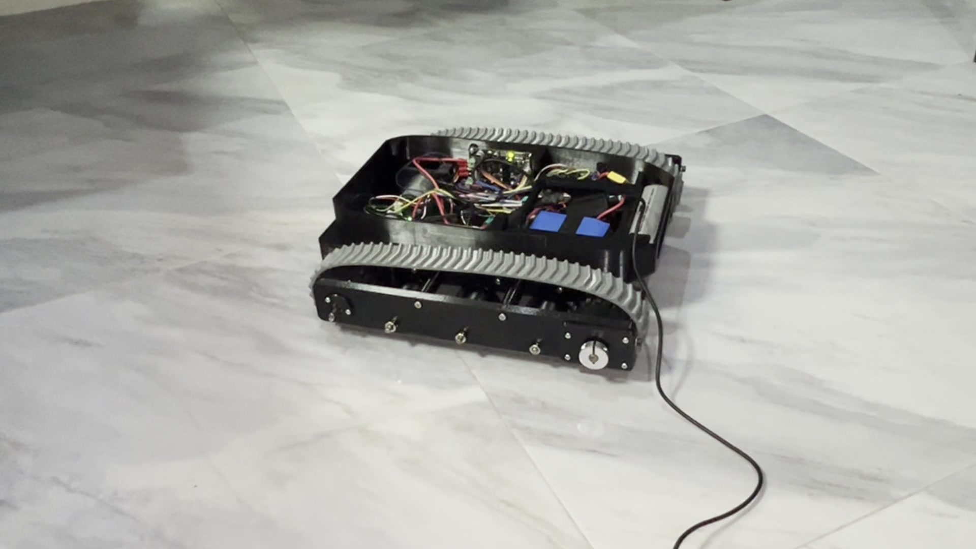
media/images/build_first_drive_20260922.jpg
