metrox-eth/moss/media/images/build_harness_bench_20260920.jpg

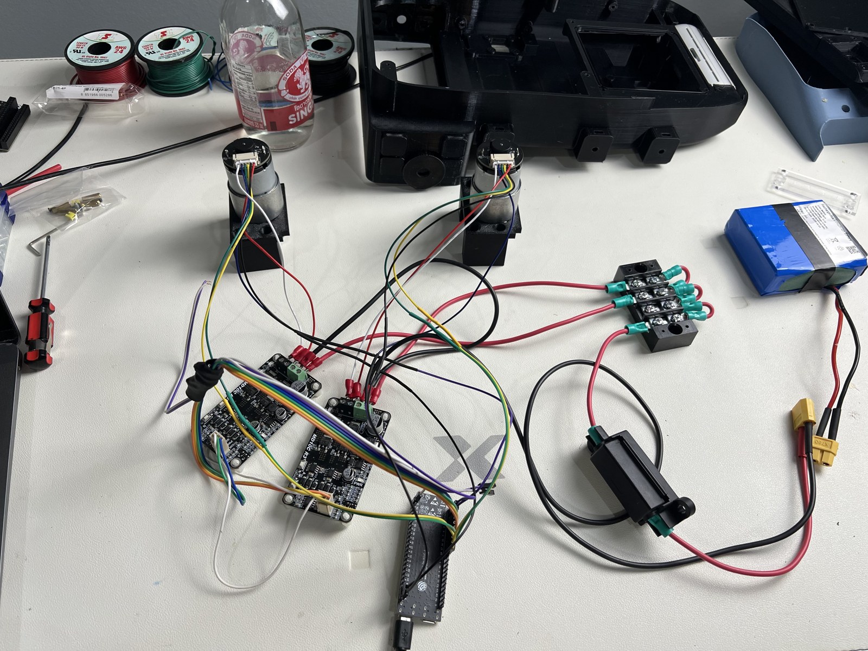
media/images/build_harness_bench_20260920.jpg
