metrox-eth/moss/media/images/build_motor_encoder_bench_20260920.jpg

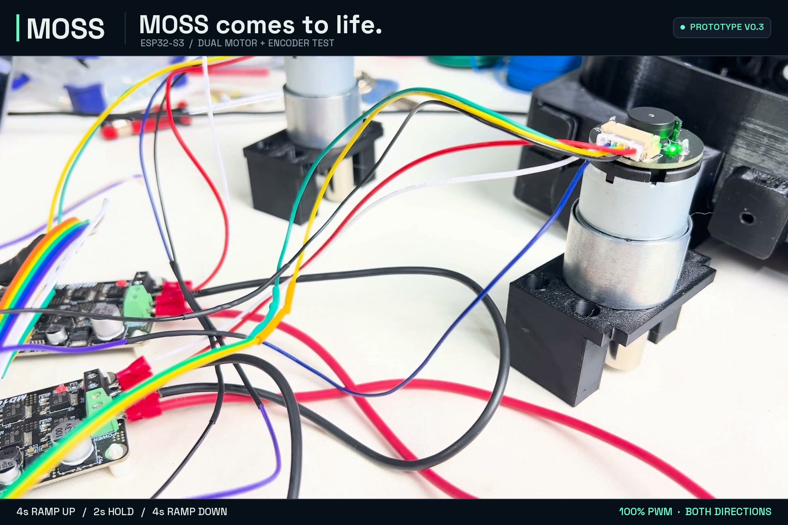
media/images/build_motor_encoder_bench_20260920.jpg
