metrox-eth/moss/media/images/build_print_set_bench_20260919.jpg

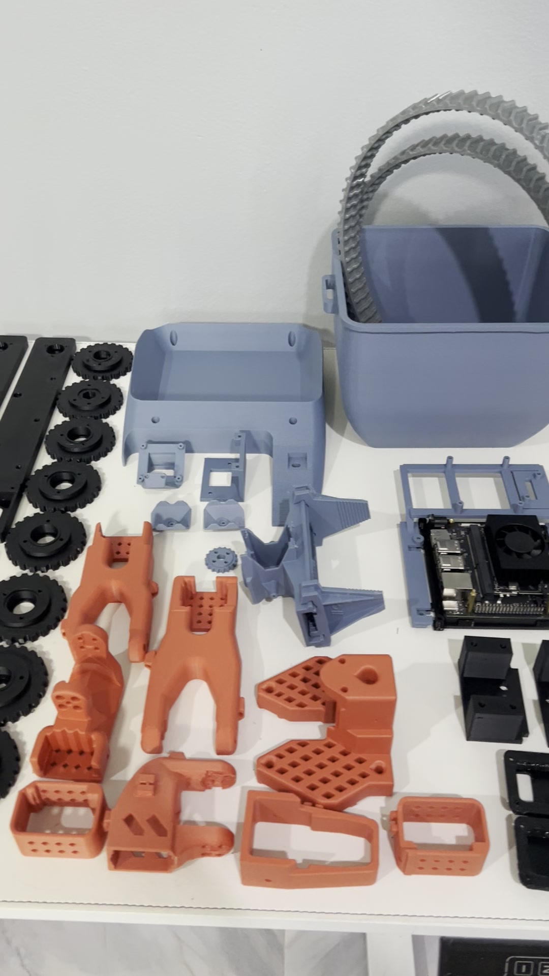
media/images/build_print_set_bench_20260919.jpg
