metrox-eth/moss/media/images/build_tracks_on_20260922.jpg

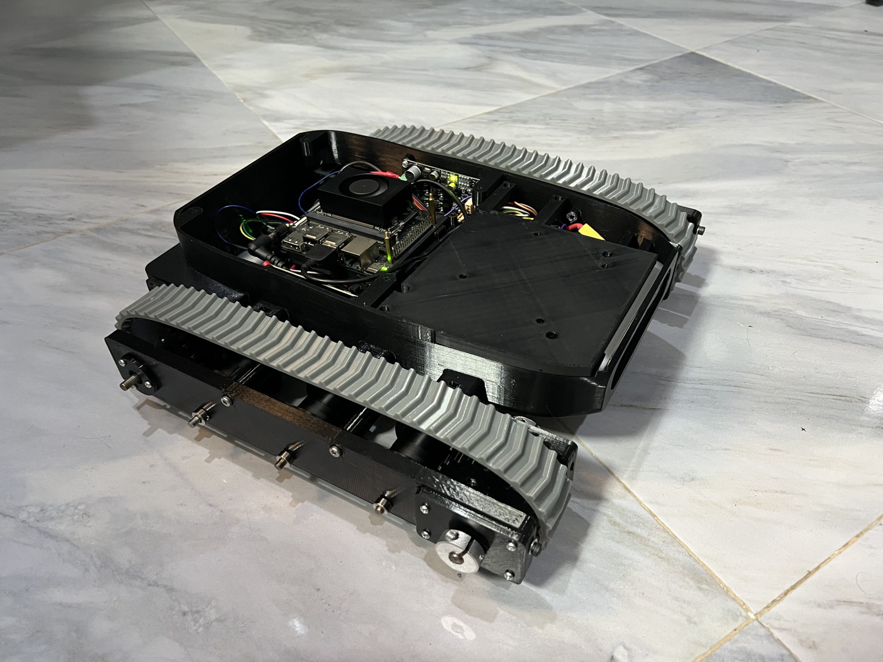
media/images/build_tracks_on_20260922.jpg
