metrox-eth/moss/media/images/moss_v05_print_plates.jpg

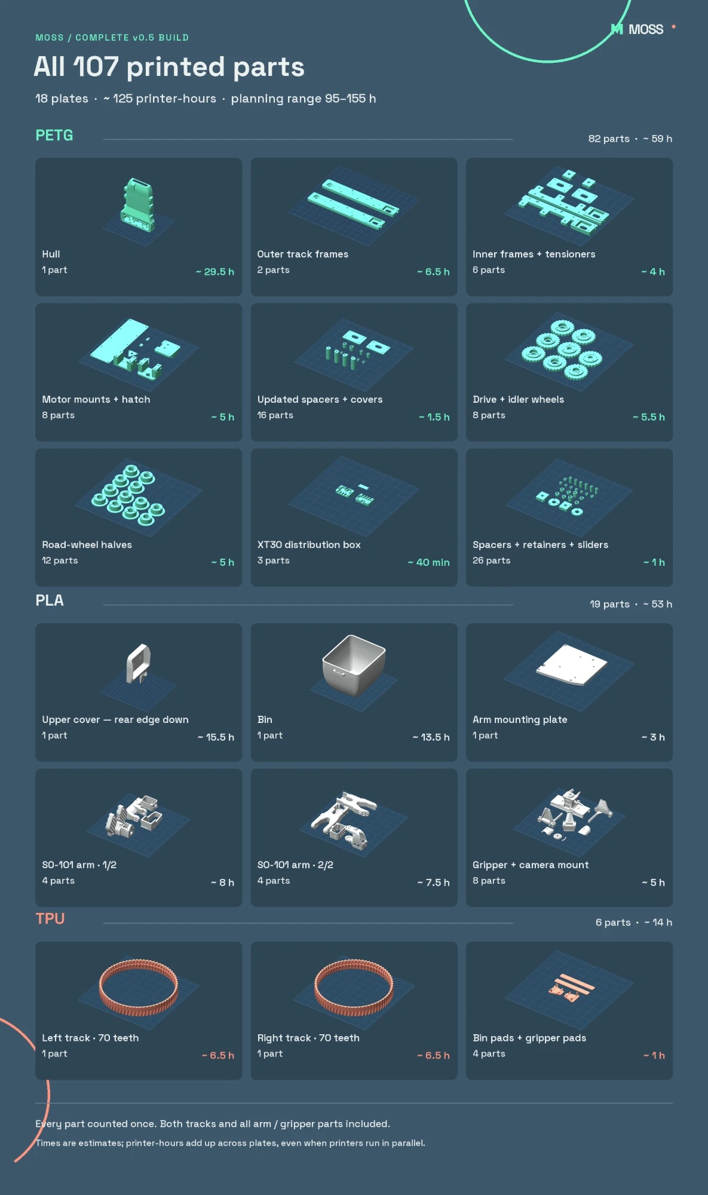
media/images/moss_v05_print_plates.jpg
