metrox-eth/moss/experiments/README.md

# MOSS experiments

Bench work and early ideas for MOSS, the litter-picking rover. These folders are separate from the supported build instructions and describe their own limits.

- **[Trying Zap on MOSS Core](moss-core-zap/)** A routing test on a copy of the PCB, with the returned KiCad files and independent local checks. This first result leaves 29 connections unfinished; the existing layout stays.
- **[Should MOSS pick it up?](litter-pick-or-pass/)** A photo test of YOLO and Jev, with a short video, recorded decisions and an offline replay.
- **[Orange Pi + MightyCam](orange-pi-mightycam/)** — a $60 computer, an $80 camera, dimOS and YOLO on the NPU. First load measurements, source code and a cockpit image; camera accuracy and robot autonomy remain unvalidated.
