metrox-eth/moss/experiments/litter-pick-or-pass/media/credits.md

# Photo credits

The video, preview and example crops use photographs from [TACO](https://github.com/pedropro/TACO). Each original below is licensed under [CC BY 2.0](https://creativecommons.org/licenses/by/2.0/). We cropped the photos and marked the targets.

The can example comes from TACO image 1256 and the leaf from image 1223. The workshop footage is by Laurent Genoud / Show Robotics.

| TACO image | Photographer | Original |
| ---: | --- | --- |
| 1173 | Pedro Proença | [Photo](https://www.flickr.com/photos/161647545@N08/40889652193) |
| 1175 | Pedro Proença | [Photo](https://www.flickr.com/photos/161647545@N08/47804052832) |
| 1176 | Pedro Proença | [Photo](https://www.flickr.com/photos/161647545@N08/40889654633) |
| 1177 | Pedro Proença | [Photo](https://www.flickr.com/photos/161647545@N08/47856286691) |
| 1178 | Pedro Proença | [Photo](https://www.flickr.com/photos/161647545@N08/47804053462) |
| 1187 | Pedro Proença | [Photo](https://www.flickr.com/photos/161647545@N08/32912149767) |
| 1188 | Pedro Proença | [Photo](https://www.flickr.com/photos/161647545@N08/46940024775) |
| 1193 | Pedro Proença | [Photo](https://www.flickr.com/photos/161647545@N08/47066834024) |
| 1194 | Pedro Proença | [Photo](https://www.flickr.com/photos/161647545@N08/46940028735) |
| 1195 | Pedro Proença | [Photo](https://www.flickr.com/photos/161647545@N08/47066835024) |
| 1209 | Pedro Proença | [Photo](https://www.flickr.com/photos/161647545@N08/47804067422) |
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
| 1352 | Pedro Proença | [Photo](https://www.flickr.com/photos/161647545@N08/48580354861) |
| 1357 | Pedro Proença | [Photo](https://www.flickr.com/photos/161647545@N08/48575477386) |
| 1366 | Pedro Proença | [Photo](https://www.flickr.com/photos/161647545@N08/48468031581) |
| 1367 | Pedro Proença | [Photo](https://www.flickr.com/photos/161647545@N08/48468178127) |
| 1369 | Pedro Proença | [Photo](https://www.flickr.com/photos/161647545@N08/48468031166) |
| 1372 | Pedro Proença | [Photo](https://www.flickr.com/photos/161647545@N08/48468030271) |
| 1374 | Mafalda Farelo | [Photo](https://www.flickr.com/photos/183128075@N08/48421449416) |
| 1375 | Mafalda Farelo | [Photo](https://www.flickr.com/photos/183128075@N08/48421448366) |
| 1377 | Mafalda Farelo | [Photo](https://www.flickr.com/photos/183128075@N08/48421596162) |
| 1383 | Mafalda Farelo | [Photo](https://www.flickr.com/photos/183128075@N08/48421442391) |
| 1390 | Mafalda Farelo | [Photo](https://www.flickr.com/photos/183128075@N08/48421433886) |
| 1397 | Mafalda Farelo | [Photo](https://www.flickr.com/photos/183128075@N08/48421573442) |
