metrox-eth/moss/experiments/litter-pick-or-pass/examples/can.jpg

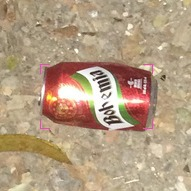
experiments/litter-pick-or-pass/examples/can.jpg
