metrox-eth/moss/experiments/litter-pick-or-pass/examples/leaf.jpg

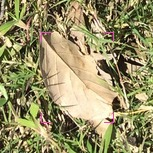
experiments/litter-pick-or-pass/examples/leaf.jpg
