metrox-eth/moss/CHANGELOG.md

# Changelog

Hardware revisions. Dates are when it was real, not when it was planned.

- **10 October 2026, first drive at the gamepad.** The V0.5 rover, arm mounted, driven on the floor from a gamepad through dimOS: forward, reverse, turns, pivots. What it took and what it showed:
  - Firmware `qtpy-mdd3a-v3` on the QT Py ESP32-S3 (`firmware/MOSS_QTPY_MDD3A/`): the 25 % commissioning limit is gone, full stick is 100 % PWM (at 25 % the loaded tracks did not move at all); left track direction fixed in the firmware, encoder counts follow; `ramp UP DOWN` sets the rise and fall slopes live; a build switch for the Cytron MDD10A (PWM + DIR) next to the MDD3A build; the board names its driver in the banner and the telemetry. Host test updated.
  - Teleop: the base runs as a dimOS blueprint (`moss-gamepad` in [vector-dimos](https://github.com/metrox-eth/vector-dimos)): deadman on the pad, twist to track percent, keepalive inside the firmware's 300 ms deadman, tank steering (past half turn stick the inner track reverses), one launcher with gates (pad, board, firmware, battery) and a telemetry line every two seconds while driving.
  - Seen under load: the board applies 100 %, the 3S battery drops from 11.6 V at rest to 10.8 V in a pivot. Verdict on the drive line: the MDD3A (3 A per channel) and the 56:1 motors leave no headroom for ramps. Next on the drive line: Cytron MDD10A (10 A per channel) and JGB37-520 motors at 110 rpm (higher ratio), both not installed yet; the firmware build for the MDD10A already exists.
  - Tracks: the double tensioner holds, the bearings keep mechanical friction low; the TPU tracks may need running in, or print settings that make them more supple.
  - In CAD, no part printed or fitted: hull R19 with an integrated mount for the MDD10A (rotated hole pattern 55.88 x 78.74 mm, four M3 x 6 into 2.7 mm pilot holes, no inserts), charging jack moved to clear the larger board, the motor-side drive-spacer passages opened to 9.5 mm; transmission R12-C1 (two drive-shaft spacers that were missing, 3.5 mm, PETG) and R12-C2 (matching screw-head recesses on the inner frames and inner tensioner plates, so all four tension screws become M4 x 35). CAD checks only; the production plates and the BOM are not reconciled to it, and nothing is frozen.
  - Still open on V0.6: fan spacing and clip retention next to the motor brackets, inserts for the LiDAR mount, upper cover and arm platform, the LiDAR collision, one consistent hole pattern per wheel type.
- **V0.6** (October 2026): modular compute and perception plates (Jetson or Raspberry Pi; RealSense or Orbbec Gemini), XT30 power block, 12 V to 5 V converter for the Pi, hull R7, tracks 70 teeth at 10 mm pitch.
- **V0.5** (1 October 2026): redrawn on the real robot; one-piece hull, two tensioners per track, mounts for every board, magnets for the bin. 107 printed parts.
- **V0.4** (24 September 2026): revised hull, screw-terminal controller, one dual motor driver.
- **V0.3** (22 September 2026): first prototype. First drive on 22 September, arm and gripper on 26 September.
