metrox-eth/moss/simulation/mujoco/model/moss_robot.xml

<?xml version='1.0' encoding='utf-8'?>
<mujoco model="MOSS V0.6 R92 — preliminary simulation">
  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
  <compiler angle="radian" meshdir="meshes" autolimits="true" inertiafromgeom="false" />
  <option timestep=".002" integrator="implicitfast" cone="elliptic" iterations="50">
    <flag filterparent="disable" />
  </option>
  <default>
    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
    <default class="so101">
      <joint damping="1" frictionloss="0.1" armature="0.005" />
      <position kp="50" />
      <default class="visual">
        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
      </default>
      <default class="collision">
        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
      </default>
      <default class="collision_gripper">
        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
      </default>
      <default class="collision_gripper_mesh">
        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
      </default>
    </default>
    <default class="sts3215">
      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
      <joint damping="0.60" frictionloss="0.052" armature="0.028" />
      <position kp="998.22" kv="2.731" forcerange="-2.94 2.94" />
    </default>
    <default class="backlash">
      <joint damping="0.01" frictionloss="0" armature="0.01" limited="true" range="-0.0087267 0.0087267" />
    </default>
  </default>
  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
  <statistic center=".04 0 .17" extent=".8" />
  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
  <worldbody>
    <body name="rover">
      <joint name="base_x" type="slide" axis="1 0 0" limited="false" damping="0" armature=".001" />
      <joint name="base_y" type="slide" axis="0 1 0" limited="false" damping="0" armature=".001" />
      <joint name="base_yaw" type="hinge" axis="0 0 1" limited="false" damping="0" armature=".001" />
      <inertial mass="4.0" pos="0 0 .075" diaginertia="0.035 0.045 0.065" />
      <body name="base" pos="0.103 -0.04 0.1004" quat="0.793353340291 0 0 0.608761429009" childclass="so101">
        <inertial pos="0.0137179 -5.19711e-05 0.0334843" mass="0.147" fullinertia="0.000114686 0.000136117 0.000130364 -4.59787e-07 4.97151e-06 9.75275e-08" />
        <body name="shoulder" pos="0.0388353 0 0.0624" quat="0 0 -1 0">
          <joint axis="0 0 1" name="shoulder_pan" type="hinge" range="-1.91986 1.91986" class="sts3215" />
          <inertial pos="-0.0307604 -1.7e-05 -0.0252713" mass="0.100006" fullinertia="8.3759e-05 8.10403e-05 2.39783e-05 7.55525e-08 -1.16342e-06 1.54663e-07" />
          <body name="upper_arm" pos="-0.0303992 -0.0182778 -0.0542" quat="1 -1 -1 -1">
            <joint axis="0 0 1" name="shoulder_lift" type="hinge" range="-1.7453293 1.7453293" class="sts3215" />
            <inertial pos="-0.089847 -0.008382 0.018409" mass="0.103" fullinertia="4.08002e-05 0.000147318 0.000142487 -1.97819e-05 -4.03016e-08 8.97326e-09" />
            <body name="lower_arm" pos="-0.11257 -0.028 0" quat="1 0 0 1">
              <joint axis="0 0 1" name="elbow_flex" type="hinge" range="-1.69 1.69" class="sts3215" />
              <inertial pos="-0.098070 0.0032438 0.018283" mass="0.104" fullinertia="2.87438e-05 0.000159844 0.00014529 7.41152e-06 1.26409e-06 -4.90188e-08" />
              <body name="wrist" pos="-0.1349 0.0052 0" quat="1 0 0 -1">
                <joint axis="0 0 1" name="wrist_flex" type="hinge" range="-1.658063 1.658063" class="sts3215" />
                <inertial pos="-0.000103312 -0.0386143 0.0281156" mass="0.079" fullinertia="3.68263e-05 2.5391e-05 2.1e-05 1.7893e-08 -5.28128e-08 3.6412e-06" />
                <body name="gripper" pos="5.55112e-17 -0.0611 0.0181" quat="0.0172091 -0.0172091 0.706897 0.706897">
                  <joint axis="0 0 1" name="wrist_roll" type="hinge" range="-2.7438473 2.8412063" class="sts3215" />
                  <inertial pos="0 0 -.035" mass=".15" diaginertia=".00012 .00012 .00008" />
                  <body name="nc90_tool" pos="-1.09576993798e-06 3.82753150396e-07 -0.0484503111592" quat="-0.411722428892 5.53550068644e-08 -2.01628535127e-06 0.9113093007">
                    <body name="nc90_jaw_left">
                      <joint name="nc90_jaw_left_slide" type="slide" axis="0 1 0" range="0 .045" damping="1" armature=".001" frictionloss=".02" />
                      <inertial pos="0 0 0" mass=".03" diaginertia=".00004 .00002 .00004" />
                      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
                    </body>
                    <body name="nc90_jaw_right">
                      <joint name="nc90_jaw_right_slide" type="slide" axis="0 -1 0" range="0 .045" damping="1" armature=".001" frictionloss=".02" />
                      <inertial pos="0 0 0" mass=".03" diaginertia=".00004 .00002 .00004" />
                      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
                    </body>
                    <body name="nc90_drive">
                      <joint name="nc90_pinion" type="hinge" axis="0 0 1" range="0 3.78505138987" damping="0.0001" armature=".000001" frictionloss="0" />
                      <inertial pos="0 0 0" mass=".01" diaginertia=".000001 .000001 .000002" />
                      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
                    </body>
                    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
                    <camera name="wrist_camera_ideal" pos="-.064 0 .005" fovy="100" />
                    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
                  </body>
                </body>
                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
              </body>
              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
            </body>
            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
          </body>
          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
        </body>
        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
      </body>
      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
      <camera name="front_camera_ideal" pos=".161 0 .075" xyaxes="0 -1 0 0 0 1" fovy="60" />
    </body>
  </worldbody>
  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
  <equality>
    <joint name="symmetric_nc90_jaws" joint1="nc90_jaw_right_slide" joint2="nc90_jaw_left_slide" polycoef="0 1 0 0 0" />
    <joint name="nc90_rack_pinion" joint1="nc90_pinion" joint2="nc90_jaw_left_slide" polycoef="0 84.1122531082 0 0 0" />
  </equality>
  <actuator>
    <position class="sts3215" name="shoulder_pan" joint="shoulder_pan" ctrlrange="-1.91986 1.91986" />
    <position class="sts3215" name="shoulder_lift" joint="shoulder_lift" ctrlrange="-1.74533 1.74533" />
    <position class="sts3215" name="elbow_flex" joint="elbow_flex" ctrlrange="-1.69 1.69" />
    <position class="sts3215" name="wrist_flex" joint="wrist_flex" ctrlrange="-1.65806 1.65806" />
    <position class="sts3215" name="wrist_roll" joint="wrist_roll" ctrlrange="-2.74385 2.84121" />
    <position name="nc90_close" joint="nc90_jaw_left_slide" kp="400" ctrlrange="0 .045" forcerange="-10 10" kv="5" />
    <velocity name="base_vx" joint="base_x" kv="60" ctrlrange="-.35 .35" forcerange="-20 20" />
    <velocity name="base_vy" joint="base_y" kv="60" ctrlrange="-.35 .35" forcerange="-20 20" />
    <velocity name="base_wz" joint="base_yaw" kv="8" ctrlrange="-2.6 2.6" forcerange="-8 8" />
  </actuator>
  <sensor>
    <jointpos name="base_x_position" joint="base_x" />
    <jointvel name="base_x_velocity" joint="base_x" />
    <jointpos name="base_y_position" joint="base_y" />
    <jointvel name="base_y_velocity" joint="base_y" />
    <jointpos name="base_yaw_position" joint="base_yaw" />
    <jointvel name="base_yaw_velocity" joint="base_yaw" />
    <jointpos name="shoulder_pan_position" joint="shoulder_pan" />
    <jointvel name="shoulder_pan_velocity" joint="shoulder_pan" />
    <jointpos name="shoulder_lift_position" joint="shoulder_lift" />
    <jointvel name="shoulder_lift_velocity" joint="shoulder_lift" />
    <jointpos name="elbow_flex_position" joint="elbow_flex" />
    <jointvel name="elbow_flex_velocity" joint="elbow_flex" />
    <jointpos name="wrist_flex_position" joint="wrist_flex" />
    <jointvel name="wrist_flex_velocity" joint="wrist_flex" />
    <jointpos name="wrist_roll_position" joint="wrist_roll" />
    <jointvel name="wrist_roll_velocity" joint="wrist_roll" />
    <jointpos name="nc90_jaw_left_slide_position" joint="nc90_jaw_left_slide" />
    <jointvel name="nc90_jaw_left_slide_velocity" joint="nc90_jaw_left_slide" />
    <jointpos name="nc90_jaw_right_slide_position" joint="nc90_jaw_right_slide" />
    <jointvel name="nc90_jaw_right_slide_velocity" joint="nc90_jaw_right_slide" />
  </sensor>
  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
</mujoco>
