metrox-eth/moss/(list of files, drawings)

Other design files:
hardware/electronics/moss-core-v0.7/harness/source/PCB_CONNECTOR_ANCHORS.json
