metrox-eth/moss/hardware/electronics/moss-core-v0.7/electrical/MOSS_Core_V07_Prototype.kicad_pcb

## KiCad design hardware/electronics/moss-core-v0.7/electrical/MOSS_Core_V07_Prototype.kicad_pcb (2026-11-01, an earlier design)

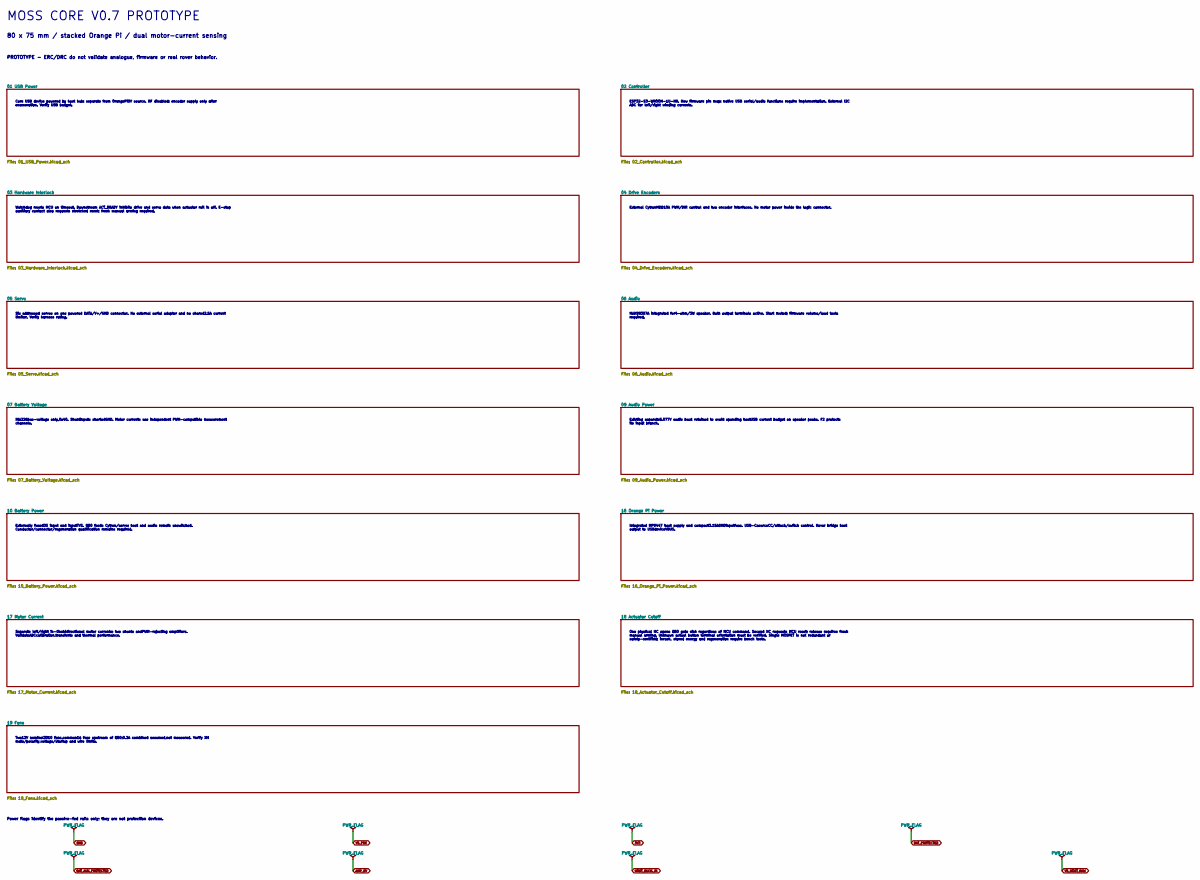
[picture p178: schematic MOSS_Core_V07_Prototype.kicad_sch, MOSS Core V0.7 PROTOTYPE / system overview]

Notes on the sheet:
MOSS CORE V0.7 PROTOTYPE
80 x 75 mm / stacked Orange Pi / dual motor-current sensing
PROTOTYPE - ERC/DRC do not validate analogue, firmware or real rover behavior.
Core USB device powered by host hub; separate from OrangePi5V source. RF disabled; encoder supply only after enumeration. Verify USB budget.
ESP32-S3-WROOM-1U-N8. New firmware pin map; native USB serial/audio functions require implementation. External I2C ADC for left/right winding currents.
Watchdog resets MCU on timeout. Downstream ACT_READY inhibits drive and servo data when actuator rail is off. E-stop auxiliary contact also requests stretched reset; fresh manual arming required.
External CytronMDD10A PWM/DIR control and two encoder interfaces. No motor power inside the logic connector.
Six addressed servos on one powered DATA/V+/GND connector. No external serial adapter and no shared2.5A current limiter. Verify harness rating.
MAX98357A integrated for4-ohm/3W speaker. Both output terminals active. Start muted; firmware volume/load tests required.
INA226bus-voltage only,0x40. Shuntinputs shortedGND. Motor currents use independent PWM-compatible measurement channels.
Existing separate5.077V audio buck retained to avoid spending hostUSB current budget on speaker peaks. F2 protects its input branch.
Externally fused3S input and inputTVS. Q50 feeds Cytron/servo; host and audio remain unswitched. Conductor/connector/regeneration qualification remains required.
Integrated MP9447 host supply and compact3.15ASMDinputfuse. USB-CsourceCC/attach/switch control. Never bridge host output to USBdeviceVBUS.
Separate left/right in-linebidirectional motor currents; two shunts andPWM-rejecting amplifiers. ValidateADCcalibration,transients and thermal performance.
One physical NC opens Q50 gate sink regardless of MCU command. Second NC requests MCU reset; release requires fresh manual arming. Unknown actual button terminal orientation must be verified. Single MOSFET is not redundant or safety-certified; inrush, stored energy and regeneration require bench te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
Two12V nominal3010 fans,common1A fuse upstream of Q50;0.2A combined assumed,not measured. Verify XH mate/polarity,voltage/startup and wire limits.
Power flags identify the passive-fed rails only; they are not protection devices.

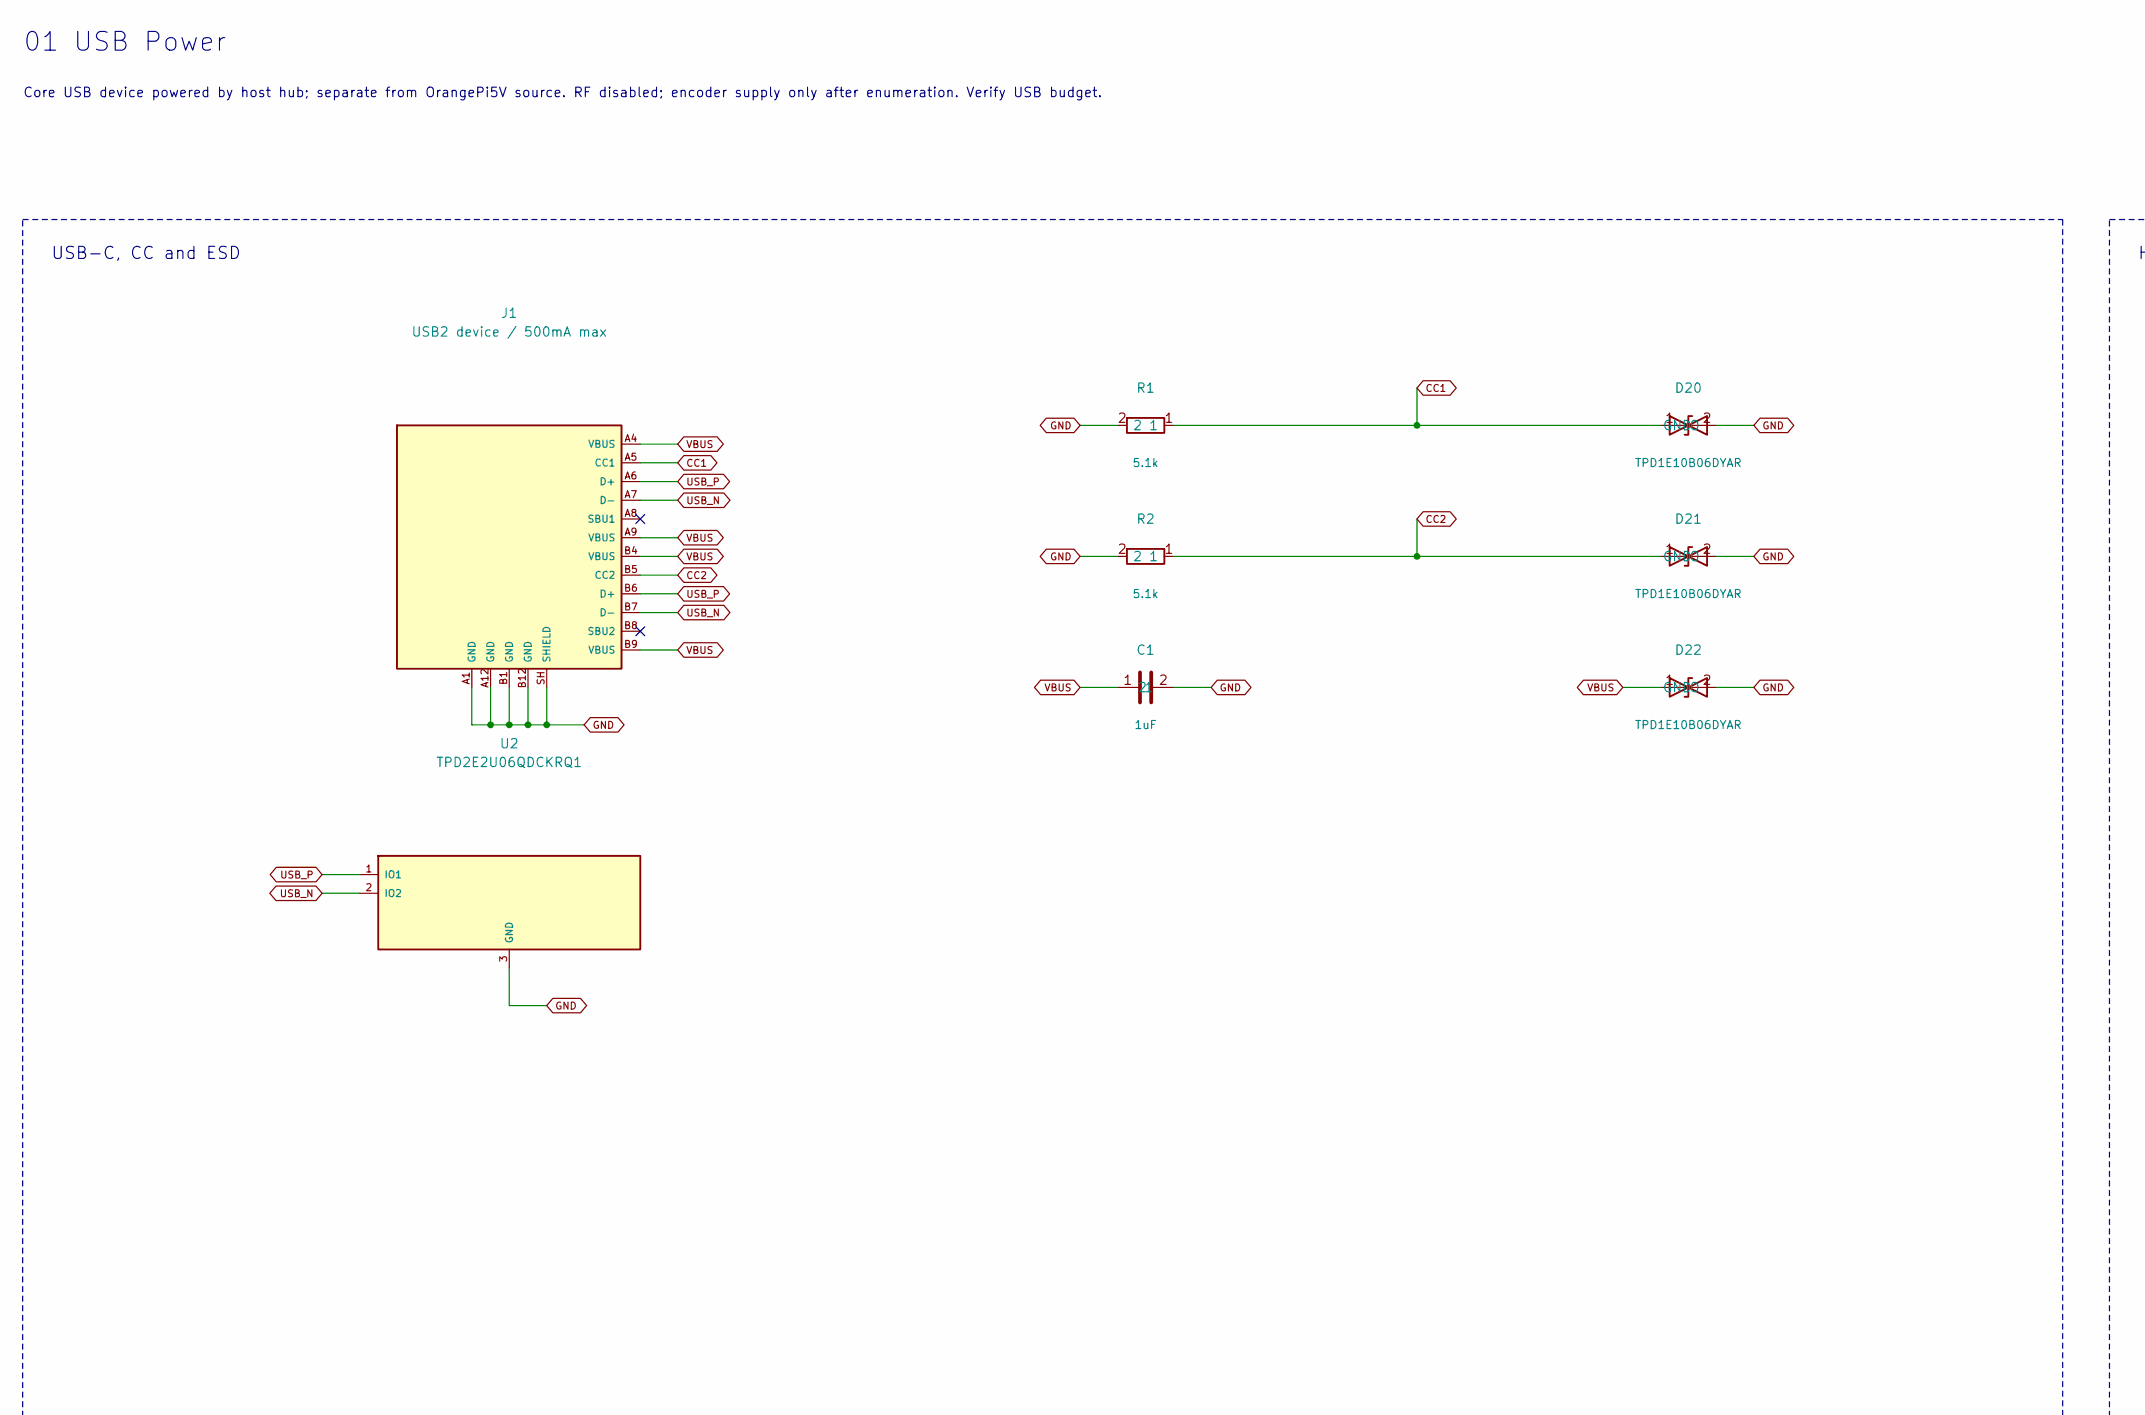
[picture p179: schematic 01_USB_Power.kicad_sch, MOSS Core V0.7 PROTOTYPE / 01 USB Power, part in row 1, column 1]

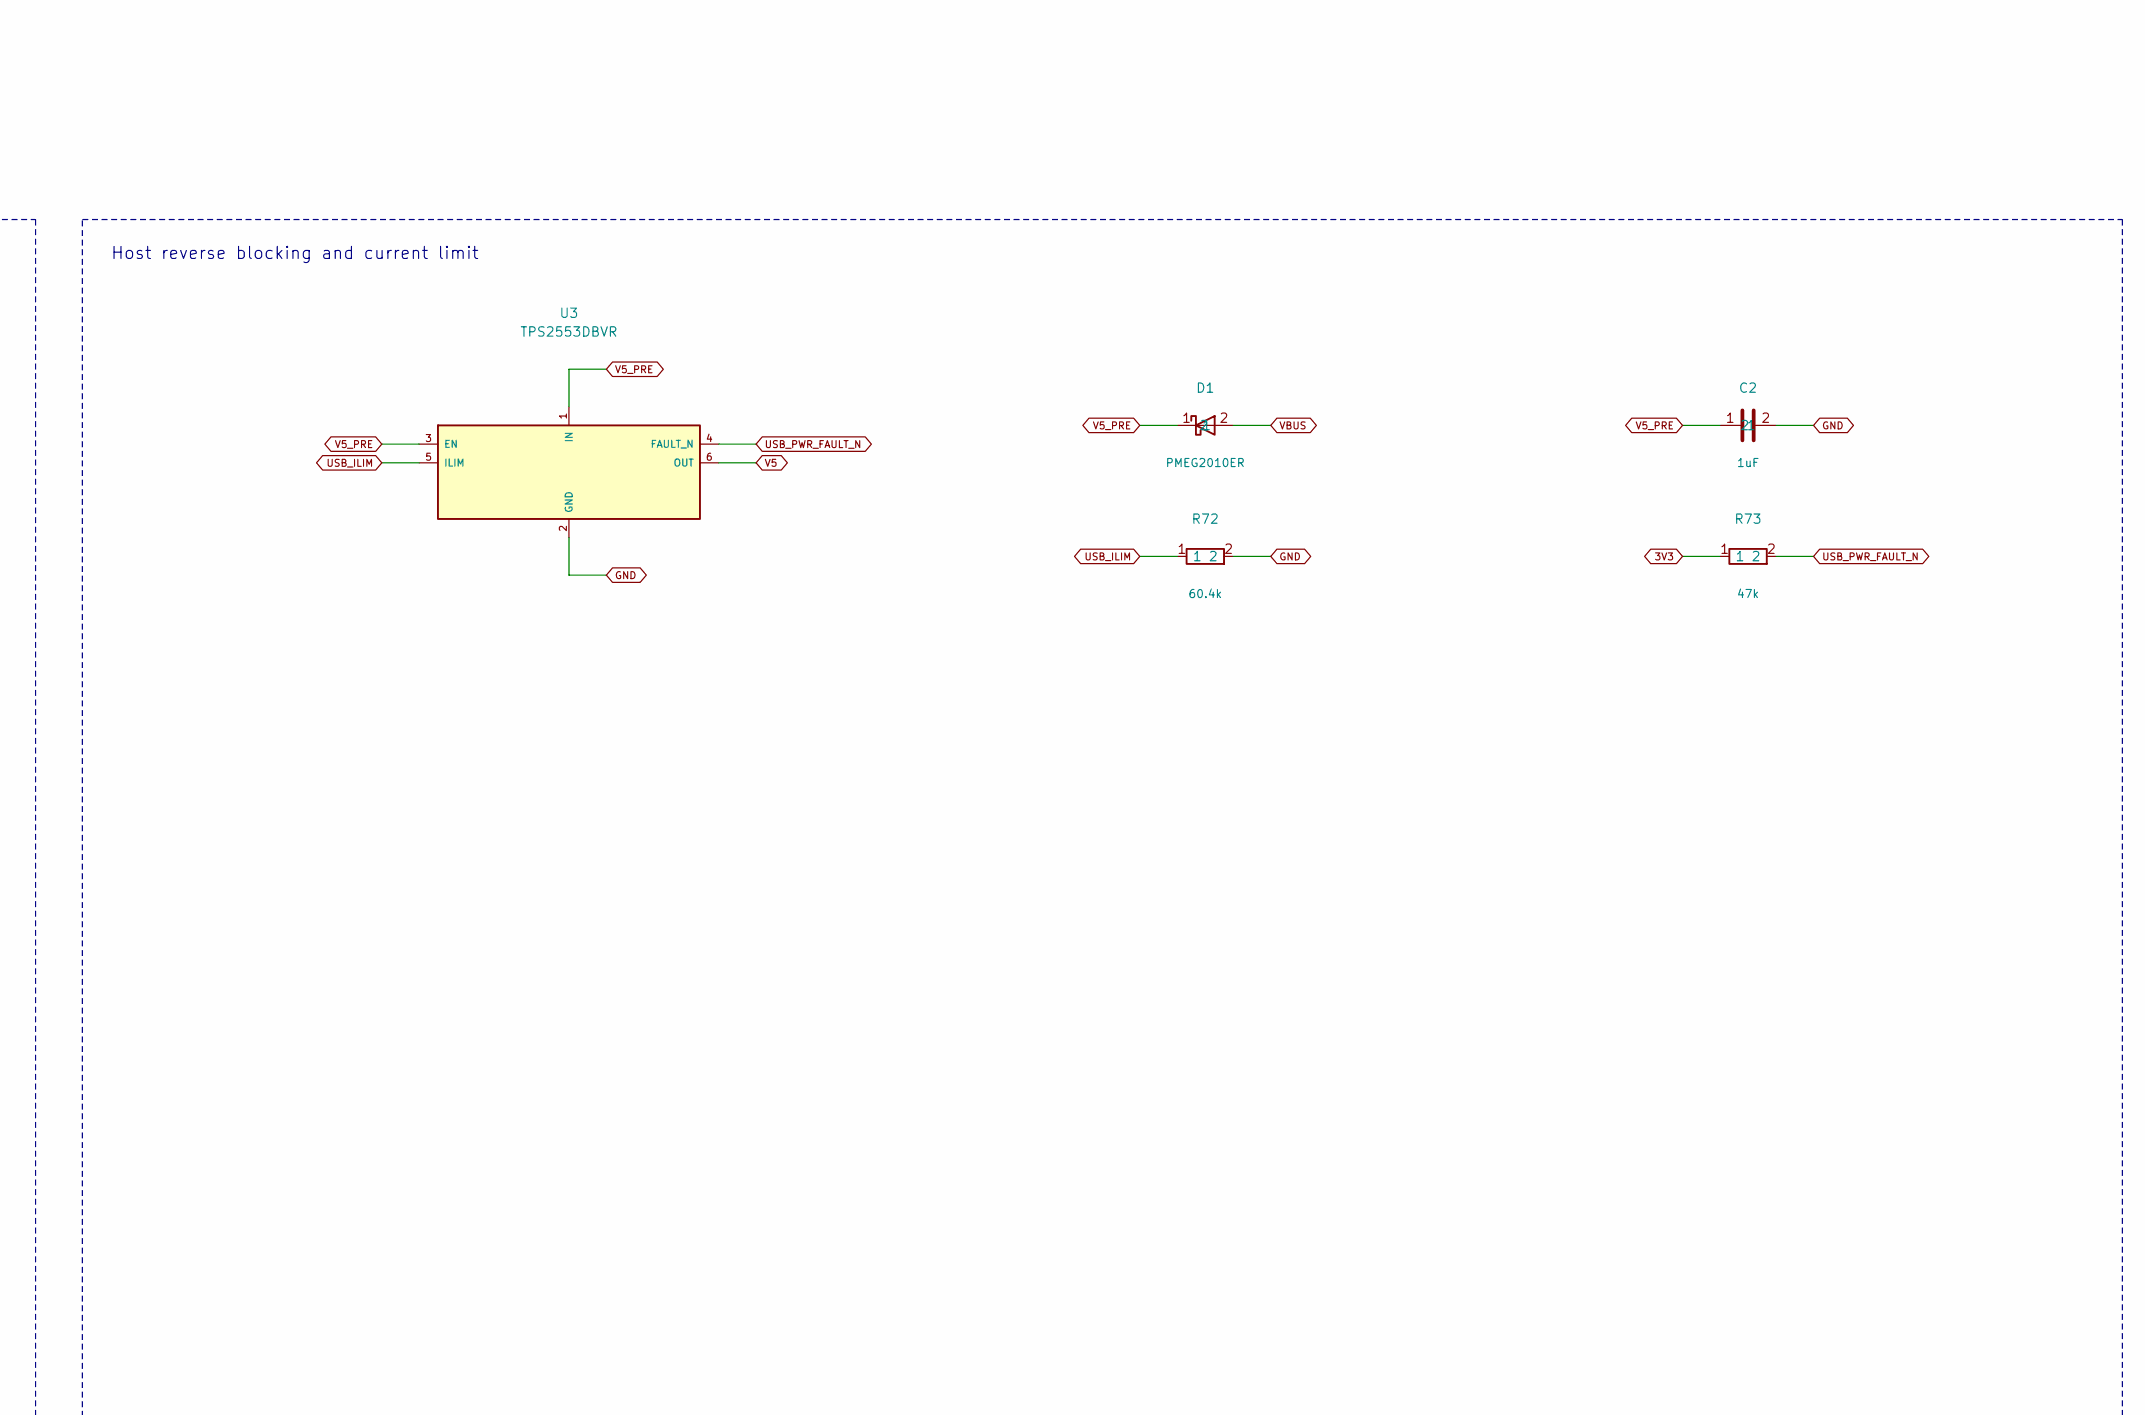
[picture p180: schematic 01_USB_Power.kicad_sch, MOSS Core V0.7 PROTOTYPE / 01 USB Power, part in row 1, column 2]

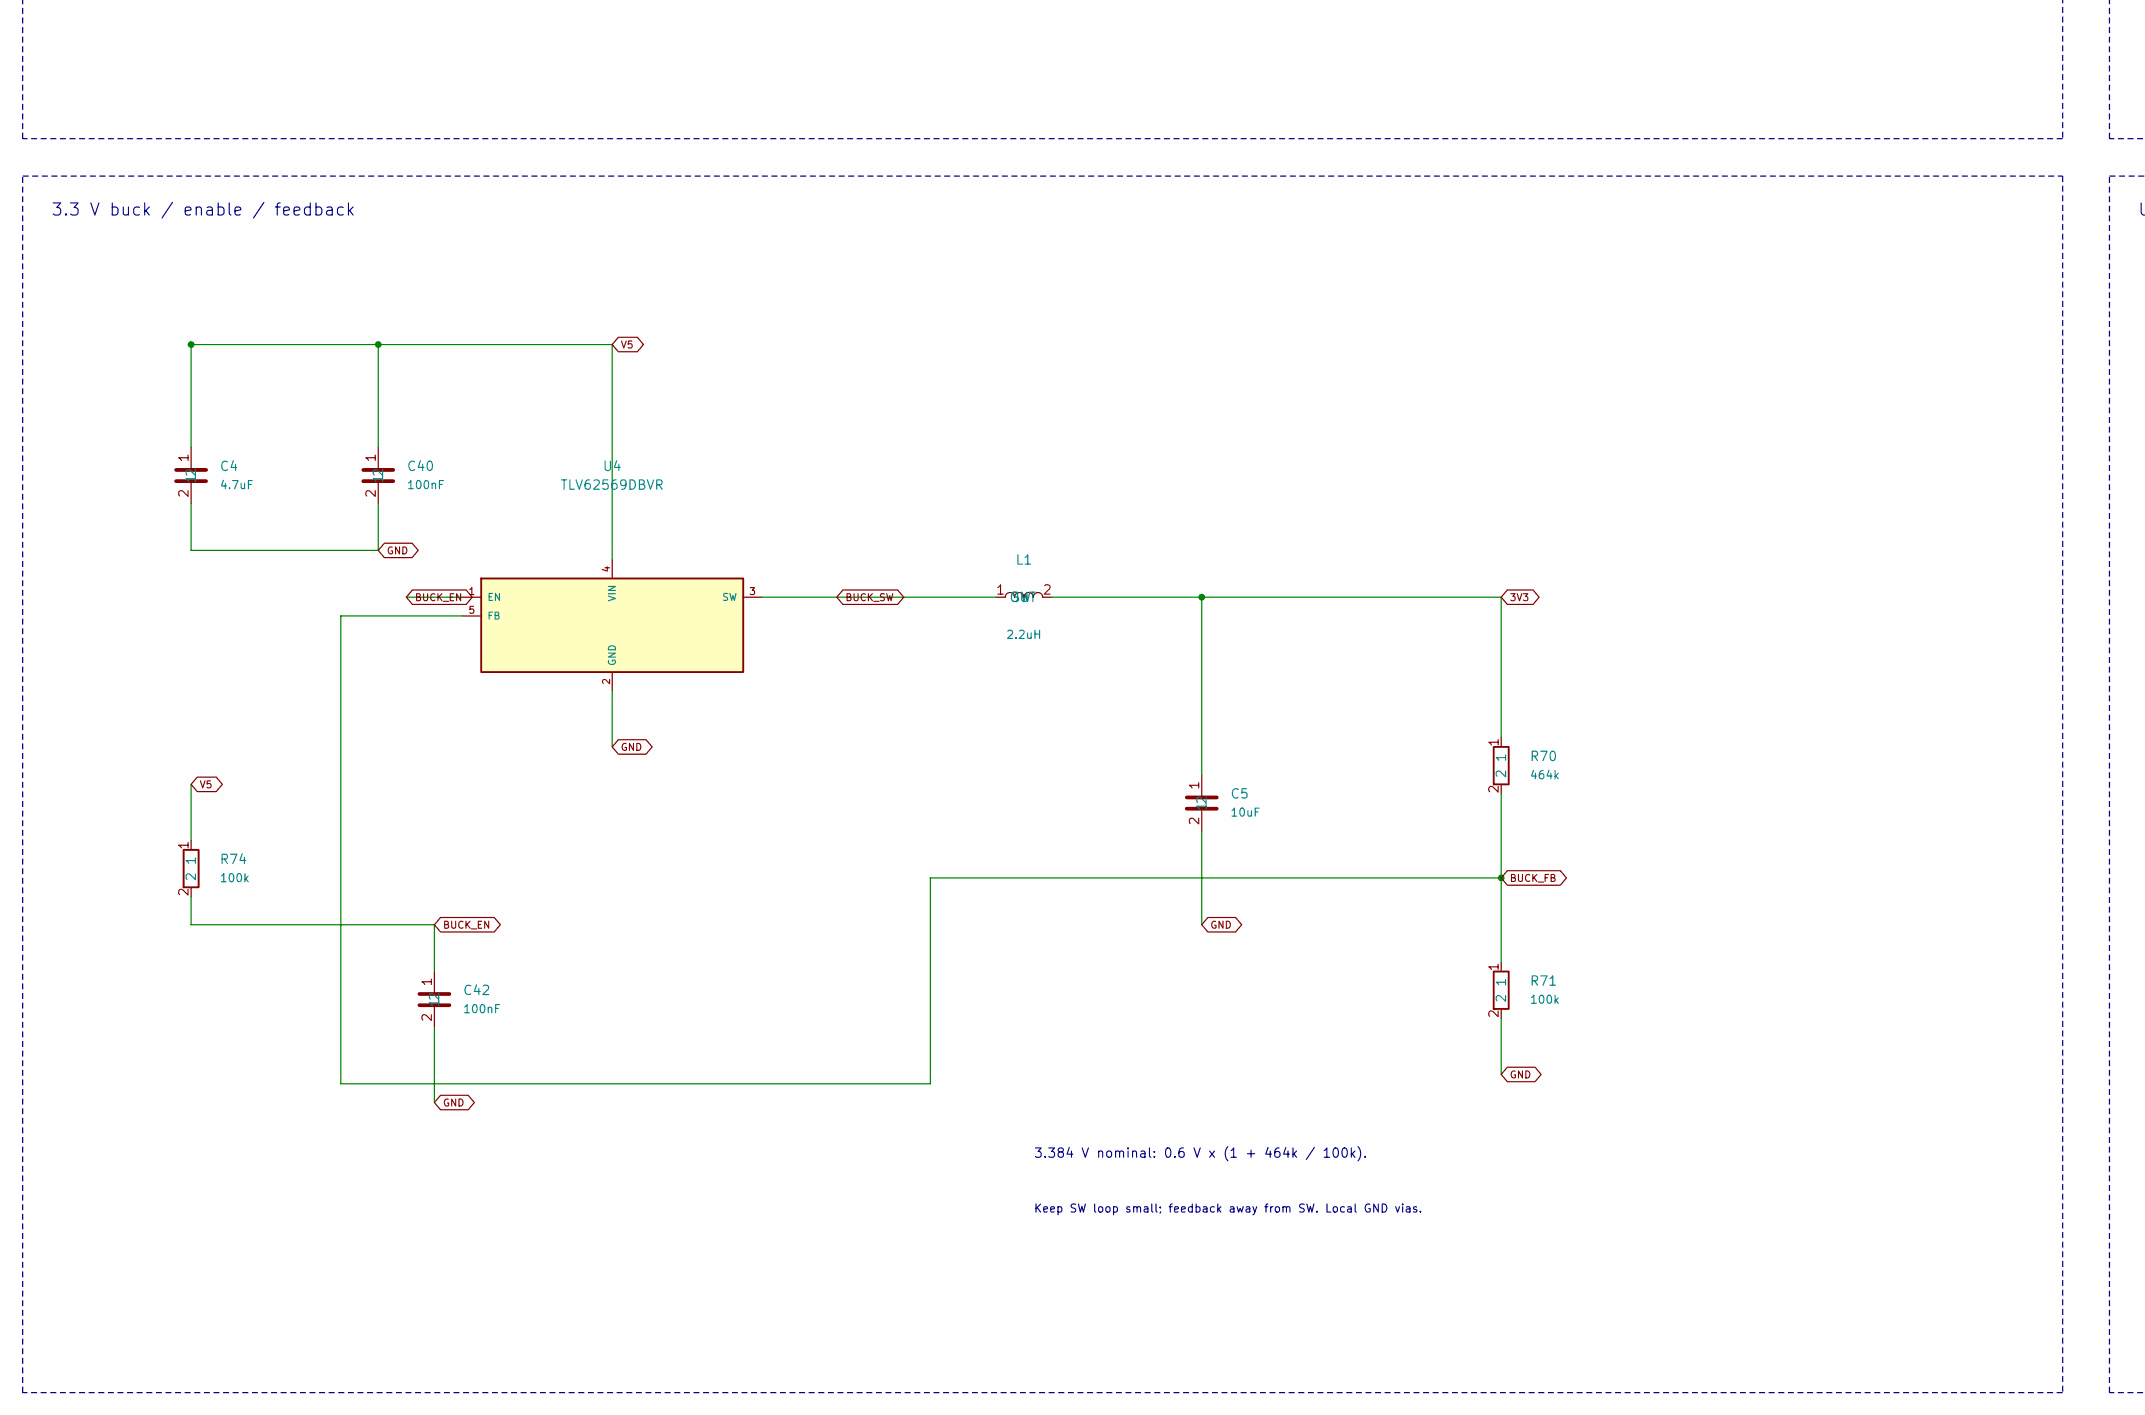
[picture p181: schematic 01_USB_Power.kicad_sch, MOSS Core V0.7 PROTOTYPE / 01 USB Power, part in row 2, column 1]

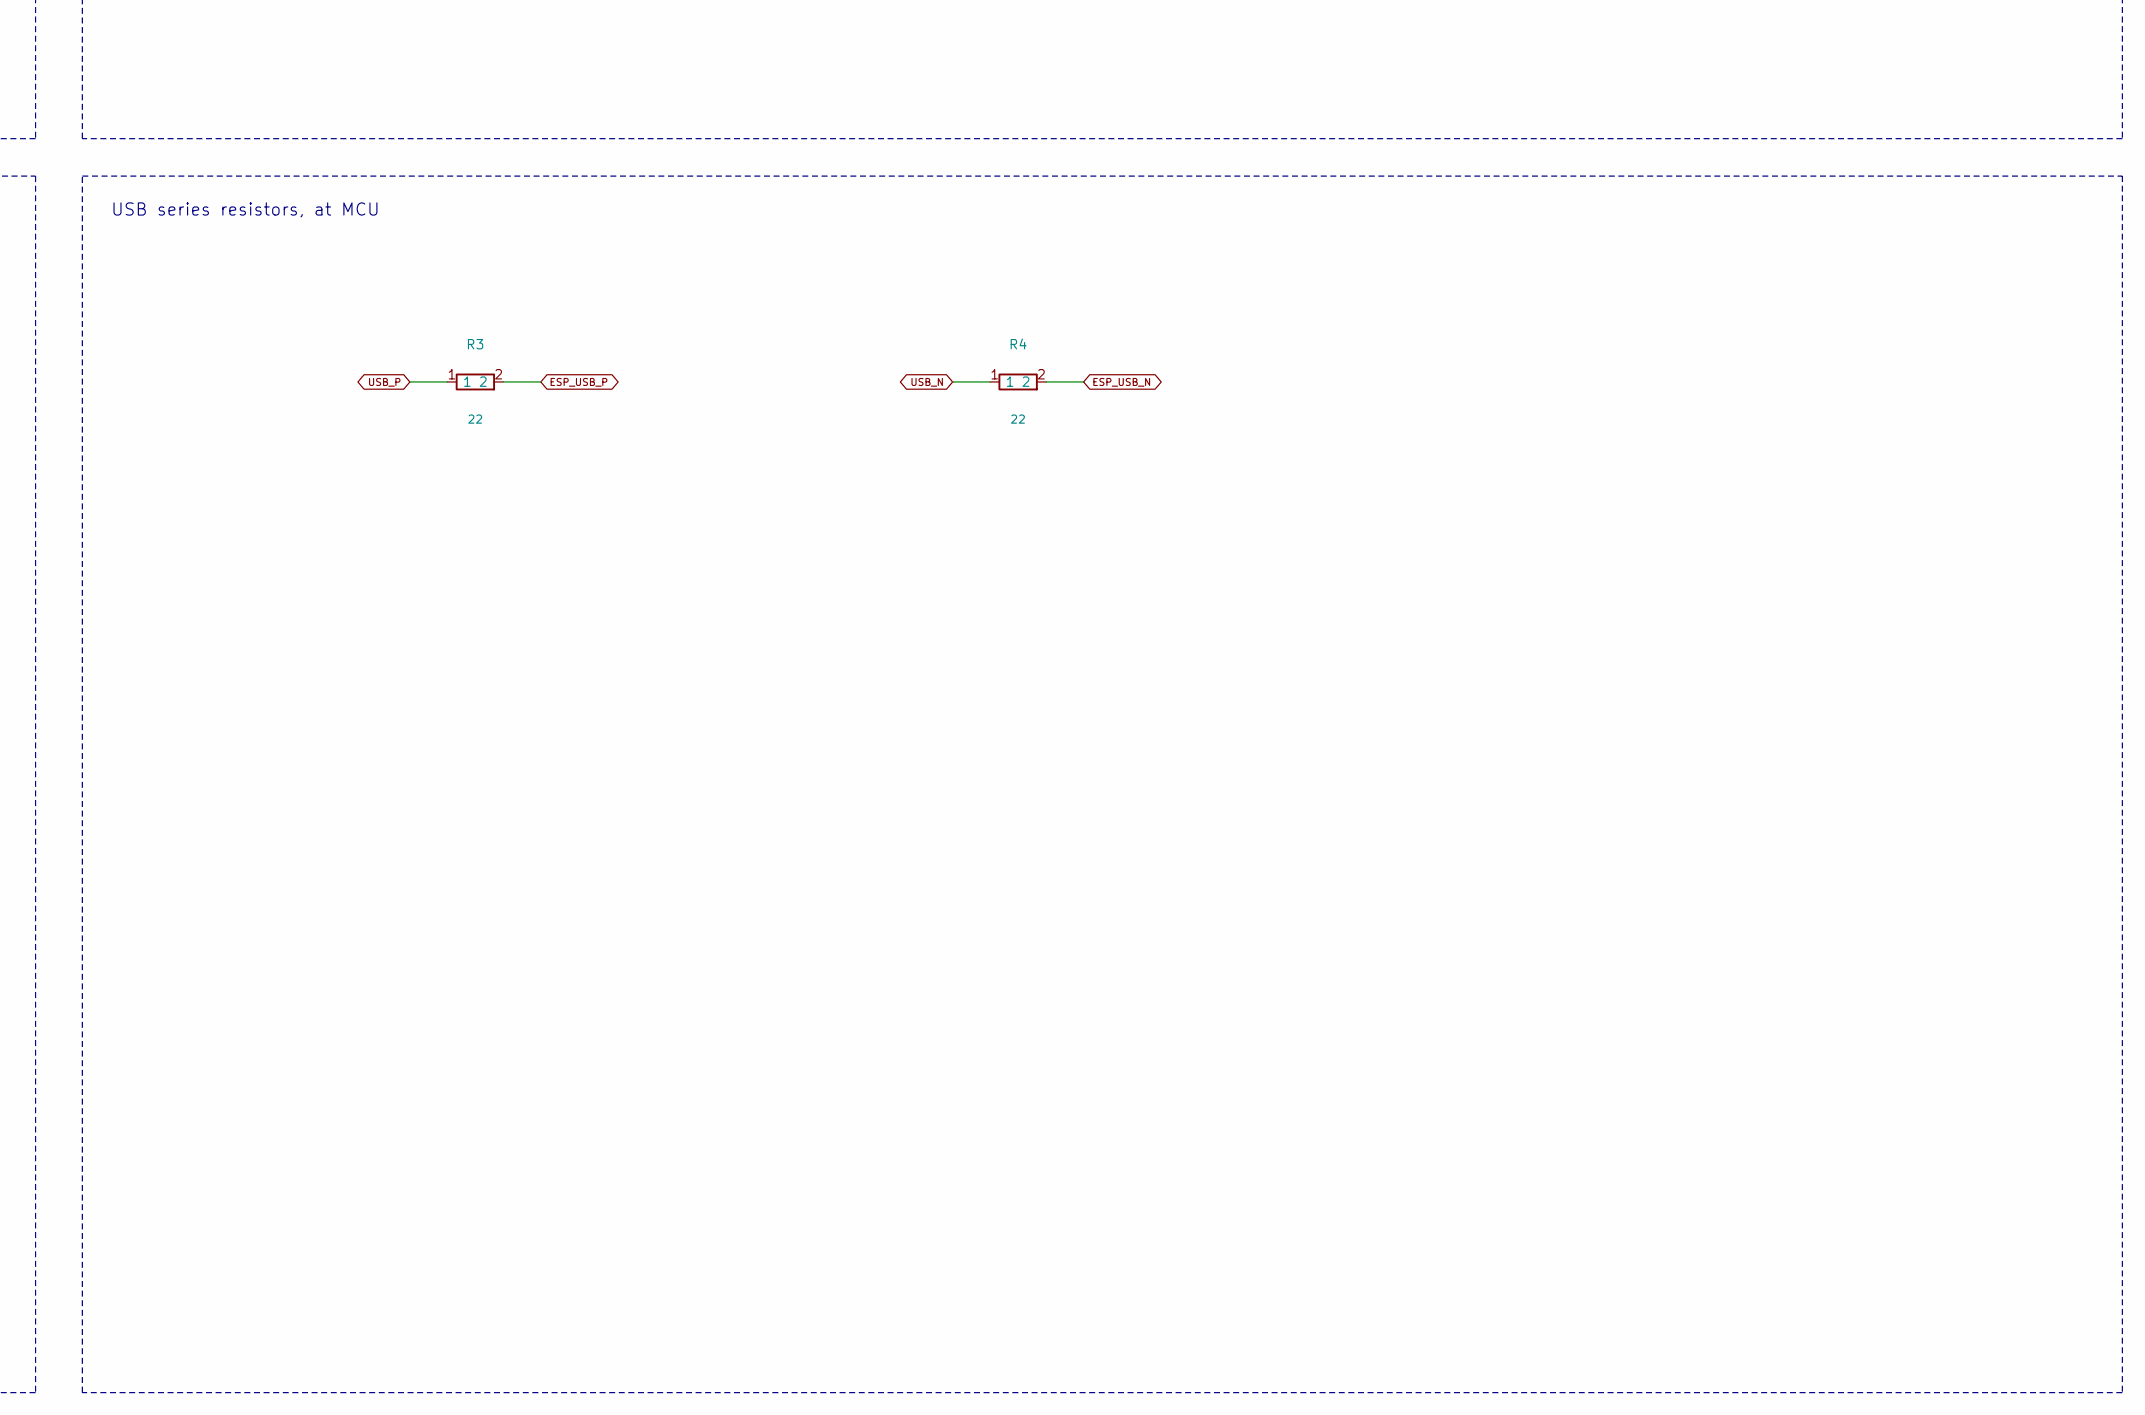
[picture p182: schematic 01_USB_Power.kicad_sch, MOSS Core V0.7 PROTOTYPE / 01 USB Power, part in row 2, column 2]

Parts:
C1, C2: 1uF; Capacitor_SMD_C_0603_1608Metric; MPN GRM188R61A105KA61D
C4: 4.7uF; Capacitor_SMD_C_0805_2012Metric; MPN GRM21BR71A475KA73L
C5: 10uF; Capacitor_SMD_C_0805_2012Metric; MPN GRM21BR71A106KA73L
C40, C42: 100nF; Capacitor_SMD_C_0603_1608Metric; MPN GRM188R71C104KA01D
D1: PMEG2010ER; Diode_SMD_Nexperia_CFP3_SOD-123W; MPN PMEG2010ER,115
D20, D21, D22: TPD1E10B06DYAR; Diode_SMD_D_SOD-523; MPN TPD1E10B06DYAR
J1: USB2 device / 500mA max; Connector_USB_USB_C_Receptacle_GCT_USB4105-xx-A_16P_TopMnt_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; MPN USB4105-GF-A
L1: 2.2uH; Inductor_SMD_L_Coilcraft_XAL4020-XXX; MPN XAL4020-222MEC
R1, R2: 5.1k; Resistor_SMD_R_0603_1608Metric; MPN RC0603FR-075K1L
R3, R4: 22; Resistor_SMD_R_0402_1005Metric; MPN RC0402FR-0722RL
R70: 464k; Resistor_SMD_R_0603_1608Metric; MPN RT0603BRD07464KL
R71: 100k; Resistor_SMD_R_0603_1608Metric; MPN RT0603BRD07100KL
R72: 60.4k; Resistor_SMD_R_0603_1608Metric; MPN RC0603FR-0760K4L
R73: 47k; Resistor_SMD_R_0603_1608Metric; MPN RC0603FR-0747KL
R74: 100k; Resistor_SMD_R_0603_1608Metric; MPN RC0603FR-07100KL
U2: TPD2E2U06QDCKRQ1; Package_TO_SOT_SMD_SOT-323_SC-70; MPN TPD2E2U06QDCKRQ1
U3: TPS2553DBVR; Package_TO_SOT_SMD_SOT-23-6; MPN TPS2553DBVR
U4: TLV62569DBVR; Package_TO_SOT_SMD_SOT-23-5; MPN TLV62569DBVR

Connections:
3V3: C5.1, L1.2 (OUT), R70.1, R73.1; also elsewhere on the board
BUCK_EN: C42.1, R74.2, U4.1 (EN)
BUCK_FB: R70.2, R71.1, U4.5 (FB); also elsewhere on the board
BUCK_SW: L1.1 (SW), U4.3 (SW)
CC1: D20.1 (IO), J1.A5 (CC1), R1.1
CC2: D21.1 (IO), J1.B5 (CC2), R2.1
ESP_USB_N: R4.2; also elsewhere on the board
ESP_USB_P: R3.2; also elsewhere on the board
GND: C1.2, C2.2, C4.2, C5.2, C40.2, C42.2, D20.2 (GND), D21.2 (GND), D22.2 (GND), J1.A1 (GND), J1.A12 (GND), J1.B1 (GND), J1.B12 (GND), J1.SH (SHIELD), R1.2, R2.2, R71.2, R72.2, U2.3 (GND), U3.2 (GND), U4.2 (GND); also elsewhere on the board
USB_ILIM: R72.1, U3.5 (ILIM)
USB_N: J1.A7 (D-), J1.B7 (D-), R4.1, U2.2 (IO2)
USB_P: J1.A6 (D+), J1.B6 (D+), R3.1, U2.1 (IO1)
USB_PWR_FAULT_N: R73.2, U3.4 (FAULT_N); also elsewhere on the board
V5: C4.1, C40.1, R74.1, U3.6 (OUT), U4.4 (VIN)
V5_PRE: C2.1, D1.1, U3.1 (IN), U3.3 (EN)
VBUS: C1.1, D1.2, D22.1 (IO), J1.A4 (VBUS), J1.A9 (VBUS), J1.B4 (VBUS), J1.B9 (VBUS)

Notes on the sheet:
01 USB Power
Core USB device powered by host hub; separate from OrangePi5V source. RF disabled; encoder supply only after enumeration. Verify USB budget.
USB-C, CC and ESD
Host reverse blocking and current limit
3.3 V buck / enable / feedback
3.384 V nominal: 0.6 V x (1 + 464k / 100k).
Keep SW loop small; feedback away from SW. Local GND vias.
USB series resistors, at MCU

Schematic: 02_Controller.kicad_sch, MOSS Core V0.7 / hardware rearm / 02_Controller

Parts:
C6: 10uF; Capacitor_SMD_C_0805_2012Metric; MPN GRM21BR71A106KA73L
C7, C41: 100nF; Capacitor_SMD_C_0603_1608Metric; MPN GRM188R71C104KA01D
D2: GREEN; LED_SMD_LED_0603_1608Metric; MPN LTST-C190KGKT
H1: M2.5 GND bond / drill2.7; MOSS_Mount_M2p5_GND_D8; MPN PCB_FEATURE
H2, H3, H4: M2.5 / drill 2.7 / keepout D8; MOSS_Mount_M2p5_2p7_D8; MPN NPTH
H5, H6, H7, H8: Orange Pi M2.5 / D6; MOSS_Mount_M2p5_2p7_D6; MPN NPTH
R5, R6: 10k; Resistor_SMD_R_0603_1608Metric; MPN RC0603FR-0710KL
R7: 1k; Resistor_SMD_R_0603_1608Metric; MPN RC0603FR-071KL
R8, R9: 4.7k; Resistor_SMD_R_0603_1608Metric; MPN RC0603FR-074K7L
SW1: RESET_N; Button_Switch_SMD_SW_Push_1P1T_NO_CK_KMR2; MPN KMR221NGLFS
SW2: BOOT_N; Button_Switch_SMD_SW_Push_1P1T_NO_CK_KMR2; MPN KMR221NGLFS
TP1: GND; TestPoint_TestPoint_Pad_D1.0mm; MPN PCB test pad
TP2: 3V3; TestPoint_TestPoint_Pad_D1.0mm; MPN PCB test pad
TP3: TX0; TestPoint_TestPoint_Pad_D1.0mm; MPN PCB test pad
TP5: SDA; TestPoint_TestPoint_Pad_D1.0mm; MPN PCB test pad
TP6: SCL; TestPoint_TestPoint_Pad_D1.0mm; MPN PCB test pad
TP7: RESET; TestPoint_TestPoint_Pad_D1.0mm; MPN PCB test pad
U1: ESP32-S3-WROOM-1U-N8; RF_Module_ESP32-S3-WROOM-1U; MPN ESP32-S3-WROOM-1U-N8
U20: TPS3808G33DBVR; Package_TO_SOT_SMD_SOT-23-6; MPN TPS3808G33DBVR

Connections:
3V3: C6.1, C7.1, C41.1, R5.1, R6.1, R8.1, R9.1, TP2.1, U1.2 (3V3), U20.5 (SENSE), U20.6 (VDD); also elsewhere on the board
ACT_POWER_ENABLE: U1.31 (IO38); also elsewhere on the board
ARM_COMMIT: U1.39 (IO1); also elsewhere on the board
ARM_LATCHED: U1.38 (IO2); also elsewhere on the board
AUDIO_BCLK: U1.18 (IO10); also elsewhere on the board
AUDIO_DATA: U1.20 (IO12); also elsewhere on the board
AUDIO_ENABLE: U1.21 (IO13); also elsewhere on the board
AUDIO_LRCLK: U1.19 (IO11); also elsewhere on the board
BOOT_N: R6.2, SW2.1 (A), U1.27 (IO0)
DEBUG_TX: TP3.1, U1.37 (IO43)
DIR_L: U1.10 (IO17); also elsewhere on the board
DIR_R: U1.12 (IO8); also elsewhere on the board
DRIVE_ENABLE: U1.23 (IO21); also elsewhere on the board
DRIVE_RUN: U1.36 (IO44); also elsewhere on the board
ENC_L_A: U1.7 (IO7); also elsewhere on the board
ENC_L_B: U1.6 (IO6); also elsewhere on the board
ENC_POWER_EN: U1.35 (IO42); also elsewhere on the board
ENC_R_A: U1.5 (IO5); also elsewhere on the board
ENC_R_B: U1.9 (IO16); also elsewhere on the board
ESP_USB_N: U1.13 (IO19); also elsewhere on the board
ESP_USB_P: U1.14 (IO20); also elsewhere on the board
ESTOP_ACTIVE: U1.4 (IO4); also elsewhere on the board
GND: C6.2, C7.2, C41.2, D2.1 (K), H1.1 (GND), SW1.2 (B), SW2.2 (B), TP1.1, U1.1 (GND), U1.40 (GND), U1.41 (GND), U20.2 (GND); also elsewhere on the board
I2C_SCL: R9.2, TP6.1, U1.33 (IO40); also elsewhere on the board
I2C_SDA: R8.2, TP5.1, U1.34 (IO41); also elsewhere on the board
LED_A: D2.2 (A), R7.2
PWM_L: U1.11 (IO18); also elsewhere on the board
PWM_R: U1.17 (IO9); also elsewhere on the board
RESET_N: R5.2, SW1.1 (A), TP7.1, U1.3 (EN), U20.1 (RESET_N); also elsewhere on the board
SERVO_RX: U1.30 (IO37); also elsewhere on the board
SERVO_TX: U1.28 (IO35); also elsewhere on the board
SERVO_TX_ENABLE: U1.29 (IO36); also elsewhere on the board
STATUS_LED: R7.1, U1.8 (IO15)
USB_PWR_FAULT_N: U1.22 (IO14); also elsewhere on the board
WD_ENABLE: U1.24 (IO47); also elsewhere on the board
WD_RESET_N: U20.3 (MR_N); also elsewhere on the board
WD_TICK: U1.25 (IO48); also elsewhere on the board

Notes on the sheet:
MOSS CORE V0.7 / ASYNC FAULT CLEAR + EXPLICIT REARM / 1 NOVEMBER 2026
GPIO1 ARM_COMMIT is a dedicated post-qualification pulse. GPIO2 reads ARM_LATCHED. Initial ACT_POWER_ENABLE remains independent of ACT_READY.
