metrox-eth/moss/hardware/electronics/moss-core-v0.7/electrical/MOSS_Core_V07_Prototype.kicad_pcb

## KiCad design hardware/electronics/moss-core-v0.7/electrical/MOSS_Core_V07_Prototype.kicad_pcb (continued)

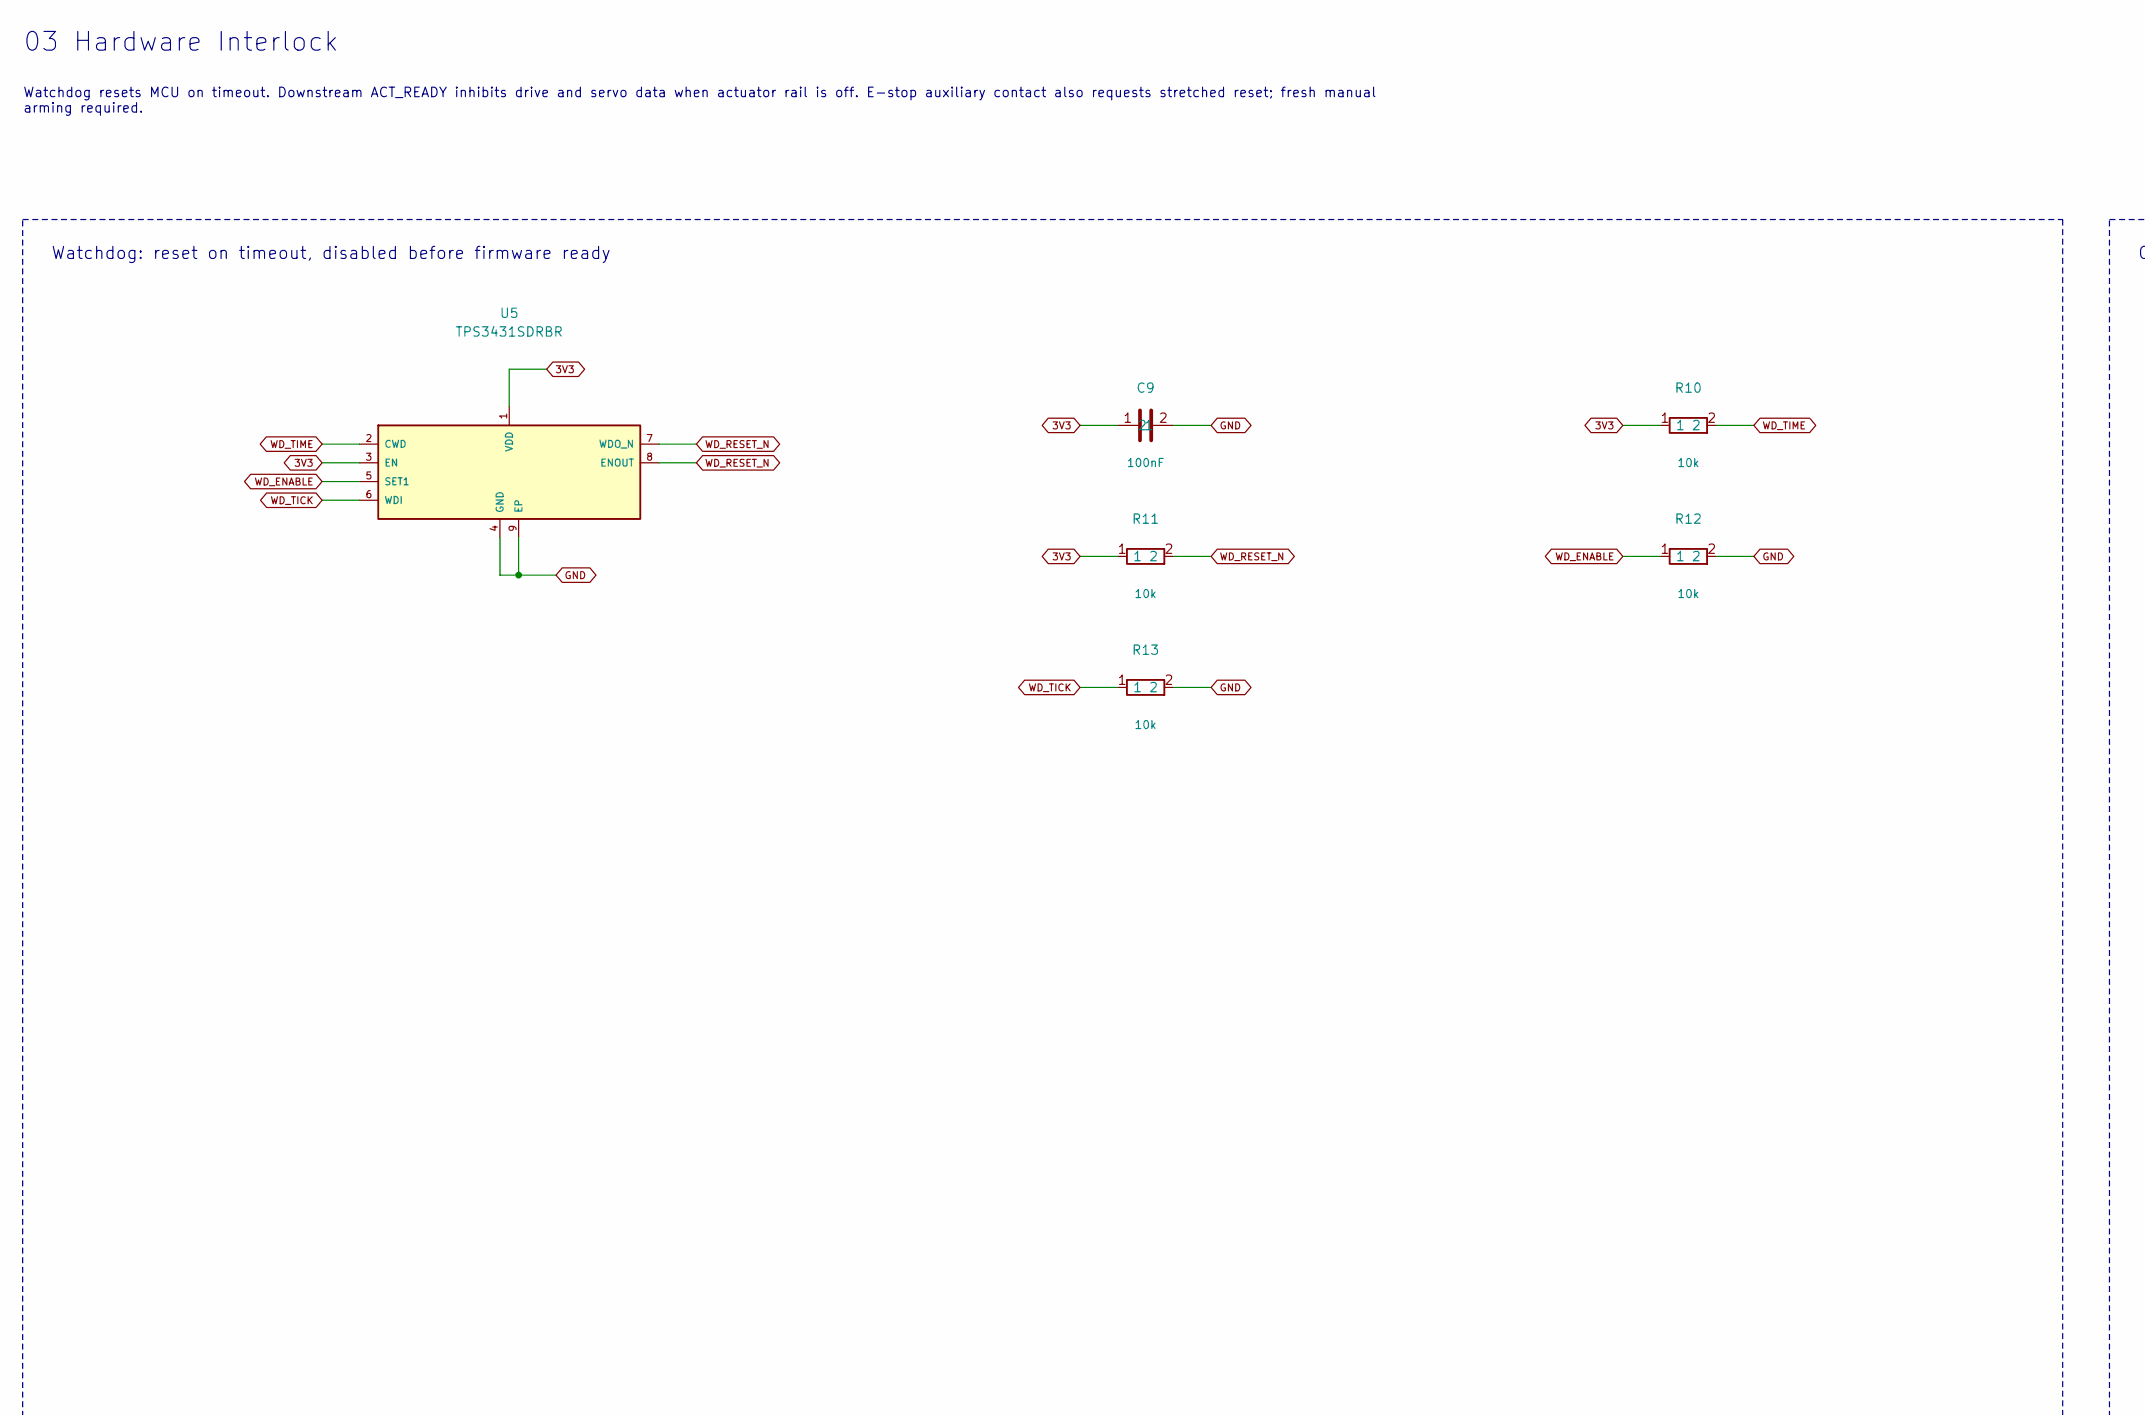
[picture p183: schematic 03_Hardware_Interlock.kicad_sch, MOSS Core V0.7 PROTOTYPE / 03 Hardware Interlock, part in row 1, column 1]

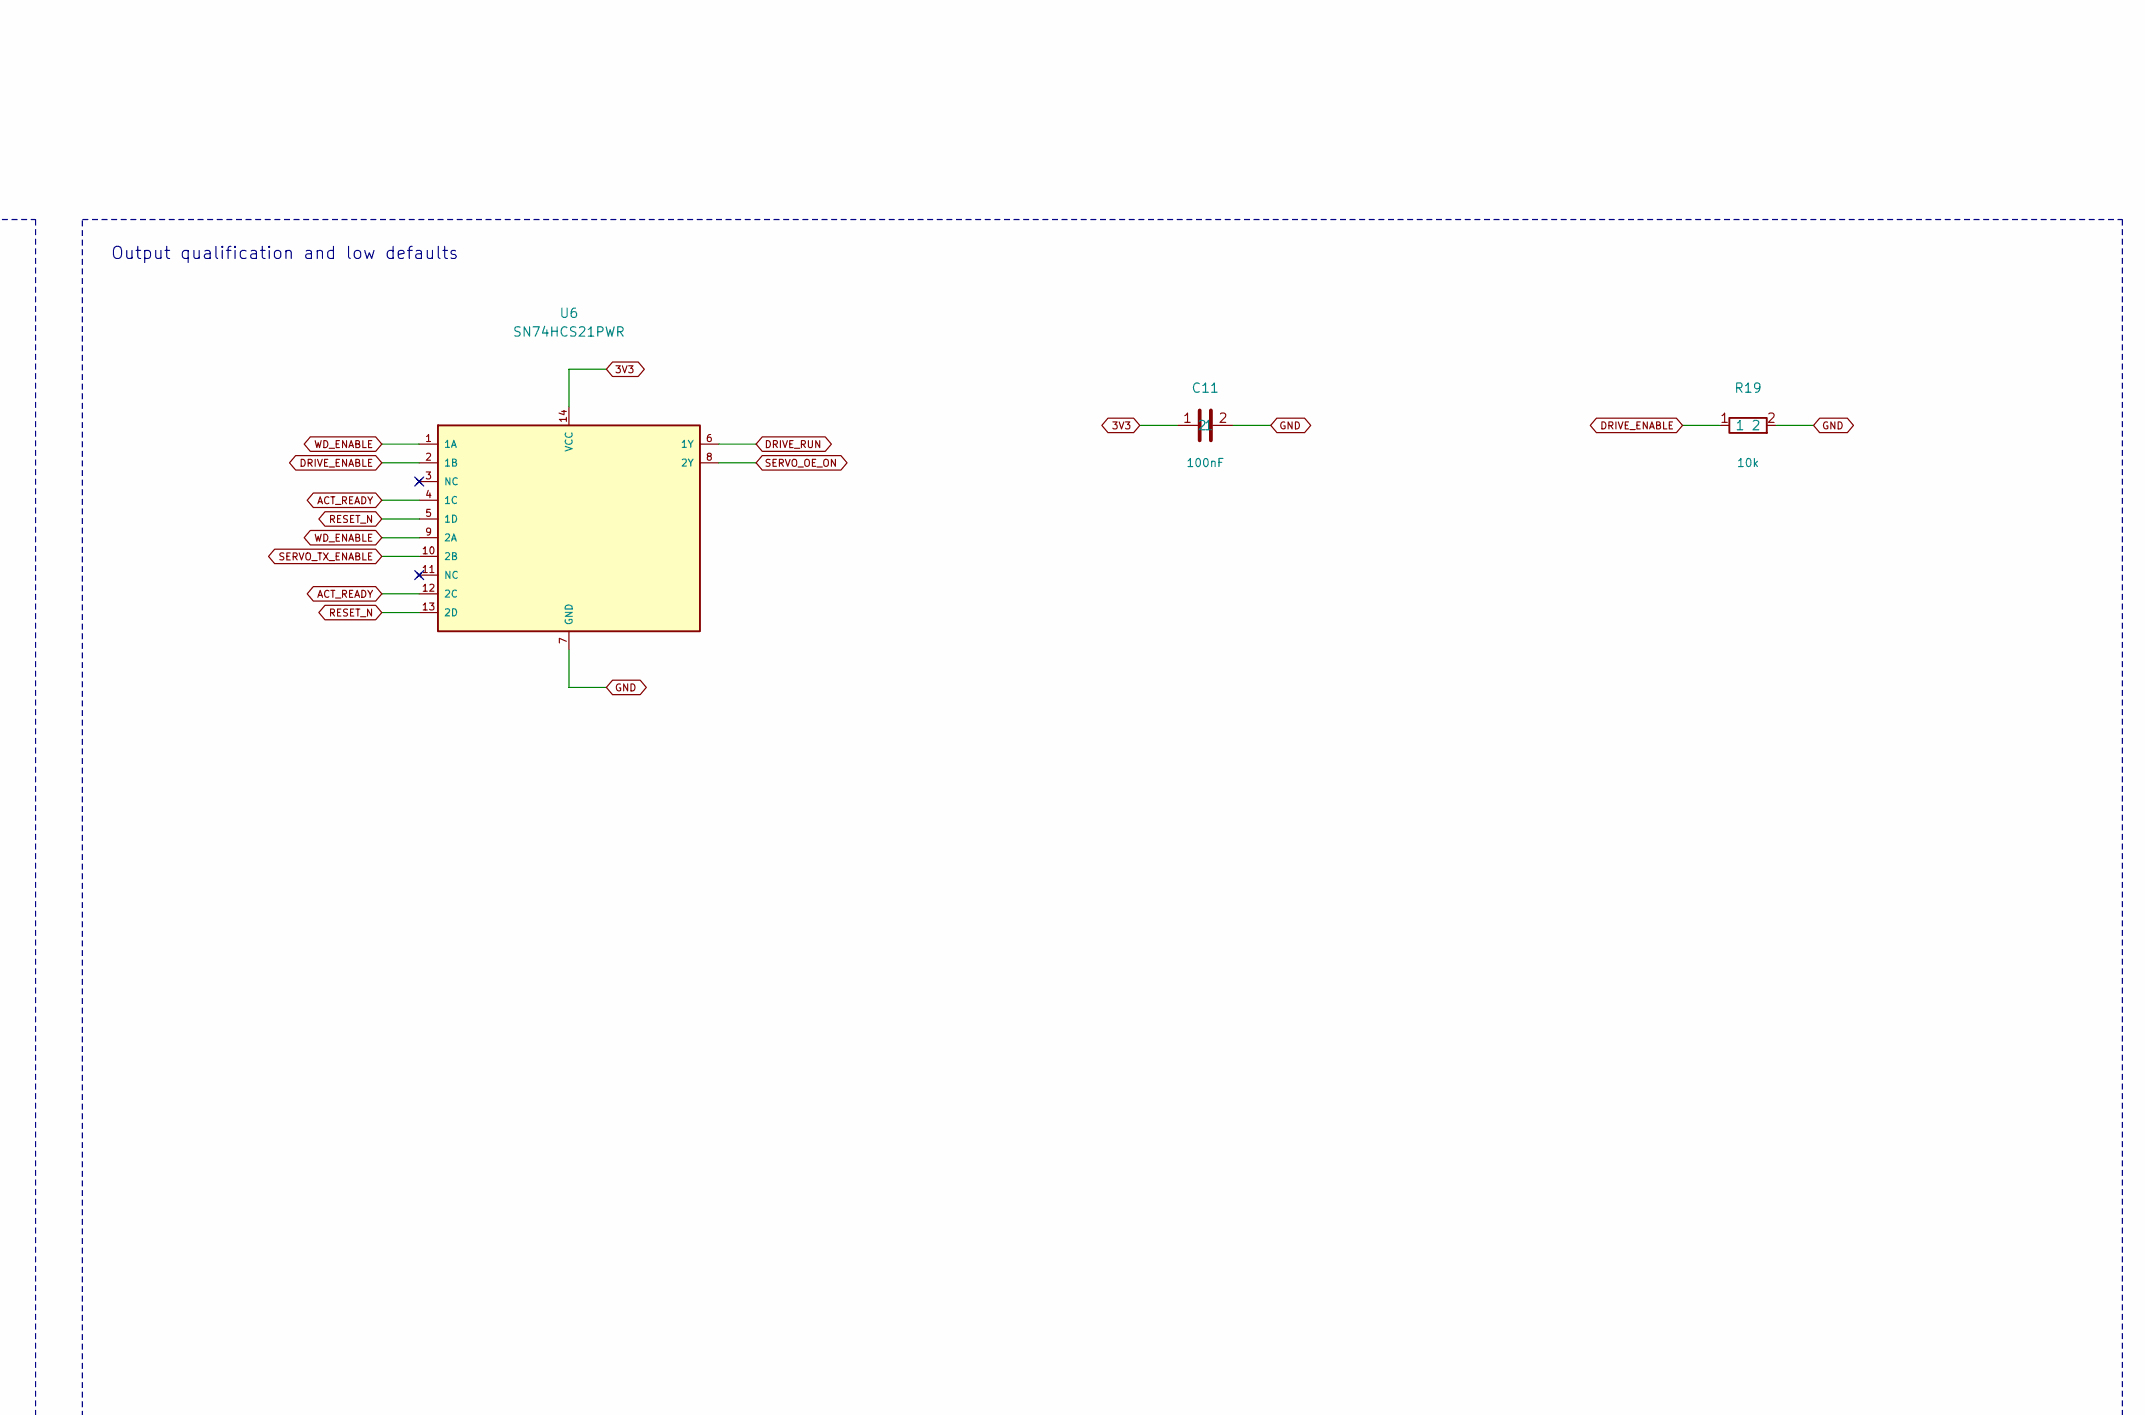
[picture p184: schematic 03_Hardware_Interlock.kicad_sch, MOSS Core V0.7 PROTOTYPE / 03 Hardware Interlock, part in row 1, column 2]

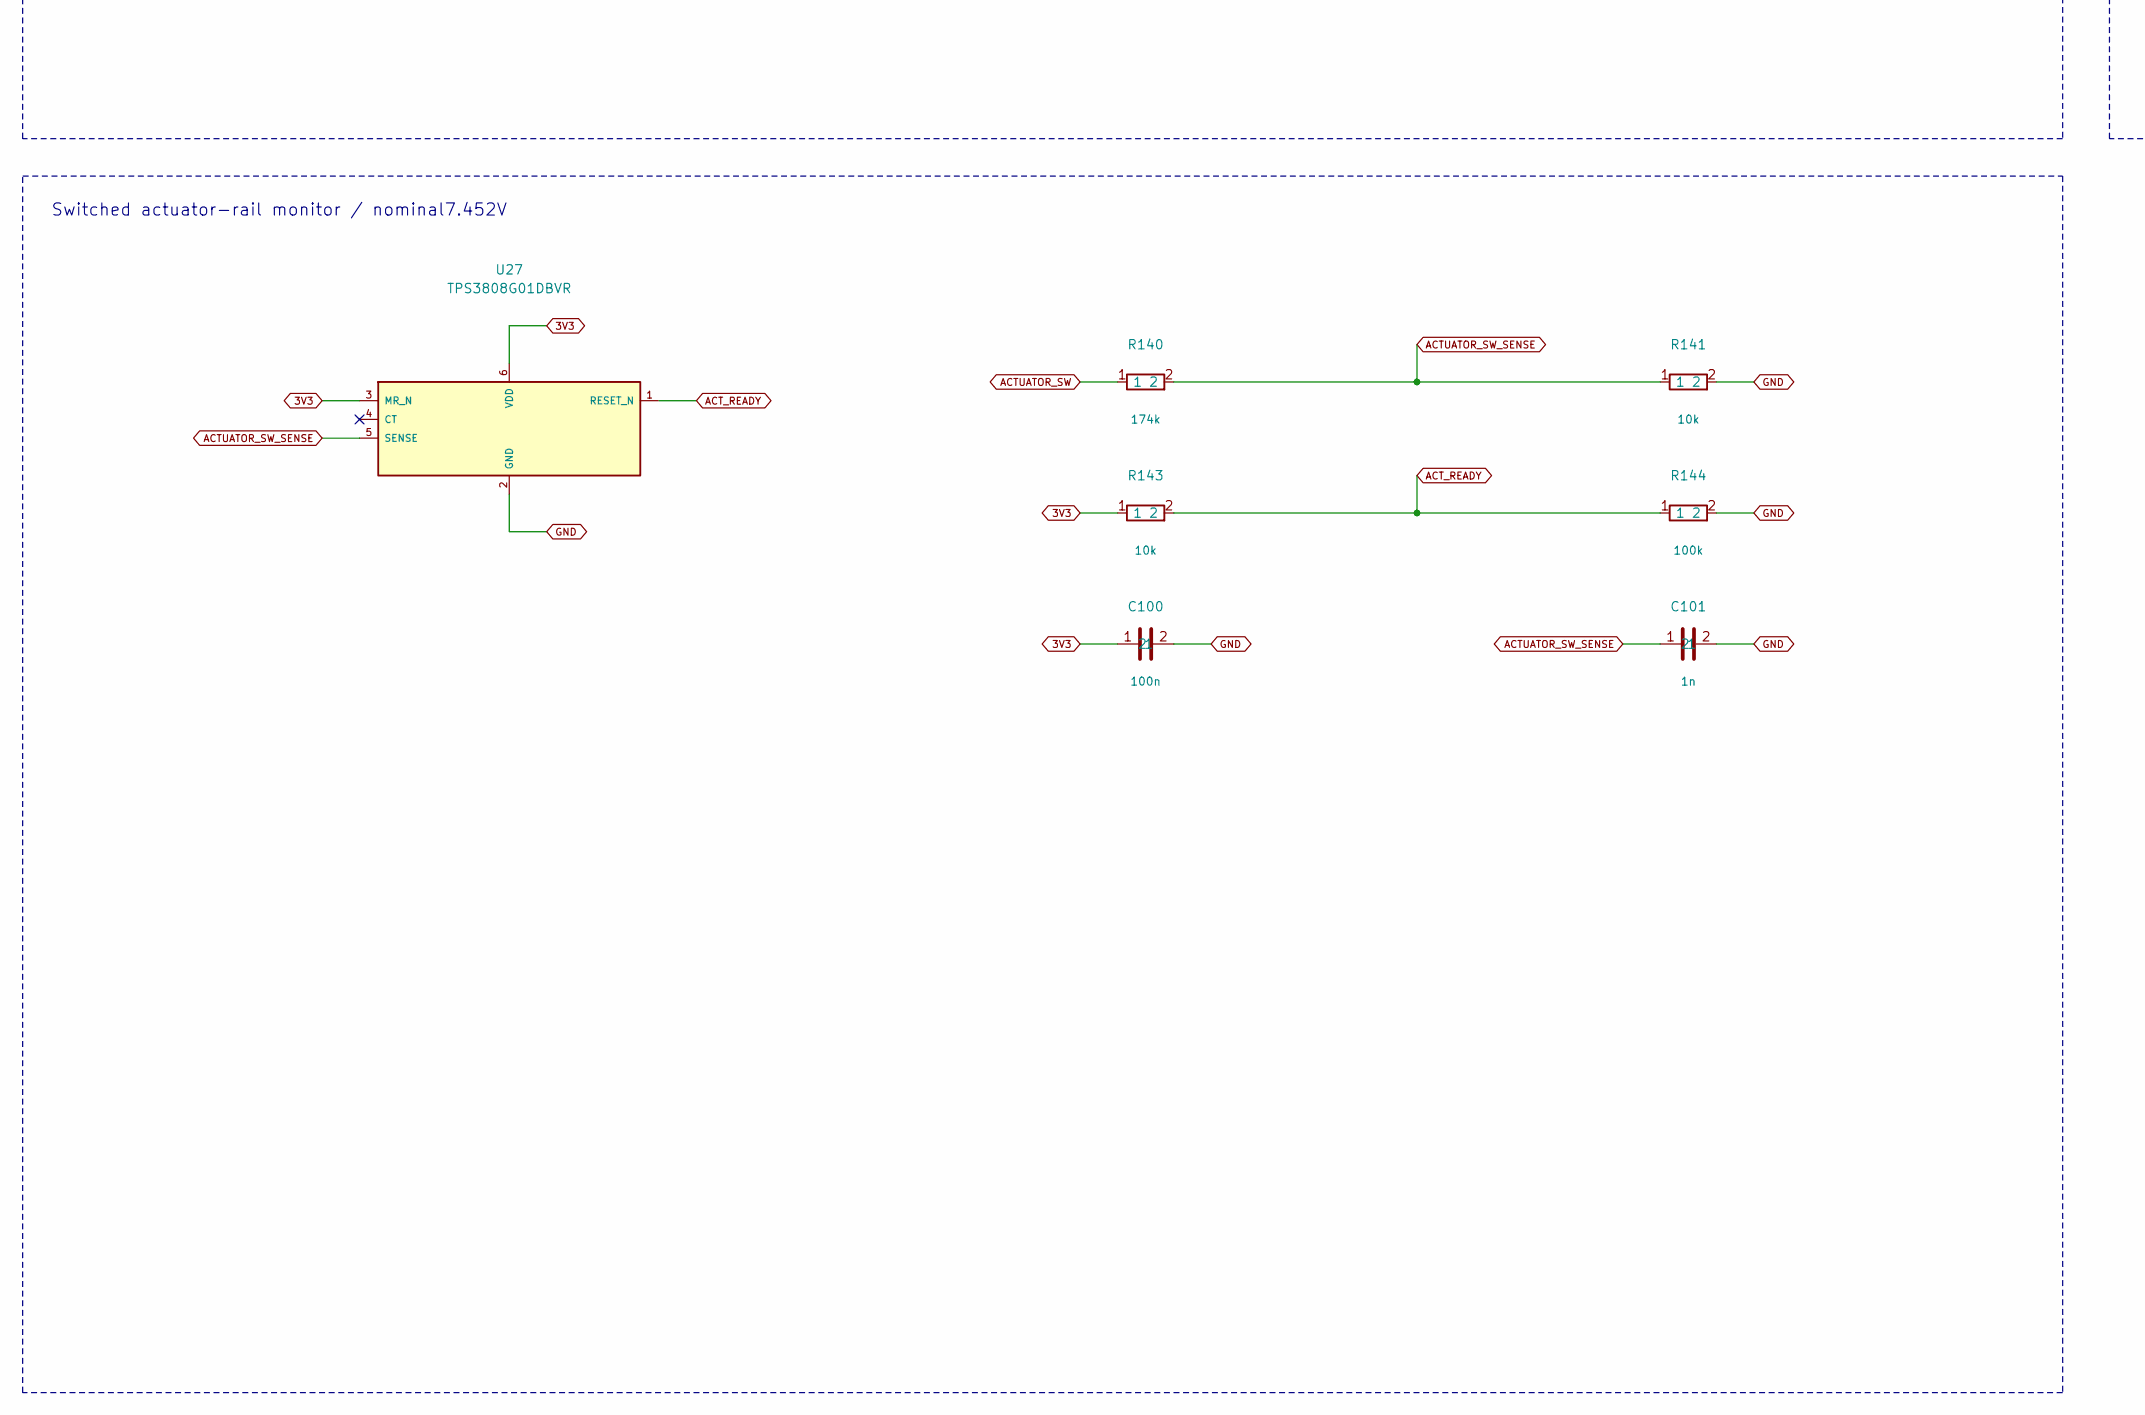
[picture p185: schematic 03_Hardware_Interlock.kicad_sch, MOSS Core V0.7 PROTOTYPE / 03 Hardware Interlock, part in row 2, column 1]

Parts:
C9, C11: 100nF; Capacitor_SMD_C_0603_1608Metric; MPN GRM188R71C104KA01D
C100: 100n; Capacitor_SMD_C_0603_1608Metric; MPN GRM188R71C104KA01D
C101: 1n; Capacitor_SMD_C_0603_1608Metric; MPN GRM1885C1H102JA01D
R10, R11, R12, R13, R19, R143: 10k; Resistor_SMD_R_0603_1608Metric; MPN RC0603FR-0710KL
R140: 174k; Resistor_SMD_R_0603_1608Metric; MPN RT0603BRD07174KL
R141: 10k; Resistor_SMD_R_0603_1608Metric; MPN RT0603BRD0710KL
R144: 100k; Resistor_SMD_R_0603_1608Metric; MPN RC0603FR-07100KL
U5: TPS3431SDRBR; Package_SON_VSON-8-1EP_3x3mm_P0.65mm_EP1.65x2.4mm; MPN TPS3431SDRBR
U6: SN74HCS21PWR; Package_SO_TSSOP-14_4.4x5mm_P0.65mm; MPN SN74HCS21PWR
U27: TPS3808G01DBVR; Package_TO_SOT_SMD_SOT-23-6; MPN TPS3808G01DBVR

Connections:
3V3: C9.1, C11.1, C100.1, R10.1, R11.1, R143.1, U5.1 (VDD), U5.3 (EN), U6.14 (VCC), U27.3 (MR_N), U27.6 (VDD); also elsewhere on the board
ACTUATOR_SW: R140.1; also elsewhere on the board
ACTUATOR_SW_SENSE: C101.1, R140.2, R141.1, U27.5 (SENSE)
DRIVE_ENABLE: R19.1, U6.2 (1B); also elsewhere on the board
DRIVE_RUN: U6.6 (1Y); also elsewhere on the board
GND: C9.2, C11.2, C100.2, C101.2, R12.2, R13.2, R19.2, R141.2, R144.2, U5.4 (GND), U5.9 (EP), U6.7 (GND), U27.2 (GND); also elsewhere on the board
RESET_N: U6.5 (1D), U6.13 (2D); also elsewhere on the board
SERVO_OE_ON: U6.8 (2Y); also elsewhere on the board
SERVO_TX_ENABLE: U6.10 (2B); also elsewhere on the board
WD_ENABLE: R12.1, U5.5 (SET1), U6.1 (1A), U6.9 (2A); also elsewhere on the board
WD_RESET_N: R11.2, U5.7 (WDO_N), U5.8 (ENOUT); also elsewhere on the board
WD_TICK: R13.1, U5.6 (WDI); also elsewhere on the board
WD_TIME: R10.2, U5.2 (CWD)

Notes on the sheet:
03 Hardware Interlock
Watchdog resets MCU on timeout. Downstream ACT_READY inhibits drive and servo data when actuator rail is off. E-stop auxiliary contact also requests stretched reset; fresh manual arming required.
Watchdog: reset on timeout, disabled before firmware ready
Output qualification and low defaults
Switched actuator-rail monitor / nominal7.452V

Schematic: 04_Drive_Encoders.kicad_sch, MOSS Core V0.7 PROTOTYPE / 04_Drive_Encoders

Parts:
C18, C23: 100nF; Capacitor_SMD_C_0603_1608Metric; MPN GRM188R71C104KA01D
C19, C20, C21, C22: 100pF; Capacitor_SMD_C_0603_1608Metric; MPN GRM1885C1H101JA01D
C43, C44: 1uF; Capacitor_SMD_C_0603_1608Metric; MPN GRM188R61A105KA61D
C45: 10nF; Capacitor_SMD_C_0603_1608Metric; MPN GRM188R71H103KA01D
D6, D7, D8, D9: PESD5V0S1BA; Diode_SMD_D_SOD-323; MPN PESD5V0S1BA,115
J2: CYTRON LINK; Connector_Molex_Molex_Micro-Fit_3.0_43045-1012_2x05_P3.00mm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; MPN 43045-1012
J3: LEFT MOTOR + ENCODER; Connector_Molex_Molex_Micro-Fit_3.0_43045-0612_2x03_P3.00mm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; MPN 43045-0612
J4: RIGHT MOTOR + ENCODER; Connector_Molex_Molex_Micro-Fit_3.0_43045-0612_2x03_P3.00mm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; MPN 43045-0612
R23, R25, R27, R29: 100; Resistor_SMD_R_0603_1608Metric; MPN RC0603FR-07100RL
R24, R26, R28, R30, R36, R38, R40, R42: 10k; Resistor_SMD_R_0603_1608Metric; MPN RC0603FR-0710KL
R31, R32, R33, R34, R75: 47k; Resistor_SMD_R_0603_1608Metric; MPN RC0603FR-0747KL
R35, R37, R39, R41: 1k; Resistor_SMD_R_0603_1608Metric; MPN RC0603FR-071KL
R76, R77, R78, R79: 100k; Resistor_SMD_R_0603_1608Metric; MPN RC0603FR-07100KL
U11: 74LV08APWJ; Package_SO_TSSOP-14_4.4x5mm_P0.65mm; MPN 74LV08APWJ
U12: SN74LVC14APWR; Package_SO_TSSOP-14_4.4x5mm_P0.65mm; MPN SN74LVC14APWR
U22: TPS22918DBVR; Package_TO_SOT_SMD_SOT-23-6; MPN TPS22918DBVR

Connections:
3V3: C18.1, C23.1, C43.1, U11.14 (VCC), U12.14 (VCC), U22.1 (VIN); also elsewhere on the board
CYTRON_L_LEAD: J2.6 (LEFT_A); also elsewhere on the board
CYTRON_R_LEAD: J2.8 (RIGHT_A); also elsewhere on the board
DIR_L: R33.1, U11.9 (3A); also elsewhere on the board
DIR_L_SAFE: R25.1, U11.8 (3Y)
DIR_R: R34.1, U11.12 (4A); also elsewhere on the board
DIR_R_SAFE: R29.1, U11.11 (4Y)
DRIVE_RUN: U11.2 (1B), U11.5 (2B), U11.10 (3B), U11.13 (4B); also elsewhere on the board
EL_A_EXT: D6.1, J3.5 (ENC_A), R35.1
EL_A_F: C19.1, R35.2, R36.2, R76.1, U12.1 (1A)
EL_B_EXT: D7.1, J3.6 (ENC_B), R37.1
EL_B_F: C20.1, R37.2, R38.2, R77.1, U12.3 (2A)
ENC_3V3: C44.1, J3.4 (ENC_3V3), J4.4 (ENC_3V3), R36.1, R38.1, R40.1, R42.1, U22.5 (QOD), U22.6 (VOUT)
ENC_L_A: U12.2 (1Y); also elsewhere on the board
ENC_L_B: U12.4 (2Y); also elsewhere on the board
ENC_POWER_EN: R75.1, U22.3 (ON); also elsewhere on the board
ENC_R_A: U12.6 (3Y); also elsewhere on the board
ENC_R_B: U12.8 (4Y); also elsewhere on the board
ENC_SLEW_CT: C45.1, U22.4 (CT)
ER_A_EXT: D8.1, J4.5 (ENC_A), R39.1
ER_A_F: C21.1, R39.2, R40.2, R78.1, U12.5 (3A)
ER_B_EXT: D9.1, J4.6 (ENC_B), R41.1
ER_B_F: C22.1, R41.2, R42.2, R79.1, U12.9 (4A)
GND: C18.2, C19.2, C20.2, C21.2, C22.2, C23.2, C43.2, C44.2, C45.2, D6.2, D7.2, D8.2, D9.2, J2.5 (SIGNAL_GND), J3.3 (ENC_GND), J4.3 (ENC_GND), R24.2, R26.2, R28.2, R30.2, R31.2, R32.2, R33.2, R34.2, R75.2, R76.2, R77.2, R78.2, R79.2, U11.7 (GND), U12.7 (GND), U12.11 (5A), U12.13 (6A), U22.2 (GND); also elsewhere on the board
MDD_DIR1: J2.2 (DIR1), R25.2, R26.1
MDD_DIR2: J2.4 (DIR2), R29.2, R30.1
MDD_PWM1: J2.1 (PWM1), R23.2, R24.1
MDD_PWM2: J2.3 (PWM2), R27.2, R28.1
MOTOR_L_LEAD: J3.1 (M1); also elsewhere on the board
MOTOR_L_RETURN: J2.7 (LEFT_B), J3.2 (M2)
MOTOR_R_LEAD: J4.1 (M1); also elsewhere on the board
MOTOR_R_RETURN: J2.9 (RIGHT_B), J4.2 (M2)
PWM_L: R31.1, U11.1 (1A); also elsewhere on the board
PWM_L_SAFE: R23.1, U11.3 (1Y)
PWM_R: R32.1, U11.4 (2A); also elsewhere on the board
PWM_R_SAFE: R27.1, U11.6 (2Y)

Notes on the sheet:
MOSS CORE V0.7 / SIMPLIFIED MOTOR HARNESS / 31 OCTOBER 2026
One six-wire cable per motor. J2 to Cytron: four bridge outputs + PWM/DIR controls. Supply separately on J11.

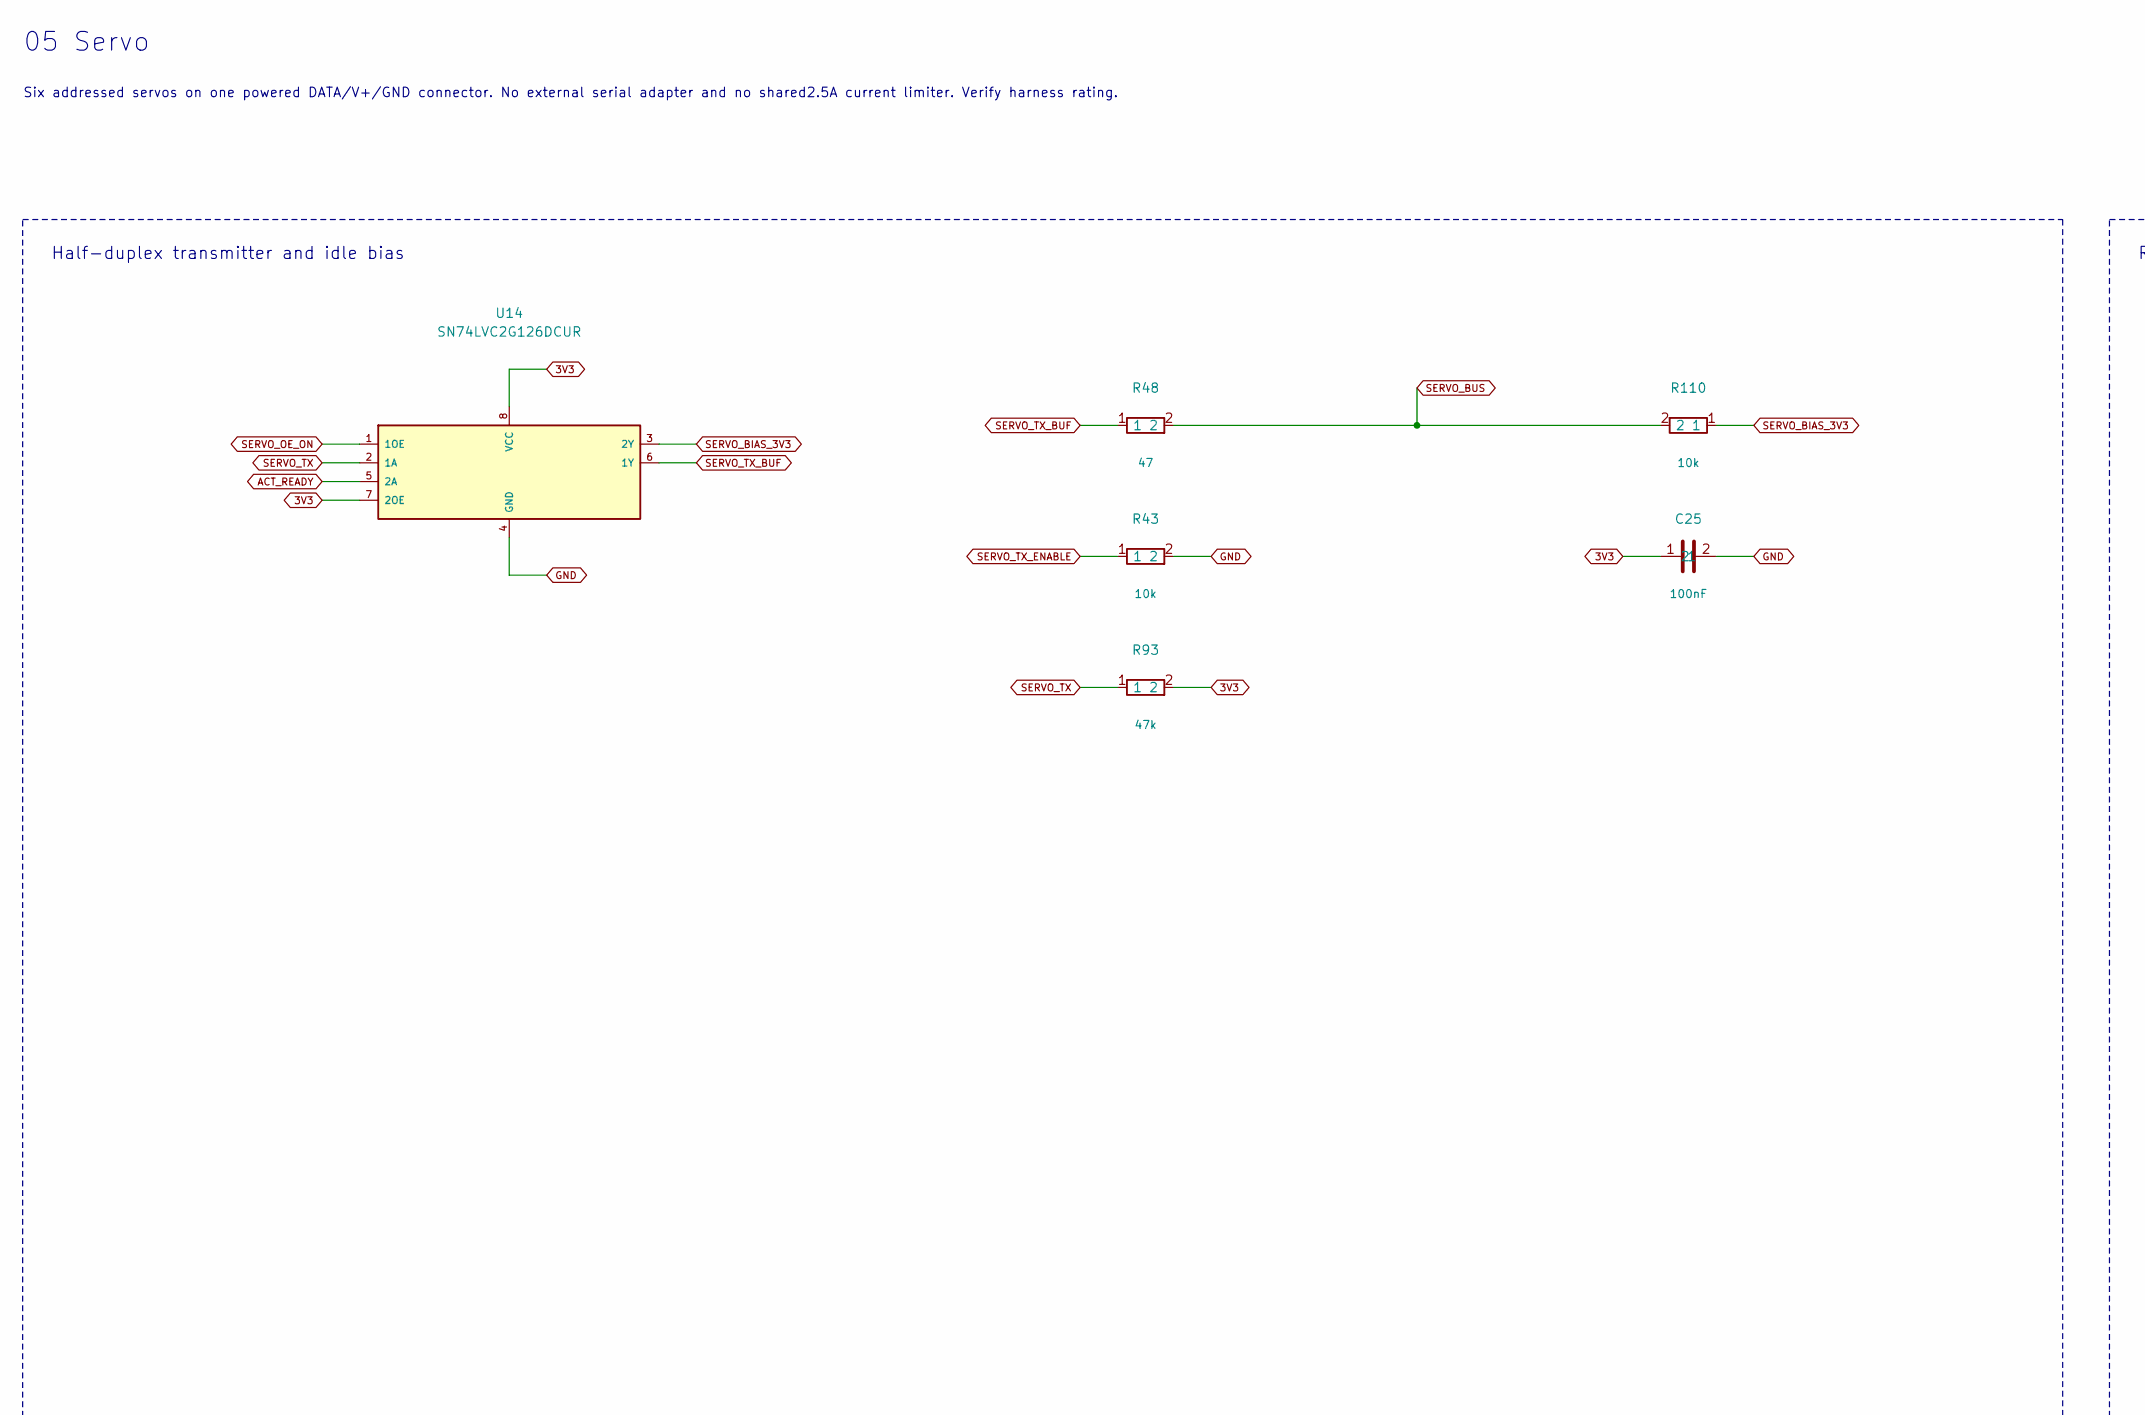
[picture p186: schematic 05_Servo.kicad_sch, MOSS Core V0.7 PROTOTYPE / 05 Servo, part in row 1, column 1]

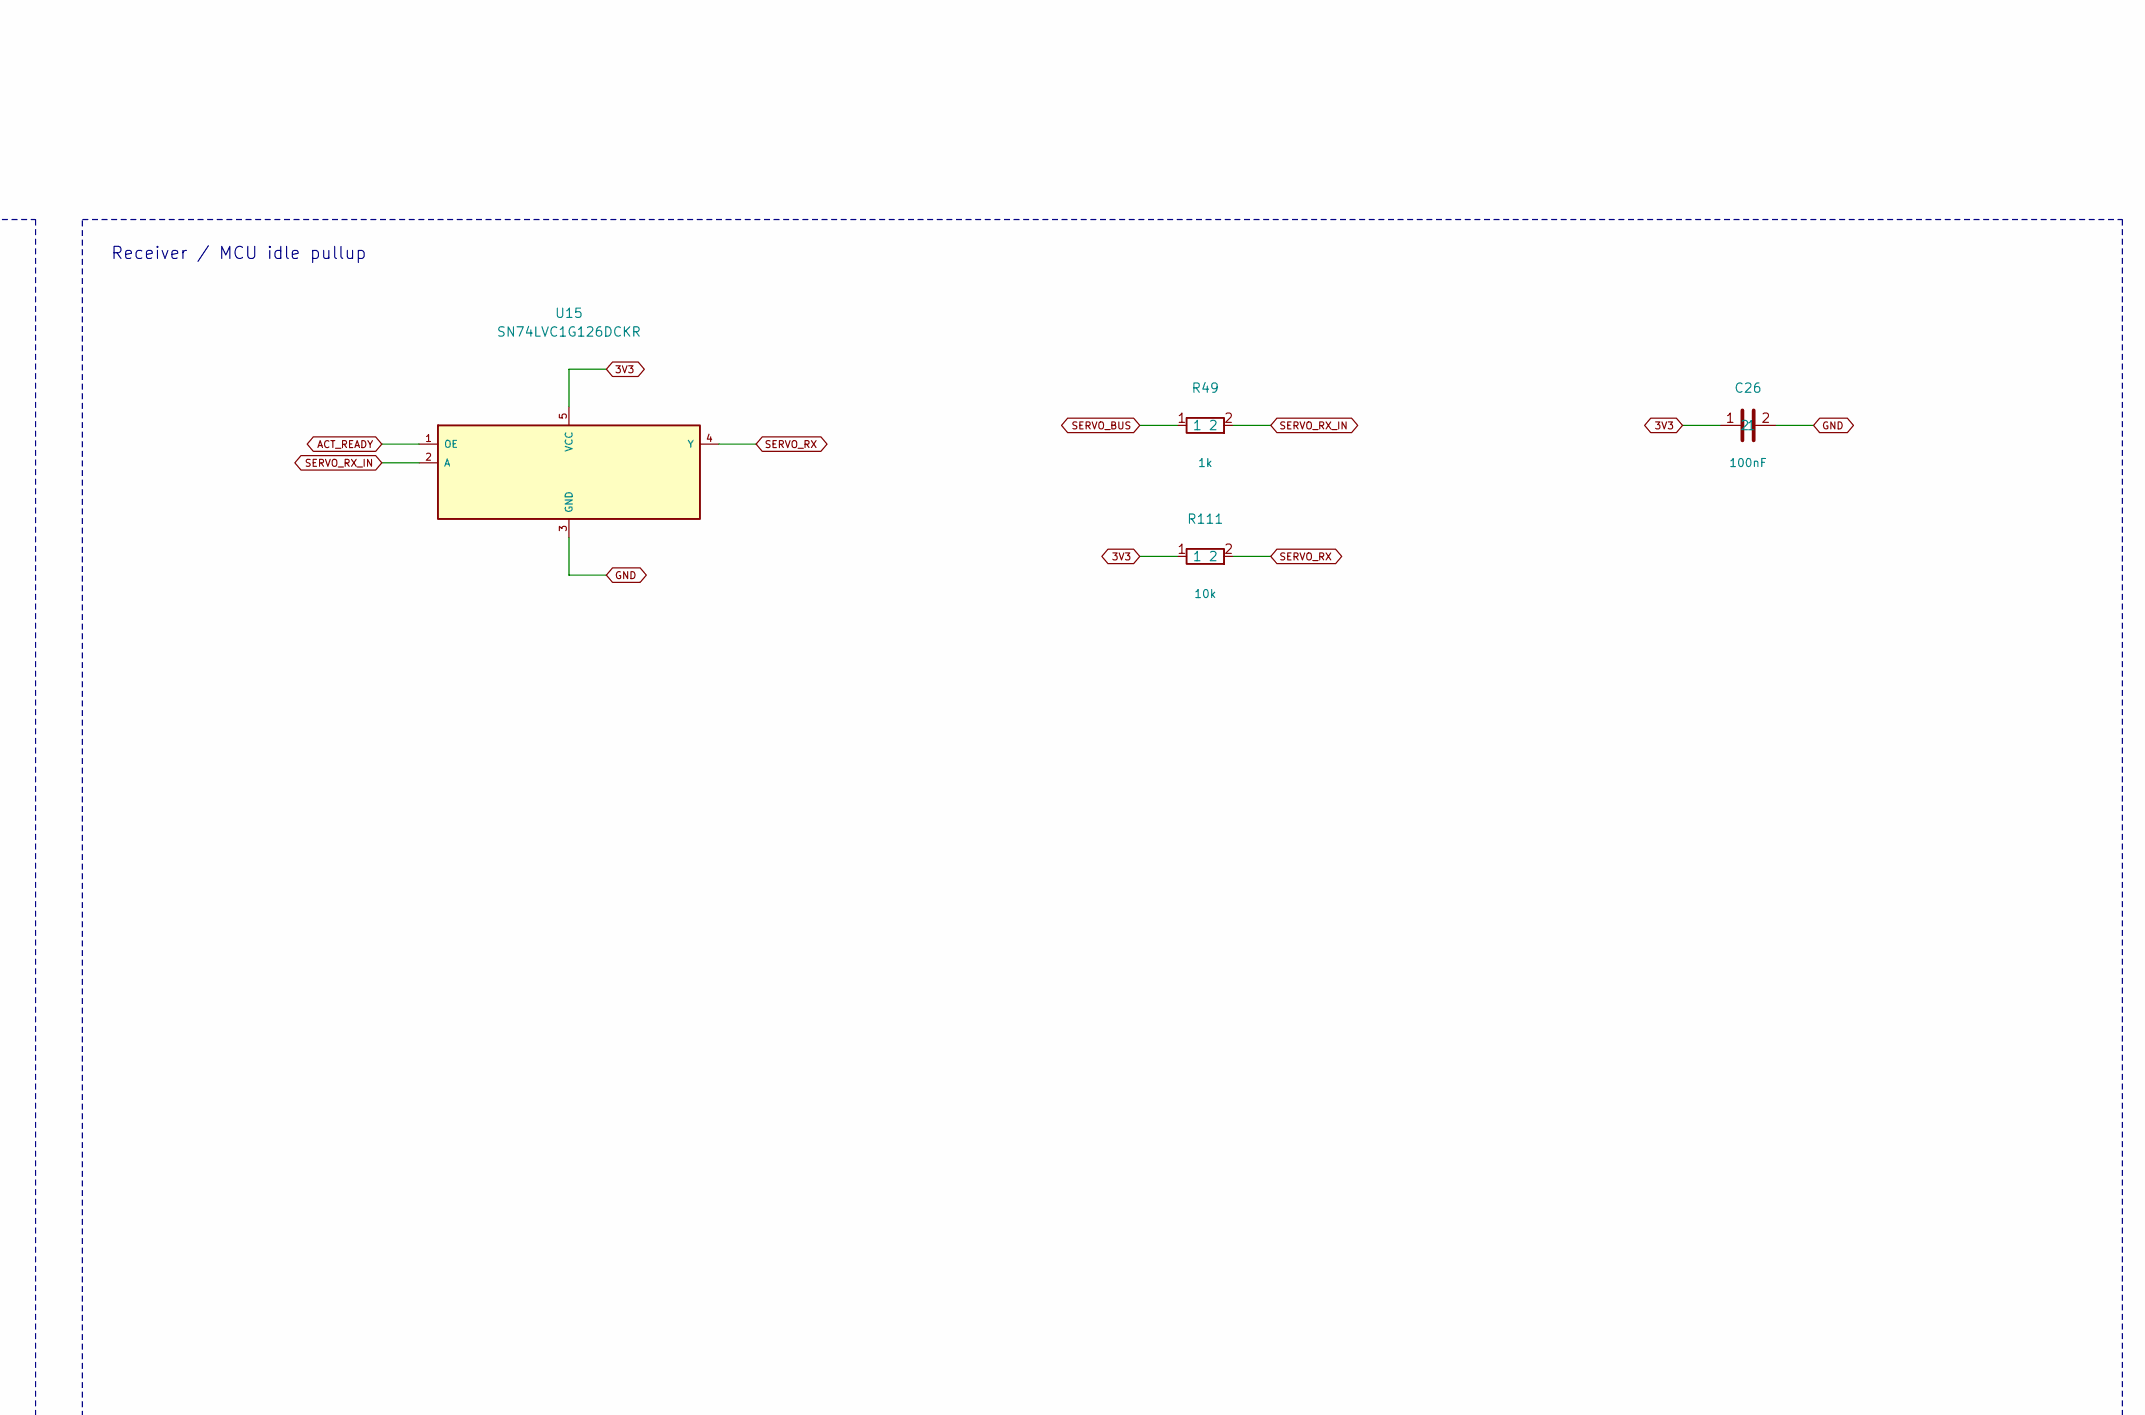
[picture p187: schematic 05_Servo.kicad_sch, MOSS Core V0.7 PROTOTYPE / 05 Servo, part in row 1, column 2]

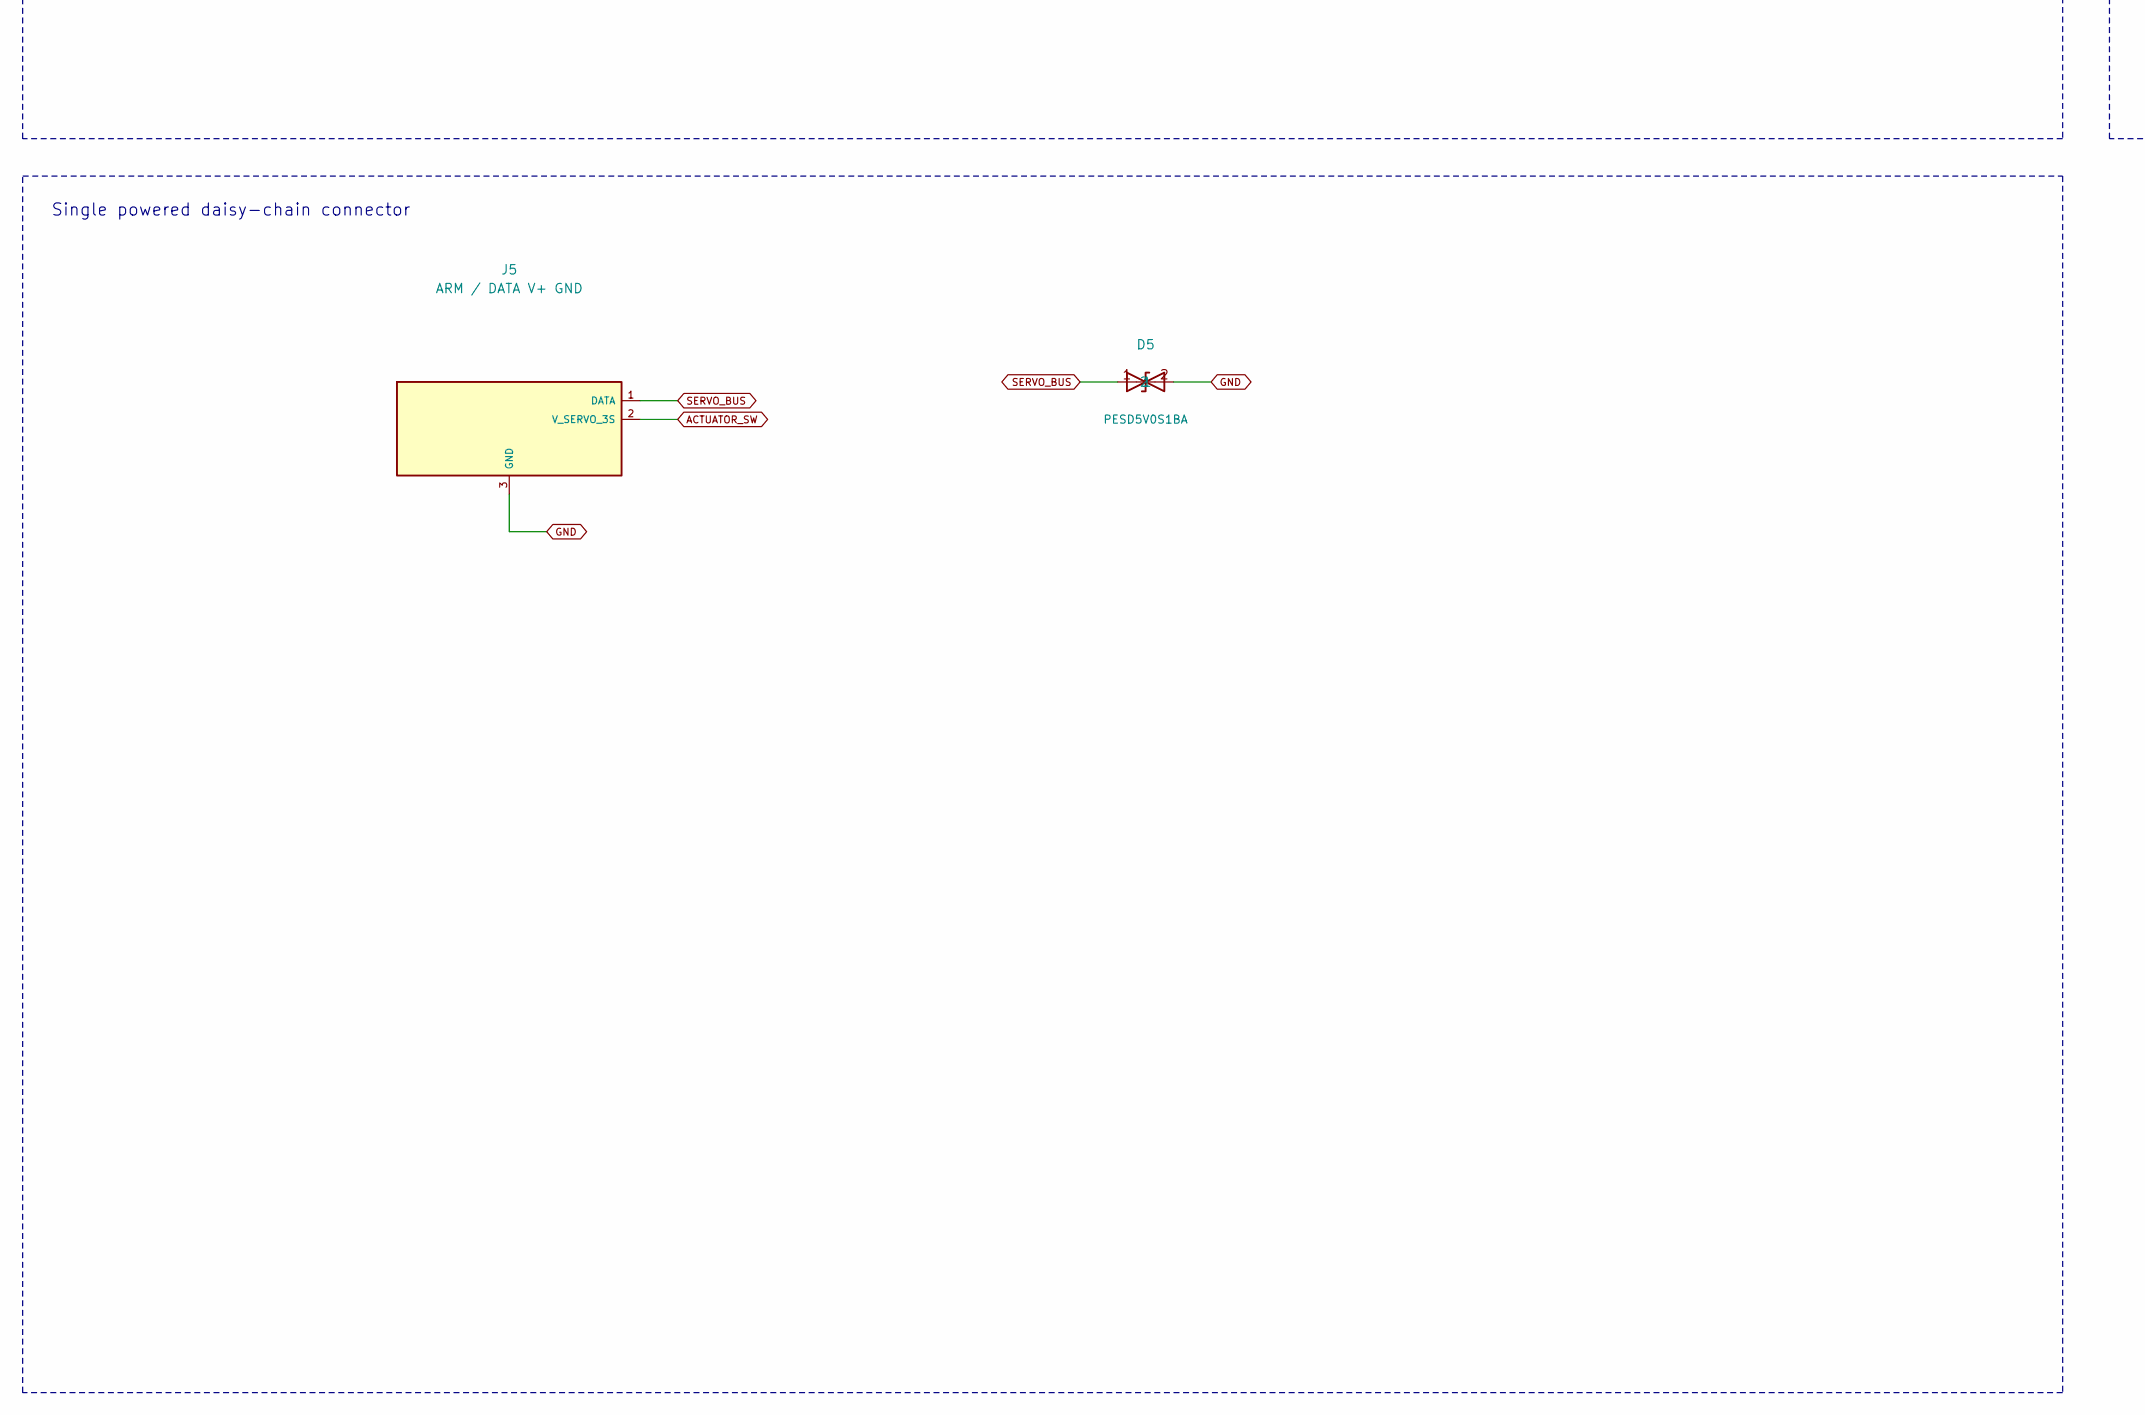
[picture p188: schematic 05_Servo.kicad_sch, MOSS Core V0.7 PROTOTYPE / 05 Servo, part in row 2, column 1]

Parts:
C25, C26: 100nF; Capacitor_SMD_C_0603_1608Metric; MPN GRM188R71C104KA01D
D5: PESD5V0S1BA; Diode_SMD_D_SOD-323; MPN PESD5V0S1BA,115
J5: ARM / DATA V+ GND; Connector_Molex_Molex_SPOX_5267-03A_1x03_P2.50mm_Vertical; MPN 22-03-5035
R43, R110, R111: 10k; Resistor_SMD_R_0603_1608Metric; MPN RC0603FR-0710KL
R48: 47; Resistor_SMD_R_0603_1608Metric; MPN RC0603FR-0747RL
R49: 1k; Resistor_SMD_R_0603_1608Metric; MPN RC0603FR-071KL
R93: 47k; Resistor_SMD_R_0603_1608Metric; MPN RC0603FR-0747KL
U14: SN74LVC2G126DCUR; Package_SO_VSSOP-8_2.3x2mm_P0.5mm; MPN SN74LVC2G126DCUR
U15: SN74LVC1G126DCKR; Package_TO_SOT_SMD_SOT-353_SC-70-5; MPN SN74LVC1G126DCKR

Connections:
3V3: C25.1, C26.1, R93.2, R111.1, U14.7 (2OE), U14.8 (VCC), U15.5 (VCC); also elsewhere on the board
ACTUATOR_SW: J5.2 (V_SERVO_3S); also elsewhere on the board
GND: C25.2, C26.2, D5.2, J5.3 (GND), R43.2, U14.4 (GND), U15.3 (GND); also elsewhere on the board
SERVO_BIAS_3V3: R110.1, U14.3 (2Y)
SERVO_BUS: D5.1, J5.1 (DATA), R48.2, R49.1, R110.2
SERVO_OE_ON: U14.1 (1OE); also elsewhere on the board
SERVO_RX: R111.2, U15.4 (Y); also elsewhere on the board
SERVO_RX_IN: R49.2, U15.2 (A)
SERVO_TX: R93.1, U14.2 (1A); also elsewhere on the board
SERVO_TX_BUF: R48.1, U14.6 (1Y)
SERVO_TX_ENABLE: R43.1; also elsewhere on the board

Notes on the sheet:
05 Servo
Six addressed servos on one powered DATA/V+/GND connector. No external serial adapter and no shared2.5A current limiter. Verify harness rating.
Half-duplex transmitter and idle bias
Receiver / MCU idle pullup
Single powered daisy-chain connector
