metrox-eth/moss/hardware/electronics/moss-core-v0.7/electrical/MOSS_Core_V07_Prototype.kicad_pcb

## KiCad design hardware/electronics/moss-core-v0.7/electrical/MOSS_Core_V07_Prototype.kicad_pcb (continued)

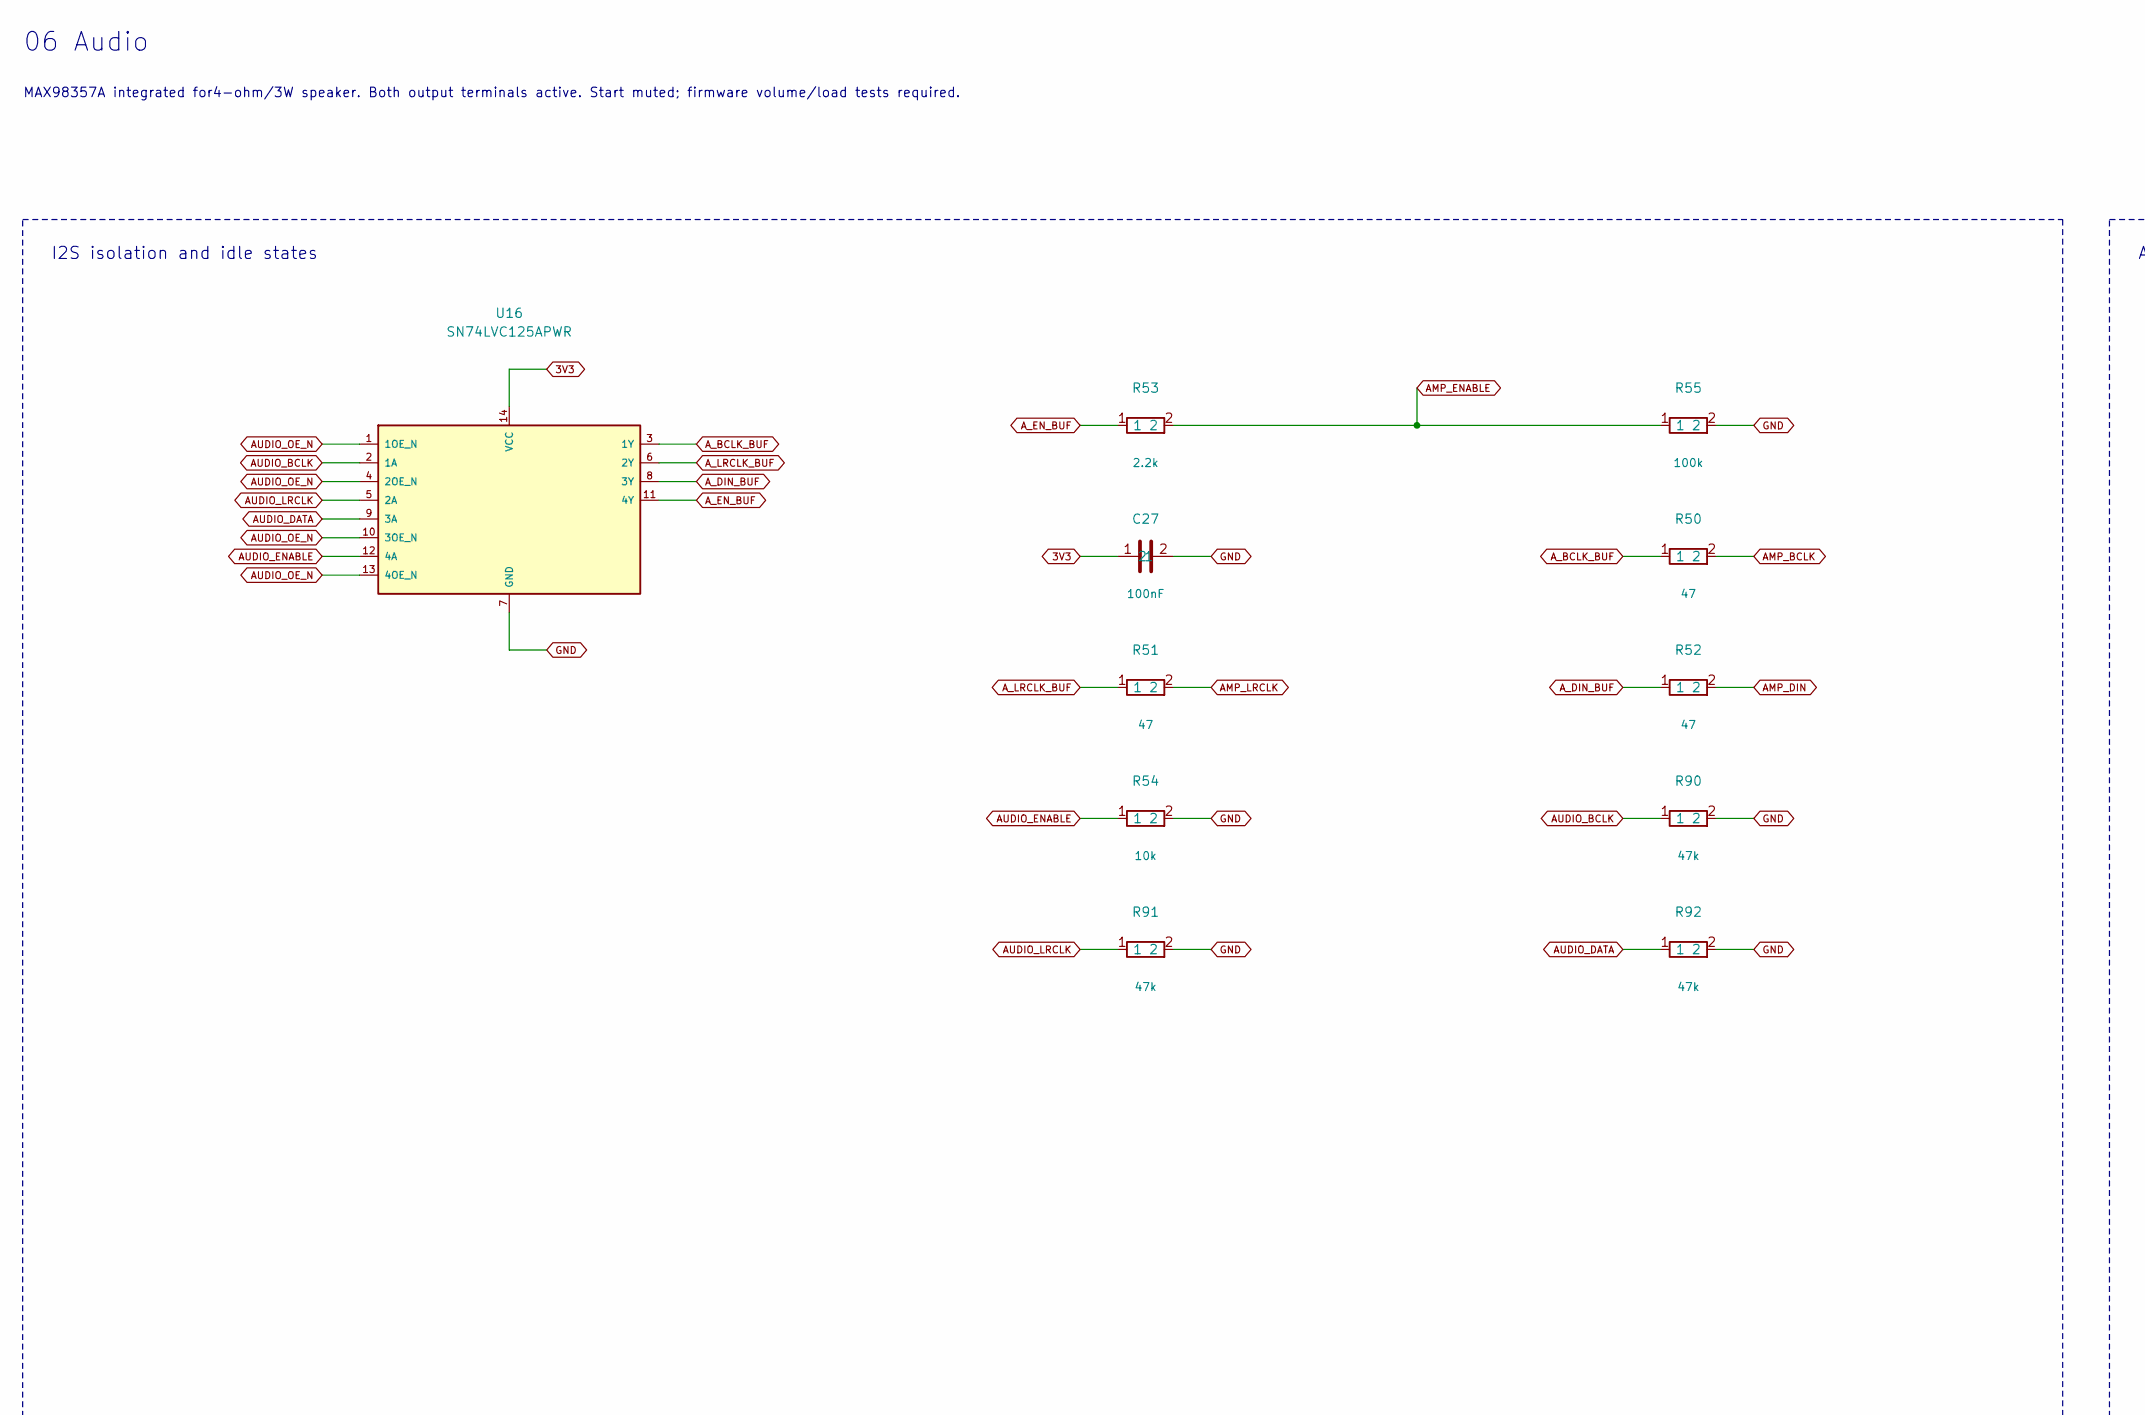
[picture p189: schematic 06_Audio.kicad_sch, MOSS Core V0.7 PROTOTYPE / 06 Audio, part in row 1, column 1]

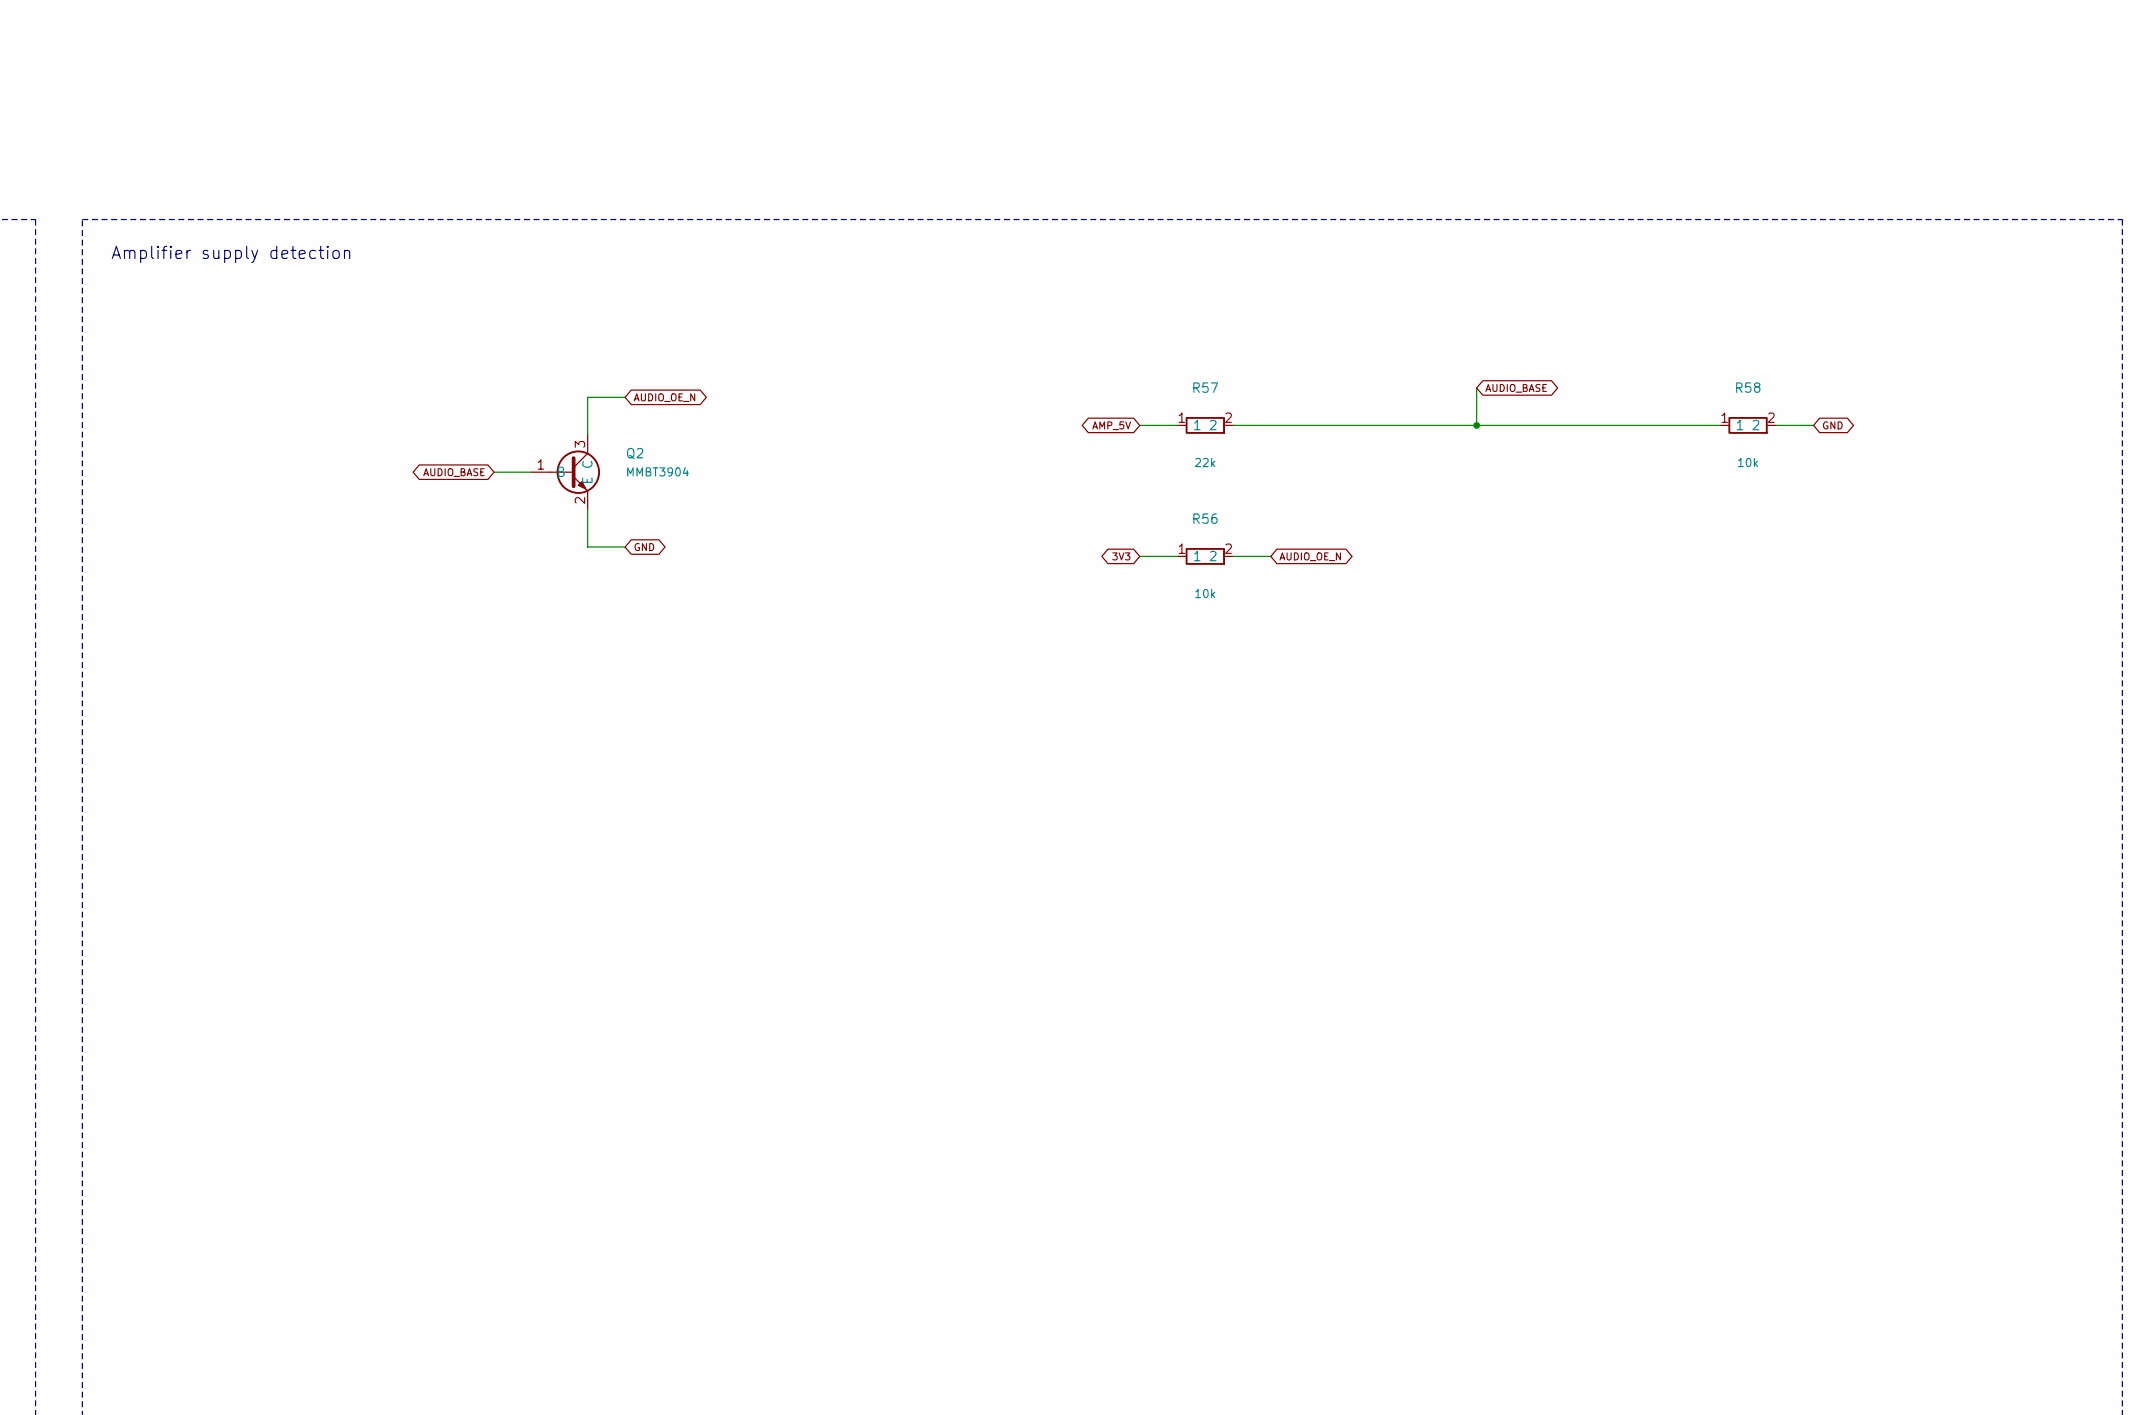
[picture p190: schematic 06_Audio.kicad_sch, MOSS Core V0.7 PROTOTYPE / 06 Audio, part in row 1, column 2]

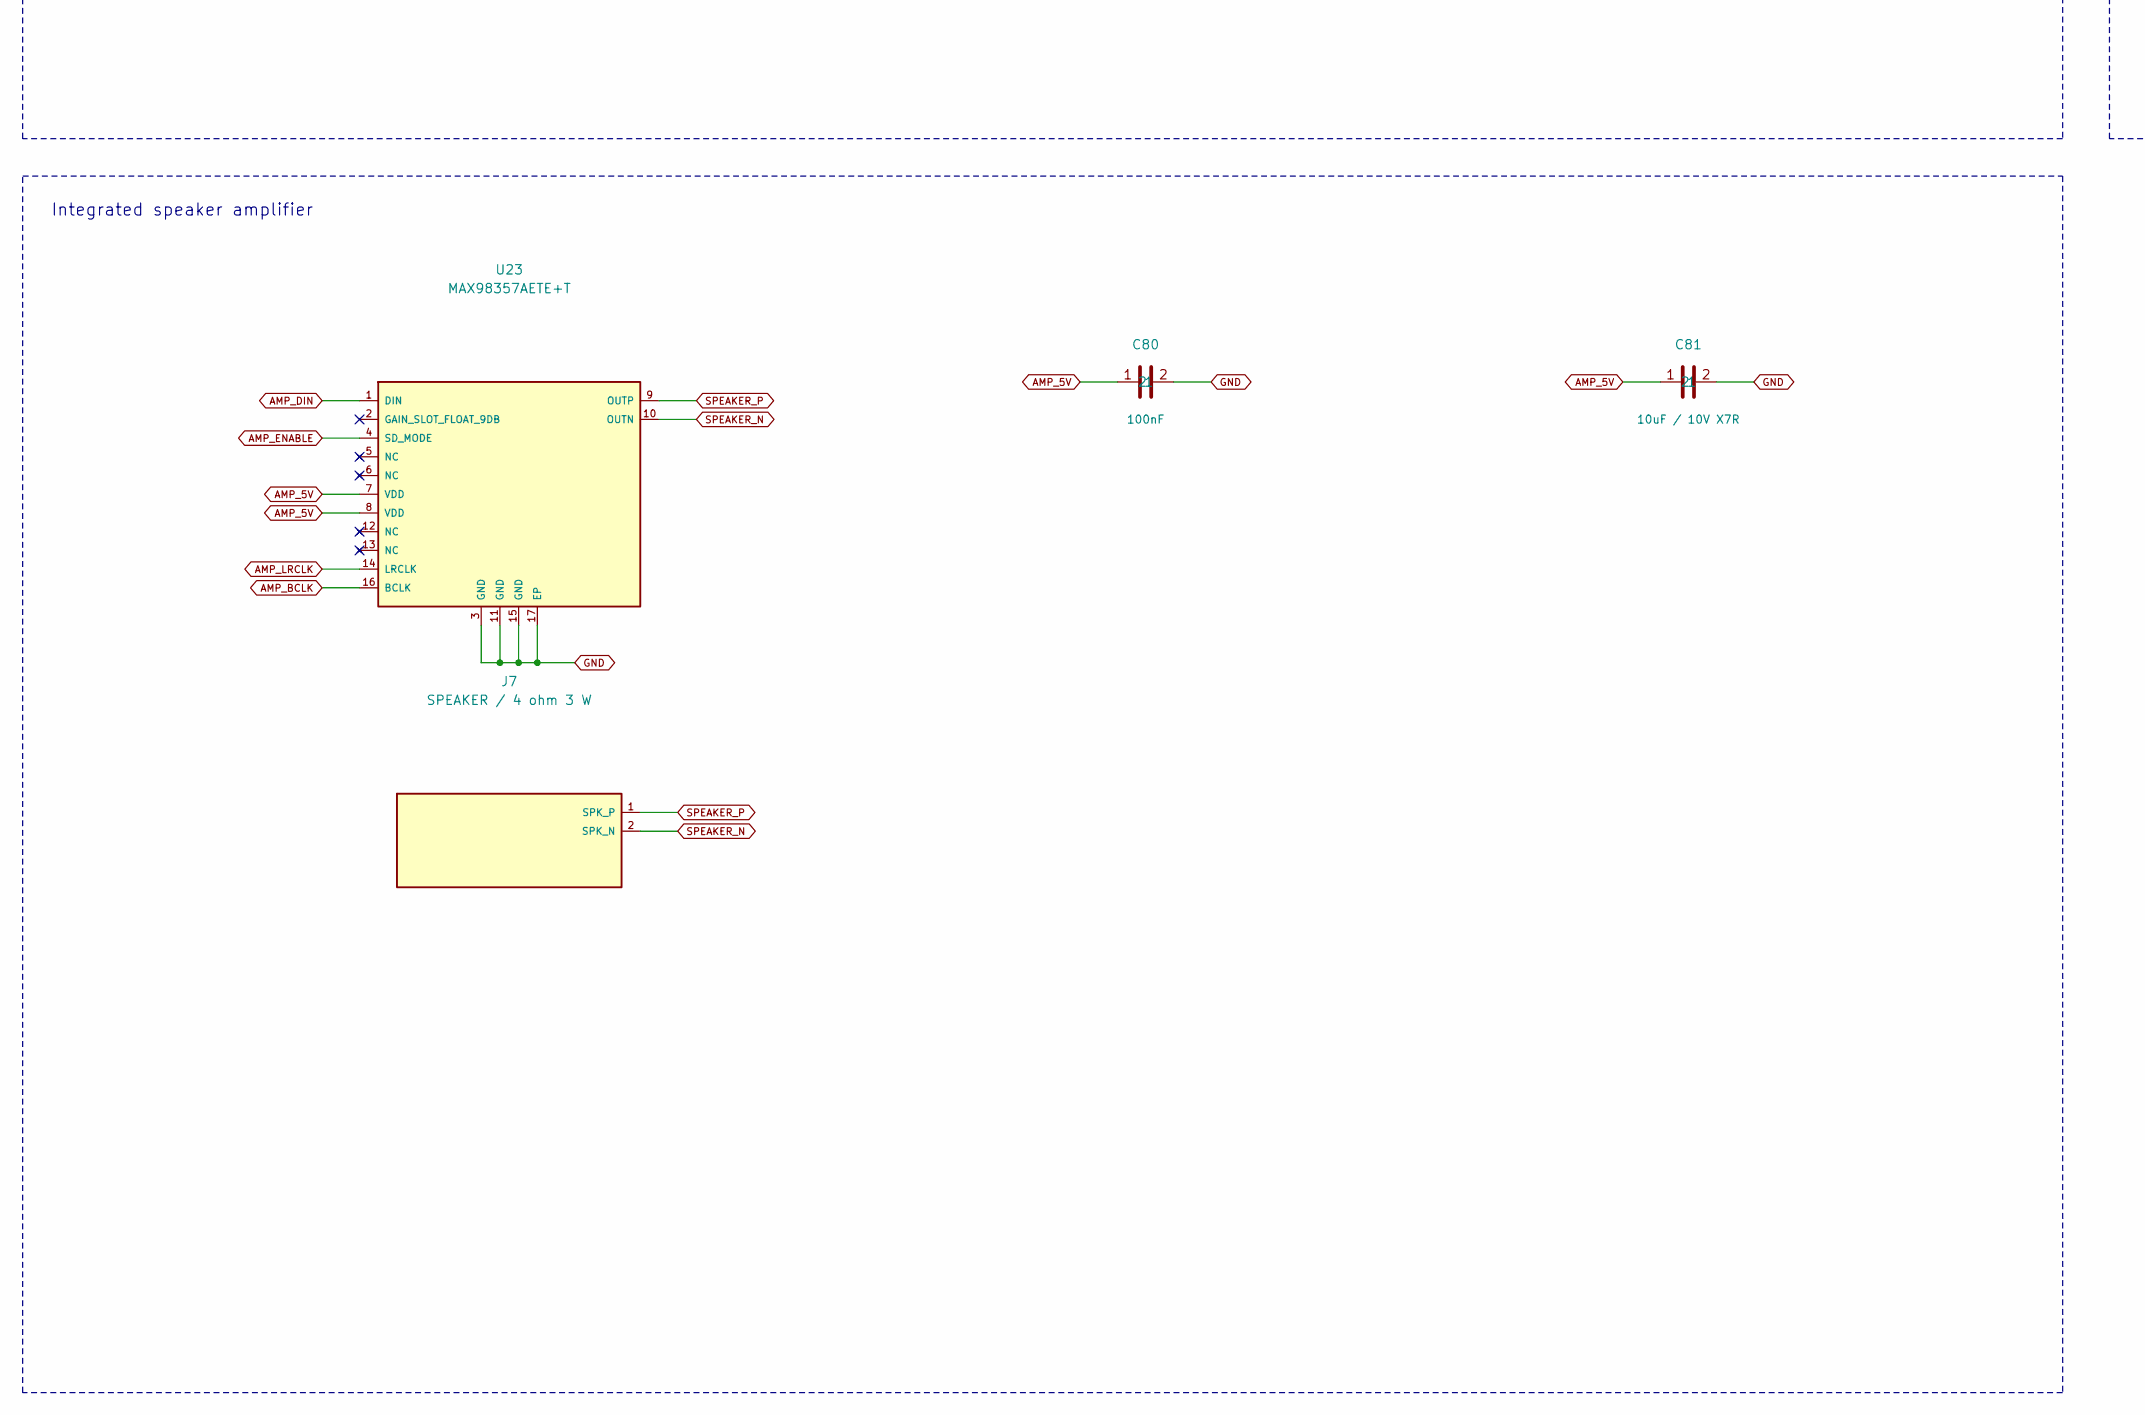
[picture p191: schematic 06_Audio.kicad_sch, MOSS Core V0.7 PROTOTYPE / 06 Audio, part in row 2, column 1]

Parts:
C27, C80: 100nF; Capacitor_SMD_C_0603_1608Metric; MPN GRM188R71C104KA01D
C81: 10uF / 10V X7R; Capacitor_SMD_C_0805_2012Metric; MPN GRM21BR71A106KE51L
J7: SPEAKER / 4 ohm 3 W; Connector_JST_JST_PH_B2B-PH-K_1x02_P2.00mm_Vertical; MPN B2B-PH-K-S(LF)(SN)
Q2: MMBT3904; Package_TO_SOT_SMD_SOT-23; MPN MMBT3904,215
R50, R51, R52: 47; Resistor_SMD_R_0603_1608Metric; MPN RC0603FR-0747RL
R53: 2.2k; Resistor_SMD_R_0603_1608Metric; MPN RC0603FR-072K2L
R54, R56, R58: 10k; Resistor_SMD_R_0603_1608Metric; MPN RC0603FR-0710KL
R55: 100k; Resistor_SMD_R_0603_1608Metric; MPN RC0603FR-07100KL
R57: 22k; Resistor_SMD_R_0603_1608Metric; MPN RC0603FR-0722KL
R90, R91, R92: 47k; Resistor_SMD_R_0603_1608Metric; MPN RC0603FR-0747KL
U16: SN74LVC125APWR; Package_SO_TSSOP-14_4.4x5mm_P0.65mm; MPN SN74LVC125APWR
U23: MAX98357AETE+T; Package_DFN_QFN_MAX98357A_T1633_4_90_0031; MPN MAX98357AETE+T

Connections:
3V3: C27.1, R56.1, U16.14 (VCC); also elsewhere on the board
AMP_5V: C80.1, C81.1, R57.1, U23.7 (VDD), U23.8 (VDD); also elsewhere on the board
AMP_BCLK: R50.2, U23.16 (BCLK)
AMP_DIN: R52.2, U23.1 (DIN)
AMP_ENABLE: R53.2, R55.1, U23.4 (SD_MODE)
AMP_LRCLK: R51.2, U23.14 (LRCLK)
AUDIO_BASE: Q2.1 (B), R57.2, R58.1
AUDIO_BCLK: R90.1, U16.2 (1A); also elsewhere on the board
AUDIO_DATA: R92.1, U16.9 (3A); also elsewhere on the board
AUDIO_ENABLE: R54.1, U16.12 (4A); also elsewhere on the board
AUDIO_LRCLK: R91.1, U16.5 (2A); also elsewhere on the board
AUDIO_OE_N: Q2.3 (C), R56.2, U16.1 (1OE_N), U16.4 (2OE_N), U16.10 (3OE_N), U16.13 (4OE_N)
A_BCLK_BUF: R50.1, U16.3 (1Y)
A_DIN_BUF: R52.1, U16.8 (3Y)
A_EN_BUF: R53.1, U16.11 (4Y)
A_LRCLK_BUF: R51.1, U16.6 (2Y)
GND: C27.2, C80.2, C81.2, Q2.2 (E), R54.2, R55.2, R58.2, R90.2, R91.2, R92.2, U16.7 (GND), U23.3 (GND), U23.11 (GND), U23.15 (GND), U23.17 (EP); also elsewhere on the board
SPEAKER_N: J7.2 (SPK_N), U23.10 (OUTN)
SPEAKER_P: J7.1 (SPK_P), U23.9 (OUTP)

Notes on the sheet:
06 Audio
MAX98357A integrated for4-ohm/3W speaker. Both output terminals active. Start muted; firmware volume/load tests required.
I2S isolation and idle states
Amplifier supply detection
Integrated speaker amplifier

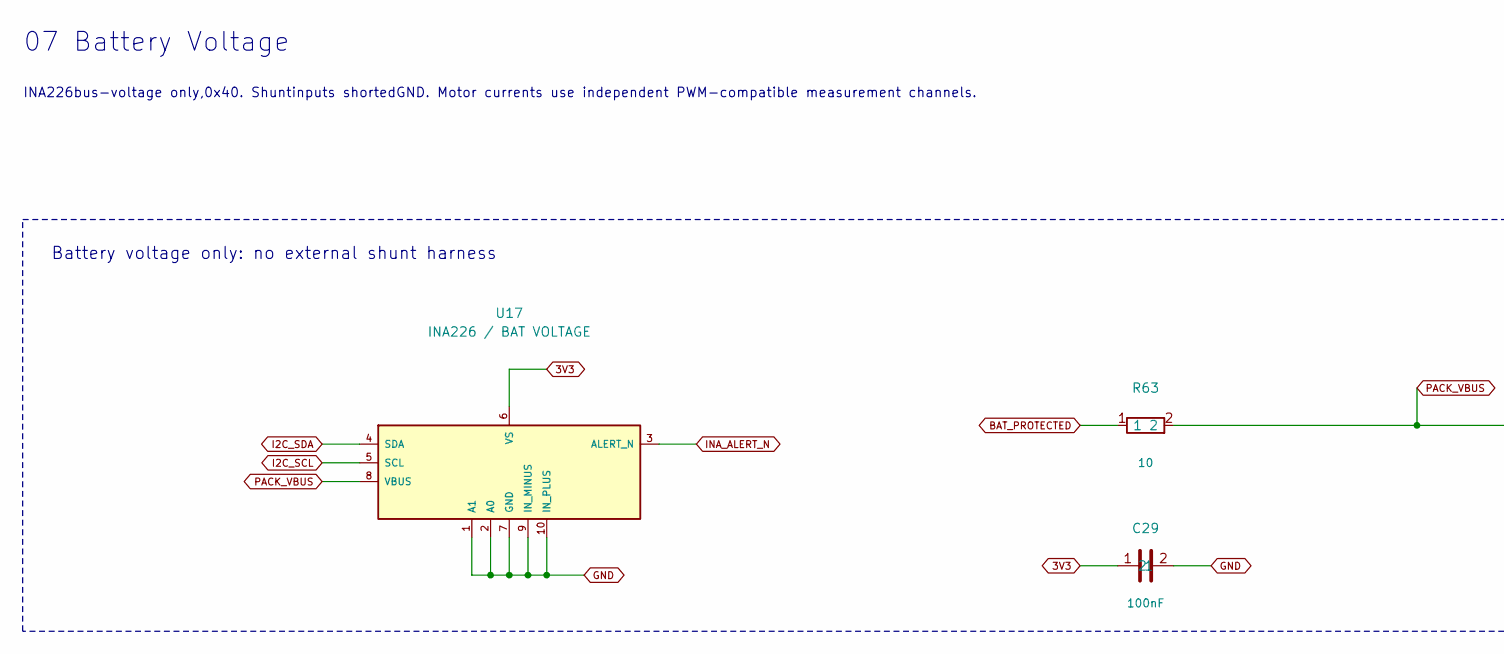
[picture p192: schematic 07_Battery_Voltage.kicad_sch, MOSS Core V0.7 DRAFT / 07 Battery Voltage, part in row 1, column 1]

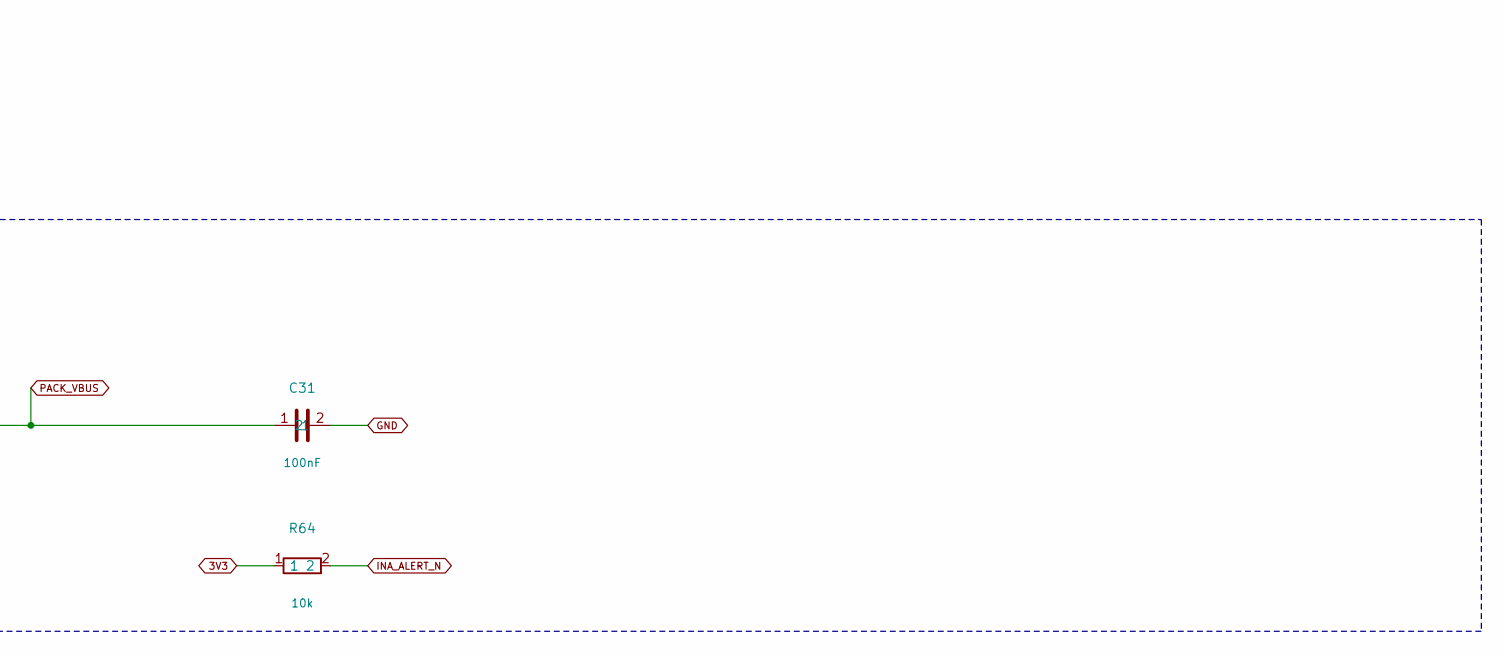
[picture p193: schematic 07_Battery_Voltage.kicad_sch, MOSS Core V0.7 DRAFT / 07 Battery Voltage, part in row 1, column 2]

Parts:
C29: 100nF; Capacitor_SMD_C_0603_1608Metric; MPN GRM188R71C104KA01D
C31: 100nF; Capacitor_SMD_C_0603_1608Metric; MPN GRM188R71H104KA93D
R63: 10; Resistor_SMD_R_0603_1608Metric; MPN RC0603FR-0710RL
R64: 10k; Resistor_SMD_R_0603_1608Metric; MPN RC0603FR-0710KL
U17: INA226 / BAT VOLTAGE; Package_SO_MSOP-10_3x3mm_P0.5mm; MPN INA226AIDGSR

Connections:
3V3: C29.1, R64.1, U17.6 (VS); also elsewhere on the board
BAT_PROTECTED: R63.1; also elsewhere on the board
GND: C29.2, C31.2, U17.1 (A1), U17.2 (A0), U17.7 (GND), U17.9 (IN_MINUS), U17.10 (IN_PLUS); also elsewhere on the board
I2C_SCL: U17.5 (SCL); also elsewhere on the board
I2C_SDA: U17.4 (SDA); also elsewhere on the board
INA_ALERT_N: R64.2, U17.3 (ALERT_N)
PACK_VBUS: C31.1, R63.2, U17.8 (VBUS)

Notes on the sheet:
07 Battery Voltage
INA226bus-voltage only,0x40. Shuntinputs shortedGND. Motor currents use independent PWM-compatible measurement channels.
Battery voltage only: no external shunt harness

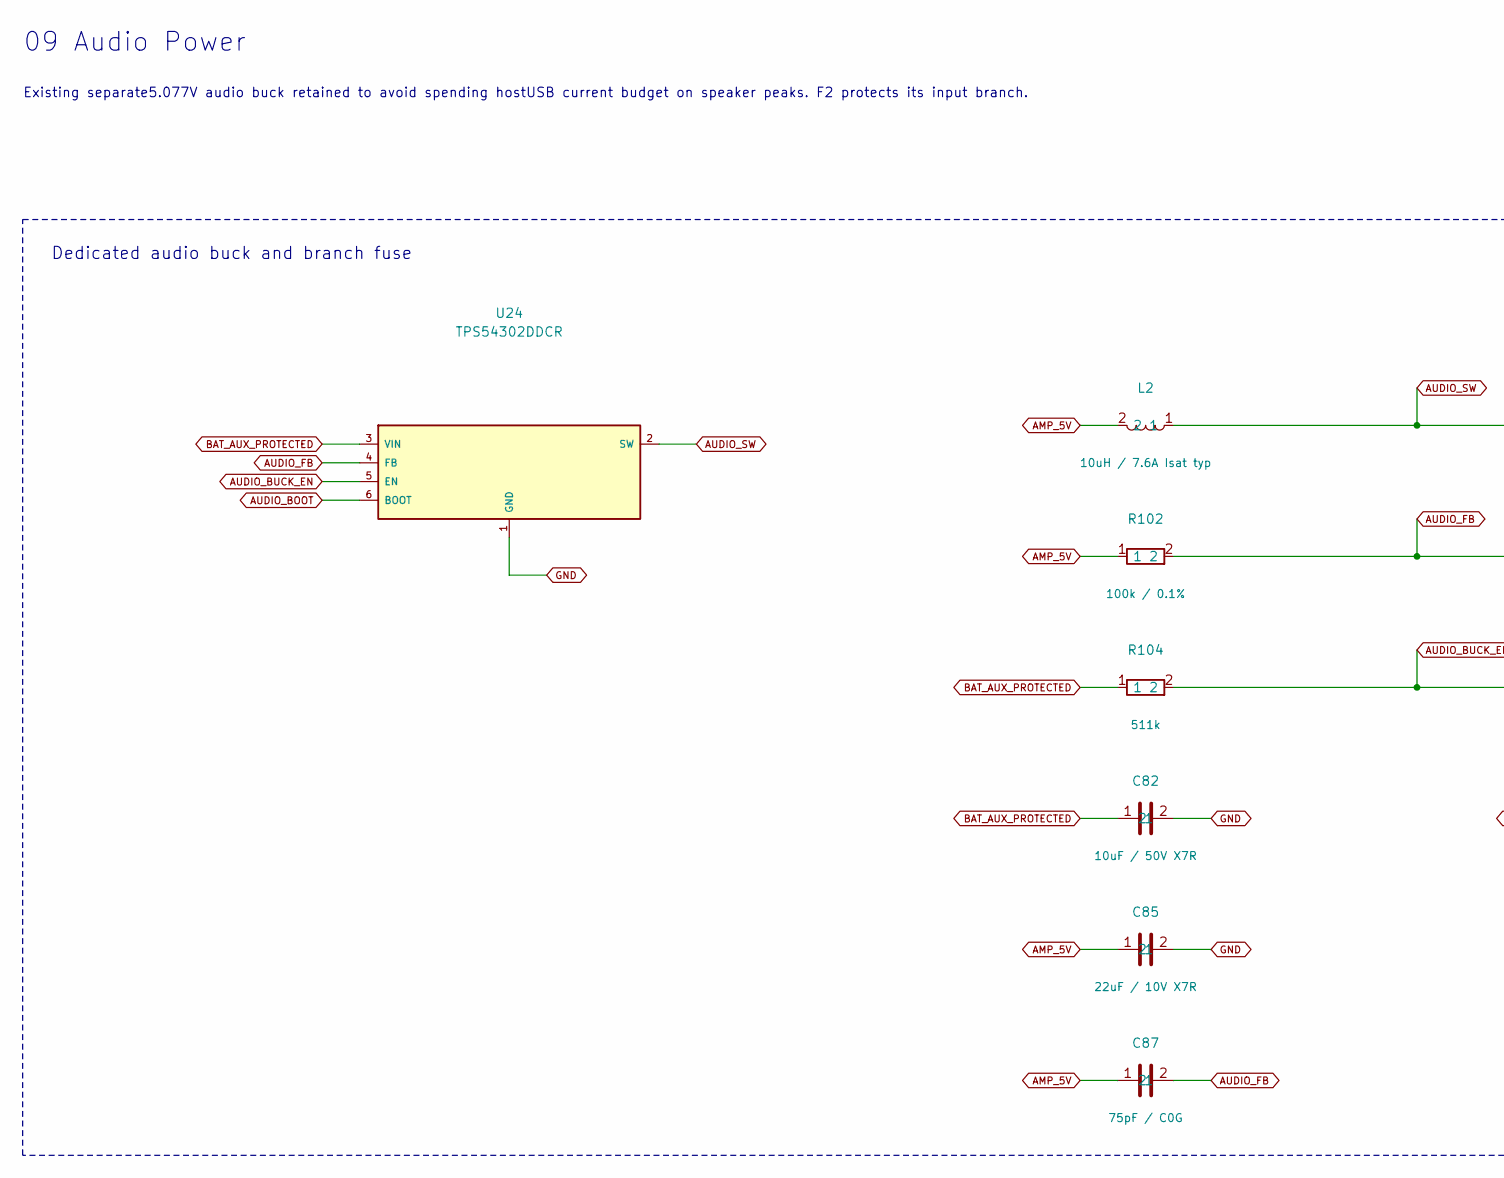
[picture p194: schematic 09_Audio_Power.kicad_sch, MOSS Core V0.7 PROTOTYPE / 09 Audio Power, part in row 1, column 1]

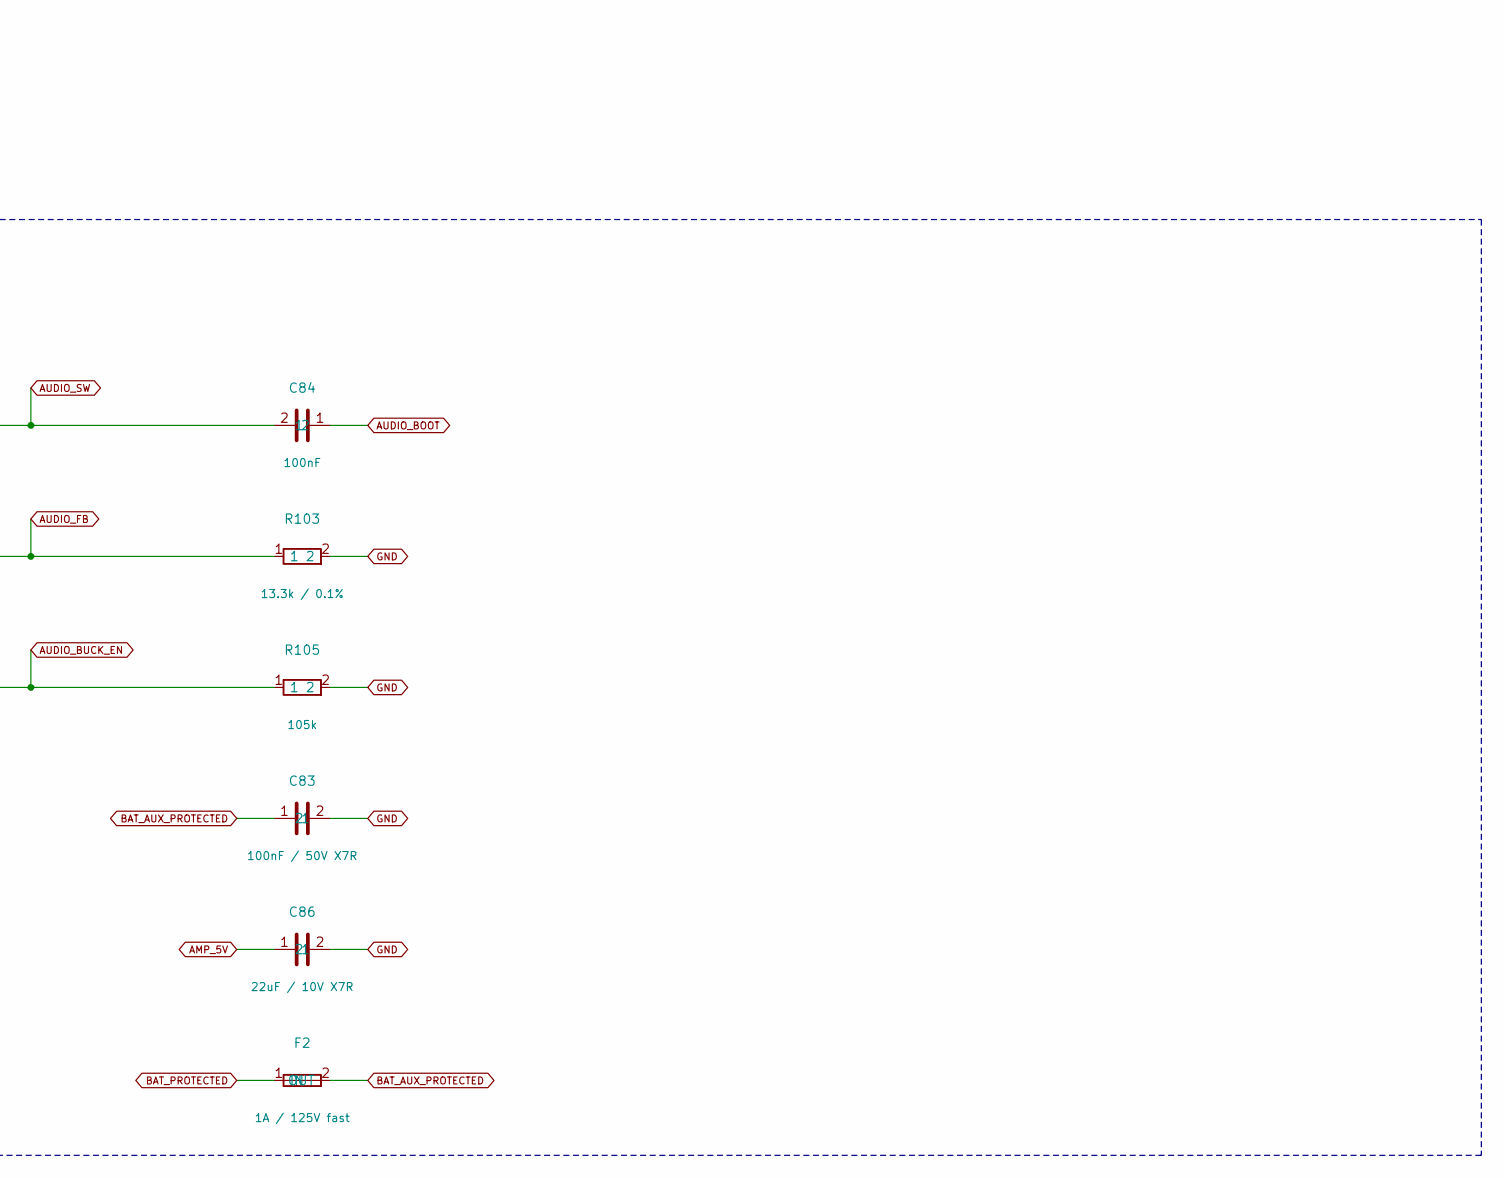
[picture p195: schematic 09_Audio_Power.kicad_sch, MOSS Core V0.7 PROTOTYPE / 09 Audio Power, part in row 1, column 2]

Parts:
C82: 10uF / 50V X7R; Capacitor_SMD_C_1210_3225Metric; MPN GRM32ER71H106KA12L
C83: 100nF / 50V X7R; Capacitor_SMD_C_0805_2012Metric; MPN C0805C104K5RACTU
C84: 100nF; Capacitor_SMD_C_0603_1608Metric; MPN GRM188R71C104KA01D
C85, C86: 22uF / 10V X7R; Capacitor_SMD_C_1206_3216Metric; MPN GRM31CR71A226KE15L
C87: 75pF / C0G; Capacitor_SMD_C_0603_1608Metric; MPN GRM1885C1H750JA01D
F2: 1A / 125V fast; Fuse_Littelfuse_0451_Nano2; MPN 0451001.MRL
L2: 10uH / 7.6A Isat typ; Inductor_SMD_L_Bourns_SRP6060FA; MPN SRP6060FA-100M
R102: 100k / 0.1%; Resistor_SMD_R_0603_1608Metric; MPN RT0603BRD07100KL
R103: 13.3k / 0.1%; Resistor_SMD_R_0603_1608Metric; MPN RT0603BRD0713K3L
R104: 511k; Resistor_SMD_R_0603_1608Metric; MPN RC0603FR-07511KL
R105: 105k; Resistor_SMD_R_0603_1608Metric; MPN RC0603FR-07105KL
U24: TPS54302DDCR; Package_TO_SOT_SMD_SOT-23-6; MPN TPS54302DDCR

Connections:
AMP_5V: C85.1, C86.1, C87.1, L2.2, R102.1; also elsewhere on the board
AUDIO_BOOT: C84.1, U24.6 (BOOT)
AUDIO_BUCK_EN: R104.2, R105.1, U24.5 (EN)
AUDIO_FB: C87.2, R102.2, R103.1, U24.4 (FB)
AUDIO_SW: C84.2, L2.1, U24.2 (SW)
BAT_AUX_PROTECTED: C82.1, C83.1, F2.2 (OUT), R104.1, U24.3 (VIN)
BAT_PROTECTED: F2.1 (IN); also elsewhere on the board
GND: C82.2, C83.2, C85.2, C86.2, R103.2, R105.2, U24.1 (GND); also elsewhere on the board

Notes on the sheet:
09 Audio Power
Existing separate5.077V audio buck retained to avoid spending hostUSB current budget on speaker peaks. F2 protects its input branch.
Dedicated audio buck and branch fuse

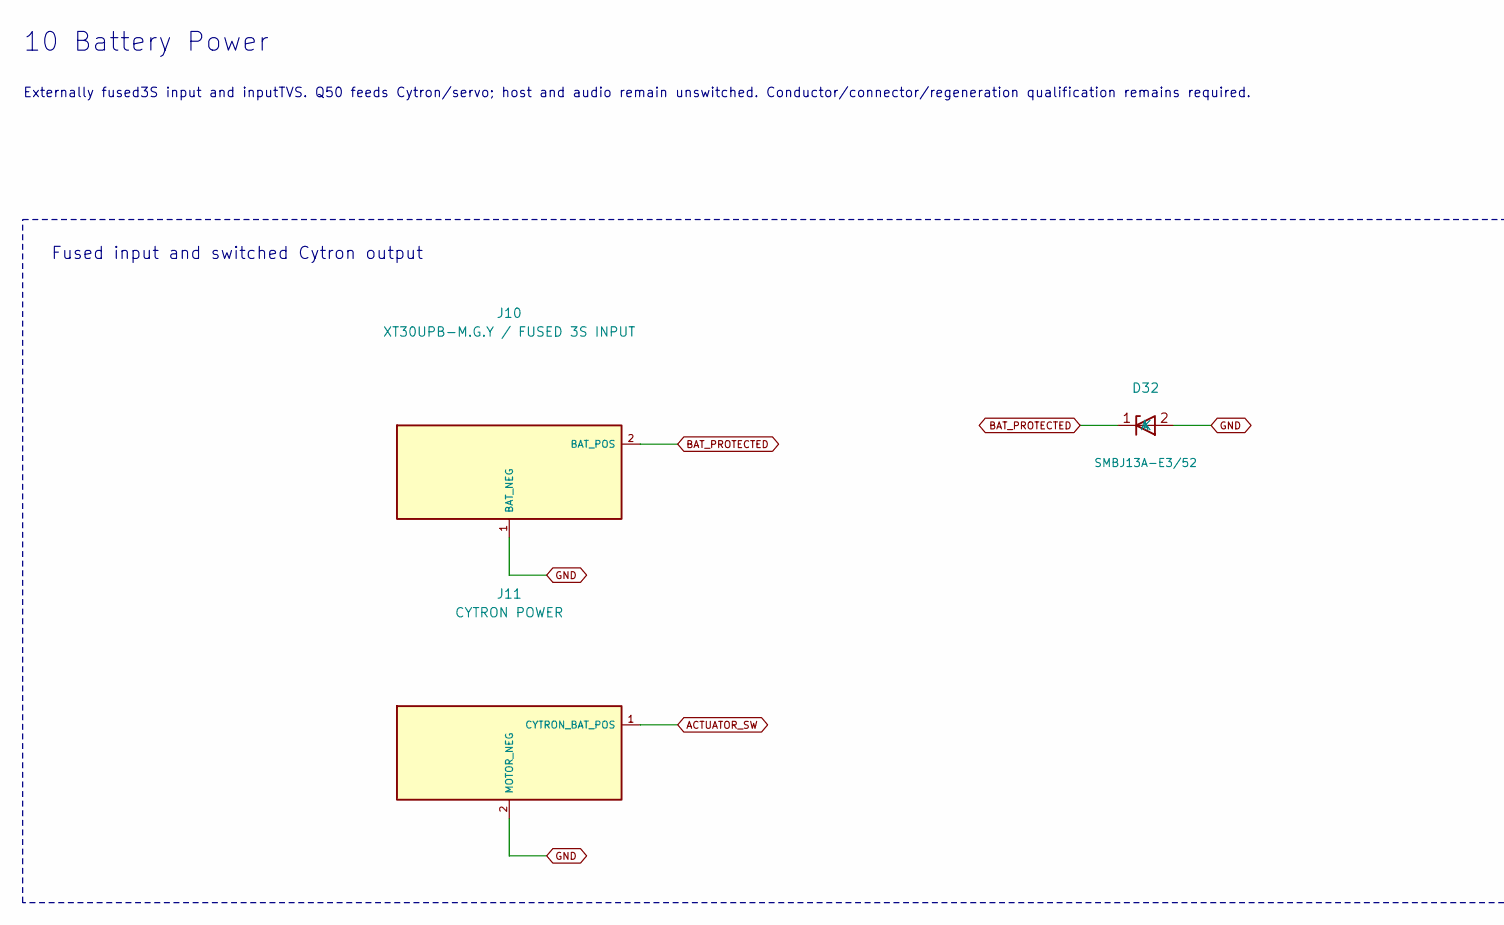
[picture p196: schematic 10_Battery_Power.kicad_sch, MOSS Core V0.7 PROTOTYPE / 10 Battery Power, part in row 1, column 1]

Parts:
D32: SMBJ13A-E3/52; Diode_SMD_D_SMB; MPN SMBJ13A-E3/52
J10: XT30UPB-M.G.Y / FUSED 3S INPUT; Connector_AMASS_AMASS_XT30UPB-M_1x02_P5.0mm_Vertical; MPN XT30UPB-M.G.Y
J11: CYTRON POWER; TerminalBlock_Phoenix_TerminalBlock_Phoenix_MKDS-1,5-2-5.08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; MPN 1715721

Connections:
ACTUATOR_SW: J11.1 (CYTRON_BAT_POS); also elsewhere on the board
BAT_PROTECTED: D32.1 (K), J10.2 (BAT_POS); also elsewhere on the board
GND: D32.2 (A), J10.1 (BAT_NEG), J11.2 (MOTOR_NEG); also elsewhere on the board

Notes on the sheet:
10 Battery Power
Externally fused3S input and inputTVS. Q50 feeds Cytron/servo; host and audio remain unswitched. Conductor/connector/regeneration qualification remains required.
Fused input and switched Cytron output
