metrox-eth/moss/hardware/electronics/moss-core-v0.7/electrical/MOSS_Core_V07_Prototype.kicad_pcb

## KiCad design hardware/electronics/moss-core-v0.7/electrical/MOSS_Core_V07_Prototype.kicad_pcb (continued)

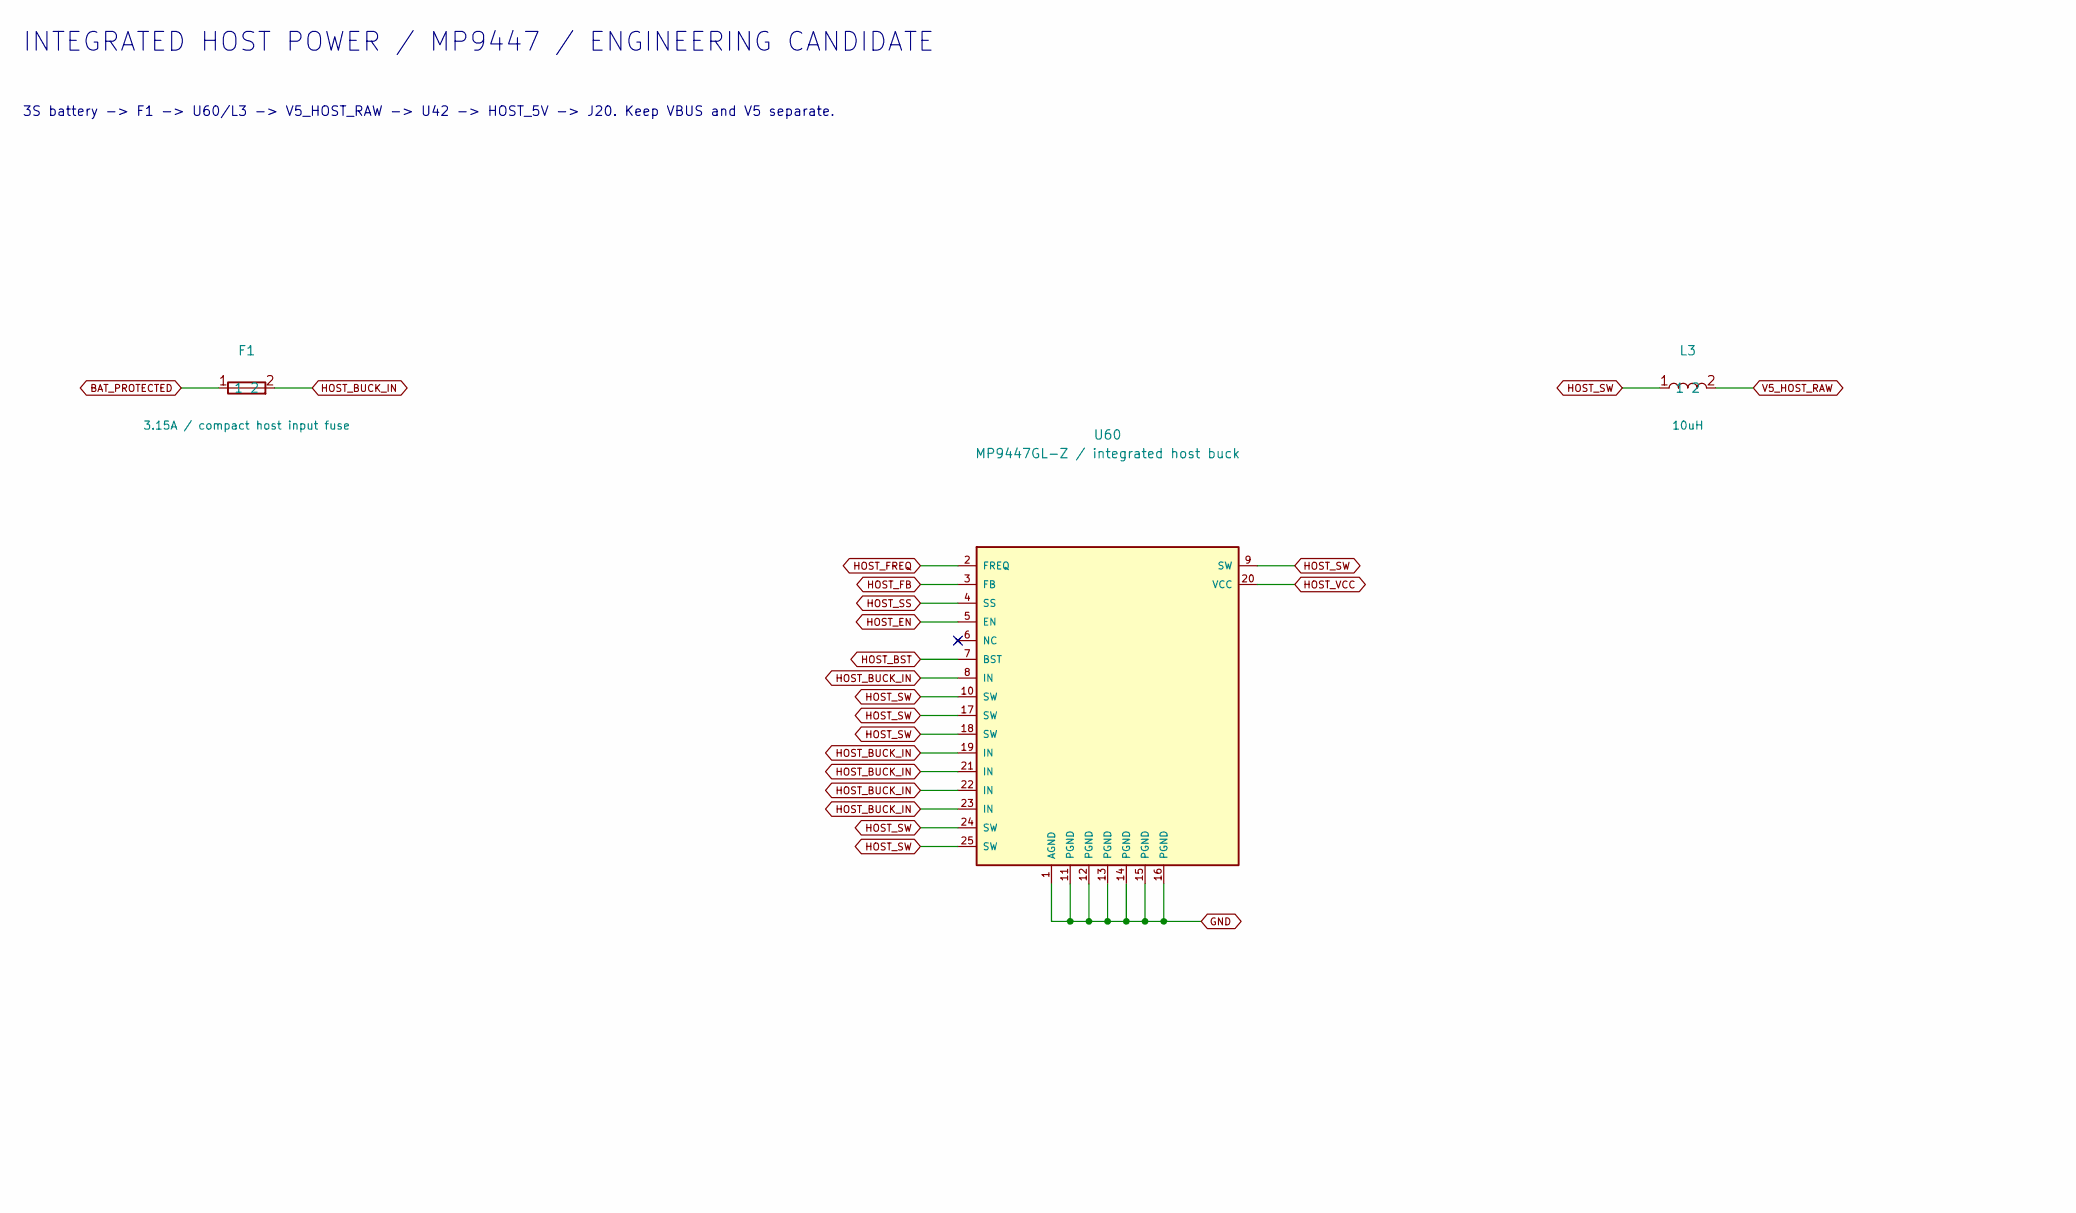
[picture p197: schematic 16_Orange_Pi_Power.kicad_sch, MOSS Core V0.7 PROTOTYPE / Integrated host supply, part in row 1, column 1]

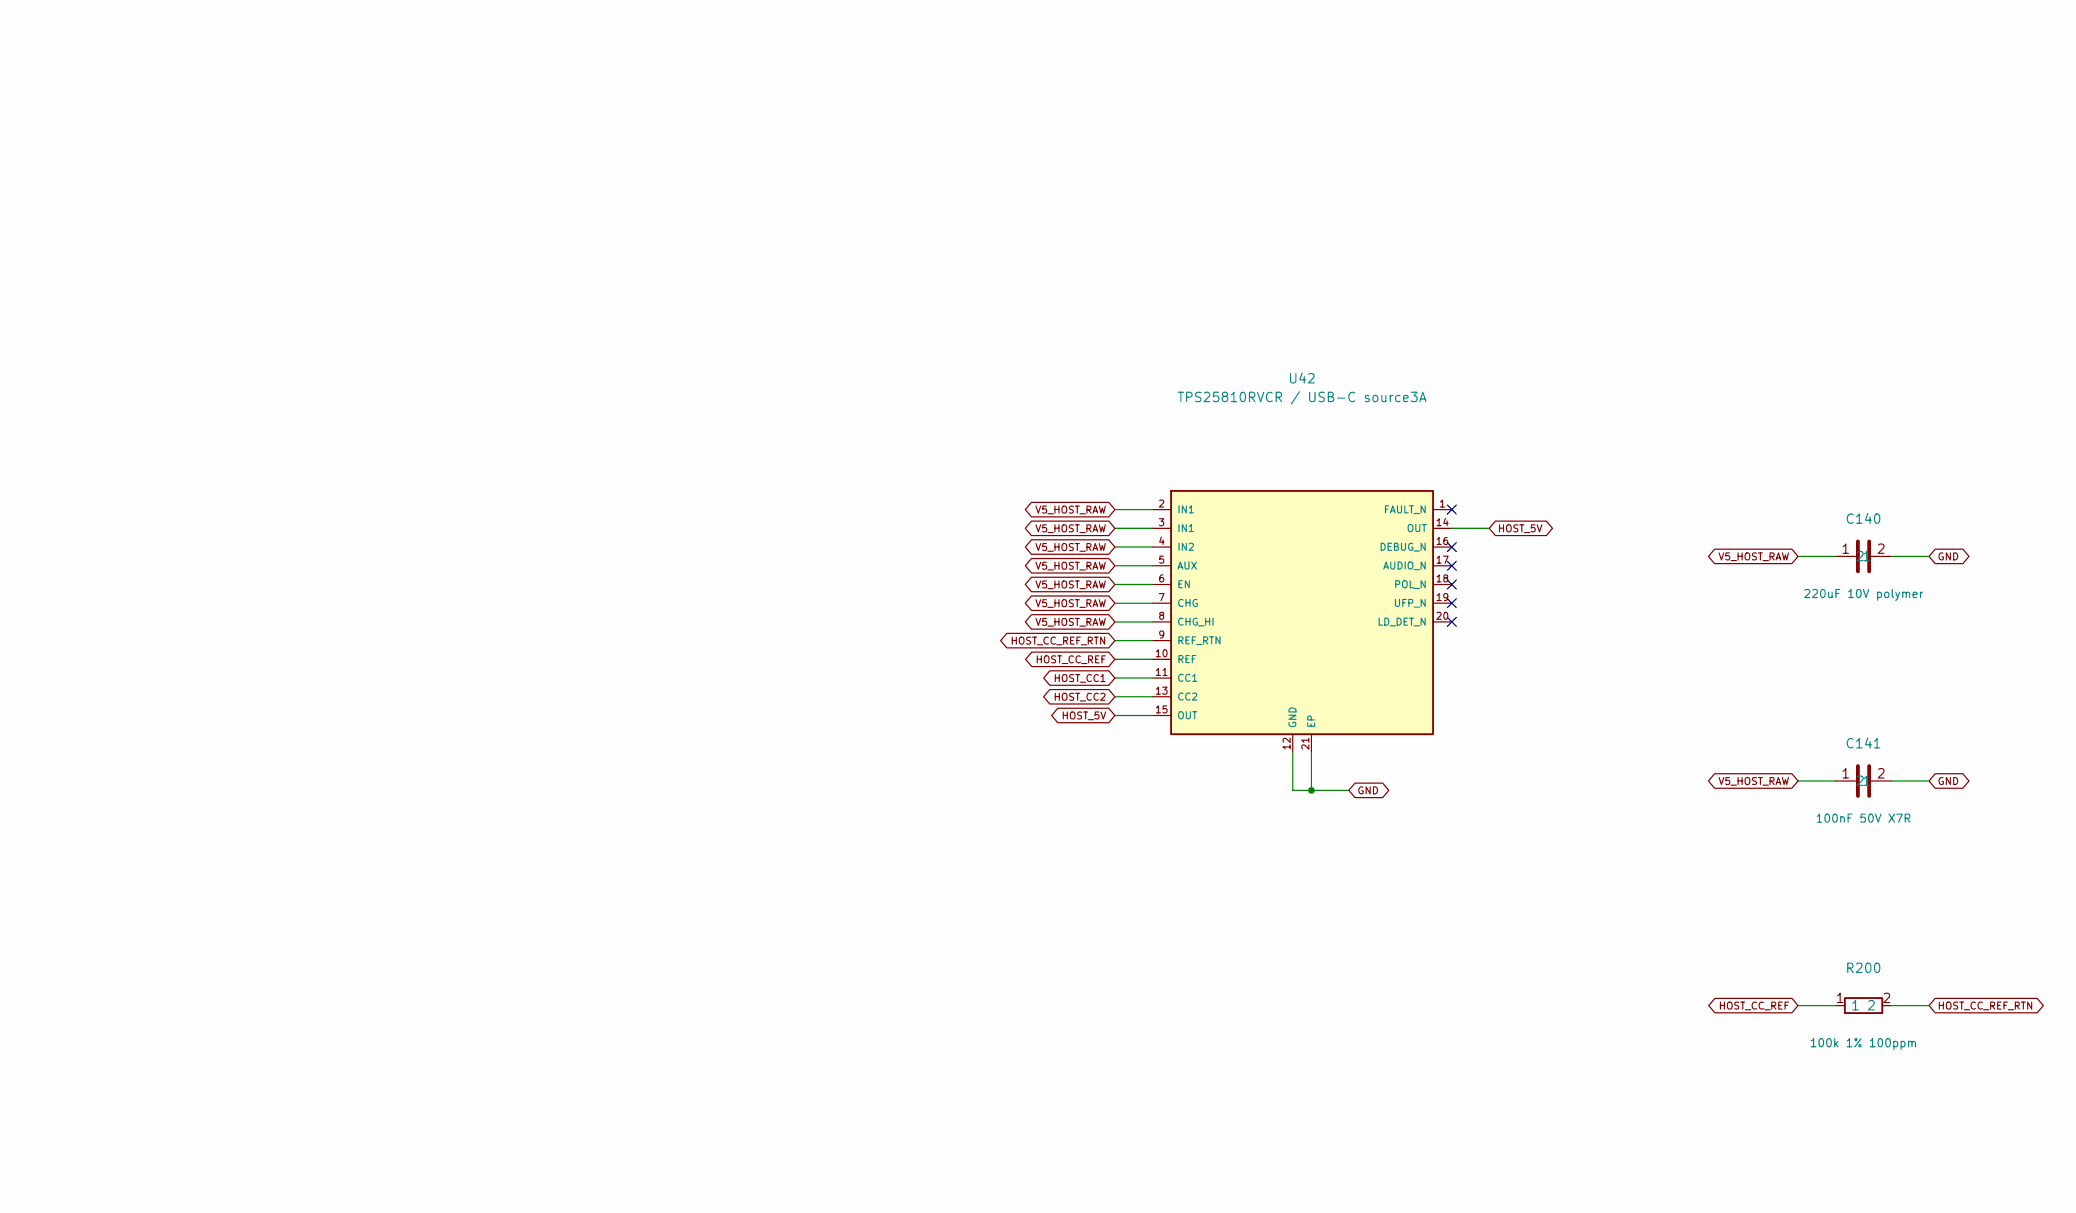
[picture p198: schematic 16_Orange_Pi_Power.kicad_sch, MOSS Core V0.7 PROTOTYPE / Integrated host supply, part in row 1, column 2]

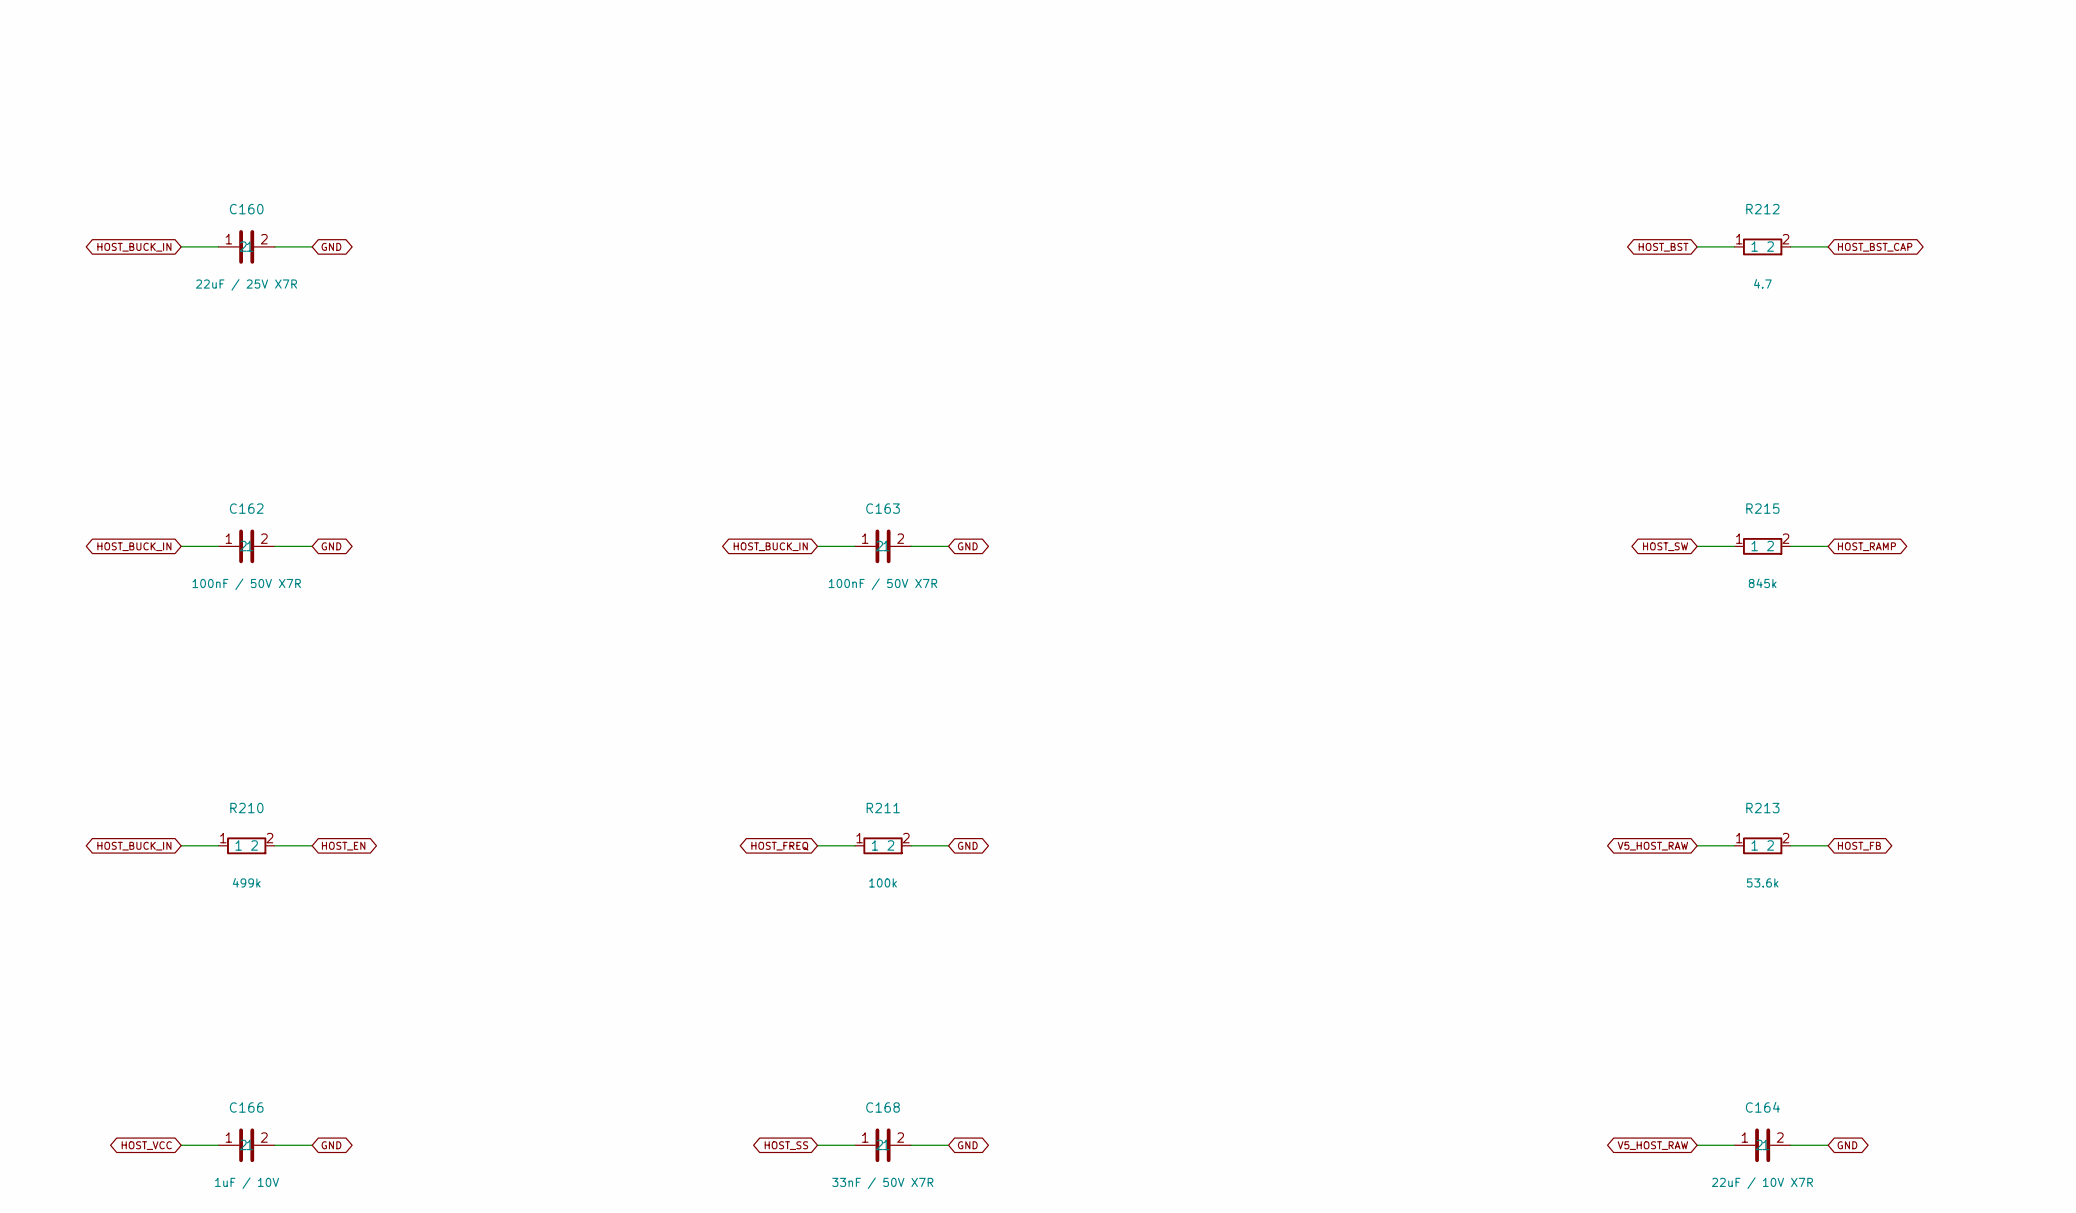
[picture p199: schematic 16_Orange_Pi_Power.kicad_sch, MOSS Core V0.7 PROTOTYPE / Integrated host supply, part in row 2, column 1]

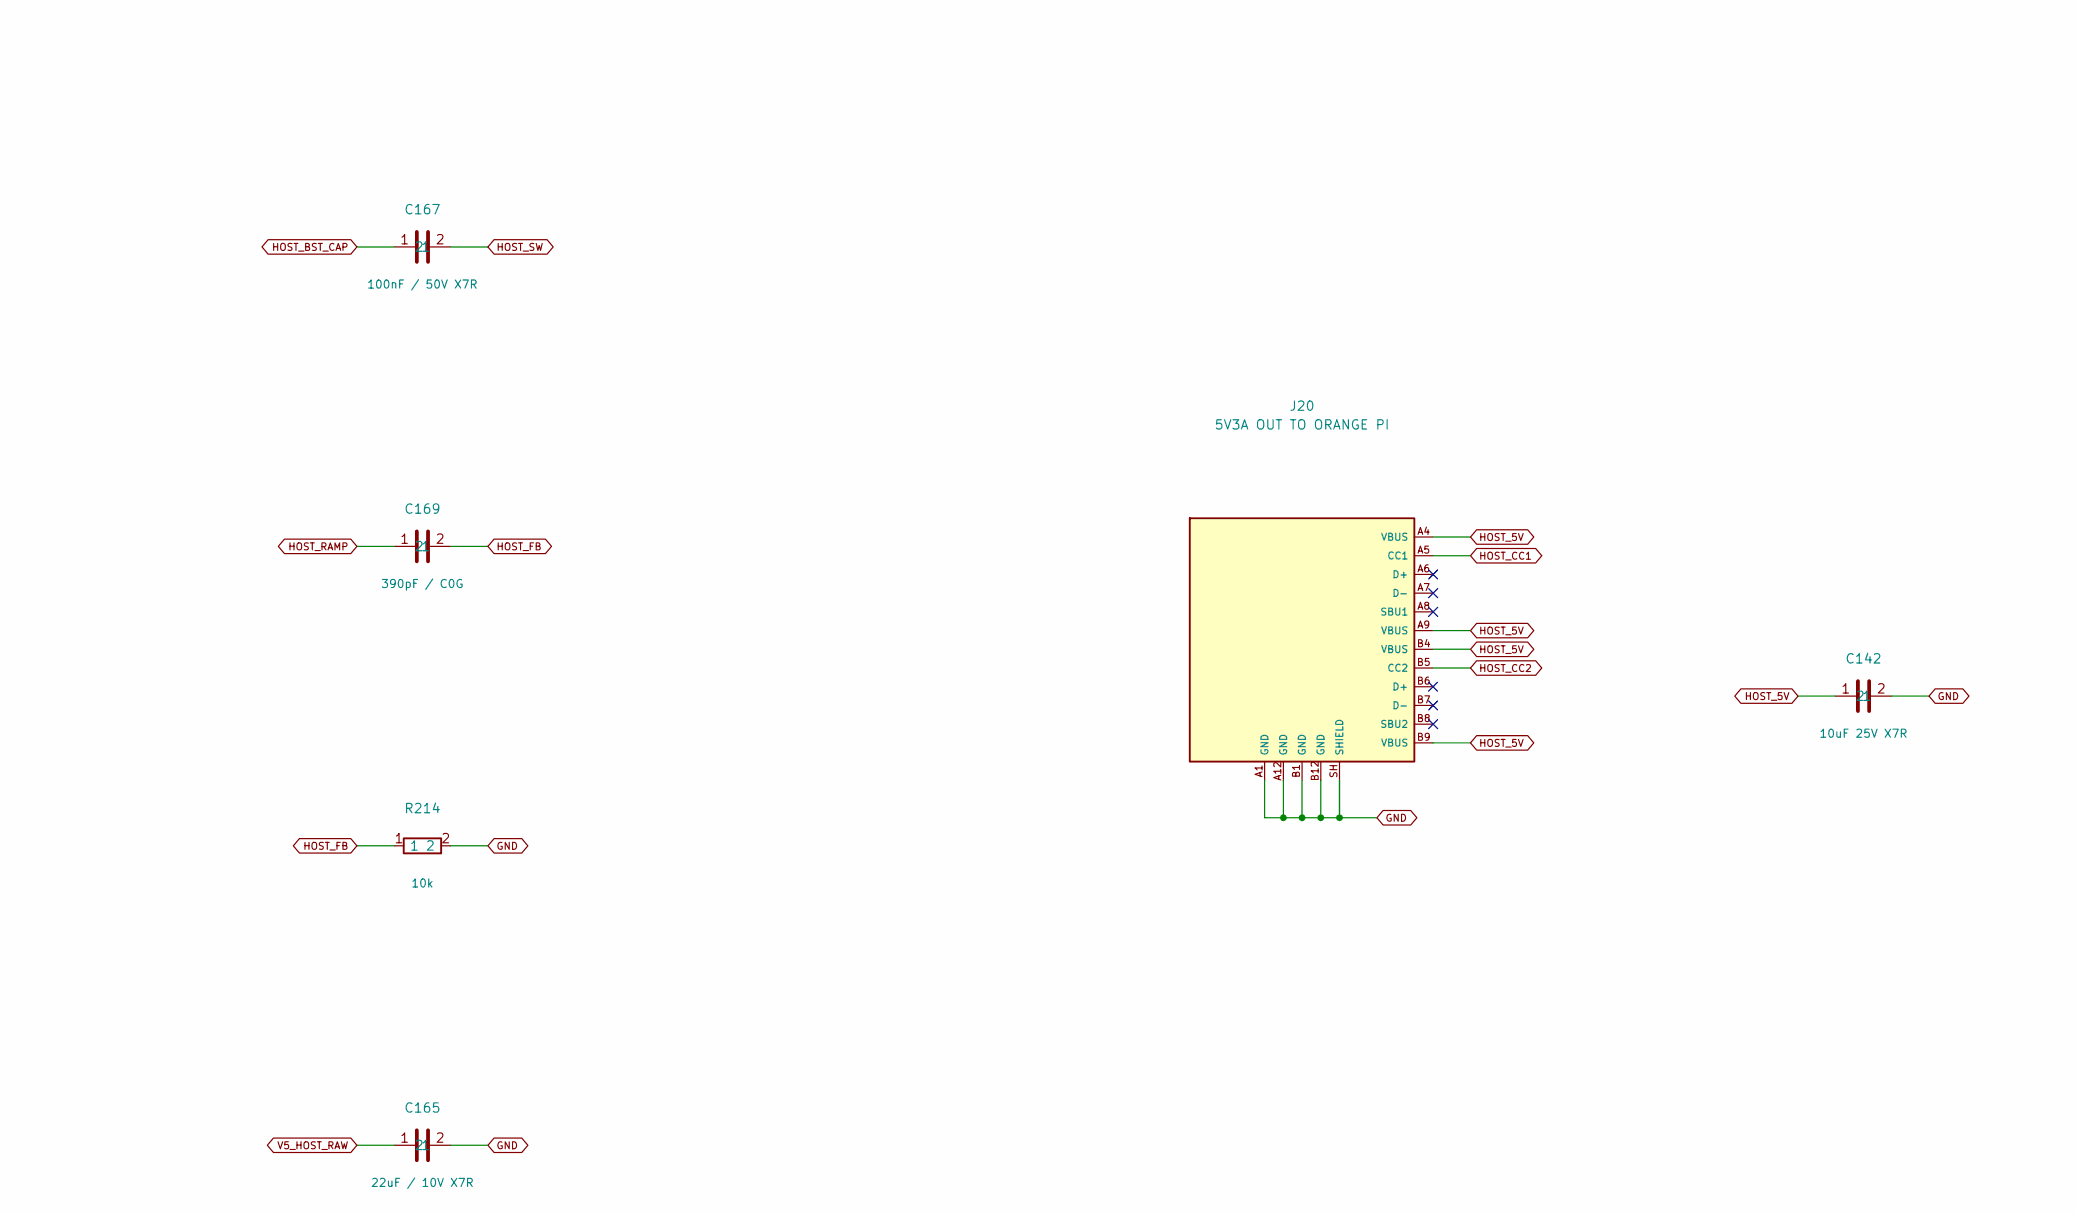
[picture p200: schematic 16_Orange_Pi_Power.kicad_sch, MOSS Core V0.7 PROTOTYPE / Integrated host supply, part in row 2, column 2]

Parts:
C140: 220uF 10V polymer; Capacitor_SMD_CP_Elec_6.3x5.9; MPN 10SVPE220M
C141: 100nF 50V X7R; Capacitor_SMD_C_0603_1608Metric; MPN GRM188R71H104KA93D
C142: 10uF 25V X7R; Capacitor_SMD_C_1206_3216Metric; MPN GRM31CR71E106KA12L
C160: 22uF / 25V X7R; Capacitor_SMD_C_1210_3225Metric; MPN GRM32ER71E226KE15L
C162, C163, C167: 100nF / 50V X7R; Capacitor_SMD_C_0603_1608Metric; MPN GRM188R71H104KA93D
C164, C165: 22uF / 10V X7R; Capacitor_SMD_C_1206_3216Metric; MPN GRM31CR71A226KE15L
C166: 1uF / 10V; Capacitor_SMD_C_0603_1608Metric; MPN GRM188R61A105KA61D
C168: 33nF / 50V X7R; Capacitor_SMD_C_0603_1608Metric; MPN GRM188R71H333KA61D
C169: 390pF / C0G; Capacitor_SMD_C_0603_1608Metric; MPN GRM1885C1H391JA01D
F1: 3.15A / compact host input fuse; Fuse_Fuse_Littelfuse-NANO2-885; MPN 08853.15DR
J20: 5V3A OUT TO ORANGE PI; Connector_USB_USB_C_Receptacle_GCT_USB4105-xx-A_16P_TopMnt_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; MPN USB4105-GF-A
L3: 10uH; Inductor_SMD_L_Bourns_SRP6060FA; MPN SRP6060FA-100M
R200: 100k 1% 100ppm; Resistor_SMD_R_0603_1608Metric; MPN RC0603FR-07100KL
R210: 499k; Resistor_SMD_R_0603_1608Metric; MPN RC0603FR-07499KL
R211: 100k; Resistor_SMD_R_0603_1608Metric; MPN RC0603FR-07100KL
R212: 4.7; Resistor_SMD_R_0603_1608Metric; MPN RC0603FR-074R7L
R213: 53.6k; Resistor_SMD_R_0603_1608Metric; MPN RC0603FR-0753K6L
R214: 10k; Resistor_SMD_R_0603_1608Metric; MPN RC0603FR-0710KL
R215: 845k; Resistor_SMD_R_0603_1608Metric; MPN RC0603FR-07845KL
U42: TPS25810RVCR / USB-C source3A; Package_DFN_QFN_Texas_RVC0020A_WQFN-20-1EP_3x4mm_P0.5mm_EP1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; MPN TPS25810RVCR
U60: MP9447GL-Z / integrated host buck; MOSS_Power_MP9447_QFN25_3x4; MPN MP9447GL-Z

Connections:
BAT_PROTECTED: F1.1; also elsewhere on the board
GND: C140.2, C141.2, C142.2, C160.2, C162.2, C163.2, C164.2, C165.2, C166.2, C168.2, J20.A1 (GND), J20.A12 (GND), J20.B1 (GND), J20.B12 (GND), J20.SH (SHIELD), R211.2, R214.2, U42.12 (GND), U42.21 (EP), U60.1 (AGND), U60.11 (PGND), U60.12 (PGND), U60.13 (PGND), U60.14 (PGND), U60.15 (PGND), U60.16 (PGND); also elsewhere on the board
HOST_5V: C142.1, J20.A4 (VBUS), J20.A9 (VBUS), J20.B4 (VBUS), J20.B9 (VBUS), U42.14 (OUT), U42.15 (OUT)
HOST_BST: R212.1, U60.7 (BST)
HOST_BST_CAP: C167.1, R212.2
HOST_BUCK_IN: C160.1, C162.1, C163.1, F1.2, R210.1, U60.8 (IN), U60.19 (IN), U60.21 (IN), U60.22 (IN), U60.23 (IN)
HOST_CC1: J20.A5 (CC1), U42.11 (CC1)
HOST_CC2: J20.B5 (CC2), U42.13 (CC2)
HOST_CC_REF: R200.1, U42.10 (REF)
HOST_CC_REF_RTN: R200.2, U42.9 (REF_RTN)
HOST_EN: R210.2, U60.5 (EN)
HOST_FB: C169.2, R213.2, R214.1, U60.3 (FB)
HOST_FREQ: R211.1, U60.2 (FREQ)
HOST_RAMP: C169.1, R215.2
HOST_SS: C168.1, U60.4 (SS)
HOST_SW: C167.2, L3.1, R215.1, U60.9 (SW), U60.10 (SW), U60.17 (SW), U60.18 (SW), U60.24 (SW), U60.25 (SW)
HOST_VCC: C166.1, U60.20 (VCC)
V5_HOST_RAW: C140.1, C141.1, C164.1, C165.1, L3.2, R213.1, U42.2 (IN1), U42.3 (IN1), U42.4 (IN2), U42.5 (AUX), U42.6 (EN), U42.7 (CHG), U42.8 (CHG_HI)

Notes on the sheet:
INTEGRATED HOST POWER / MP9447 / ENGINEERING CANDIDATE
3S battery -> F1 -> U60/L3 -> V5_HOST_RAW -> U42 -> HOST_5V -> J20. Keep VBUS and V5 separate.

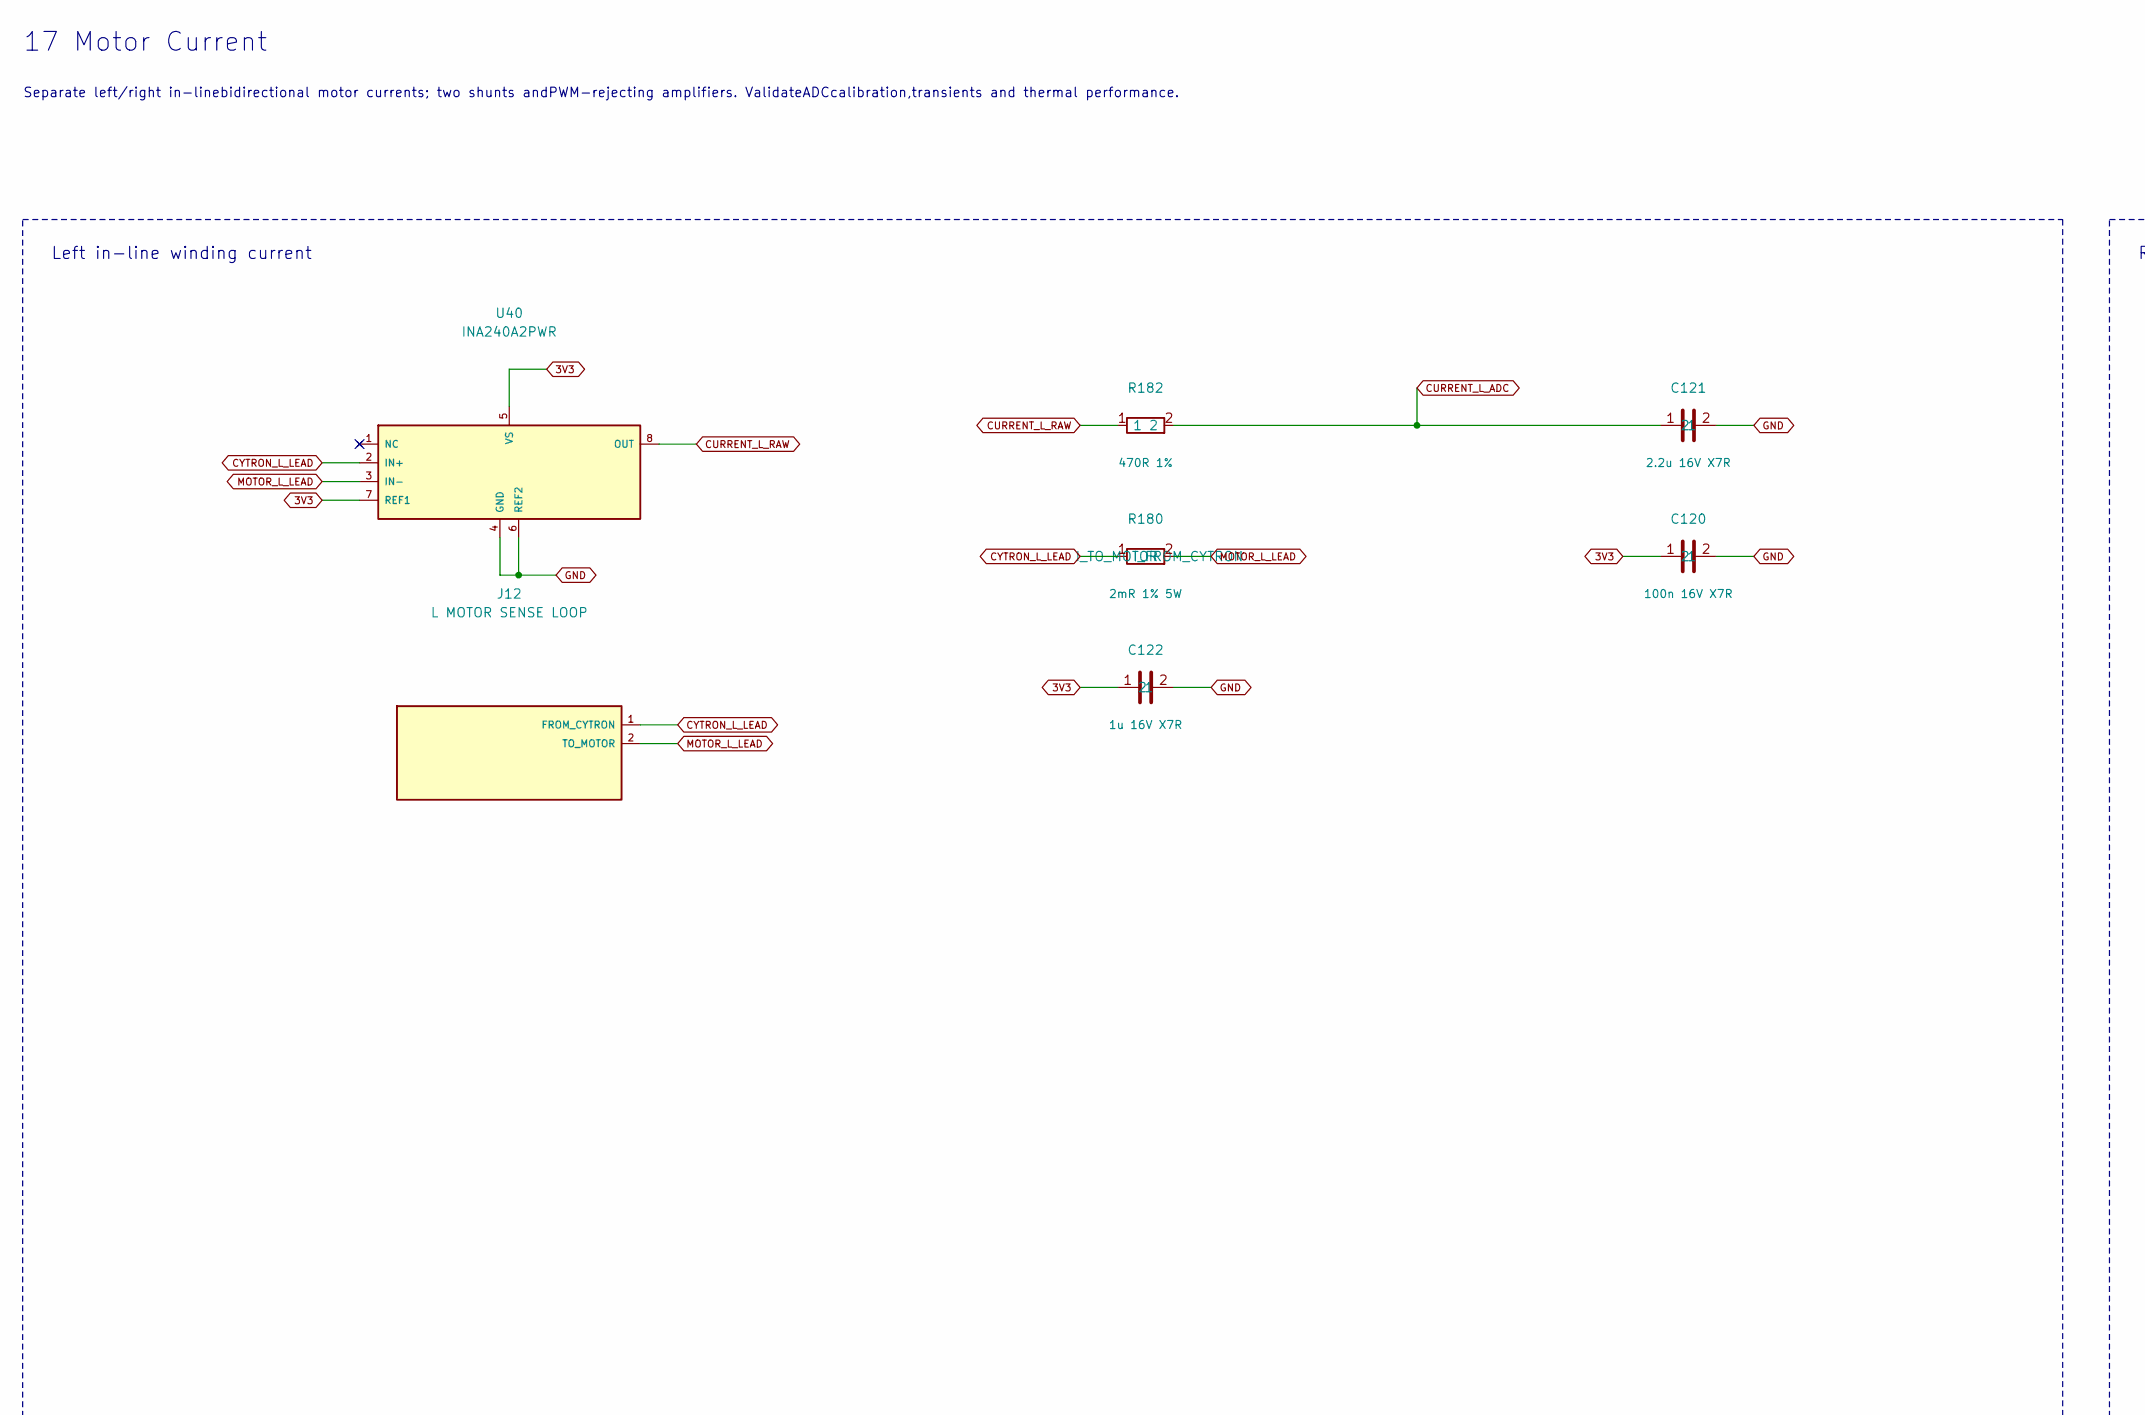
[picture p201: schematic 17_Motor_Current.kicad_sch, MOSS Core V0.7 PROTOTYPE / 17 Motor Current, part in row 1, column 1]

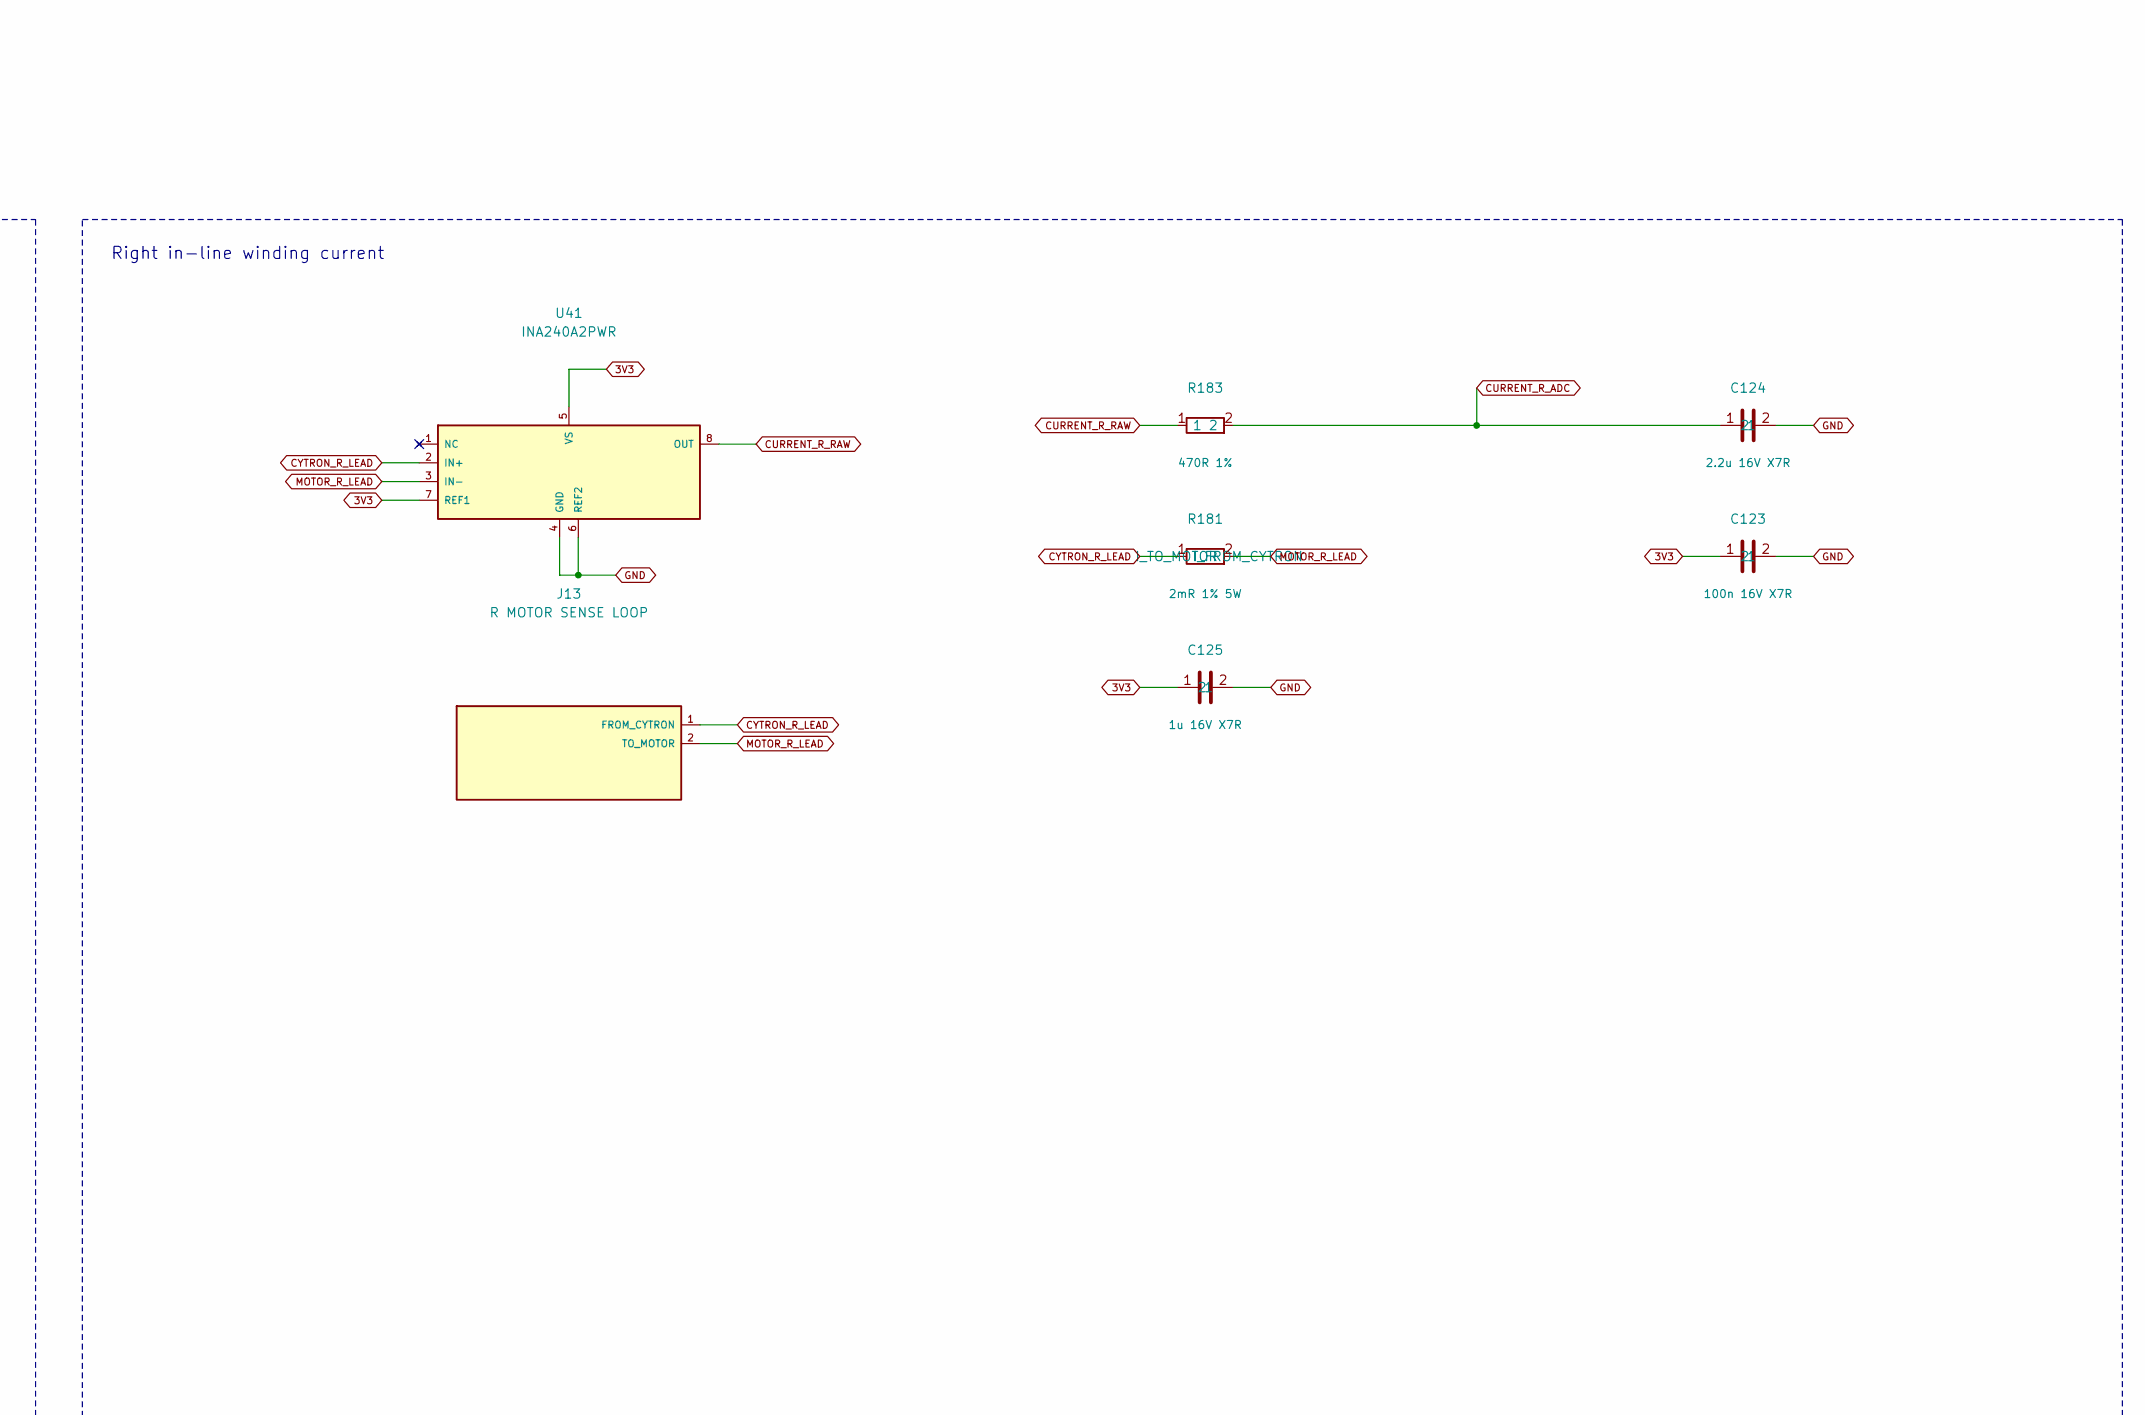
[picture p202: schematic 17_Motor_Current.kicad_sch, MOSS Core V0.7 PROTOTYPE / 17 Motor Current, part in row 1, column 2]

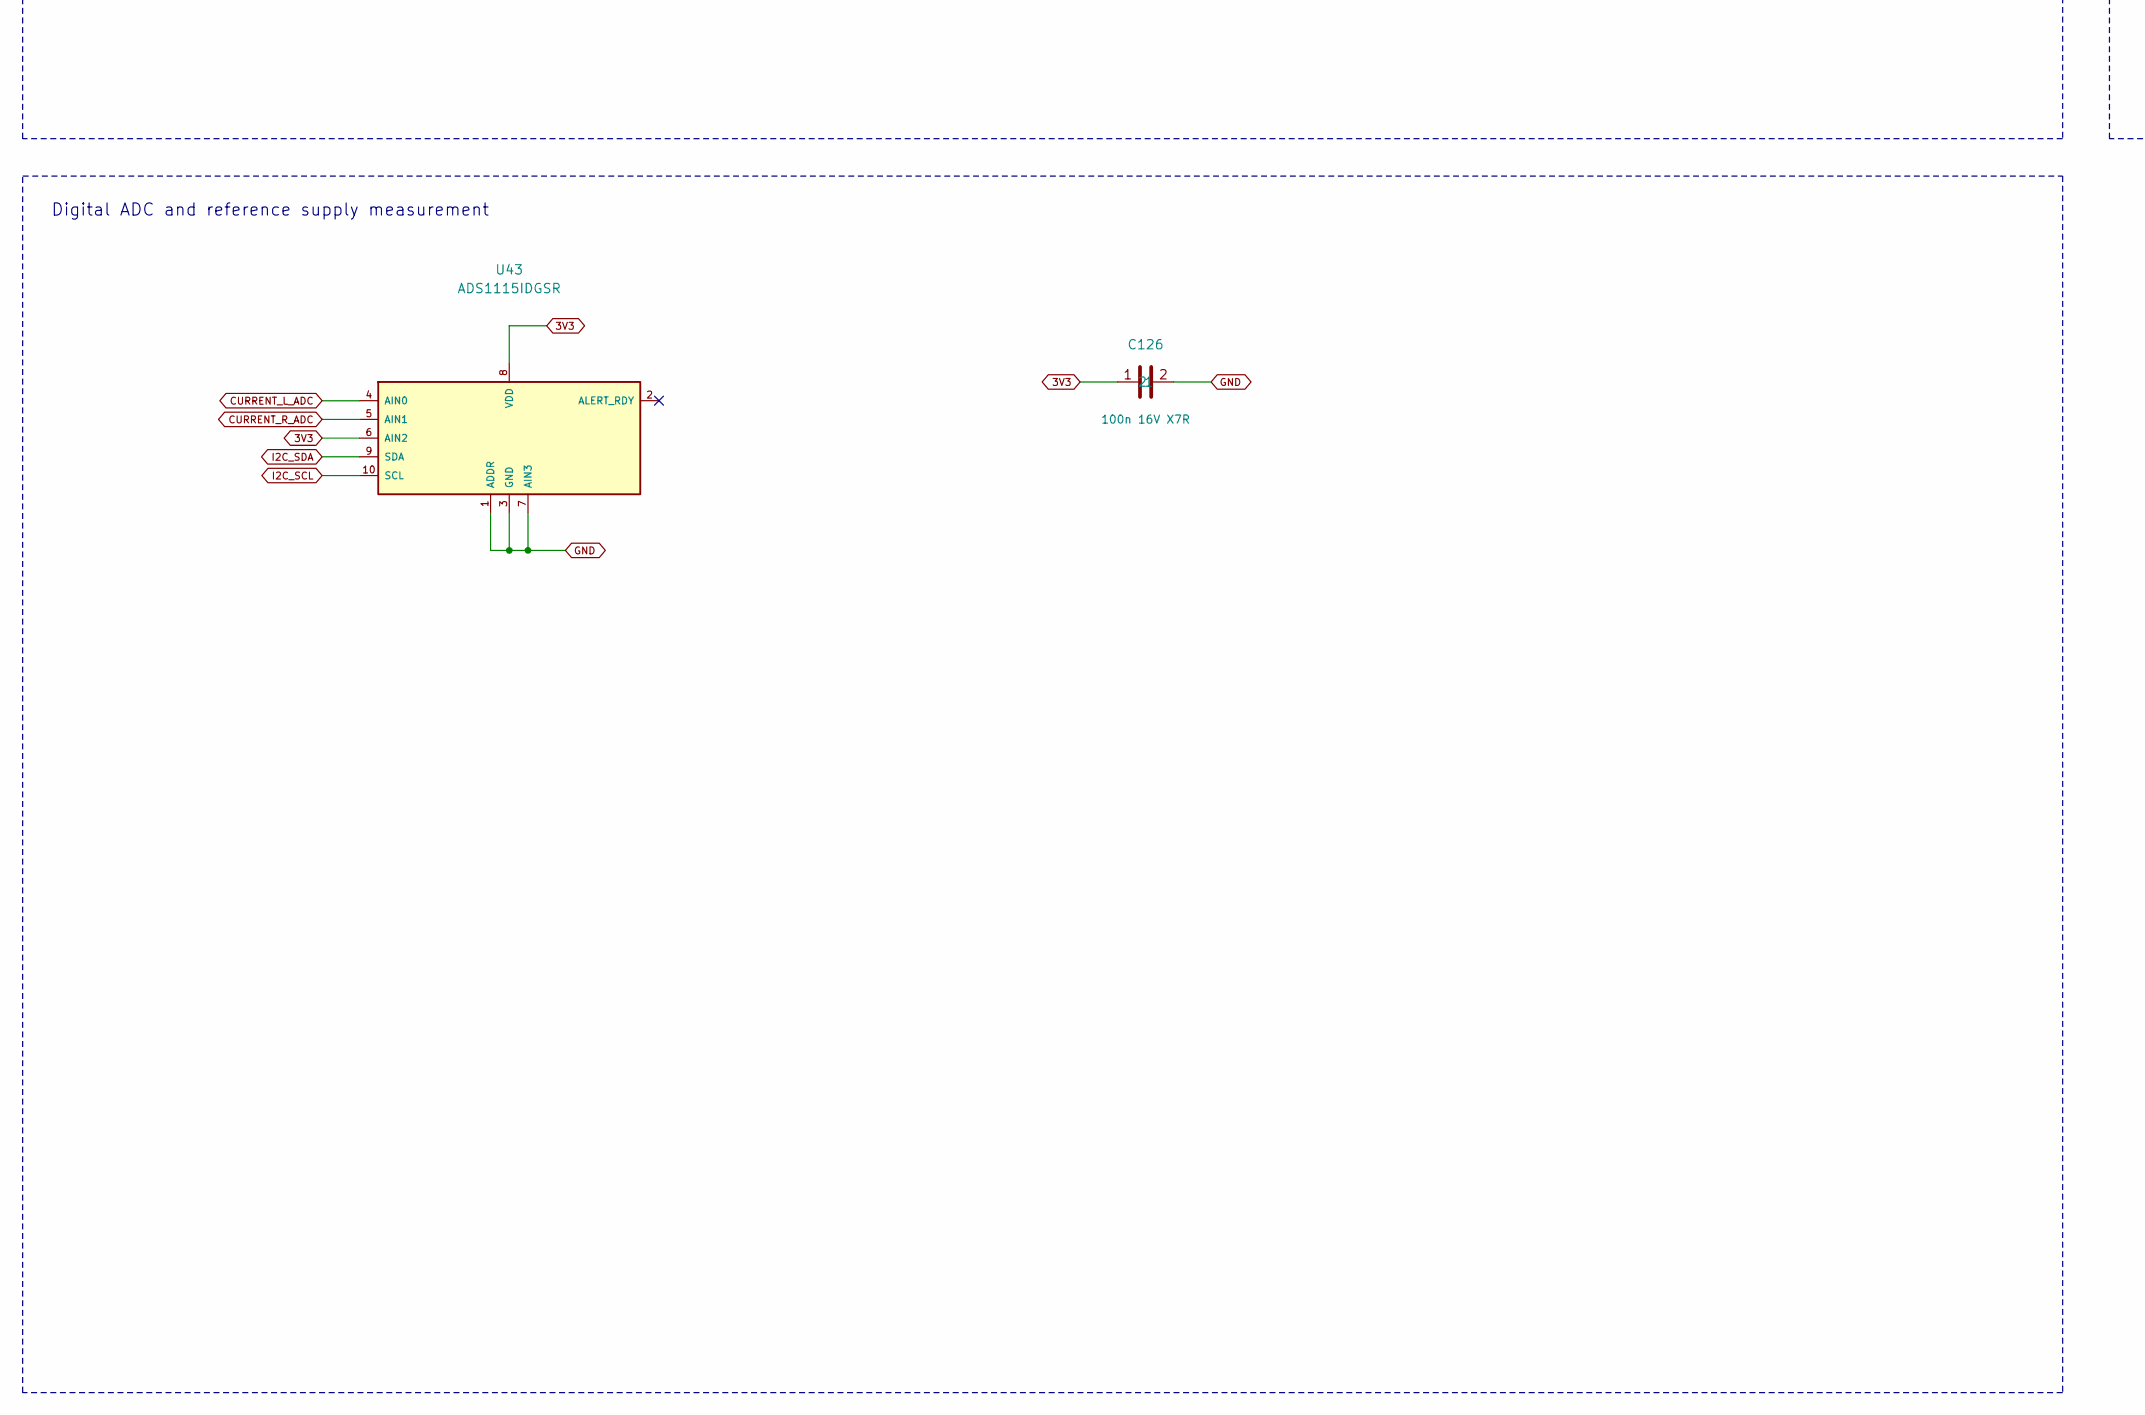
[picture p203: schematic 17_Motor_Current.kicad_sch, MOSS Core V0.7 PROTOTYPE / 17 Motor Current, part in row 2, column 1]

Parts:
C120, C123, C126: 100n 16V X7R; Capacitor_SMD_C_0603_1608Metric; MPN C0603C104K4RACTU
C121, C124: 2.2u 16V X7R; Capacitor_SMD_C_0805_2012Metric; MPN C0805C225K4RACTU
C122, C125: 1u 16V X7R; Capacitor_SMD_C_0603_1608Metric; MPN C0603C105K4RACTU
J12: L MOTOR SENSE LOOP; TerminalBlock_Phoenix_TerminalBlock_Phoenix_MKDS-1,5-2-5.08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; MPN 1715721
J13: R MOTOR SENSE LOOP; TerminalBlock_Phoenix_TerminalBlock_Phoenix_MKDS-1,5-2-5.08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; MPN 1715721
R180, R181: 2mR 1% 5W; MOSS_V07_CSS2H_2512K_Bourns; MPN CSS2H-2512K-2L00F
R182, R183: 470R 1%; Resistor_SMD_R_0603_1608Metric; MPN CRCW0603470RFKEA
U40, U41: INA240A2PWR; Package_SO_TSSOP-8_4.4x3mm_P0.65mm; MPN INA240A2PWR
U43: ADS1115IDGSR; Package_SO_MSOP-10_3x3mm_P0.5mm; MPN ADS1115IDGSR

Connections:
3V3: C120.1, C122.1, C123.1, C125.1, C126.1, U40.5 (VS), U40.7 (REF1), U41.5 (VS), U41.7 (REF1), U43.6 (AIN2), U43.8 (VDD); also elsewhere on the board
CURRENT_L_ADC: C121.1, R182.2, U43.4 (AIN0)
CURRENT_L_RAW: R182.1, U40.8 (OUT)
CURRENT_R_ADC: C124.1, R183.2, U43.5 (AIN1)
CURRENT_R_RAW: R183.1, U41.8 (OUT)
CYTRON_L_LEAD: J12.1 (FROM_CYTRON), R180.1 (I_FROM_CYTRON), U40.2 (IN+); also elsewhere on the board
CYTRON_R_LEAD: J13.1 (FROM_CYTRON), R181.1 (I_FROM_CYTRON), U41.2 (IN+); also elsewhere on the board
GND: C120.2, C121.2, C122.2, C123.2, C124.2, C125.2, C126.2, U40.4 (GND), U40.6 (REF2), U41.4 (GND), U41.6 (REF2), U43.1 (ADDR), U43.3 (GND), U43.7 (AIN3); also elsewhere on the board
I2C_SCL: U43.10 (SCL); also elsewhere on the board
I2C_SDA: U43.9 (SDA); also elsewhere on the board
MOTOR_L_LEAD: J12.2 (TO_MOTOR), R180.2 (I_TO_MOTOR), U40.3 (IN-); also elsewhere on the board
MOTOR_R_LEAD: J13.2 (TO_MOTOR), R181.2 (I_TO_MOTOR), U41.3 (IN-); also elsewhere on the board

Notes on the sheet:
17 Motor Current
Separate left/right in-linebidirectional motor currents; two shunts andPWM-rejecting amplifiers. ValidateADCcalibration,transients and thermal performance.
Left in-line winding current
Right in-line winding current
Digital ADC and reference supply measurement
