metrox-eth/moss/hardware/electronics/moss-core-v0.7/electrical/MOSS_Core_V07_Prototype.kicad_pcb

## KiCad design hardware/electronics/moss-core-v0.7/electrical/MOSS_Core_V07_Prototype.kicad_pcb (continued)

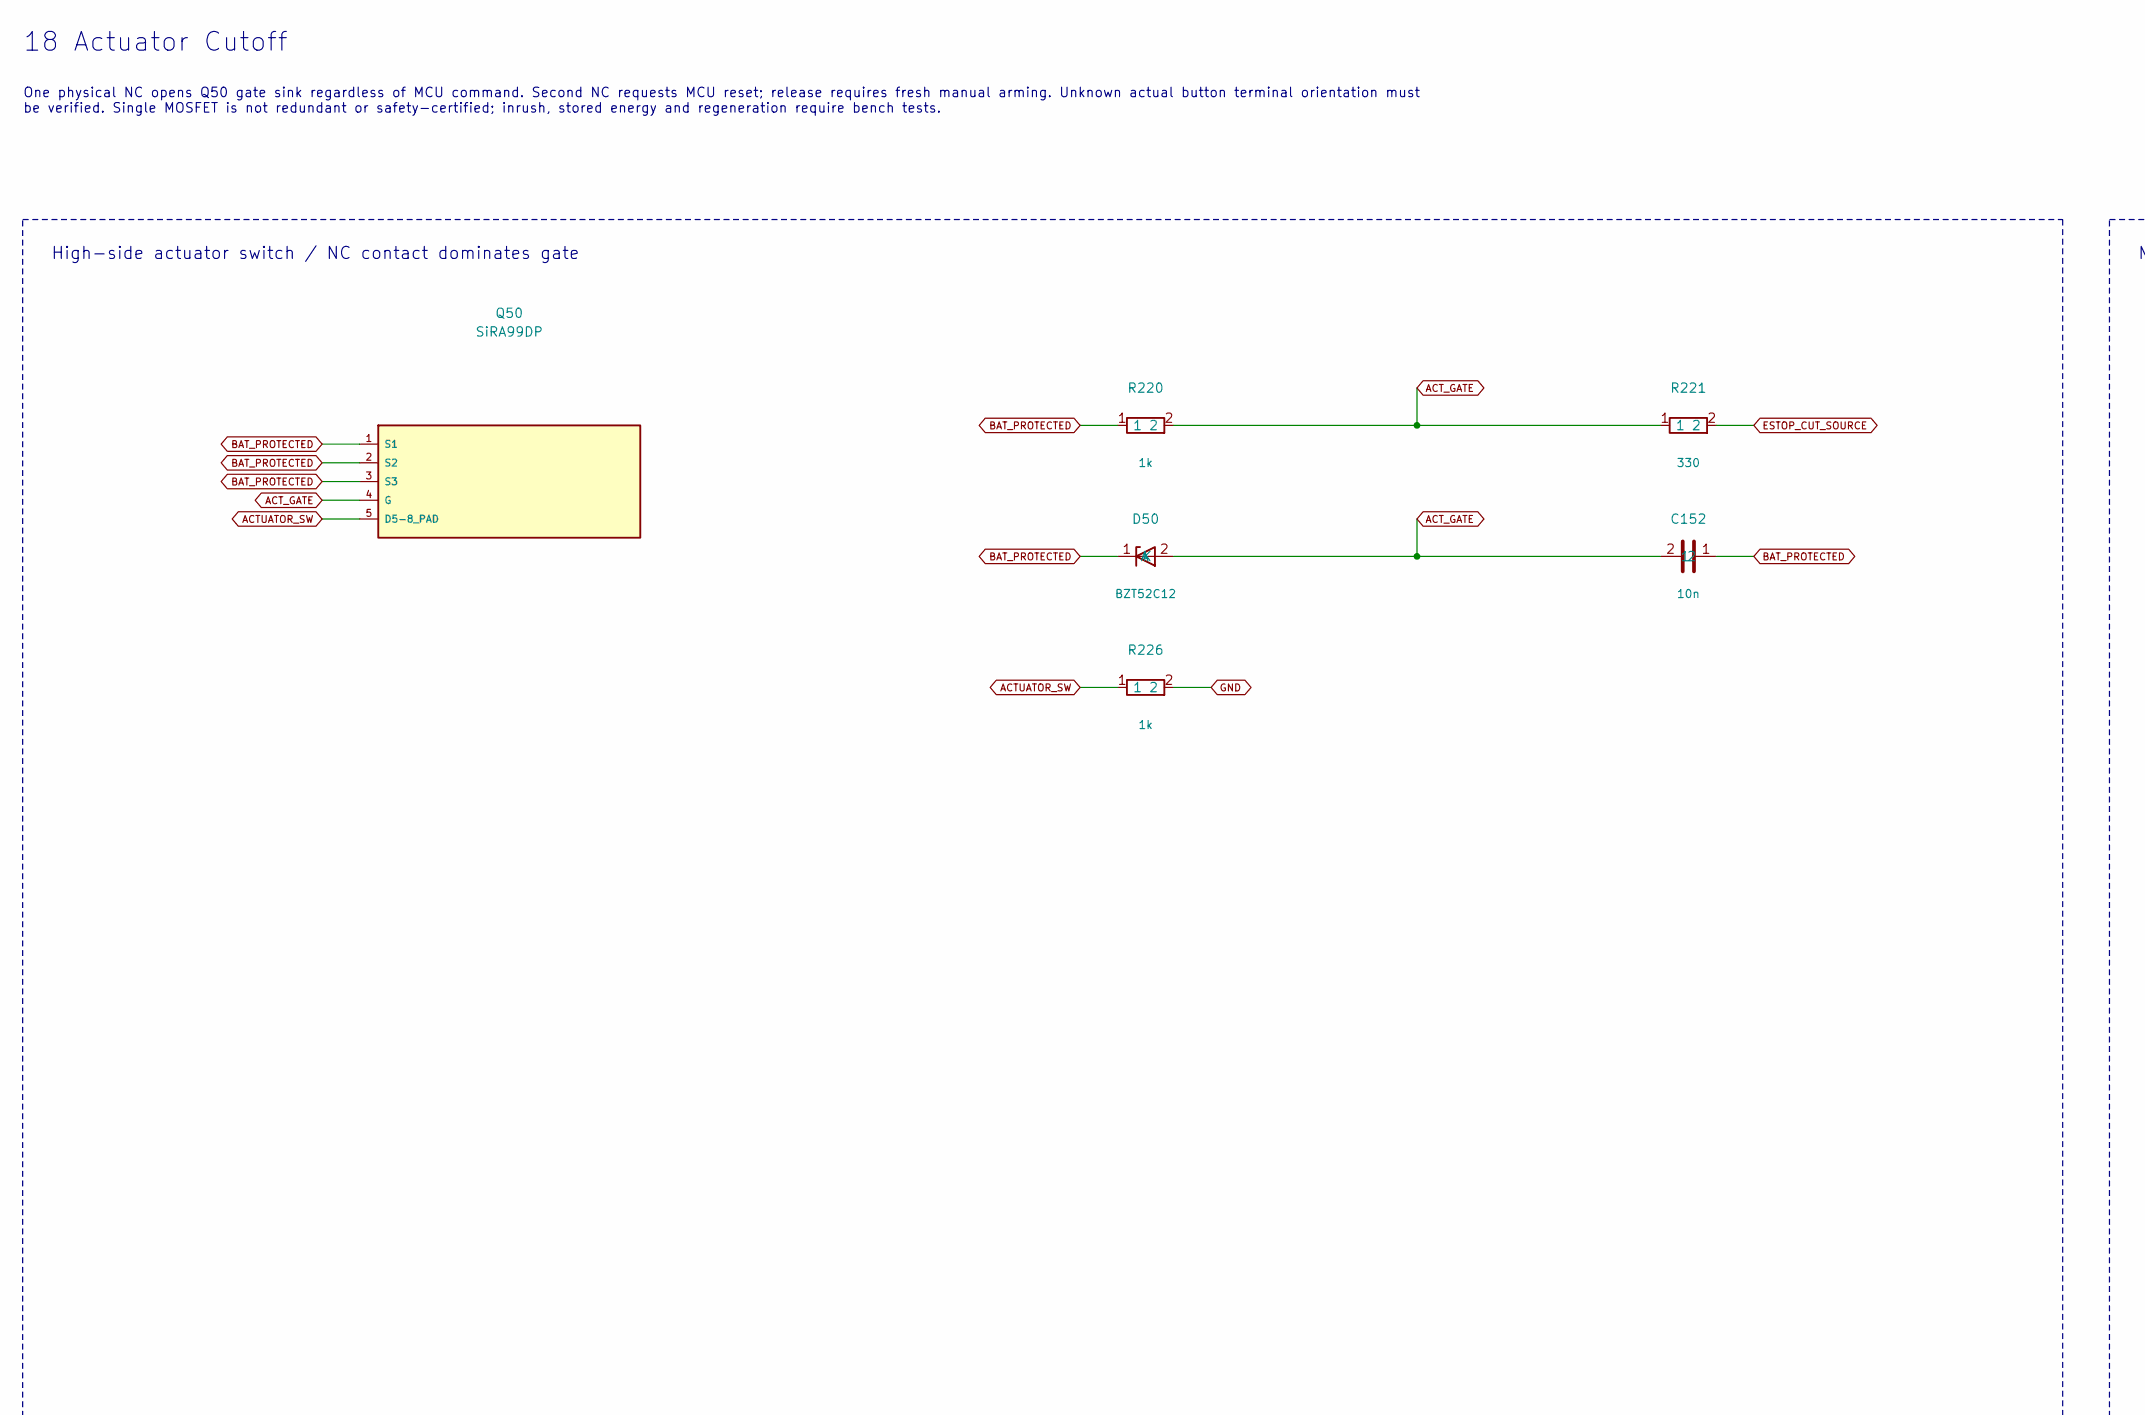
[picture p204: schematic 18_Actuator_Cutoff.kicad_sch, MOSS Core V0.7 DRAFT / 18 Actuator Cutoff, part in row 1, column 1]

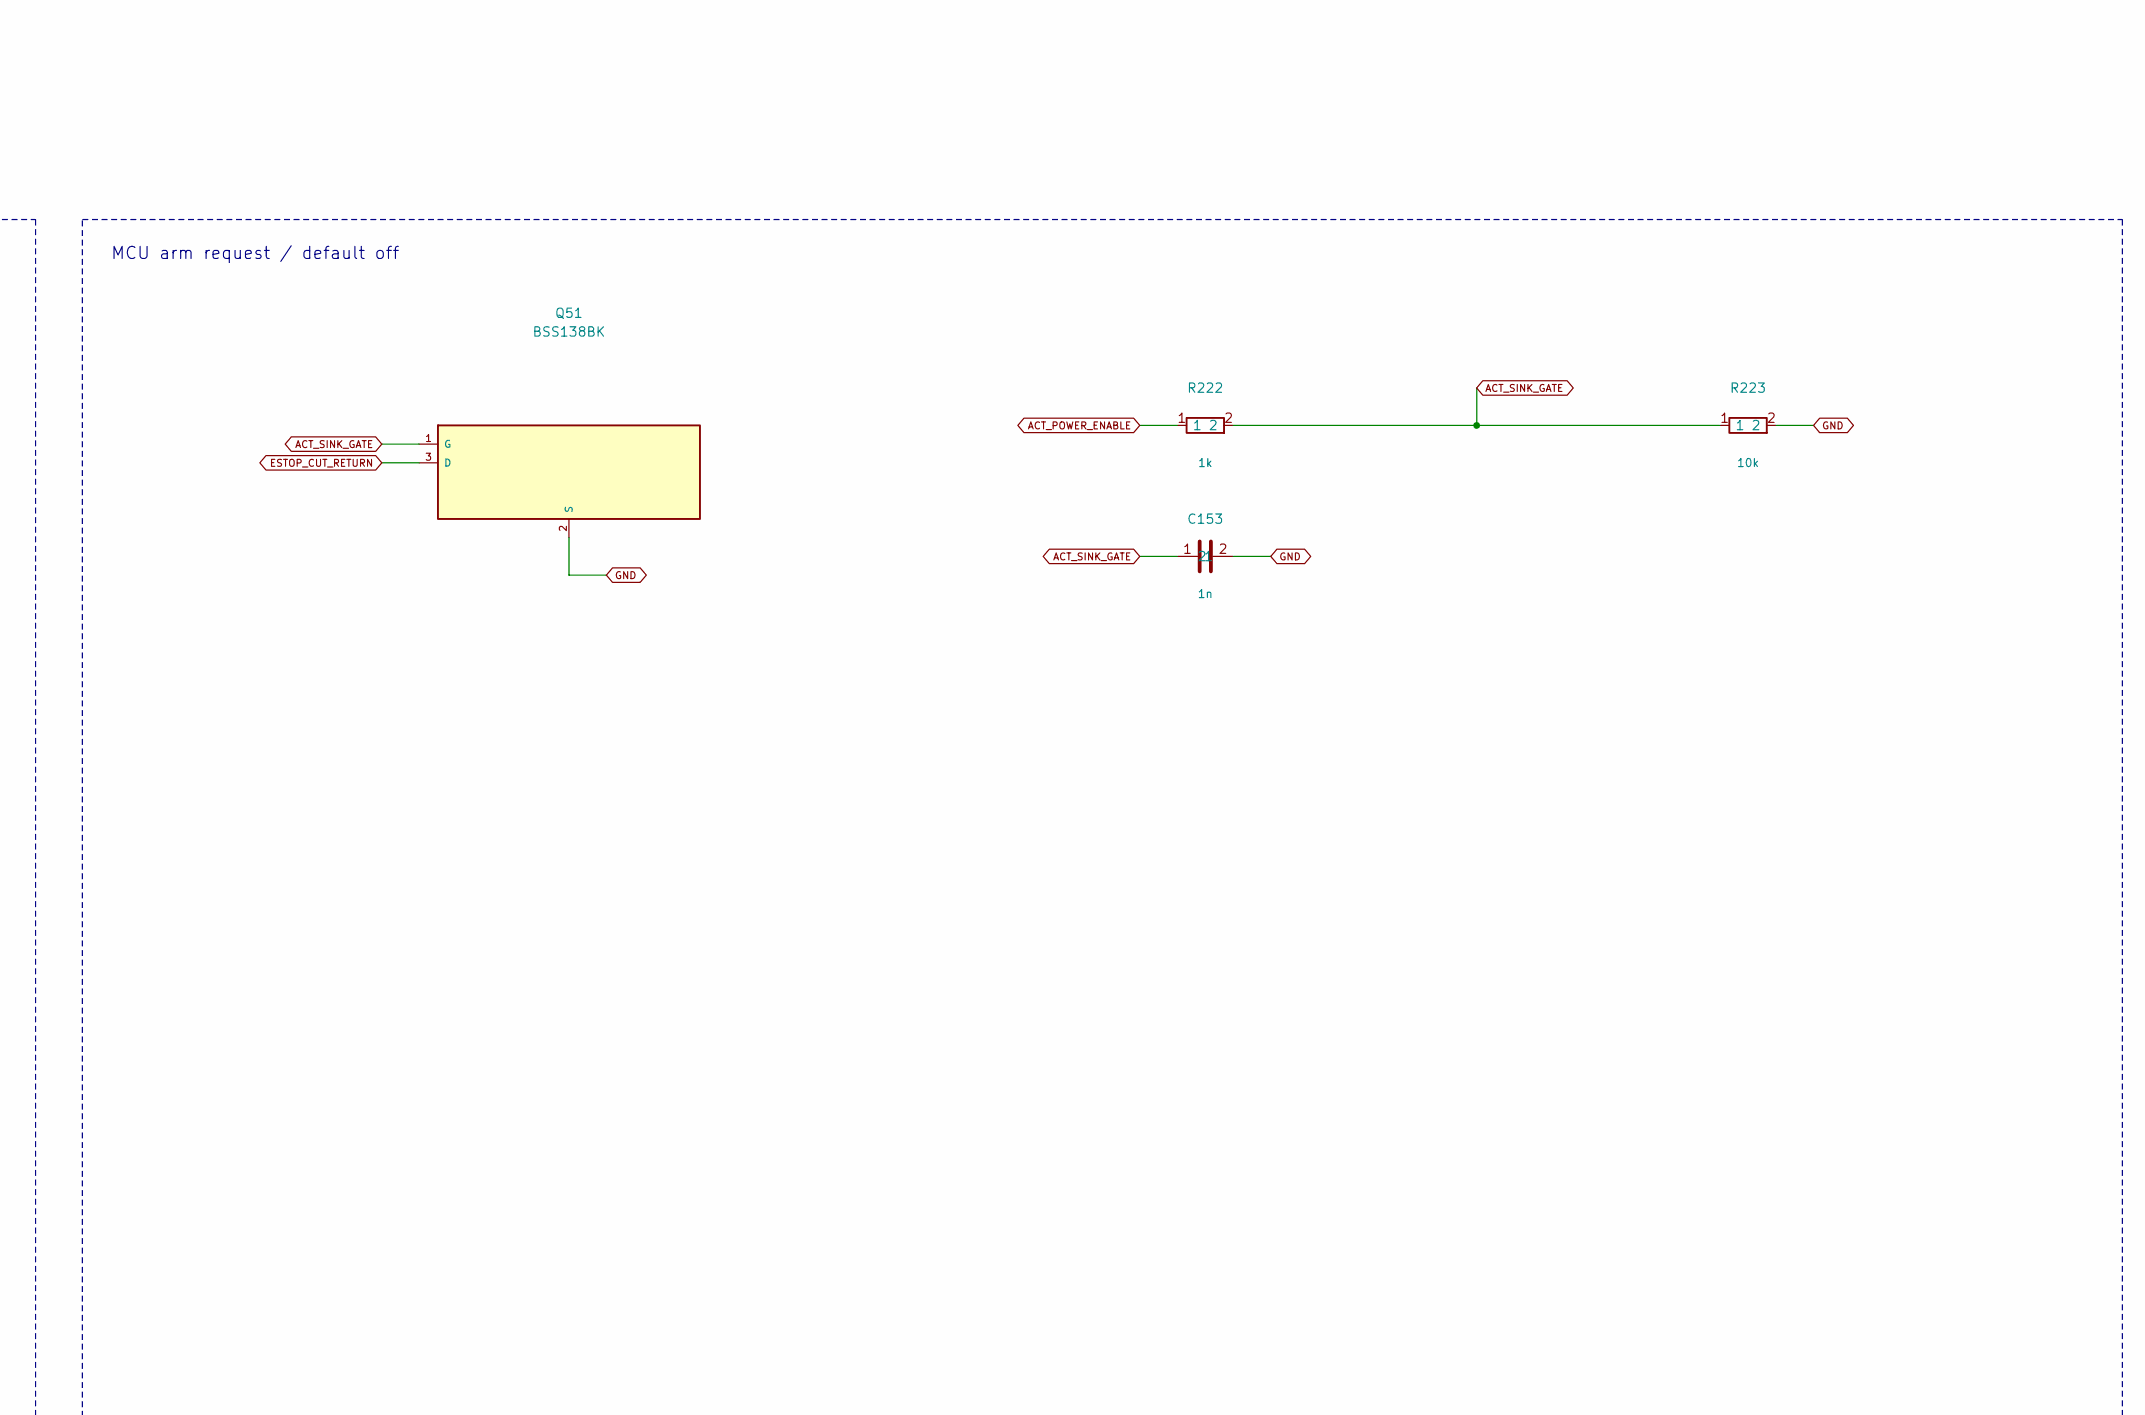
[picture p205: schematic 18_Actuator_Cutoff.kicad_sch, MOSS Core V0.7 DRAFT / 18 Actuator Cutoff, part in row 1, column 2]

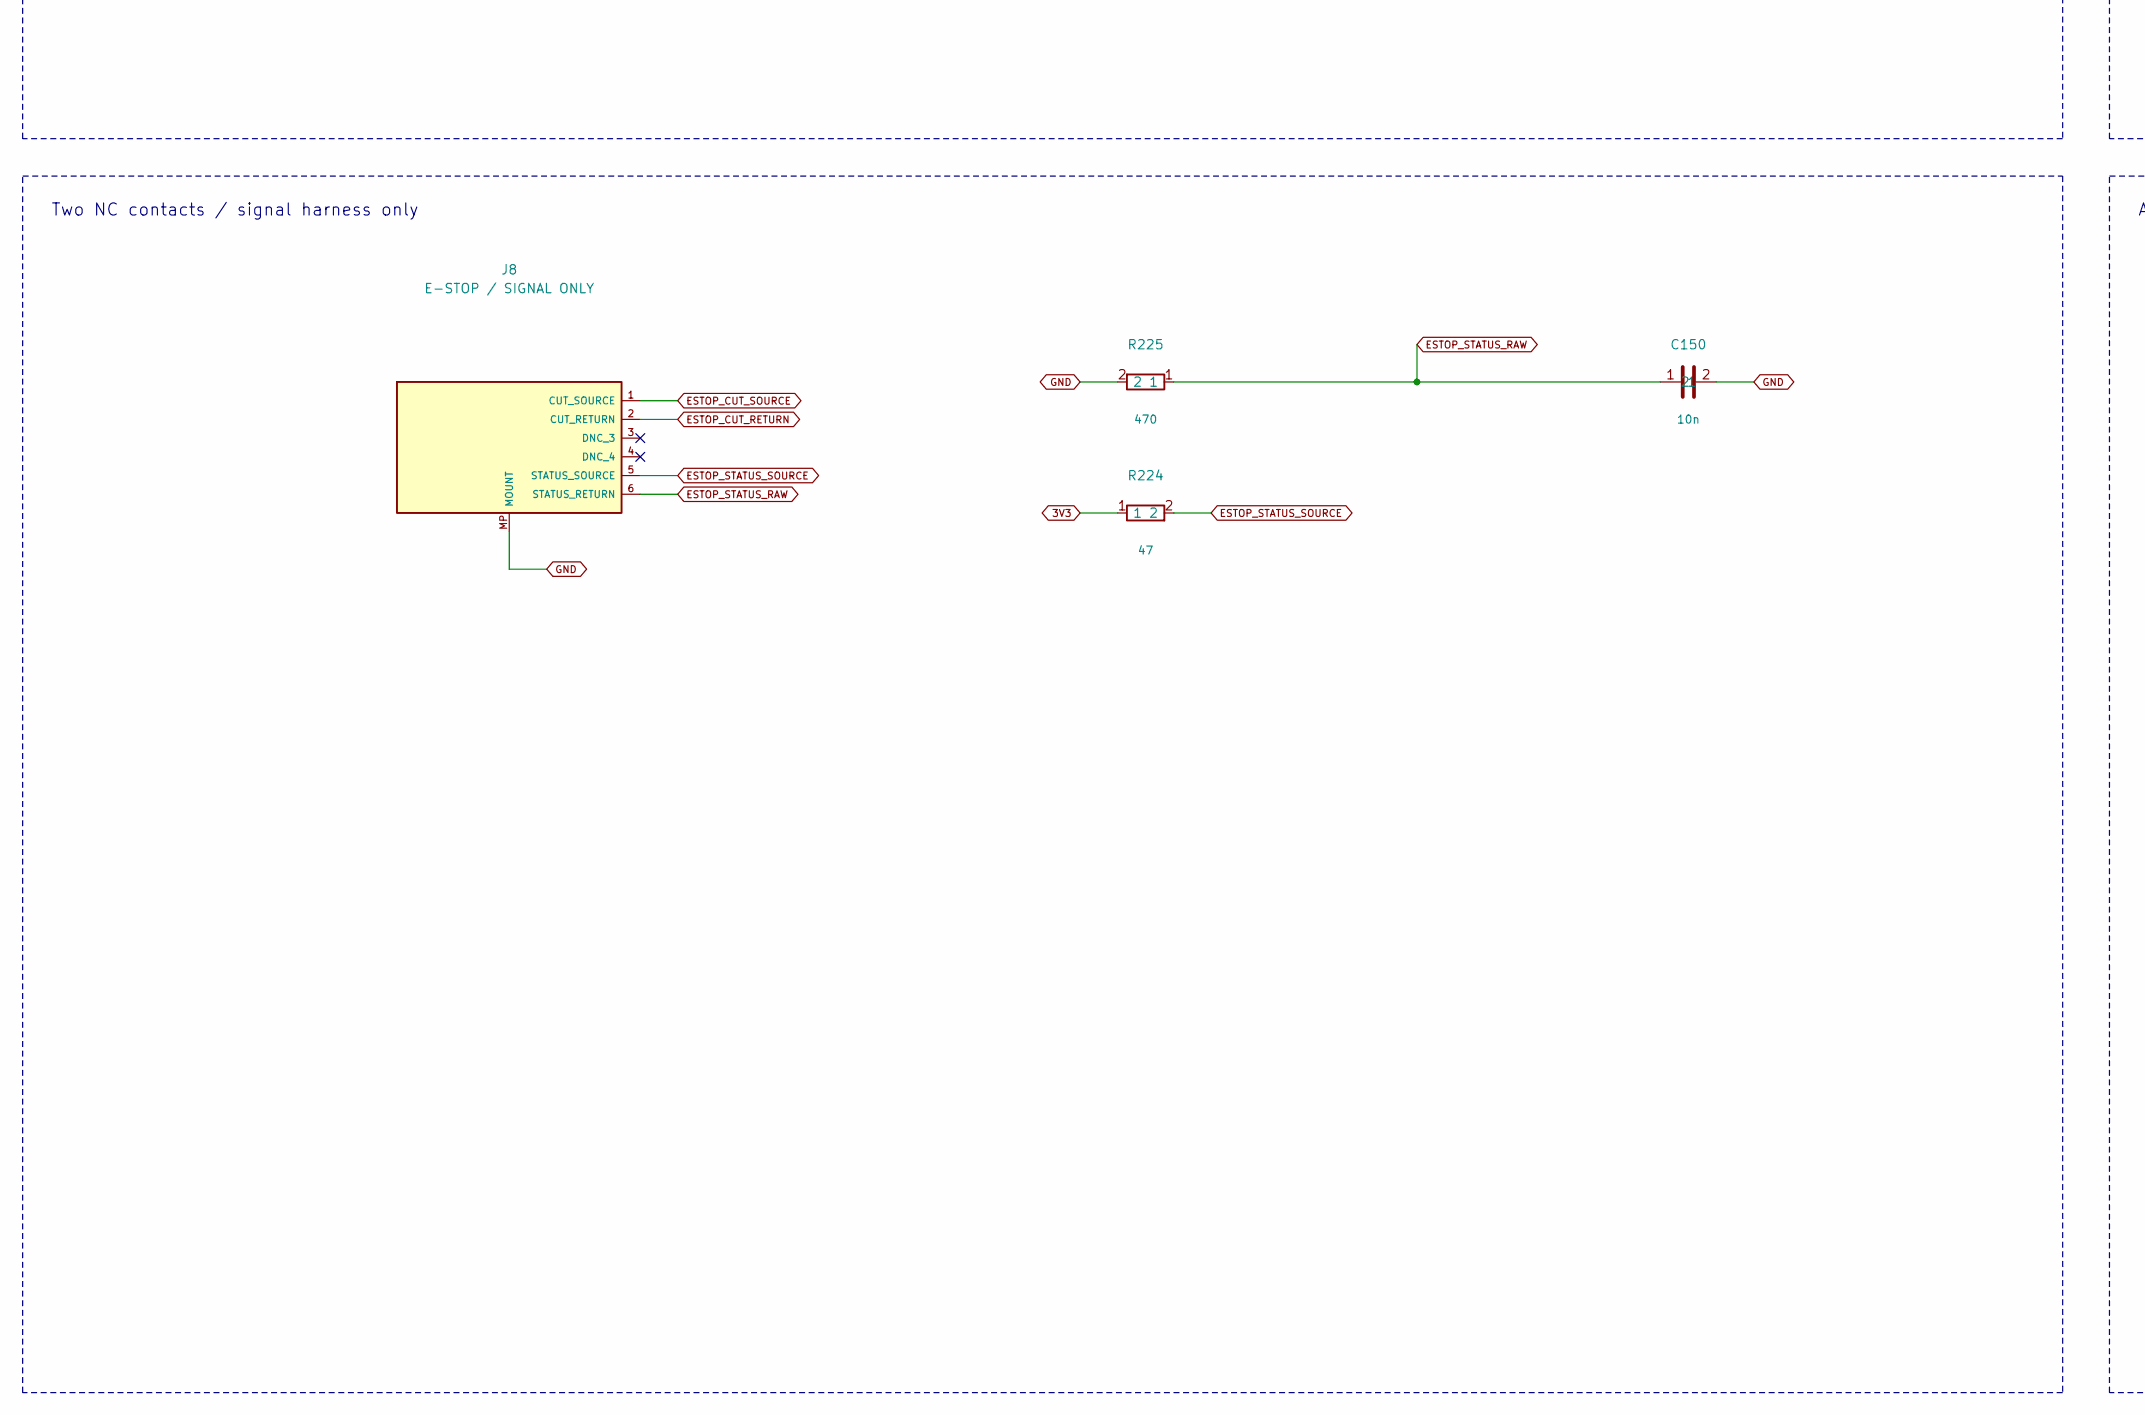
[picture p206: schematic 18_Actuator_Cutoff.kicad_sch, MOSS Core V0.7 DRAFT / 18 Actuator Cutoff, part in row 2, column 1]

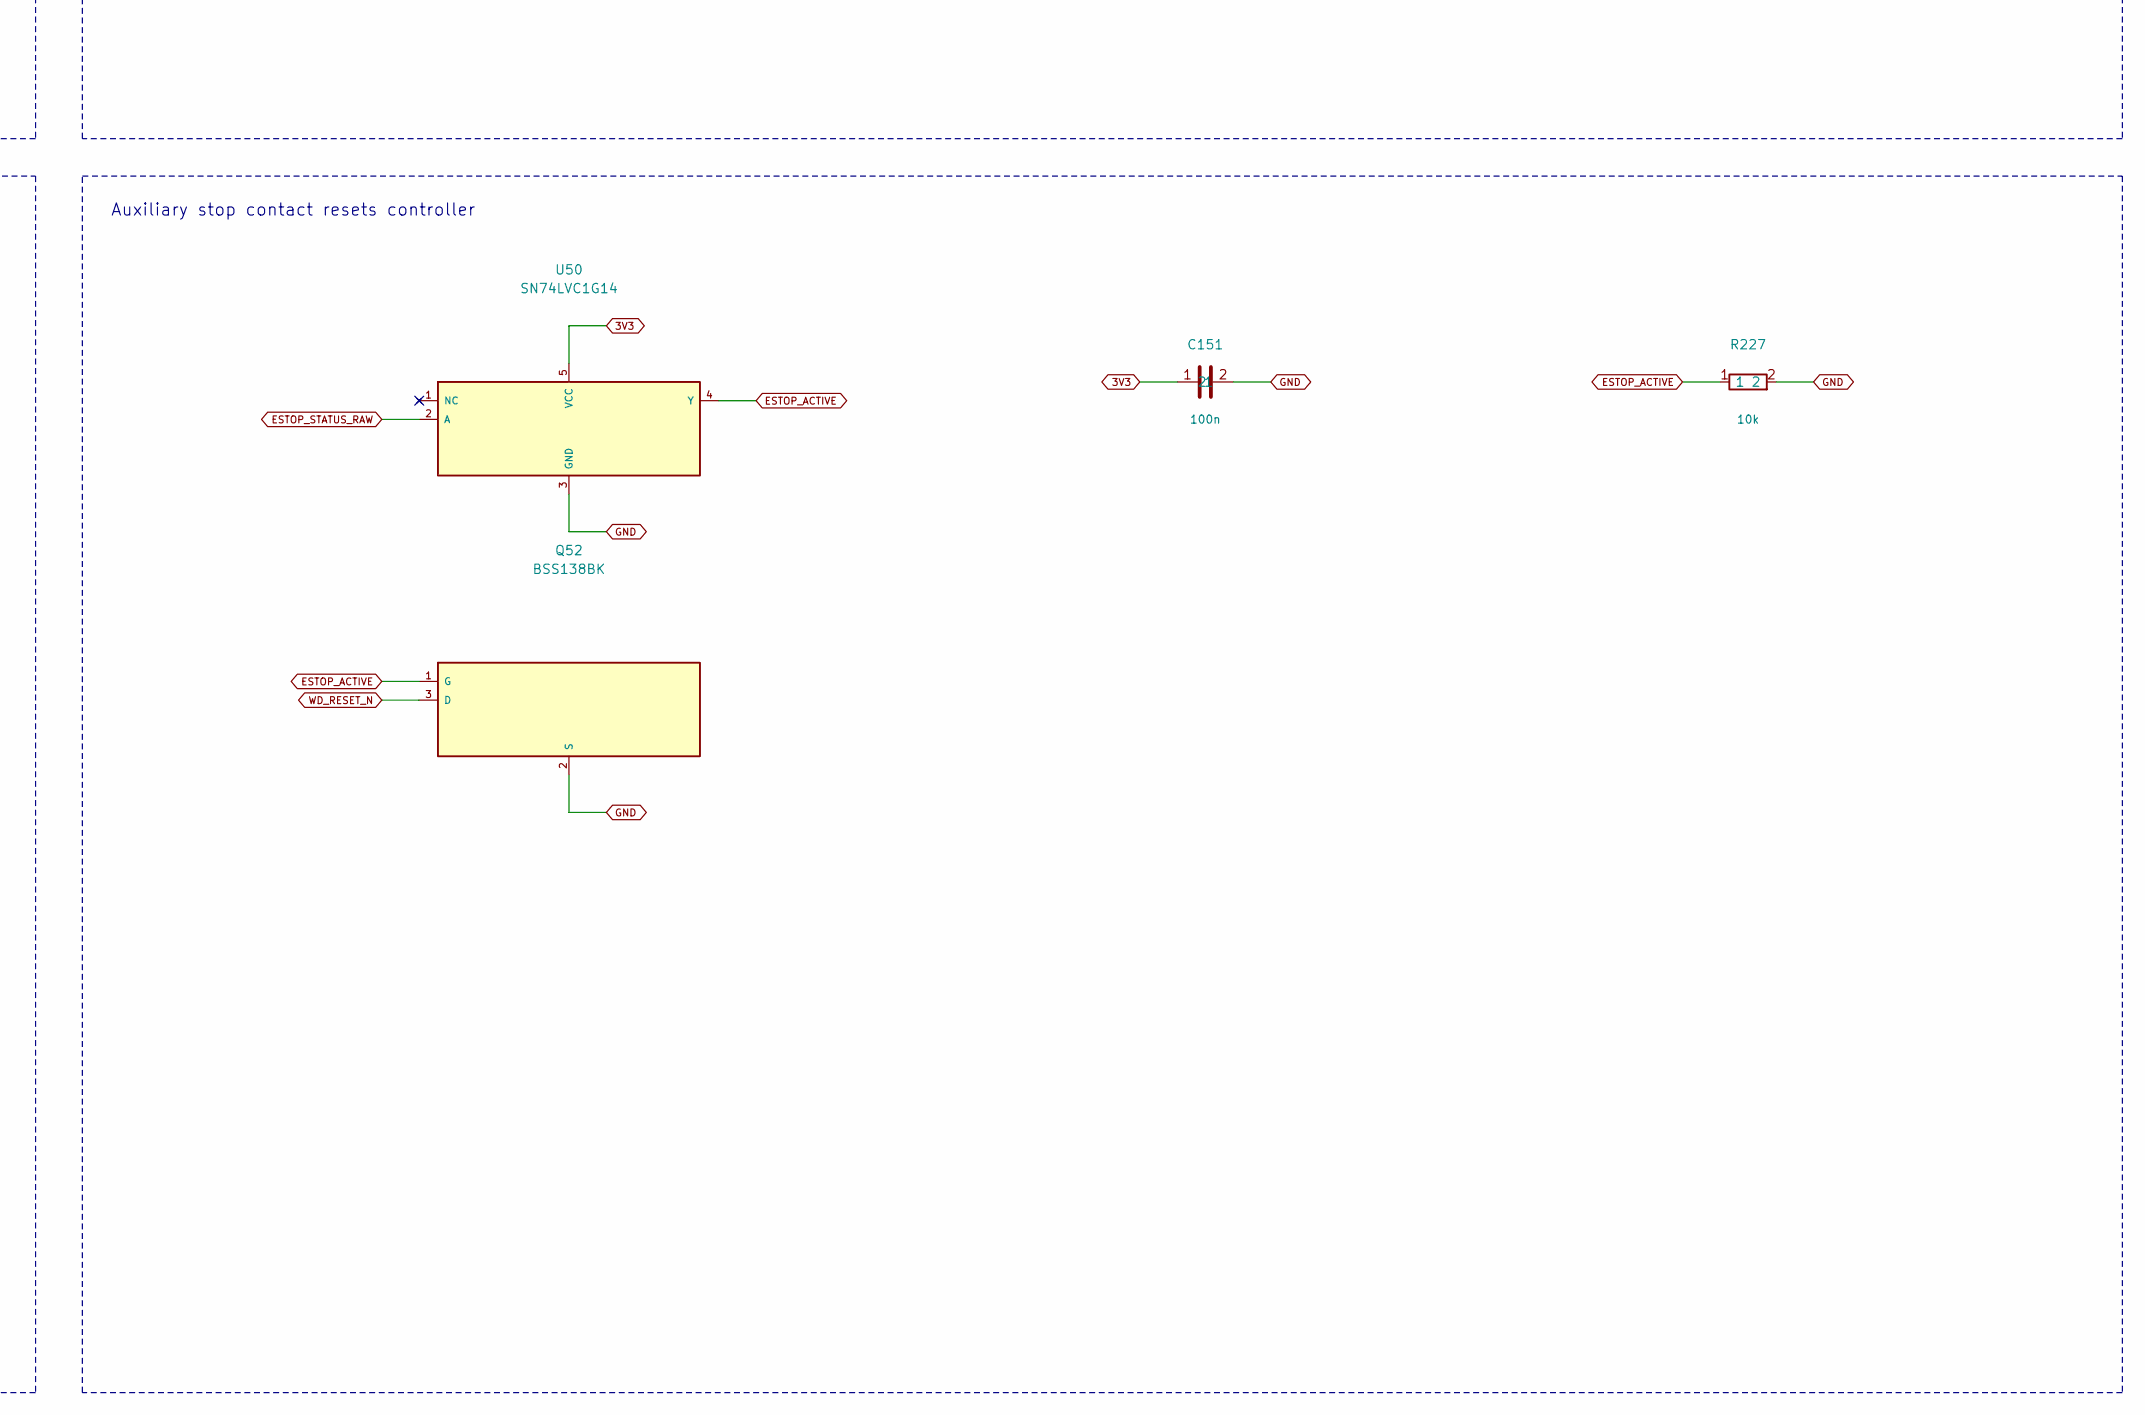
[picture p207: schematic 18_Actuator_Cutoff.kicad_sch, MOSS Core V0.7 DRAFT / 18 Actuator Cutoff, part in row 2, column 2]

Parts:
C150, C152: 10n; Capacitor_SMD_C_0603_1608Metric; MPN GRM188R71H103KA01D
C151: 100n; Capacitor_SMD_C_0603_1608Metric; MPN GRM188R71H104KA93D
C153: 1n; Capacitor_SMD_C_0603_1608Metric; MPN GRM188R71H102KA01D
D50: BZT52C12; Diode_SMD_D_SOD-123; MPN BZT52C12-E3-08
J8: E-STOP / SIGNAL ONLY; Connector_JST_JST_SH_BM06B-SRSS-TB_1x06-1MP_P1.00mm_Vertical; MPN BM06B-SRSS-TB(LF)(SN)
Q50: SiRA99DP; Package_SO_PowerPAK_SO-8_Single; MPN SiRA99DP-T1-GE3
Q51, Q52: BSS138BK; Package_TO_SOT_SMD_SOT-23; MPN BSS138BK,215
R220, R226: 1k; Resistor_SMD_R_1206_3216Metric; MPN RC1206FR-071KL
R221: 330; Resistor_SMD_R_1206_3216Metric; MPN RC1206FR-07330RL
R222: 1k; Resistor_SMD_R_0603_1608Metric; MPN RC0603FR-071KL
R223, R227: 10k; Resistor_SMD_R_0603_1608Metric; MPN RC0603FR-0710KL
R224: 47; Resistor_SMD_R_0603_1608Metric; MPN RC0603FR-0747RL
R225: 470; Resistor_SMD_R_0603_1608Metric; MPN RC0603FR-07470RL
U50: SN74LVC1G14; Package_TO_SOT_SMD_SOT-23-5; MPN SN74LVC1G14DBVR

Connections:
3V3: C151.1, R224.1, U50.5 (VCC); also elsewhere on the board
ACTUATOR_SW: Q50.5 (D5-8_PAD), R226.1; also elsewhere on the board
ACT_GATE: C152.2, D50.2 (A), Q50.4 (G), R220.2, R221.1
ACT_POWER_ENABLE: R222.1; also elsewhere on the board
ACT_SINK_GATE: C153.1, Q51.1 (G), R222.2, R223.1
BAT_PROTECTED: C152.1, D50.1 (K), Q50.1 (S1), Q50.2 (S2), Q50.3 (S3), R220.1; also elsewhere on the board
ESTOP_ACTIVE: Q52.1 (G), R227.1, U50.4 (Y); also elsewhere on the board
ESTOP_CUT_RETURN: J8.2 (CUT_RETURN), Q51.3 (D)
ESTOP_CUT_SOURCE: J8.1 (CUT_SOURCE), R221.2
ESTOP_STATUS_RAW: C150.1, J8.6 (STATUS_RETURN), R225.1, U50.2 (A)
ESTOP_STATUS_SOURCE: J8.5 (STATUS_SOURCE), R224.2
GND: C150.2, C151.2, C153.2, J8.MP (MOUNT), Q51.2 (S), Q52.2 (S), R223.2, R225.2, R226.2, R227.2, U50.3 (GND); also elsewhere on the board
WD_RESET_N: Q52.3 (D); also elsewhere on the board

Notes on the sheet:
18 Actuator Cutoff
One physical NC opens Q50 gate sink regardless of MCU command. Second NC requests MCU reset; release requires fresh manual arming. Unknown actual button terminal orientation must be verified. Single MOSFET is not redundant or safety-certified; inrush, stored energy and regeneration require bench te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
High-side actuator switch / NC contact dominates gate
MCU arm request / default off
Two NC contacts / signal harness only
Auxiliary stop contact resets controller

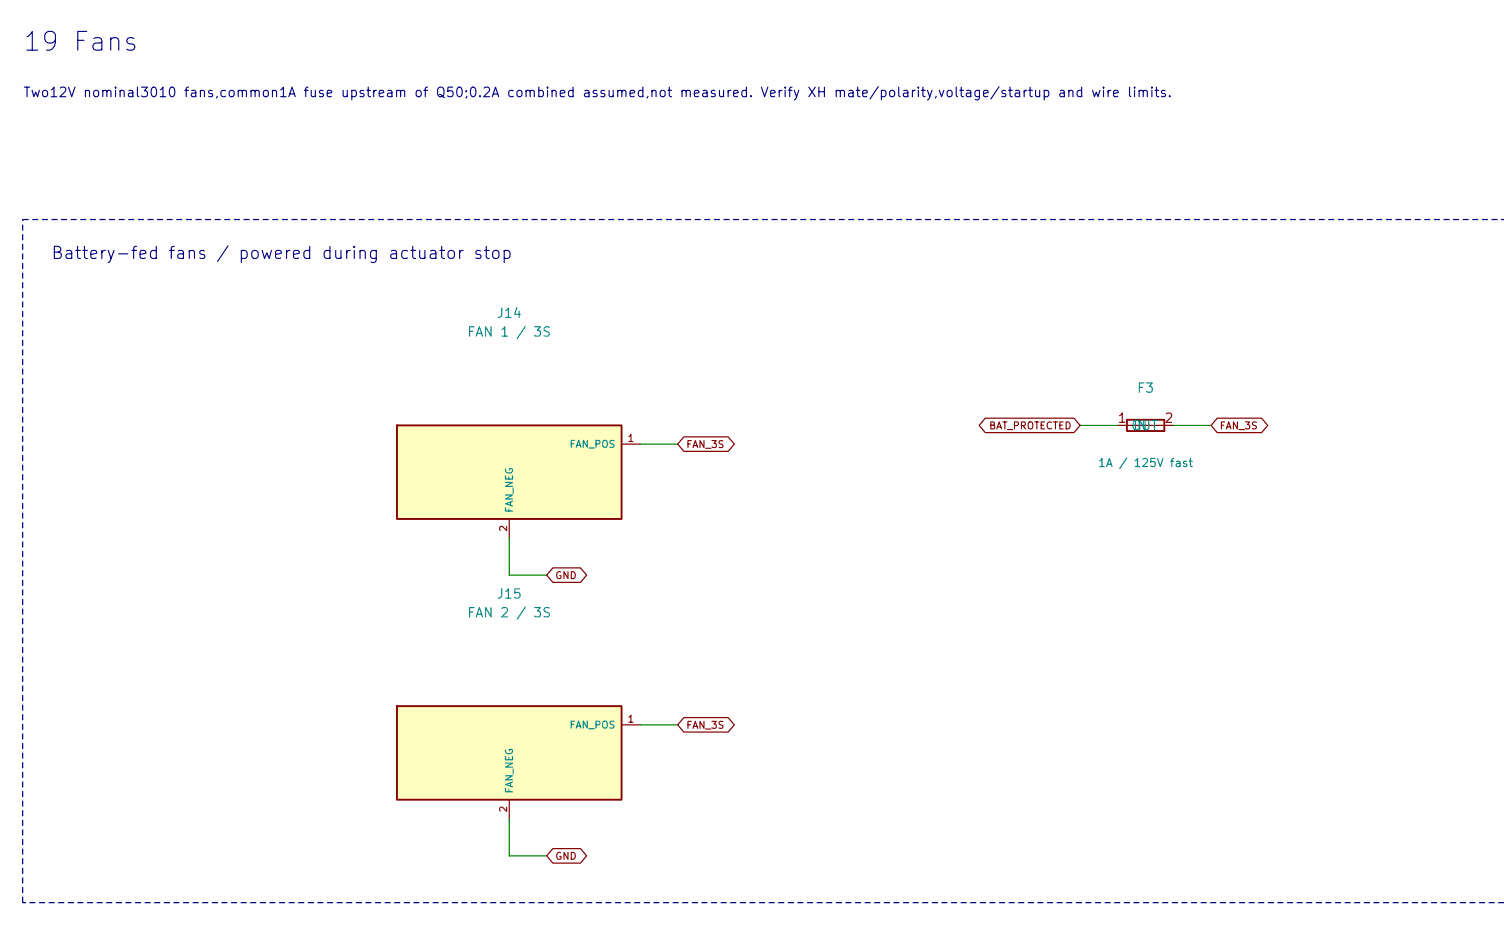
[picture p208: schematic 19_Fans.kicad_sch, MOSS Core V0.7 PROTOTYPE / 19 Fans, part in row 1, column 1]

Parts:
F3: 1A / 125V fast; Fuse_Littelfuse_0451_Nano2; MPN 0451001.MRL
J14: FAN 1 / 3S; Connector_JST_JST_XH_B2B-XH-A_1x02_P2.50mm_Vertical; MPN B2B-XH-A(LF)(SN)
J15: FAN 2 / 3S; Connector_JST_JST_XH_B2B-XH-A_1x02_P2.50mm_Vertical; MPN B2B-XH-A(LF)(SN)

Connections:
BAT_PROTECTED: F3.1 (IN); also elsewhere on the board
FAN_3S: F3.2 (OUT), J14.1 (FAN_POS), J15.1 (FAN_POS)
GND: J14.2 (FAN_NEG), J15.2 (FAN_NEG); also elsewhere on the board

Notes on the sheet:
19 Fans
Two12V nominal3010 fans,common1A fuse upstream of Q50;0.2A combined assumed,not measured. Verify XH mate/polarity,voltage/startup and wire limits.
Battery-fed fans / powered during actuator stop

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
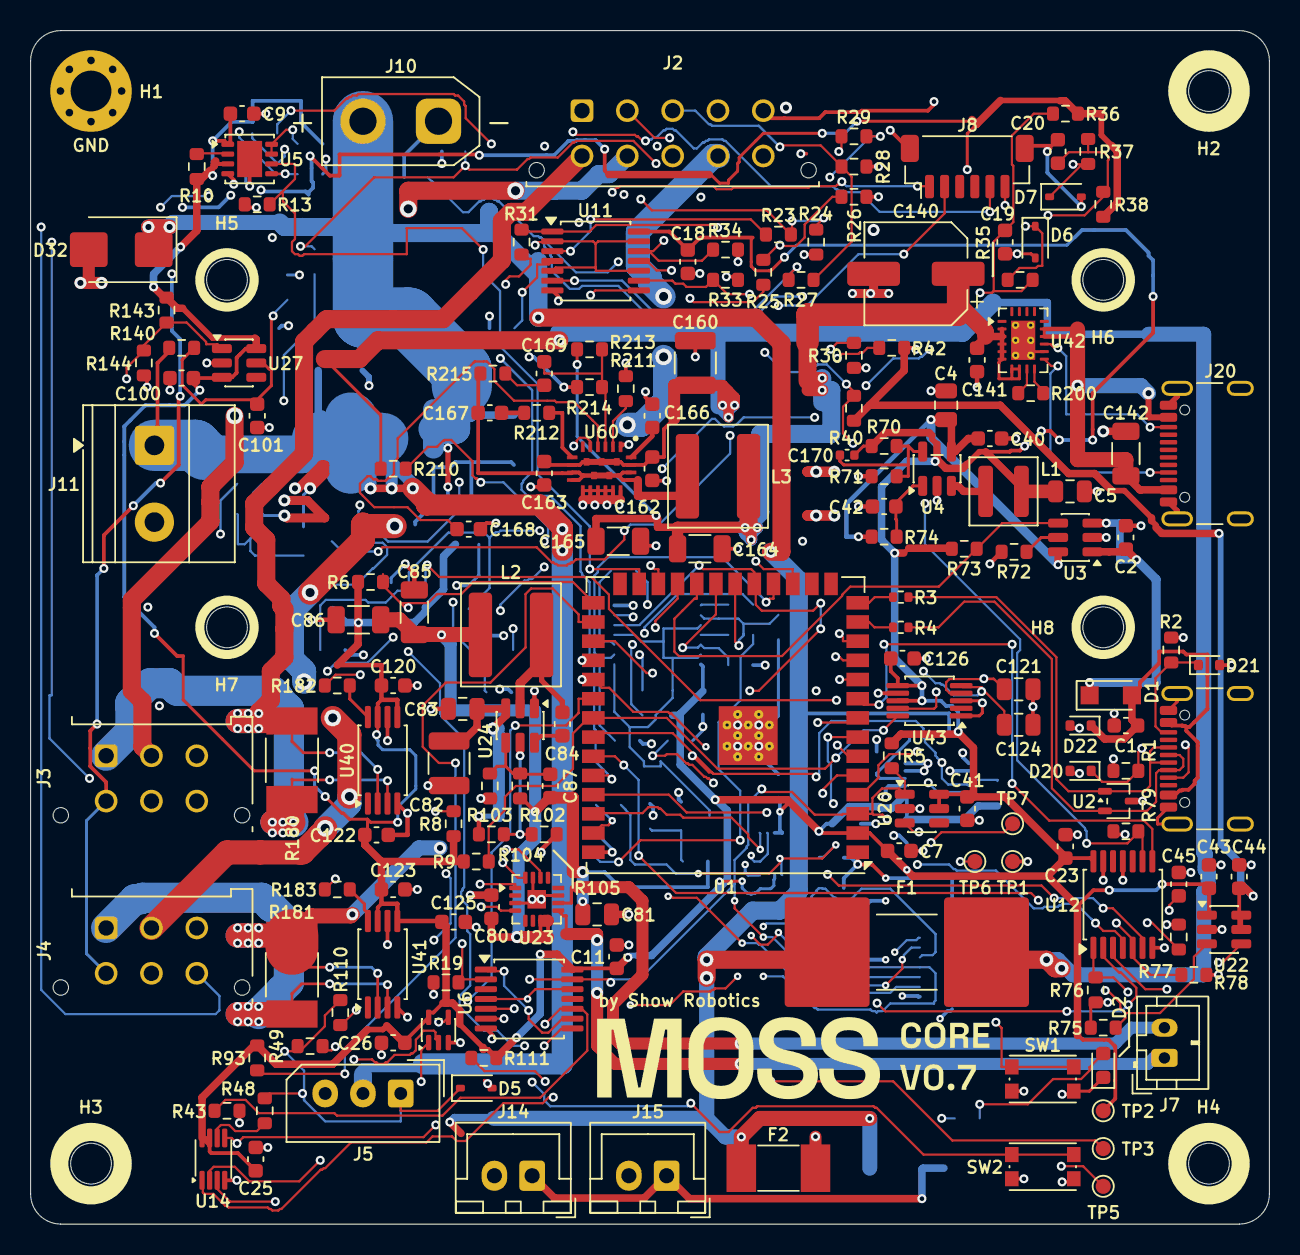
[picture p209: board MOSS_Core_V07_Prototype.kicad_pcb from above]

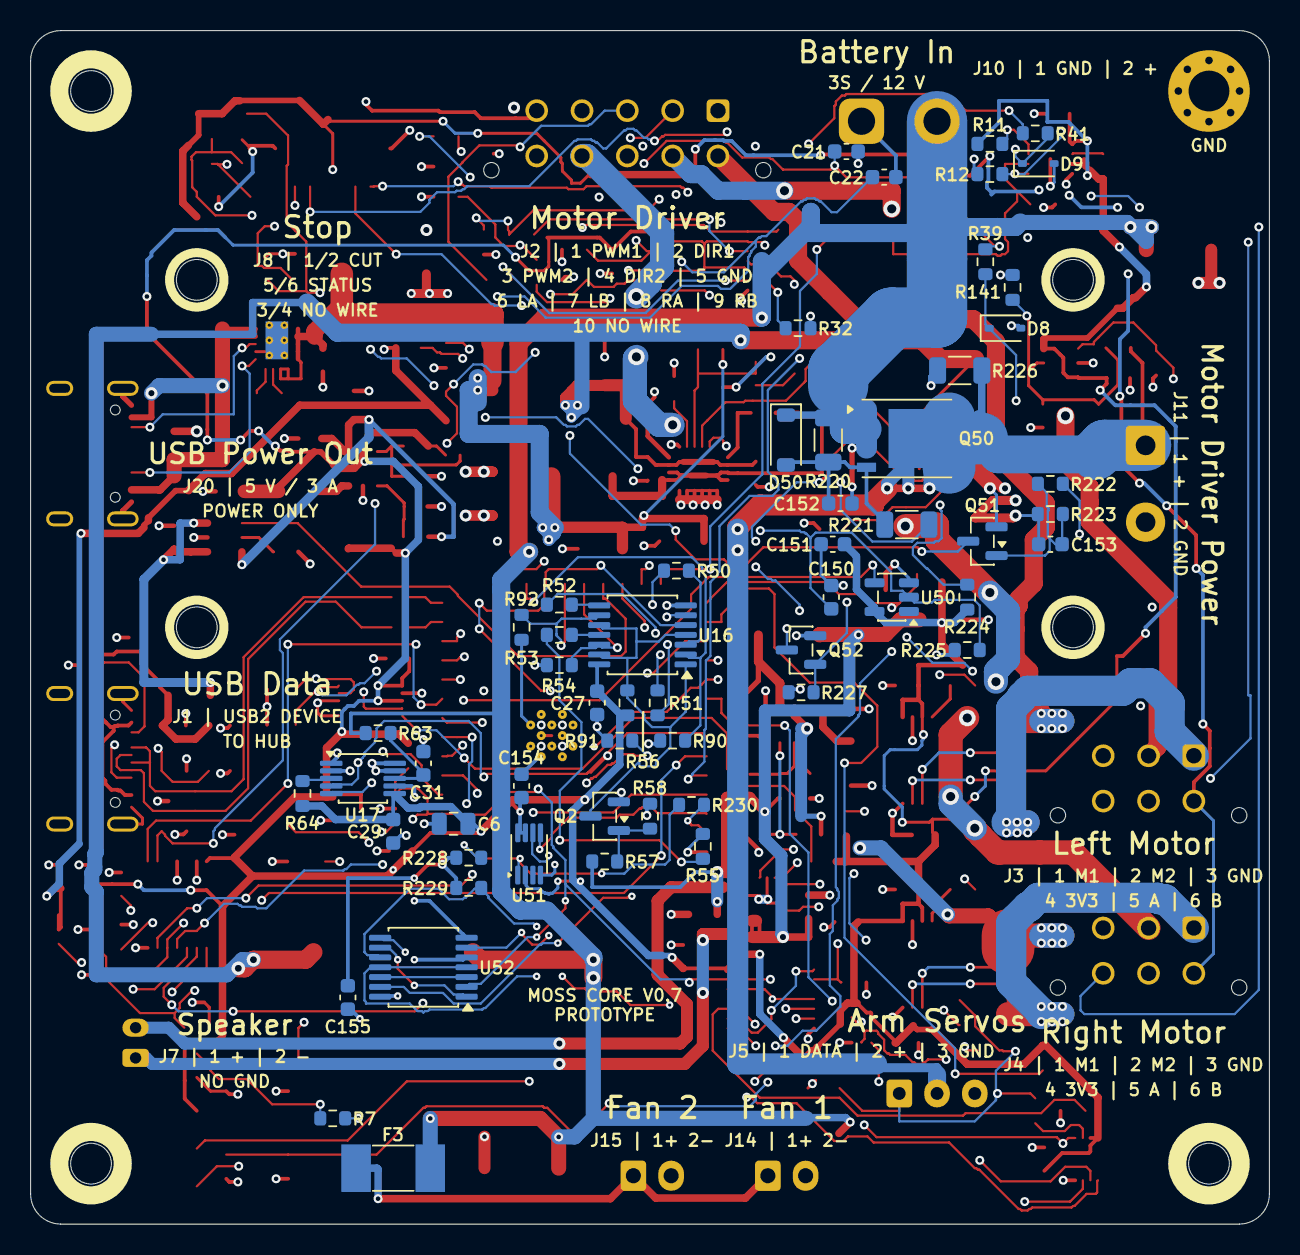
[picture p210: board MOSS_Core_V07_Prototype.kicad_pcb from below]

Board: 4 copper layers, 82.0 x 79.0 mm, 230 parts (57 on the bottom side), 133 nets.

Other parts of the board:
C154, C155: 100nF; Capacitor_SMD_C_0603_1608Metric
C170: 6.8pF C0G 50V; Capacitor_SMD_C_0402_1005Metric
R228: 10k; Resistor_SMD_R_0603_1608Metric
R229: 100k; Resistor_SMD_R_0603_1608Metric
R230: 100; Resistor_SMD_R_0603_1608Metric
U51: SN74LVC1G74DCUR; Package_SO_VSSOP-8_2.3x2mm_P0.5mm
U52: SN74HCS11PWR; Package_SO_TSSOP-14_4.4x5mm_P0.65mm

Their connections:
3V3: C154.1, C155.1, C170.1, U51.2, U51.7, U51.8, U52.5, U52.14; also elsewhere on the board
ACT_POWER_ENABLE: U52.4, U52.11; also elsewhere on the board
ARM_CLEAR_BASE: U52.3, U52.12
ARM_CLEAR_N: U51.6, U52.6
ARM_COMMIT: R230.1; also elsewhere on the board
ARM_COMMIT_CLK: R228.1, R230.2, U51.1
ARM_LATCHED: R229.1, U51.5, U52.10; also elsewhere on the board
BUCK_FB: C170.2; also elsewhere on the board
GND: C154.2, C155.2, R228.2, R229.2, U51.4, U52.7; also elsewhere on the board
RESET_N: U52.2; also elsewhere on the board
WD_ENABLE: U52.13; also elsewhere on the board
