metrox-eth/moss/(commit log)

2026-09-17 MOSS: build log, concept, BOM, data rules, media (concept V2.3.1 + build update 17/09), software scaffold derived from vector-dimos (gamepad teleop, differential-drive kinematics, cold tests)
2026-09-17 README: tracks loop recut on the right card; chassis loop added under status
2026-09-17 README: chassis card is a still in the concept video, use a JPG instead of a fake loop
2026-09-17 README: exploded-view turntable (CAD, 18/09) at the top; pickup loop moved under status; tracks loop to docs/concept
2026-09-18 build log 2026-09-18: chassis printed, first fit on the bench, drivetrain and tensioners printing; BOM and status updated; video + frames
2026-09-18 teleop rewritten for MOSS: pure logic (two axes, no lateral input), validated kinematics, deadman brake window; tests reproduce the review findings; remove the internal pre-push script from the tree;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
2026-09-18 README: drop the V2.3 chassis still (outdated design); label the concept video as an earlier design
2026-09-18 BOM: two outer side rails, splash-proof vent covers (designed)
2026-09-18 BOM: splash-proof vent covers printed
2026-09-18 roadmap/hardware: V0.1 is the bench prototype; corrections go into the CAD and V0.3 is the published design with files and fasteners
2026-09-18 concept/roadmap: compute cartridge is modular; MOSS Lite = Raspberry Pi in the cartridge, teleop-only
2026-09-19 V0.3: printed-parts inventory (111 pieces, md + json), build log 2026-09-19, README status dated 19/09, BOM by assembly, assembly feedback log, roadmap/hardware harmonized on V0.3 (documentation only)
2026-09-19 build log: bench video and stills of the V0.3 print set (19 September)
    Claude-Session: https://claude.ai/code/session_01A21Fhi6GK9VDrqfkpQfMXZ
2026-09-19 V0.3: power and control harness bench-tested, ESP32-S3 commissioning firmware, BOM and build log updated (20 September)
    - firmware/: ESP32-S3-DevKitC-1 commissioning firmware as flashed (25 % limit), host logic test, wiring map
    - hardware/bench/20260920/: raw traces (motor ramp; INA219 file explicitly not a motor-current measurement)
    - docs: build log entry, BOM electronics (ESP32-S3 + Bus Servo Adapter, General Driver removed, INA219 voltage only, 5 A provisional fuse), software notes, roadmap, assembly feedback
    - media: bench video and photos of the harness
    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
    [ina_bypassed_NOT_motor_current.json, motor_ramp_100pct.json]
2026-09-19 README rewritten for the reader; print set complete (113 parts), hardware in; order and delivery status removed from the docs
    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
2026-09-19 README: panorama of the full print set on the bench (stitched from the 19 September pan)
    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
2026-09-20 build log: electronics in the chassis, Jetson on battery (20 September, evening)
    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
2026-09-20 README: photo of the day, electronics in the chassis
    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
2026-09-20 build log: harness and first-assembly photos inline
    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
2026-09-20 Sponsor button (GitHub Sponsors)
    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
2026-09-21 docs: itemize prototype and experimental Pi build budgets
    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
2026-09-22 build log: first drive (22 September), track tension feedback
    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
2026-09-22 media: tracks on, bin on, drivetrain CAD view (22 September)
    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
2026-09-22 build log: caption for the track mechanism CAD view
    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
2026-09-23 docs: track V0.4 hull, ordered control electronics and CAD tour
    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
2026-09-24 build log: measured mass, model mass and camera position, stated as what they are
    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
2026-09-24 build log: arm and gripper budget stated once (632 g + 50 g = 682 g), not twice
    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
2026-09-24 moss_pi: drive MOSS from a Raspberry Pi 5 through the ESP32-S3 firmware, no dimOS
    serial_bridge.py speaks the firmware line protocol (status, arm, stop, zero,
    drive -25..+25), parses JSON telemetry, reopens a lost port with a stop first
    and sends stop after 300 ms without a drive command. teleop.py (keyboard or
    gamepad) reuses moss_dimos/teleop_logic.py: arm step, deadman, brake window,
    then stop. telemetry_log.py appends telemetry to JSONL with a wall-clock time.
    Cold tests only: a fake serial port replaying the 20 September bench
    telemetry, a fake clock, and one pyserial test on a Linux pty.
    Claude-Session: https://claude.ai/code/se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
2026-09-26 build log: 26 September, arm and gripper on the V0.3, tracks to flip, issue #2
2026-09-26 build log: two photos of the V0.3 with arm and gripper, 26 September
2026-09-26 build log: arm and gripper weighed, 768 g
2026-09-26 build log: 4.27 kg is a sum, not a weighing
2026-09-26 build log: prototype arm servos are salvaged ST3235, parts list stays ST3215
2026-09-27 BOM: where to buy
2026-09-29 firmware V0.4: QT Py ESP32-S3 + MDD3A variant (same protocol, configurable ramp, native USB), host test; not yet run on hardware
2026-10-02 README: waitlist for the kit and the open source CAD
2026-10-03 Rewrite the repository for the reader: README as the door, BOM, 3D printing, assembly, software, story, lessons
    One page per builder task. The daily log, the version pages and the agent notes are gone; the videos and gifs leave the tree. 11,500 words of docs become 3,800; 98 MB becomes 6 MB.
    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
2026-10-03 README: OpenAI among friends, simulation and autonomy as work in progress; gripper named for what it is
    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
2026-10-03 BOM: the Jetson boots from a microSD card, no SSD in the budget
    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
2026-10-03 Lessons: only what changes what a builder does; our own printing mistakes stay out
    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
2026-10-03 3D printing: the split hull for 256 mm beds follows the release
    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
2026-10-03 Pages: drop every line without a source in our files (material rationales, bearing and tension advice, judgments)
    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
2026-10-03 Assembly: the kit laid out, from the V0.5 film, instead of the stitched phone pan
    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
2026-10-03 Assembly: the harness in Laurent's words
    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
2026-10-03 BOM: third configuration, Pi 5 + Mighty camera, no accelerator; wrist camera priced in every configuration
    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
2026-10-03 BOM: wrist camera is the Vinmooog USB webcam from the VLA-REPLICA bill of materials
    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
2026-10-03 BOM: wrist camera is the innomaker 32 x 32 mm module
    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
2026-10-03 BOM: list prices, not what we paid
    Jetson Orin Nano Super Developer Kit 399 (NVIDIA, July 2026), Pi 5 8 GB 175, AI HAT+ 2 200, RealSense D455 419, RPLIDAR C1 69.
    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
2026-10-03 BOM: base assembly, not kit; totals rounded to $50
    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
2026-10-03 3D printing: the 18 plates, all 107 parts, on one sheet
    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
2026-10-03 3D printing: plates sheet, cleaner version
    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
2026-10-03 README and Software: dimOS is the software layer; two cameras and a lidar, said plainly
    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
2026-10-03 BOM: one list per configuration
    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
2026-10-03 BOM: motor family
    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
2026-10-03 BOM, README: no claim on kit price
    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
2026-10-03 BOM: motor spec, Pi power converter, filament brands
    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
2026-10-03 BOM: fasteners, the full list
    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
2026-10-04 BOM: battery, switch, fuses, XT30 as bought; power block 68
    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
2026-10-04 BOM: six XT30 pairs, one switch with cover, one fuse and holder
    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
2026-10-04 BOM: battery is 3S2P
    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
2026-10-05 firmware V0.4 on hardware: telemetry was dropped by the CDC FIFO guard (fixed, v2); bench scripts (flash, motor test, servo scan and watch)
    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
    [MOSS_QTPY_MDD3A.ino]
2026-10-10 firmware v3: INVERT_LEFT (first drive 10/10: left track backwards), encoder ticks follow the inversion
    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
2026-10-10 firmware: MDD10A variant (PWM + DIR on the same four pins, -DMOSS_DRIVER_MDD10A), driver name in banner and telemetry; MDD3A build unchanged
    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
2026-10-10 Changelog: first drive at the gamepad (10 October), firmware v3, teleop through dimOS, drive-line verdict, CAD R19 / R12 in progress; Software and firmware pages follow
    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
2026-10-26 Arm observation poses and wrist camera intrinsics
    tools/moss_arm_observe.py: the arm to its observation poses and back, straight on the bus,
    one move per run, small nudges of one joint, the torque never cut outside the drive pose.
    config/arm_observe_poses.json: look_down (gripper vertical, camera on top) and look_floor
    (camera facing the floor), set by eye on the robot, checked in the CAD scene.
    tools/moss_wrist_calib.py: ChArUco capture and intrinsics for the wrist camera; the raw
    stream is upside down and is turned before anything looks at it; a frame is kept only when
    the board moved. config/wrist_camera_intrinsics.yaml: 25 views, 0.45 px.
2026-10-26 Wrist camera pose on the gripper (eye-in-hand)
    tools/moss_wrist_handeye.py: ten poses around the recognition pose, the board taped on the
    floor; servos and board pose recorded at each stop; Tsai-Lenz then a consensus refinement
    (OpenCV 5 has no calibrateHandEye); the check is that every view puts the board on the same
    floor point. First result: 10 views, spread 5.6 mm. moss_dimos/arm_kin.py and
    config/arm_chain.json: the pure numpy kinematics of the arm, extracted from the CAD scene.
2026-10-26 Arm: hand-taught reach marks, roll guard on every played pose, travel with the camera on top
2026-10-26 Arm observe: --back stops at drive
2026-10-26 Pick zone drawn in the wrist camera image: hand-taught marks, CAD hull, detector with in/out of zone
2026-10-26 Pick zone measured on the tape laid on the floor, cast onto the floor plane through the calibrated wrist camera
2026-10-26 Pick zone on the tape's middle: darker threshold, jaw shadows masked, hull pulled in by half the tape width
2026-10-26 Arm observe: frank synchronised goals with the servos' own profile instead of 50 Hz streaming; stop and hold on overload
2026-10-26 Arm motion: one frank goal per move with the servos' own profile (moss_dimos/arm_motion.py), used by the observe, hand-eye and direct players; stop and hold on overload; arm preflight (registers + on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
2026-10-26 arm preflight: read each servo's position loop (P, D, I, registers 21-23) and dead band (26-27) with the rest; what a goal a few ticks away does under load depends on these
2026-10-27 Arm: a joint with two servos (the shoulder's twin, back to back): declared in the calibration file, the goal mirrored about the middle in the same sync-write packet, same speed, acceleration and torq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
2026-10-27 Publish SO-101 dual-servo shoulder R2 CAD and assembly guide
2026-10-27 Publish SO-101 dual-servo shoulder R2 CAD and assembly guide (#10)
2026-10-27 Unify dual-shoulder CAD assembly and controller setup guide (#11)
2026-10-28 docs: add illustrated custom 3S4P battery tutorial (#14)
2026-10-28 simulation: does the shoulder want a second servo (issue #2) (#9)
    * simulation: does the shoulder want a second servo (issue #2): the holding load at every pose MOSS uses, the pick-and-drop cycle under dynamics, two STS3215 on one shaft (same goal vs follower), a spring instead, tipping
    With MOSS's own 20 g can the litter barely counts: the shoulder's weak moment is holding the arm's own weight at the pick (0.89x its continuous rating at pick_low). Two servos given the same goal share poorly or fight (14 % share at zero offset; 2.9x at a 4-tick offset); a follower in PWM mode copying Present_Load shares 50/50 (0.22x each); a gravity-balance spring brings the pick to 0.08x. Simulation eviden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
2026-10-28 docs: correct custom battery materials and add workshop measurements (#15)
2026-10-30 Unify MOSS CORE V0.7 prototype design and review package
2026-10-30 Verify harness interfaces and prepare CAD-based prototype RFQ
2026-10-31 Update MOSS Core V0.7 prototype files for 31 October
2026-10-31 Simplify MOSS Core motor harness connections
2026-11-01 Update MOSS Core V0.7 layout and vertical connector assembly
2026-11-01 Align Core mounting holes with enlarged board and refine assembly markings
2026-11-01 License current MOSS hardware designs under CC BY-NC-SA 4.0
2026-11-01 Update V0.7 hull mounting and consolidated wiring harness
2026-11-01 Add PCBWay to project friends
2026-11-01 Add Core rearm latch and commissioning firmware
    Add hardware permission latching after actuator-rail loss, the TLV62569 feedforward capacitor, and targeted signal-corner corrections. Preserve the board outline, mounting pattern and harness interfaces.
    Include matched fabrication outputs, flat renders and scoped verification evidence. Add a separate ESP32-S3 commissioning target with native USB, motor/encoder control, current sensing, Feetech SyncWrite and I2S diagnostics. Target build and host checks pass; no physical board or firmware flash is claimed.
2026-11-01 Document assembly mask review and classified BOM
2026-11-05 Record MOSS Core V0.8 notes for follow-up after prototype tests
2026-11-07 Clarify HEX12 drive hub installation and axle flats
2026-11-07 Clarify original motor kit hub and set screw contents
2026-11-09 Update custom battery guide for ChangFa 3S balancing BMS
2026-11-09 Clarify 5 A rear charging path and 15 A rover main-switch requirements
2026-11-09 Update MOSS hulls, charging connection, main switch and build files
2026-11-09 Clarify the complete motor variant required for the MOSS build
2026-11-09 Keep current build instructions free of update announcements
2026-11-13 docs: illustrate electronics mounting with current MDD10A assembly
